0x63616c/smart-blinds/hw/routing/blind-main/README.md

# Historical 196-part main-controller routing

This directory is the **historical 196-part routing checkpoint**, not the current
54 × 80 mm controller. Its source, geometry, manifests and validation results
belong together at [commit ea7bab1566812b4611e3c1e800e67b5ede44651c](https://github.com/0x63616c/smart-blinds/tree/ea7bab1566812b4611e3c1e800e67b5ede44651c).
That commit contains the exact source capture SHA
`2ef8c8d6168420d0de25bb6a4c4b3d778d73c1fd55e97ca068adafe70fbeadd7`
recorded in `route-record.json`. Reproduce its checks from that revision through
the isolated Linux runner. Do not point those checks at the newer 206-part
capture or present the historical findings as current-board validation.

This was a partial four-layer routing study, not a manufacturing release.
The derivative retains the 54 × 68.5 mm outline with its USB tab, all 196
footprints, 609 physical pin identities, 139 net partitions, 17 mechanical/thermal
anchors and 13 RF, connector-foot and clamp reservations.

The checkpoint contains 1013 segments and 255 vias. It routes the local charger
switching/bypass network, motor-driver fly/pump/VM and output paths, regulator
bypass/output/sense paths, and a 3.3 V feed to the radio module. In1 remains a
continuous filled ground-return island; no signal traces use that layer. The
module power feed uses In2 beneath the permitted module body, with vias outside
its solder lands and unchanged antenna keepouts.

Actual KiCad 10 DRC reports **122 unconnected items**. No short, copper/edge/hole
clearance, track-width, courtyard-overlap, keepout, mask-bridge or dangling-route
failure is accepted. The report retains 258 silkscreen/text findings, four
library-footprint differences and five footprint-type findings. The latter
include mixed through-hole/thermal features and incorrectly classified library
attributes; they require footprint/assembly review, not a blanket waiver.
Three unrelated default-disabled DRC categories are listed in `checks.json`.

`checks.py` independently checks actual pad shapes, masks/paste settings, net
partitions, layer/rotation/placement, outline, keepouts, courtyard bounds and
encoder-wire height clearance. It also follows physical copper shapes through
70 required connection groups, including the ground fill. A matching net name
alone cannot pass. Twenty-six earlier injected faults are rejected: moved USB connector, changed motor pad,
weakened RF reservation, cut module supply, removed return plane, cut charger
bypass return, cut PD bypass, cut USB input, removed quiet return via, and an
extra connection from the quiet return to the input-capacitor return, plus open
PD enable, UV divider, raw discharge and address-ground branches. The new controls
also cut the charger input, PMID and SYS bulk branches and input-capacitor return,
and place a same-net solder land over an ordinary open via. All 38 new distribution
vias preserve at least 0.20 mm from their drill edges to top solder lands; native
same-net clearance alone does not check this assembly condition. Both REGN and VBUS bypass
returns have two nearby ground vias, as required by the charger layout guide.
The checks remove the plane from the local graph before counting those vias. The generator is deterministic across repeated local runs.

The USB addition connects both VBUS contacts to the eFuse and its output
reservoir, with local input capacitance and a shunt TVS. It also connects the PD
supply diode and three separate bypass branches, and both CC/protection/dead-battery paths. The two MCU data resistors
have short local stubs; the completed data paths are described below. The eFuse's
current-setting, slew and divider-endpoint components return through an isolated
same-face branch to one ground via. An independent plane-free copper check
requires exactly those five quiet-ground pads and that one via; it rejects the
input-capacitor return joining this branch even though the net names agree.

The PNP enable stage, both voltage dividers, raw/output discharge chains and
PD address/reset/bus resistor branches are now connected. Their explicit
coordinates are replayed from `usb-control-routes.json`; reproduction performs
no route search. Five separate local ground vias serve the address and factory
bus resistors without joining the eFuse quiet-ground branch.

Factory access pads remain open; the USB data pair now reaches the module.
The completed control connections do not establish negotiated startup or
detach/discharge timing; the PD configuration and electrical tests remain
required. The 0.3 mm central-pad escapes and 0.8 mm back-layer power trunks
need current/temperature review; the present geometry is not a current rating.
The input TVS's specified pulse clamp can exceed downstream DC limits; placement
does not resolve that separate transient qualification issue. The eFuse layout
uses a quiet return, but loop impedance and coupling still need review.

The eFuse output now reaches the charger VBUS pins and input capacitors. The four
PMID and five SYS bulk capacitors connect to their existing local fast-bypass
branches through explicit two-via fanouts and In2 distribution traces. Input and
bulk-capacitor grounds join the uninterrupted In1 return. The replay coordinates
in `charger-power-banks.json` and `distribution.py` require no routing search.
The previous 581 copper items are retained. Fifteen previously unwired parts move
to make room, including the encoder supply block; all mechanical anchors remain.
These distributed reservoirs still need ripple-current, return-loop and thermal
review. The 0.6–0.8 mm In2 traces use 15.2 µm copper, so geometric clearance is not
a demonstrated continuous-current rating. Pack feed and onward SYS distribution
remain open.

The next extension connects both VAC inputs, BATP feedback, TS and ILIM networks,
PROG and their local returns. Six previously unwired control parts move; no
mechanical anchor changes. Its explicit paths in `charger-control-routes.json`
are replayed by `charger_controls.py`. A bootstrap via moves 0.25 mm to provide
two adjacent sensing escapes; its two incident traces follow it. The other 696
previous copper items are retained exactly. Seventeen control-area vias
(sixteen added and that relocated via) pass the same 0.20 mm drill-to-solder-land
margin, including same-net lands. Five new deliberate opens and a same-net
control-via intrusion are rejected. These connections need switch-noise,
feedback accuracy, thermal and transient review; full charger control, bus and
charge-permission wiring remain unfinished.

A subsequent assembly-clearance pass moves twelve ordinary vias by at most
0.35 mm and adjusts their sixteen incident traces. Five short top-layer stubs
preserve connections that previously relied on via copper touching a solder
land. No component moves. That earlier stage checked 178 routed vias. The clamp, USB and local supervision stages extend this to all 255 via drills, which remain at least 0.20 mm
from every top solder land, including lands on the same net; the ordinary
KiCad same-net clearance check alone does not ensure this. A deliberate
same-net intrusion at the USB input capacitor is rejected. The explicit
`via-land-clearance.json` changes replay through `via_lands.py`; this is not a
filled/capped via-in-pad process. Thermal holes inside library footprints still
require their separate solder/paste and assembly-process review.

The regenerative clamp now connects its eight-resistor bank, two series power
MOSFETs, detector/divider/feedback, local supply and bypasses, thermostat and latch.
Its 19 local multi-pad nets and eight load-path groups are checked using physical
copper, including every duplicate pad. Three separate plane-free return checks
keep the load, quiet detector and LDO bypass returns distinct before their plane
entries. Eight additional injected faults reject opens and an incorrect shared
return. All 34 old/new fault controls pass. The external `thermal_ok` and `G`
connections to the main inhibit and fault indication remain open.

`regen.py` consumes the preceding pipeline stage and replays finite geometry from
`regen-routes.json`; it does not embed a completed baseline or run a route search.
It replaces twelve exact low-current segments and one redundant NTC via, retains
all other incoming copper, and adds 249 items. Twenty-five previously unwired
clamp components move relative to the preceding published checkpoint. The eight
resistor and all mechanical anchors stay fixed. A now-obsolete NTC via is
explicitly required absent; the other sixteen control-area vias remain checked.

The selected 38.199 mm × 1.2 mm back-layer feed replaces an evaluated
48.804 mm × 0.8 mm detour. Nominal 35 µm-copper estimates at 20 °C are 15.68 mΩ
versus 30.05 mΩ, excluding vias, temperature and process variation. The actual
filled In1 plane contains a complete 1.2 mm swept-width, 39.802 mm return witness;
this is checked by polygon subtraction. It is not an ampacity or current-distribution
result. In1 is only 15.2 µm thick, and the eight 2 W resistor labels do not establish
16 W continuous capability for this compact assembly.

The shorter power loop requires three reviewed signal changes: PROG grows from
17.771 to 28.509 mm on B.Cu; NTC grows from 5.768 to 12.980 mm on B/F; the SW1 bootstrap
return shrinks from 8.087 to 4.175 mm. `regen_analog.py` reports their actual copper
neighbors and proves an intervening filled In1 shield at the NTC's projected
crossings with the B.Cu feed. The closest NTC segment remains only 0.205 mm from
the motor bulk PACK solder land; PROG remains a long startup-sampled branch.
These are explicit noise/layout qualification limits. A bounded 0.2 mm-grid search
for a closer one-part PROG relocation found no accepted closer position while
other parts/copper were fixed; it does not rule out a wider repack.

Comparator overshoot, FET SOA, pulse repetition, thermostat-to-resistor coupling,
printed-case/battery temperature and real motor regeneration remain untested.
An opened thermal cutoff cannot absorb sustained manual back-drive.

The complete placement change list is in `checks.json`. Many support components
have moved from the first placement to make local electrical loops possible.
The critical-loop review remains incomplete: especially charger bootstrap
routing, current/return geometry, switch-node coupling and module supply
impedance. The external 100 nF and bulk radio capacitors are about 18 mm from
the module supply pin; the wide internal feed is a layout candidate, not
proof of adequate local decoupling. Geometric clearance does not establish
electrical performance.

The USB data extension connects both reversible contact pairs through the moved
TPD2E2U06 and the existing module-side 22 Ω resistors. The ESD package moves to
local (22.8, 1.7), 180°; only its three old ground branches/two vias and three CC1
segments are replaced. `usb_data.py` consumes the current clamp output and
replays `usb-data-routes.json`. The base placement remains in `placement.json`;
that data file contains the explicit final ESD override. All other incoming
copper and the circuit graph remain unchanged, including after filling/saving.

Both long front traces have continuous direct In1 reference. A local In2 ground
zone references the short back crossover. The saved fill is checked for overlap
with each signal via, and missing reference is accepted only within D-minus's
own necessary via openings, with the project's 5 µm polygon-arc tolerance plus
0.5 µm audit tolerance. A prior saved merge had stale filled polygons; the
maintained stage now rebuilds and persists them. The neighboring D-plus segment
no longer clips D-minus's antipad. One short ESD pin-4 return reaches one local
via; optional NC pins 1/2 are grounded as TI permits.

The actual track-centerline graph gives approximately 88.235 mm from each A-side
contact to its series resistor and 89.235 mm from each B-side contact. It also
checks that each shortest path passes through its protection pad, and removing
that pad node must disconnect every connector-to-resistor centerline path. D-minus uses
two active through-layer transitions; D-plus uses none. Planar length equality
is **not** electrical-delay equality or a 90 Ω impedance result. One localized
D-plus fold at v23–24.8 replaces the earlier two-fold study and adds about
6.264 mm; the longer perimeter is parallel. The fold temporarily widens the pair
spacing, and the connector-side protection lead remains a layout tradeoff.
These need stackup/return-field/ESD review and actual full-speed USB tests.

Six new fault controls cut a D-plus branch, one D-minus reversible contact,
the ESD return, the back reference, and restore stale ground within a signal
antipad, and add a longer parallel path that bypasses the ESD pad.
All 40 controls through the USB stage pass; the later supervision stage brings the total to 47. The physical USB data connections are
complete; USB performance and manufacturing acceptance remain unfinished.

## Rules and outstanding work

The study retains the preliminary 1.6 mm JLC3313 four-layer descriptor: 35 µm
outer and 15.2 µm inner copper. Comparative minima are 0.15 mm trace/clearance,
0.20 mm copper-to-edge and hole-to-copper, 0.25 mm hole-to-hole, 0.20 mm minimum
hole and 0.10 mm annular ring. Ordinary route vias are 0.6/0.3 mm; selected
fine-pitch escapes use 0.5/0.25 mm. Existing thermal holes require their own
mask/paste/assembly-process review. These rules are not a current rating,
impedance approval, assembly quote or final fabrication profile.

Still unfinished: USB factory access and impedance/ESD qualification, pack feed and onward SYS
current distribution, clamp external inhibit/fault connections and onward supervisor buses, complete signal
routing, thermal and transient review, sparse silkscreen, final ERC/DRC and a
manufacturing quote. No autorouter result substitutes for the local power-layout review.

The [local supervision stage](local-supervision.md) adds 59 checked branches and
seven injected faults to the protected USB checkpoint. All 47 fault controls pass.
It preserves the incoming copper and moves fourteen previously unwired small
parts. The local encoder returns meet at the regulator GND land, checked by
physically cutting that land from the graph. Longer bypass/pull-up paths and the
unfinished ADC connection remain explicit layout limitations.

The [monitored-PD revision](../../../docs/electrical/monitored-pd-revision.md)
removes the obsolete VSYS-ground branch and two factory bus pull-downs from the
maintained stages. It preserves all1268 surviving copper items and all194 common
footprint placements. The two new parts are staged but unrouted; shared SDA/SCL,
ALERT and the new VSYS bypass still need physical routing. All47 existing fault
controls pass against the revised graph. No new feeder SKU is introduced.

## Reproduce

Use KiCad 10 and its distribution Python bindings, from the repository root:

```sh
xvfb-run -a /usr/bin/python3 hw/routing/blind-main/route.py
xvfb-run -a /usr/bin/python3 hw/routing/blind-main/checks.py --negative-tests
```

On macOS use KiCad's bundled Python, without `xvfb-run`. Intermediate files stay
under `work/main-route-build/`. The checked-in project template is used; no
untracked local KiCad project or global rule override is required. Never pass
this routed derivative through the unrouted-only atopile normalizer.

Layout references: [BQ25798, §8.4](https://www.ti.com/lit/ds/symlink/bq25798.pdf),
[DRV8874, §10](https://www.ti.com/lit/ds/symlink/drv8874.pdf),
[TPS62902, §8.5](https://www.ti.com/lit/ds/symlink/tps62902.pdf),
[Espressif layout guidance](https://docs.espressif.com/projects/esp-hardware-design-guidelines/en/latest/esp32c6/pcb-layout-design.html),
[official DevKit layout](https://dl.espressif.com/dl/schematics/esp32-c6-devkitc-1-pcb-layout_v1.2.pdf),
[STUSB4500](https://www.st.com/resource/en/datasheet/stusb4500.pdf),
[TPS25947, §8.4](https://www.ti.com/lit/ds/symlink/tps25947.pdf),
[TLV6710, §11](https://www.ti.com/lit/ds/symlink/tlv6710.pdf),
[TPS709, §10.1](https://www.ti.com/lit/ds/symlink/tps709.pdf),
[TMP302](https://www.ti.com/lit/ds/symlink/tmp302.pdf),
[JLC capabilities](https://jlcpcb.com/capabilities/pcb-capabilities), and
[JLC stackups](https://cart.jlcpcb.com/client/template/placeOrder/impedance.html).
These guide the study; they do not validate the finished board.
