0x63616c/smart-blinds/hw/boards/blind-main/README.md

# Integrated controller study

The main circuit contains **196 footprints and 609 independently checked logical
pin identities**: 194 purchased parts and two bare motor-wire solder landings.
Repeated ground/thermal pads are checked for consistent net identity and counted
once per physical pad number. Eight separately reviewed circuit blocks are preserved.

The current **54 × 68.5 mm**, four-layer placement has an underside USB-C tab,
a keyed protected-pack header, retained motor solder tails, encoder connector,
optional dry-contact input and two side switches. Its black mask is a design
preference; the final assembly service, panel and price remain unquoted.

Independent boundary checks keep protected PACK separate from charger SYS,
raw USB separate from the eFuse output. Powered STUSB4500 now shares the
owned host/gauge/charger bus; its ALERT joins charger INT on GPIO17 with an
explicit 10 kΩ pull-up. Direct VSYS, bus levels, reverse leakage and factory
sequencing remain qualification gates (see the monitored-PD revision note). The reset-gated encoder rail feeds the encoder port.
Home pin 2 is isolated/reserved; only pins 1 (ground) and 3 (contact) are used.
BQ25798 pin 29 is an elongated perimeter PMID lead, not an exposed ground pad.

Normal and frozen circuit builds and twenty-three integration fault tests pass
locally. The previously reviewed footprint families and mechanical anchors remain
authoritative. This revision adds two new parts whose compiled positions are
not final; its physical migration is a separate work candidate. The maintained
partial routed derivative must be explicitly rebased onto this new graph before
its prior placement/routing results apply to the revised circuit.

Manufacturing rules, silkscreen cleanup, power/thermal layout, RF/EMI and prototype
qualification remain unfinished. Passing the circuit checks does not establish
physical function or fabrication readiness.

The [complete native KiCad hierarchy](../../schematics/blind-main/README.md) now
contains eleven sheets. Its independently exported netlist matches all 609 pin
identities and all 139 nets. Nine fault-injection tests pass; seven exact ERC
findings remain documented.

The thermal latch independently gates motor permission and pulls the shared driver
fault line low; firmware cannot distinguish those two faults on that pin alone.
The regenerative clamp remains a conditional pulse design, with sustained
backdrive and actual thermal performance unresolved.

```sh
ato build hw/boards/blind-main -b main-test --frozen -v
python3 hw/boards/blind-main/check_main.py
python3 -m unittest discover -s hw/boards/blind-main -p 'test_*.py' -v
```

[Placement evidence](../../../docs/electrical/main-placement.md) ·
[Motor and signal harness](../../../docs/electrical/motor-signal-harness.md) ·
[Protected-pack connection](../../../docs/electrical/battery-connector.md).
