0x63616c/smart-blinds/bom/mechanical.md

# Mechanical quantities and procurement status

Planning quantities for **eight complete units**, including one spare. Existing stock must be counted before buying. No price quote or purchase is authorized by this file.

| Item | Per unit | For 8 | Status |
|---|---:|---:|---|
| Recfountik JGB37-520 12 V 111 RPM encoder motor | 1 | 8 | Six were recorded as purchased in September; count current stock and confirm exact geometry |
| Samsung INR21700-50E cells | 6 | 48 | Owned model; quantity, matching and condition to verify |
| Protected PCB holder cassette, 3S2P | 1 | 8 | Single-sided carrier is provisional reference; holder current/retention qualification pending |
| MYOUNG BH-21700-A5BJ001 TH holder (candidate) | 6 | 48 | Actual drawing recovered; no motor-current rating established |
| Independent 6 mm output shaft | 1 | 8 | Length/material/retention to specify |
| 6 × 19 × 6 mm bearing envelope | 2 | 16 | 626-class dimensions only; exact bearing selection pending |
| 6-to-6 mm shaft coupler envelope | 1 | 8 | 25 mm long, 20 mm diameter allocation; exact part/torque rating pending |
| White printed backplate | 1 | 8 | Provisional CAD; wall mounting test required |
| White printed cover | 1 | 8 | Provisional CAD; fit/heat/creep test required |
| Printed pack cradle | 1 | 8 | Provisional CAD; retention and service path open |
| Printed motor saddles | 2 | 16 | Provisional; upper retention and torque reaction open |
| Printed chain wheel | 1 | 8 | Fit/wear and shaft retention open |
| Printed chain guard | 1 | 8 | Support, chain path and installation qualification open |
| Printed PCB carrier | 1 | 8 | Board holes and attachment open |
| Printed button plungers | 2 | 16 | Switch travel and retention open |
| Cover screw and captive nut, M3 candidate | 1 set | 8 sets | Screw length and nut tolerances to verify with print |
| Wall screws and anchors | 3 sets | 24 sets | Select for actual wall material and proof load |
| Pack retention straps / insulation / terminal rings | TBD | TBD | Specify with pack construction, not from the rendering |
| Internal fasteners and motor retention | TBD | TBD | Choose one common size where practical after fit study |
| Motor/encoder and pack harnesses, contacts and housings | 1 set each | 8 each | Electrical connector family/current rating and wire bends open |
| USB-C cable and compatible power source | As needed | User dependent | Electrical charging design determines required PD profile |

The current [holder and supported-drive study](../docs/mechanical/2026-10-19-holder-and-drive-trade-study.md) supersedes the original welded direct-drive assumption. The printed rows above identify necessary part families; their original compact fit meshes are not the new retained assembly. The single-sided holder reference uses a separate protection carrier and small controller. Twin carriers add another PCB, insulating barrier, fixed raw-rail interconnect and cassette fasteners. The belt option substitutes two pulleys and a belt/tensioner for the coupler. Do not combine optional transmission parts into one required bill.
