0x63616c/smart-blinds/docs/electrical/main-placement.md

# Main controller placement

Updated 2026-10-20. Preliminary source-generated placement; no routed copper or
manufacturing acceptance. The board is 54 × 68.5 mm, with a small USB-C extension.
The coordinated enclosure study remains 115 × 174 × 71 mm.

The explicit placement source is `hw/placement/blind-main/placement.json`.
Mechanical anchors and clamp lands are in `cad/parameters/retained-interfaces.json`.
Local u/v maps to KiCad x = 100 + u and y = 175 − v, in millimetres.
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
