0x63616c/smart-blinds/docs/reviews/2026-10-21-clean-layout/v5-bottom.png

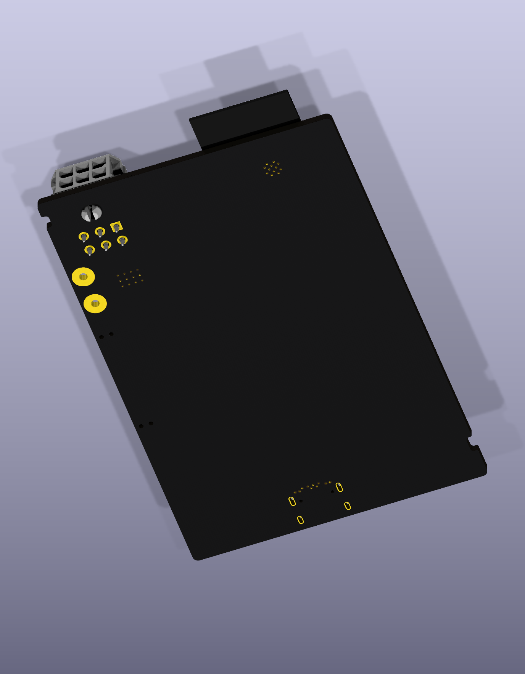
docs/reviews/2026-10-21-clean-layout/v5-bottom.png
