0x63616c/smart-blinds/docs/reviews/2026-10-21-clean-layout/v8-inner-data-detail.png

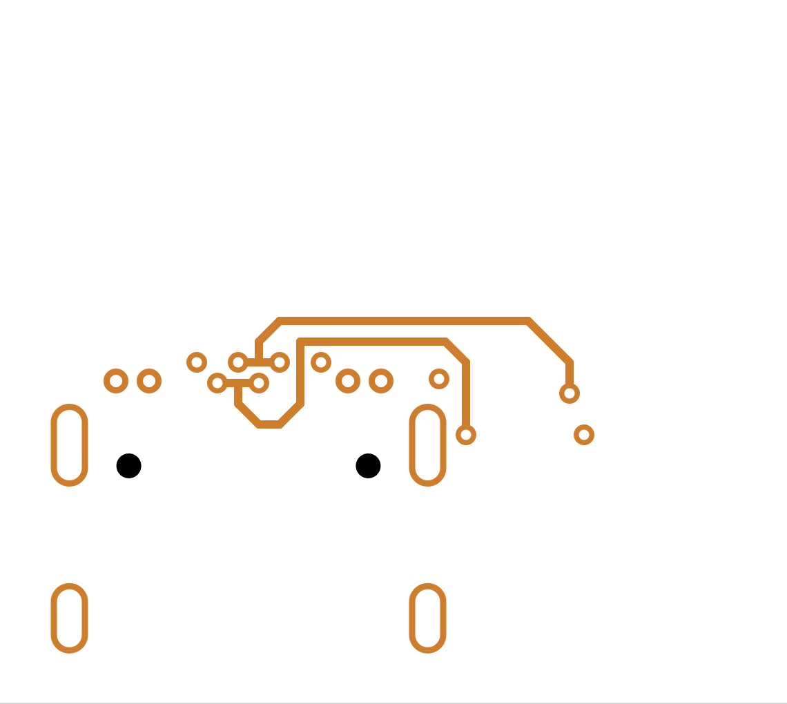
docs/reviews/2026-10-21-clean-layout/v8-inner-data-detail.png
