0x63616c/smart-blinds/docs/reviews/2026-10-21-clean-layout/v10-top-copper-detail.png

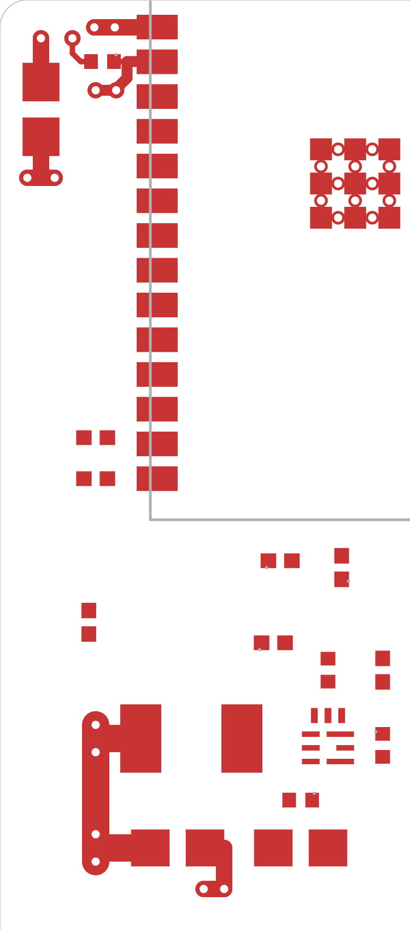
docs/reviews/2026-10-21-clean-layout/v10-top-copper-detail.png
