0x63616c/smart-blinds/docs/reviews/2026-10-21-clean-layout/v12-regulator-bottom.png

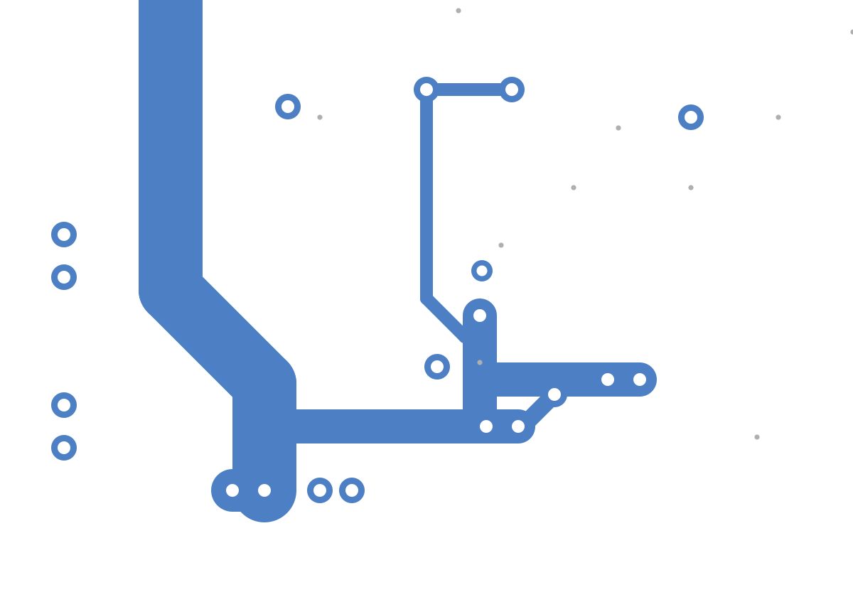
docs/reviews/2026-10-21-clean-layout/v12-regulator-bottom.png
