0x63616c/smart-blinds/docs/reviews/2026-10-21-clean-layout/v12-regulator-inner.png

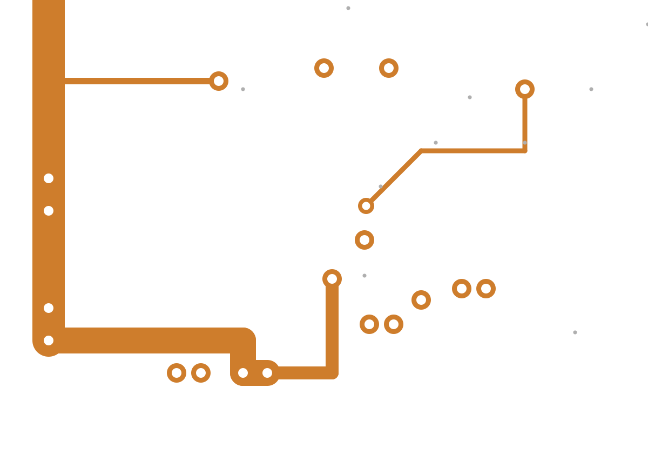
docs/reviews/2026-10-21-clean-layout/v12-regulator-inner.png
