0x63616c/smart-blinds/hw/sim/buck_pd12v6mini.png

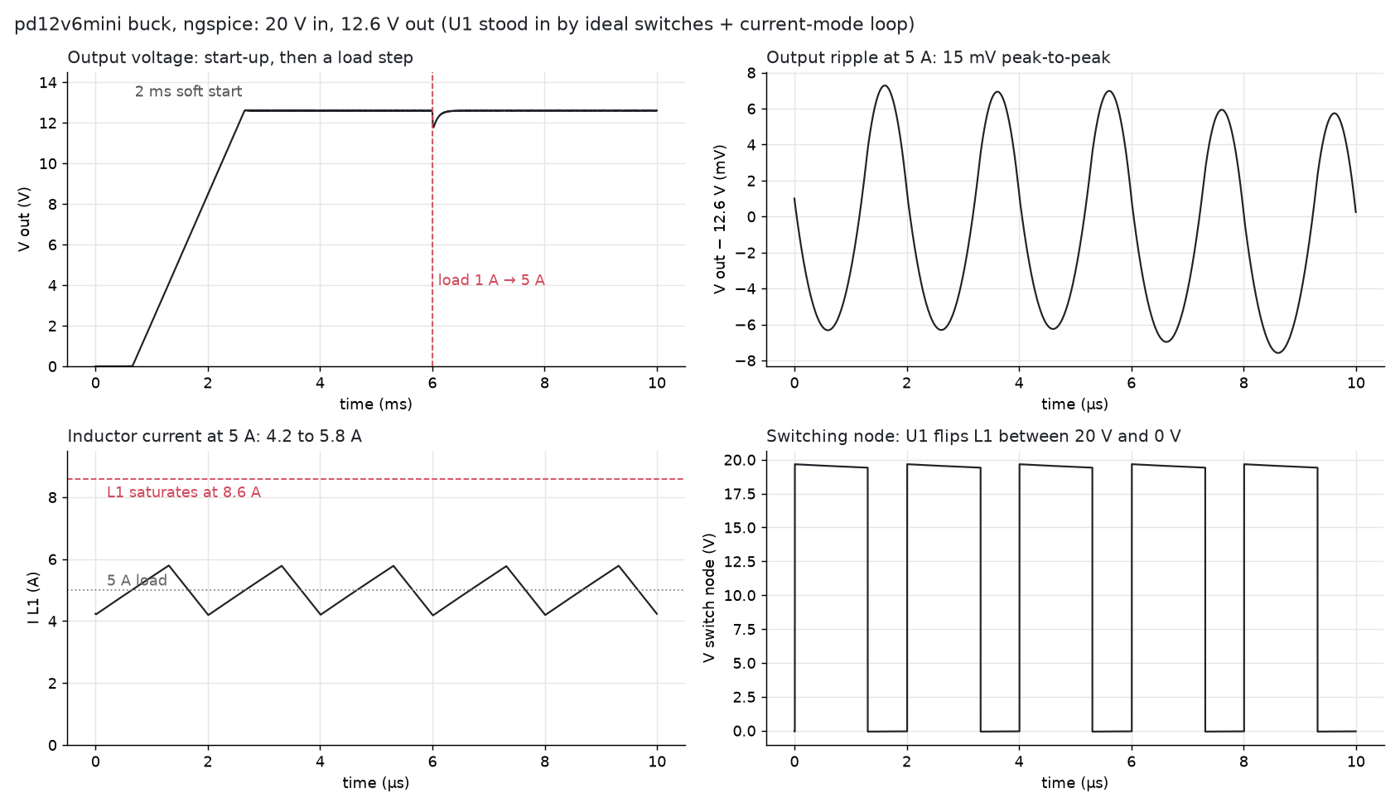
hw/sim/buck_pd12v6mini.png
