0x63616c/smart-blinds/docs/mechanical/material-and-retention.md

# Material, load paths and the next retained assembly

The initial print-material candidate is **white PETG with a manufacturer technical datasheet**, such as Prusament PETG Signal White. This is a prototype choice, not a claim that any white filament is suitable. The [Prusament PETG datasheet](https://prusament.com/wp-content/uploads/2022/10/PETG_Prusament_TDS_2021_10_EN.pdf) reports 68 °C heat deflection temperature under its stated ISO75 loads and notes that print orientation/settings change results. HDT is not a continuous-use temperature or a creep rating.

Use **45 °C maximum measured temperature at structural printed parts as an initial engineering acceptance target**, with a 50 °C stop/review threshold during prototype testing. These are deliberately conservative project targets below the reported HDT, not manufacturer operating ratings. Measure the window-facing case, battery supports, charger region and motor bracket during charging, repeated movement, stalled-current limiting and sun-heated installation conditions. The electrical charge-temperature limit can be stricter and controls the charger independently. Revise material or thermal design if the location cannot meet the target. White PLA is not the default for a sun-facing loaded bracket. PETG is not a certified fire enclosure.

The wall backplate carries the battery, drive and wall-fastener loads. The cosmetic front cover carries only its own weight and button actuation. Use mechanically retained nuts/bolts and washers for load-bearing parts; heat-set inserts may help assembly but need pull-out/creep qualification. Do not ask cosmetic snap clips or solder pads to retain cell mass or motor torque.

The next detailed CAD pass must implement the following interfaces:

| Interface | Required construction | Verification |
|---|---|---|
| Wall | Three separated screw positions in reinforced backplate; anchor type follows actual wall construction | Pull/shear test with installed anchor and load, not a guessed universal screw |
| Battery carrier | Screws/standoffs at board edges plus an insulating backing plate; holder screws where supported by drawing; smooth insulating retention bars/straps | No PCB bending during cell insertion; wraps cannot rub screw ends; removal cannot short contacts |
| Twin carrier | Rigid screwed cassette; two boards never rely on raw-rail solder joints as spacers | Untrimmed 4.5 mm maximum tails need a 12 mm gap; controlled 1.5 mm protrusion permits a 5 mm gap. Both include a 1 mm barrier; inspect all raw rails before closing |
| Motor | Replaceable split clamps/shims with captive nuts, adjustable slots and explicit torque-reaction path | Clock eccentric output into depth direction; preserve rear cable bend; proof-load against slip |
| Output shaft | Independent shaft with two bearing blocks, or compact motor shaft with one outboard bearing; both attach to the load-bearing backplate | The compact variant still loads the gearbox. Qualify actual radial load, alignment, axial retention, fit, jam and wear; do not assume the extra bearing unloads the motor completely |
| Chain | Removable screwed guard and controlled entry/exit clearance; avoid trapping a coupler | Actual chain wrap and separation, slip/jam and enclosure-access tests |
| Controller | Screwed carrier or mounting holes and connectors accessible without pulling cell wires | Connector insertion/removal, USB plug body clearance, antenna separation |
| Controls | Vertically arranged up/down plungers with captive flanges and guides | No preloading switches; tolerance/temperature and repeated actuation tests |
| Cover | Screwed lower retention with captured upper locating features | Cover cannot become the primary motor/battery support |

For first coupons, use a calibrated 0.4 mm nozzle and 0.2 mm layer height as a starting assumption. Load-bearing brackets should use at least five walls with local solid material around fasteners; final slicer settings must follow actual geometry and printer. No strength rating is inferred from wall count. Retention parts should be oriented so critical loads are mostly within layers, then tested at the temperature target. The drive wheel should be a separate replaceable wear item, not printed into the case.

A low-power sensor can be mounted beside a straight chain strand, but an added magnet/collar may not pass the bead pockets. A wheel or chain-loop index repeats and cannot by itself establish absolute fabric height. Keep a sensor/header provision and supervised position recovery until a real reference strategy is selected with firmware.

The v2 comparison models remain occupied-volume studies. The later [independent drive cartridge](retained-drive-prototype.md) and [compact shared-shaft candidate](2026-10-19-compact-drive-and-holder-study.md) add replaceable clamps, bearing retainers and screwed chain guards. The compact [front-button interface](front-button-interface.md) adds guides, captive plungers and a removable rear guide bar. The cassette, controller mounting, wall/cover retention and final wiring still need full retained design work. Passing named intersection or mesh checks does not turn these fit prototypes into production parts.

The subsequent [retained enclosure candidate](retained-compact-enclosure.md) adds actual
wall/cover fasteners, an independently screwed cassette with a separate insulating
sheet, and a removable controller edge frame. This implements the previously missing
retention geometry for the trimmed-pin case; actual routed-board placement, final
connectors/strain relief, material qualification and physical assembly tests remain
open. The earlier allocation studies are preserved as comparisons.

The later [paired-loading candidate](paired-loading.md) uses integrated backing
at the previously reserved inward PCB lands and a separate tray-bearing workshop
fixture. Its temporary spacer catches only assist controlled assembly; they are
not the installed cell restraint or an electrical-safety closure. The one-piece
spacer needs support/slicer review, and its 1 mm temporary arms and 1.2 mm local
shell walls require actual fit, repeated-release and creep testing. The workshop
clamps use captive broad pressure pads; neither their screw stop nor their
geometric capture establishes a permissible tightening force. Protected-pigtail
handling restraint and the practical catch-release method remain design work.
