0x63616c/smart-blinds/docs/research/purchased-motor.md

# Purchased motor evidence

Owner confirmed [Amazon ASIN B0H4Y1BQ8Y](https://www.amazon.com/dp/B0H4Y1BQ8Y)
on 2026-10-19. The selected listing is Recfountik JGB37-520, 12 V, 111 RPM, with
an encoder. This resolves the product identity; it does not establish the delivered unit's tolerances.

The [seller's dimension image](https://m.media-amazon.com/images/I/51YhbGO+v1L._AC_SL1001_.jpg)
shows a 33 mm motor can diameter, 22 mm can-body length, 6 mm axial front boss,
15.5 mm exposed shaft length, and a 6 mm shaft with a 5.4 mm D-flat dimension.
The gearbox length is labelled only **L**. The image omits a dimensioned mounting pattern,
gearbox diameter, shaft offset, full encoder/connector envelope and manufacturing tolerances.
These are seller drawing values, not owner measurements. The product text gives a 162 g
weight and a generic size description; neither supplies the missing fit dimensions.

Other inspected listing photographs show an offset output shaft, front mounting holes,
rear encoder board and six-wire cable. They do not define encoder supply voltage, logic
levels, wire functions, resolution, motor stall current or allowable output-bearing loads.
Do not infer a pinout from wire colours or scale mounting dimensions from photographs.

The owner cannot measure the motors for several weeks. Continue with documented family
envelopes and stated allowances. Use replaceable motor brackets and shaft adapters, and
reserve connector/cable access so a fit correction does not require redesigning the controller.
Purchased-part fit and electrical characterization remain prototype gates.
