0x63616c/smart-blinds/bom/captured-components.csv

LCSC | MPN | Main qty | Primary pack qty | Companion pack qty | 2 units qty | 2 units USD | 8 units qty | 8 units USD | Catalog URL
C11702 | 0402WGF1001TCE | 6 | 2 | 0 | 16 | 0.0208 | 64 | 0.0832 | https://jlcpcb.com/partdetail/0402WGF1001TCE/C11702
C127367 | 430450600 | 1 | 0 | 0 | 2 | 1.1112 | 8 | 4.4448 | https://jlcpcb.com/partdetail/430450600/C127367
C12881 | CL31A475KBHNNNE | 3 | 0 | 0 | 6 | 0.6072 | 24 | 2.4288 | https://jlcpcb.com/partdetail/CL31A475KBHNNNE/C12881
C13585 | CL31A106KBHNNNE | 15 | 0 | 0 | 30 | 7.6680 | 120 | 24.3360 | https://jlcpcb.com/partdetail/CL31A106KBHNNNE/C13585
C13967 | CL21B474KBFNNNE | 0 | 3 | 0 | 6 | 0.1218 | 24 | 0.4872 | https://jlcpcb.com/partdetail/CL21B474KBFNNNE/C13967
C13982 | 0451003.MRL | 0 | 3 | 3 | 12 | 3.0792 | 48 | 12.3168 | https://jlcpcb.com/partdetail/0451003.MRL/C13982
C145179 | RB521S30T1G | 1 | 0 | 0 | 2 | 0.1278 | 8 | 0.5112 | https://jlcpcb.com/partdetail/RB521S30T1G/C145179
C1523 | 0402B102K500NT | 2 | 0 | 0 | 4 | 0.0152 | 16 | 0.0608 | https://jlcpcb.com/partdetail/0402B102K500NT/C1523
C1532 | 0402B223K500NT | 1 | 0 | 0 | 2 | 0.0098 | 8 | 0.0392 | https://jlcpcb.com/partdetail/0402B223K500NT/C1532
C15849 | CL10A105KB8NNNC | 5 | 0 | 0 | 10 | 0.1530 | 40 | 0.6120 | https://jlcpcb.com/partdetail/CL10A105KB8NNNC/C15849
C165948 | TYPE-C-31-M-12 | 1 | 0 | 0 | 2 | 0.3734 | 8 | 1.4936 | https://jlcpcb.com/partdetail/TYPE-C-31-M-12/C165948
C1779 | CL21A475KAQNNNE | 2 | 0 | 0 | 4 | 0.1536 | 16 | 0.6144 | https://jlcpcb.com/partdetail/CL21A475KAQNNNE/C1779
C17901 | 1206W4F1000T5E | 0 | 3 | 0 | 6 | 0.0354 | 24 | 0.1416 | https://jlcpcb.com/partdetail/1206W4F1000T5E/C17901
C1855818 | DRV8874PWPR | 1 | 0 | 0 | 2 | 2.0248 | 8 | 8.0992 | https://jlcpcb.com/partdetail/DRV8874PWPR/C1855818
C1972959 | TPD2E2U06DRLR | 3 | 0 | 0 | 6 | 1.9428 | 24 | 7.7712 | https://jlcpcb.com/partdetail/TPD2E2U06DRLR/C1972959
C1974707 | ESDA25P35-1U1M | 1 | 0 | 0 | 2 | 0.3832 | 8 | 1.5328 | https://jlcpcb.com/partdetail/ESDA25P35-1U1M/C1974707
C20606809 | BH-21700-A5BJ001 | 0 | 3 | 3 | 12 | 16.4784 | 48 | 58.7808 | https://jlcpcb.com/partdetail/BH-21700-A5BJ001/C20606809
C20917 | AO3400A | 4 | 0 | 0 | 8 | 0.7776 | 32 | 3.1104 | https://jlcpcb.com/partdetail/AO3400A/C20917
C2116 | BZT52C4V7 | 0 | 3 | 0 | 6 | 0.12 | 24 | 0.48 | https://jlcpcb.com/partdetail/BZT52C4V7/C2116
C21190 | 0603WAF1001T5E | 6 | 0 | 0 | 12 | 0.036 | 48 | 0.144 | https://jlcpcb.com/partdetail/0603WAF1001T5E/C21190
C25076 | 0402WGF1000TCE | 1 | 2 | 0 | 6 | 0.0072 | 24 | 0.0288 | https://jlcpcb.com/partdetail/0402WGF1000TCE/C25076
C25077 | 0402WGF100JTCE | 0 | 1 | 0 | 2 | 0.0026 | 8 | 0.0104 | https://jlcpcb.com/partdetail/0402WGF100JTCE/C25077
C25082 | 0402WGF1500TCE | 0 | 3 | 0 | 6 | 0.0102 | 24 | 0.0408 | https://jlcpcb.com/partdetail/0402WGF1500TCE/C25082
C25092 | 0402WGF220JTCE | 2 | 0 | 0 | 4 | 0.0056 | 16 | 0.0224 | https://jlcpcb.com/partdetail/0402WGF220JTCE/C25092
C25741 | 0402WGF1003TCE | 17 | 0 | 0 | 34 | 0.0510 | 136 | 0.2040 | https://jlcpcb.com/partdetail/0402WGF1003TCE/C25741
C25744 | 0402WGF1002TCE | 36 | 1 | 0 | 74 | 0.1110 | 296 | 0.4440 | https://jlcpcb.com/partdetail/0402WGF1002TCE/C25744
C25778 | 0402WGF3303TCE | 1 | 0 | 0 | 2 | 0.0058 | 8 | 0.0232 | https://jlcpcb.com/partdetail/0402WGF3303TCE/C25778
C25779 | 0402WGF3302TCE | 1 | 0 | 0 | 2 | 0.0116 | 8 | 0.0464 | https://jlcpcb.com/partdetail/0402WGF3302TCE/C25779
C25782 | 0402WGF3903TCE | 3 | 0 | 0 | 6 | 0.0066 | 24 | 0.0264 | https://jlcpcb.com/partdetail/0402WGF3903TCE/C25782
C25785 | 0402WGF4023TCE | 1 | 0 | 0 | 2 | 0.0048 | 8 | 0.0192 | https://jlcpcb.com/partdetail/0402WGF4023TCE/C25785
C25862 | 0402WGF1201TCE | 2 | 0 | 0 | 4 | 0.0048 | 16 | 0.0192 | https://jlcpcb.com/partdetail/0402WGF1201TCE/C25862
C25869 | 0402WGF1651TCE | 1 | 0 | 0 | 2 | 0.0024 | 8 | 0.0096 | https://jlcpcb.com/partdetail/0402WGF1651TCE/C25869
C25875 | 0402WGF2612TCE | 2 | 0 | 0 | 4 | 0.008 | 16 | 0.032 | https://jlcpcb.com/partdetail/0402WGF2612TCE/C25875
C25900 | 0402WGF4701TCE | 3 | 0 | 0 | 6 | 0.0126 | 24 | 0.0504 | https://jlcpcb.com/partdetail/0402WGF4701TCE/C25900
C25907 | 0402WGF5231TCE | 1 | 0 | 0 | 2 | 0.0070 | 8 | 0.0280 | https://jlcpcb.com/partdetail/0402WGF5231TCE/C25907
C2649846 | TVS1800DRVR | 1 | 0 | 0 | 2 | 0.804 | 8 | 3.216 | https://jlcpcb.com/partdetail/TVS1800DRVR/C2649846
C2678061 | STUSB4500QTR | 1 | 0 | 0 | 2 | 5.6408 | 8 | 22.5632 | https://jlcpcb.com/partdetail/STUSB4500QTR/C2678061
C2682139 | SN74AUP1G97DCKR | 3 | 0 | 0 | 6 | 1.3230 | 24 | 5.2920 | https://jlcpcb.com/partdetail/SN74AUP1G97DCKR/C2682139
C274888 | RC0402FR-0713K7L | 1 | 0 | 0 | 2 | 0.0028 | 8 | 0.0112 | https://jlcpcb.com/partdetail/RC0402FR-0713K7L/C274888
C2863066 | TLV6710DDCR | 1 | 0 | 0 | 2 | 4.7192 | 8 | 18.8768 | https://jlcpcb.com/partdetail/TLV6710DDCR/C2863066
C2870154 | TPS62902RPJR | 1 | 0 | 0 | 2 | 2.4558 | 8 | 9.8232 | https://jlcpcb.com/partdetail/TPS62902RPJR/C2870154
C2870545 | TPS3430WDRCR | 1 | 0 | 0 | 2 | 3.1864 | 8 | 12.7456 | https://jlcpcb.com/partdetail/TPS3430WDRCR/C2870545
C2876593 | BQ25798RQMR | 1 | 0 | 0 | 2 | 5.6756 | 8 | 22.7024 | https://jlcpcb.com/partdetail/BQ25798RQMR/C2876593
C2877557 | TMP302ADRLR | 1 | 0 | 0 | 2 | 0.3796 | 8 | 1.5184 | https://jlcpcb.com/partdetail/TMP302ADRLR/C2877557
C2914309 | MAX17320G22+ | 0 | 1 | 0 | 2 | 11.6808 | 8 | 46.7232 | https://jlcpcb.com/partdetail/MAX17320G22+/C2914309
C2935152 | ESDA25W | 1 | 0 | 0 | 2 | 0.2896 | 8 | 1.1584 | https://jlcpcb.com/partdetail/ESDA25W/C2935152
C293630 | 532610371 | 1 | 0 | 0 | 2 | 0.2952 | 8 | 1.1808 | https://jlcpcb.com/partdetail/532610371/C293630
C29402 | 0402WGF3012TCE | 2 | 0 | 0 | 4 | 0.0060 | 16 | 0.0240 | https://jlcpcb.com/partdetail/0402WGF3012TCE/C29402
C307331 | CL05B104KB54PNC | 25 | 5 | 0 | 60 | 0.5700 | 240 | 2.2800 | https://jlcpcb.com/partdetail/CL05B104KB54PNC/C307331
C307442 | CL05C121JB5NNNC | 1 | 0 | 0 | 2 | 0.0282 | 8 | 0.1128 | https://jlcpcb.com/partdetail/CL05C121JB5NNNC/C307442
C340768 | UCM1E221MCL1GS | 1 | 0 | 0 | 2 | 0.510 | 8 | 2.040 | https://jlcpcb.com/partdetail/UCM1E221MCL1GS/C340768
C3662793 | TPS259470LRPWR | 1 | 0 | 0 | 2 | 2.8236 | 8 | 11.2944 | https://jlcpcb.com/partdetail/TPS259470LRPWR/C3662793
C408332 | MWSA0402S-1R0MT | 1 | 0 | 0 | 2 | 0.3070 | 8 | 1.2280 | https://jlcpcb.com/partdetail/MWSA0402S-1R0MT/C408332
C4142 | 0402WGF8202TCE | 1 | 0 | 0 | 2 | 0.0034 | 8 | 0.0136 | https://jlcpcb.com/partdetail/0402WGF8202TCE/C4142
C43698 | TPS3808G33DBVR | 1 | 0 | 0 | 2 | 0.7936 | 8 | 3.1744 | https://jlcpcb.com/partdetail/TPS3808G33DBVR/C43698
C50714 | SN74LVC2G17DCKR | 2 | 0 | 0 | 4 | 0.7312 | 16 | 2.9248 | https://jlcpcb.com/partdetail/SN74LVC2G17DCKR/C50714
C5189746 | CYA0630-2.2UH | 1 | 0 | 0 | 2 | 0.3430 | 8 | 1.3720 | https://jlcpcb.com/partdetail/CYA0630-2.2UH/C5189746
C53444 | MMBT3906LT1G | 4 | 0 | 0 | 8 | 0.152 | 32 | 0.608 | https://jlcpcb.com/partdetail/MMBT3906LT1G/C53444
C544399 | TPS26600PWPR | 1 | 0 | 0 | 2 | 3.0884 | 8 | 12.3536 | https://jlcpcb.com/partdetail/TPS26600PWPR/C544399
C602037 | CL21A226MAYNNNE | 3 | 0 | 0 | 6 | 0.9396 | 24 | 3.7584 | https://jlcpcb.com/partdetail/CL21A226MAYNNNE/C602037
C6034714 | ESP32-C6-WROOM-1-N4 | 1 | 0 | 0 | 2 | 7.870 | 8 | 31.480 | https://jlcpcb.com/partdetail/ESP32-C6-WROOM-1-N4/C6034714
C696092 | 532610471 | 1 | 0 | 0 | 2 | 0.2994 | 8 | 1.1976 | https://jlcpcb.com/partdetail/532610471/C696092
C720493 | TS-1081S-AC01326 | 2 | 0 | 0 | 4 | 0.6596 | 16 | 2.6384 | https://jlcpcb.com/partdetail/TS-1081S-AC01326/C720493
C7250 | 0603WAF1005T5E | 2 | 0 | 0 | 4 | 0.0128 | 16 | 0.0512 | https://jlcpcb.com/partdetail/0603WAF1005T5E/C7250
C82219 | 0402B473K500NT | 5 | 0 | 0 | 10 | 0.0590 | 40 | 0.2360 | https://jlcpcb.com/partdetail/0402B473K500NT/C82219
C840605 | CRM2512-FX-10R0ELF | 8 | 0 | 0 | 16 | 4.0928 | 64 | 12.6912 | https://jlcpcb.com/partdetail/CRM2512-FX-10R0ELF/C840605
C844901 | WSL2512R0100FEA | 0 | 1 | 0 | 2 | 0.7242 | 8 | 2.8968 | https://jlcpcb.com/partdetail/WSL2512R0100FEA/C844901
C852714 | RT0402BRD0730K1L | 1 | 0 | 0 | 2 | 0.0662 | 8 | 0.2648 | https://jlcpcb.com/partdetail/RT0402BRD0730K1L/C852714
C85734 | AON7400A | 2 | 2 | 0 | 8 | 1.4296 | 32 | 5.7184 | https://jlcpcb.com/partdetail/AON7400A/C85734
C89347 | TPS70933DBVR | 1 | 0 | 0 | 2 | 0.6762 | 8 | 2.7048 | https://jlcpcb.com/partdetail/TPS70933DBVR/C89347
C96028 | TPS70950DBVR | 1 | 0 | 0 | 2 | 1.144 | 8 | 4.576 | https://jlcpcb.com/partdetail/TPS70950DBVR/C96028
