0x63616c/smart-blinds/bom/mechanical-print-volume.csv

family | part | per_unit | for_eight | single_model_cm3 | unit_model_cm3 | unit_solid_petg_g | stl_sha256
compact-direct | rear_lower | 1 | 8 | 3.755 | 3.755 | 4.77 | 536ddd01d08afe544b1f5527f2b8436404acbf3e1426d8ecc1652c8c047f7f62
compact-direct | rear_upper | 1 | 8 | 2.724 | 2.724 | 3.46 | 0fd88f320cc43d79364062366bcc20b01329e43b0dfcd73f13b717e24ca56dbc
compact-direct | front_lower | 1 | 8 | 3.493 | 3.493 | 4.44 | b9c2fed01bbeda74581efe1ad2d8f4fa1268c4eb57868397077ccb485b827e31
compact-direct | front_upper | 1 | 8 | 2.972 | 2.972 | 3.77 | 42b22c2f2efb6bd1602d411cc135d10b00a305ad573c78e4c0faf4b1bb156222
compact-direct | bearing_block | 1 | 8 | 4.869 | 4.869 | 6.18 | 81702139ac5bd64744c107affb3812e743967697fd8d831294ef8129ee54cb25
compact-direct | retainer | 1 | 8 | 0.731 | 0.731 | 0.93 | 4fe4ff85d781473fea0c416190b46b3bafd81a3c0d25c8e1ebcda593068e8700
compact-direct | wheel | 1 | 8 | 3.534 | 3.534 | 4.49 | 973cd23eb02e46131fa965800fa5ce0612673298f2d98cc915a25e71db4caca6
compact-direct | guard | 1 | 8 | 1.35 | 1.35 | 1.71 | cdf76b25aa7b626ec38a2a7ec5b7322010d8ce898bf165d12a5667f97d7801cc
retained-compact | backplate | 1 | 8 | 86.003 | 86.003 | 109.22 | b5e76ead9967fa66fe09d49d098445639354b385bceb764b122d4dd07e3917b2
retained-compact | cover | 1 | 8 | 132.735 | 132.735 | 168.57 | 4430b5741bc8ff28c30c10374492e4378f78a88197b6701a0179372983178c31
retained-compact | cassette_rear | 1 | 8 | 32.319 | 32.319 | 41.05 | 022f01bd977058b9b7cffb78e02a491de2d5640b8801e46ebece924e14fb68b5
retained-compact | cassette_front | 1 | 8 | 37.223 | 37.223 | 47.27 | 0813797e415b709c2e5e29b1172e67b2d27a3426b77a0a0fccabfa9a1e2c3e02
retained-compact | cassette_spacer | 1 | 8 | 11.571 | 11.571 | 14.7 | 0582c0686157c787d1a7f813bef57146d2252e4a7947c8c4d51b74187ec482dc
retained-compact | controller_frame | 1 | 8 | 1.745 | 1.745 | 2.22 | d6cac248fc8b46663e2b4609f30d0be122fa6898494d0bd93d6bffd62b601045
retained-compact | controller_clip | 2 | 16 | 0.108 | 0.216 | 0.27 | 476e552fb889017e94062b8f458c649265a16480122e95fc67722beb8985accb
retained-compact | button_plunger | 2 | 16 | 0.132 | 0.264 | 0.34 | 41b0a26b1ebf779eba48e2a8ccf0f26fdfb90fdf32d2a59c0625aaa948589984
retained-compact | button_face | 2 | 16 | 0.087 | 0.174 | 0.22 | 45d15184c7ab35816785f20561a6abc32e0d22efafb033bcae5c25dde7cdb7ec
retained-compact | button_guide | 1 | 8 | 0.757 | 0.757 | 0.96 | 85e2e6add012cc106972e79486e630226dddf6b7cf77e68ab1f25dc416f620ab
