0x63616c/smart-blinds/bom/mechanical-workshop-volume.csv

part | per_fixture | for_eight_unit_build | model_volume_cm3 | solid_petg_g | stl_sha256
base | 1 | 1 | 96.569 | 122.64 | 8018199a140ed3a15f601f6b93dfd1d812a6f53d9a605d09fc0f90fd8f5136d0
lower_comb | 1 | 1 | 3.043 | 3.86 | 75d1c5b373682e7c9290610c691bb87cea5ffc4f8a746883cf9c18d5aa2416a2
upper_comb | 1 | 1 | 3.345 | 4.25 | d99c33d4f61b210ff6228cb54990caef00aa5581cc7b051afd0bafc4080f3129
lower_clamp | 1 | 1 | 2.228 | 2.83 | 158e83f4fb3226ed474c2b6076f00715e34eb4a6f5d05ec5ca4233935b9fdb21
upper_clamp | 1 | 1 | 3.398 | 4.32 | 20ee71ce5080bd0641ef01f6c0fb925f2d2392b5ba9955c5cba35bb198688a86
cradle | 1 | 1 | 69.725 | 88.55 | ad3ab8fe43f71ec1b0e02c39aa54a288dfb95c7ffd56d3510538f04ae040a0b6
lower_pad | 1 | 1 | 0.399 | 0.51 | a25ee00bd9165f394cbba7817531bca1e95bb883d035daf2de72408ced1a30c8
upper_pad | 1 | 1 | 0.399 | 0.51 | 18fd18acb0a74573b72cb53adb249364c841bad63ca8a36fd58d7e8ce72566ae
