0x63616c/smart-blinds/hw/parts/HCTL_PZ254_1_03_Z_8_5/HDR-TH_03P-P2.54-V-M.step

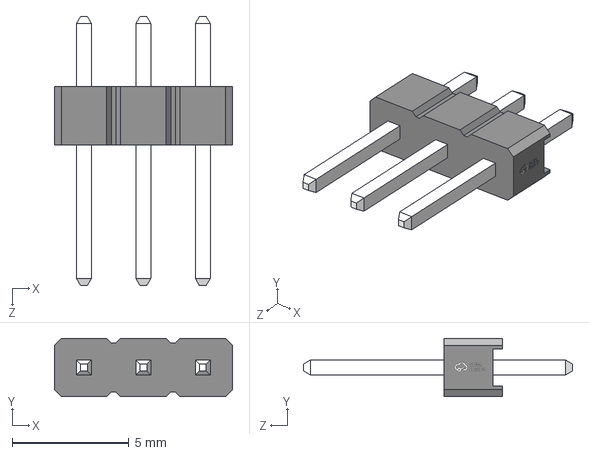
[picture p44: CAD file, 2026-10-09]
hw/parts/HCTL_PZ254_1_03_Z_8_5/HDR-TH_03P-P2.54-V-M.step
7.63 x 2.50 x 11.5 mm
