0x63616c/smart-blinds/hw/parts/UNKNOWN_NCD0603G1/LED0603-RD_1.STEP

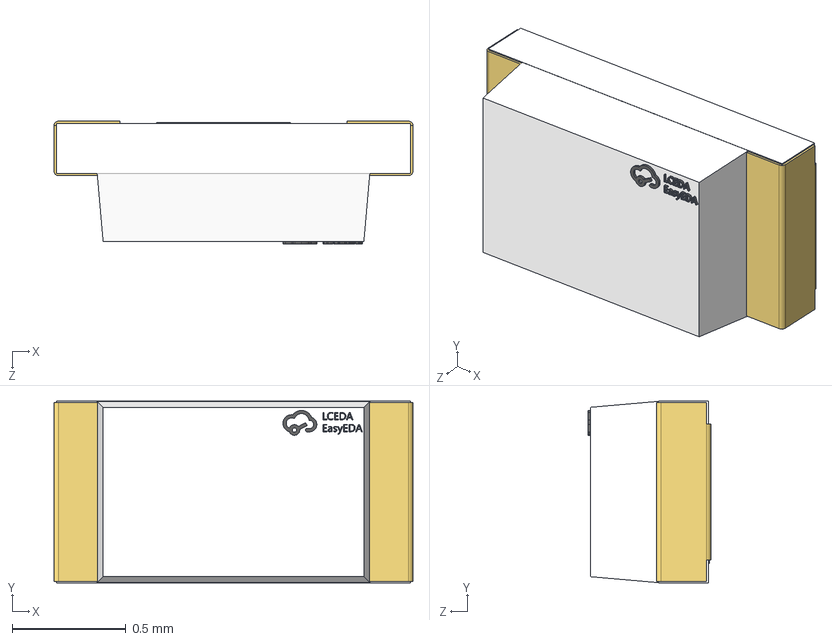
[picture p45: CAD file, 2026-10-09]
hw/parts/UNKNOWN_NCD0603G1/LED0603-RD_1.STEP
1.58 x 0.8 x 0.54 mm
