0x63616c/smart-blinds/hw/parts/MOLEX_0430450400/430450400.STEP

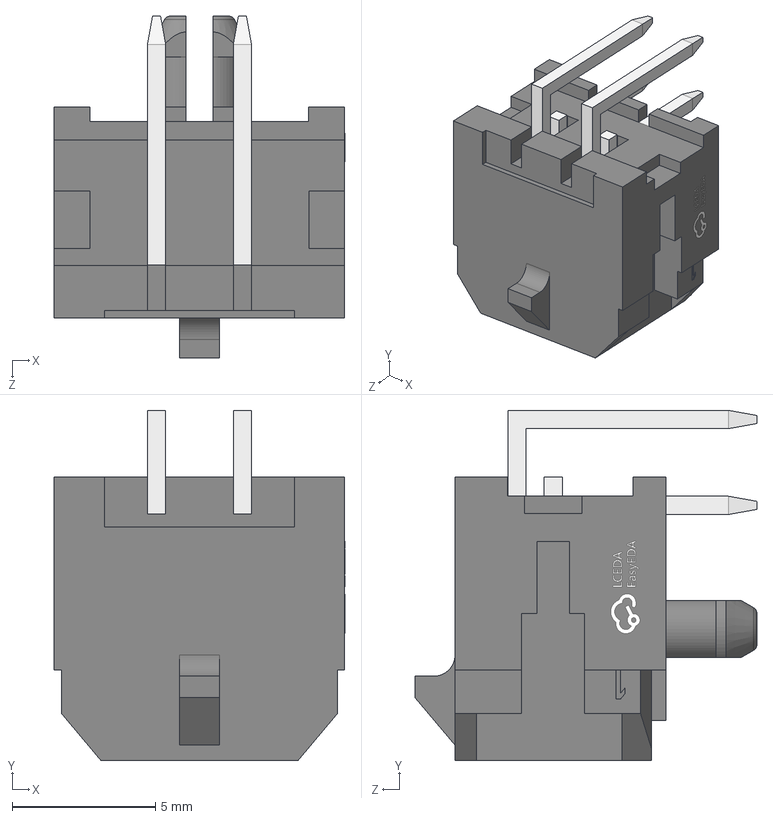
[picture p46: CAD file, 2026-10-09]
hw/parts/MOLEX_0430450400/430450400.STEP
10.2 x 12.2 x 11.9 mm
