0x63616c/smart-blinds/cad/source/packaging_v2_parameters.scad

// GENERATED by cad/build_v2.py; edit packaging-v2.json.
ids=["sidecar", "supported", "holders_broad", "holders_stack", "holders_smt", "holders_belt"];
sizes=[[118, 142, 60], [150, 156, 64], [170, 158, 64], [150, 158, 74], [150, 168, 64], [128, 194, 74]];
batteries=["welded", "welded", "broad", "stack", "smt", "stack"];
drives=["direct", "inline", "inline", "inline", "inline", "belt"];
pcbs=[[79, 3, 46, 35, 75], [108, 3, 50, 35, 75], [126, 3, 50, 35, 75], [108, 3, 50, 35, 75], [108, 3, 50, 35, 75], [89, 3, 50, 35, 75]];
motors=[[12, 112, 30], [12, 123, 30], [12, 126, 30], [12, 126, 30], [12, 136, 30], [12, 126, 30]];
carriers=[[0, 0, 0, 0, 0], [0, 0, 0, 0, 0], [6, 8, 8, 158, 100], [6, 8, 30, 82, 100], [6, 8, 30, 82, 112], [6, 8, 30, 82, 100]];
radios=[[99, 3, 47.6, 15, 18, 8], [128, 3, 51.6, 15, 18, 8], [146, 3, 51.6, 15, 18, 8], [128, 3, 51.6, 15, 18, 8], [128, 3, 51.6, 15, 18, 8], [109, 3, 51.6, 15, 18, 8]];
