0x63616c/smart-blinds/cad/source/parameters.scad

// GENERATED by cad/build.py from cad/parameters/packaging.json. Do not edit.
cell_d = 21.25;
cell_l = 70.8;
pack_d = 23;
pack_l = 76;
cell_pitch = 23.5;
motor_d = 39;
motor_l = 64;
shaft_d = 6;
shaft_l = 18;
shaft_flat = 5.4;
chain_pitch = 6;
chain_bead = 4.5;
chain_link = 1;
chain_pockets = 12;
chain_clearance = 0.5;
wheel_width = 10;
pcb_width = 75;
pcb_height = 35;
pcb_thickness = 1.6;
pcb_component_h = 8;
antenna_w = 15;
shell_wall = 2.4;
shell_base = 3;
shell_radius = 9;
option_sizes = [[150, 140, 58], [114, 140, 68], [86, 212, 68], [114, 220, 54]];
pack_origins = [[15, 10, 17], [18, 10, 17], [4, 44.5, 17], [18, 10, 17]];
motor_origins = [[12, 111, 28], [12, 111, 28], [26, 111, 26], [12, 191, 28]];
pcb_origins = [[65, 3, 44], [32, 3, 55], [4, 3, 55], [32, 3, 35]];
cell_cols = [6, 3, 1, 3];
cell_depth = [1, 2, 2, 1];
cell_rows = [1, 1, 3, 2];
