0x63616c/smart-blinds/docs/generated/holder-service-fixture/assembly.png

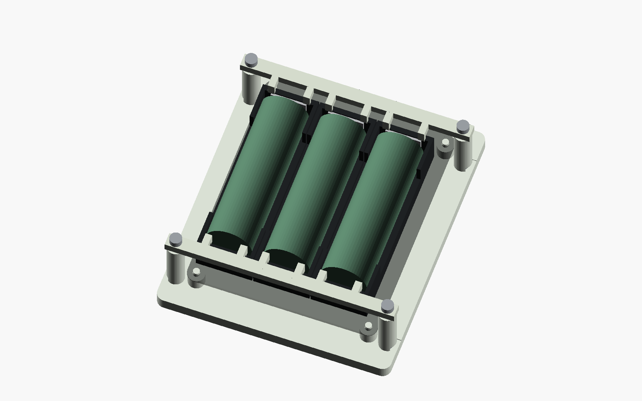
docs/generated/holder-service-fixture/assembly.png
