0x63616c/smart-blinds/hw/sim/blind-control/results/no_clamp.csv

time_s | bus_v | capacitor_v | dump_current_a | dump_power_w
1.00000000e-07 | 1.25999994e+01 | 1.26000000e+01 | 0.00000000e+00 | 0.00000000e+00
2.00000000e-07 | 1.25999994e+01 | 1.26000000e+01 | 0.00000000e+00 | 0.00000000e+00
4.00000000e-07 | 1.25999993e+01 | 1.26000000e+01 | 0.00000000e+00 | 0.00000000e+00
8.00000000e-07 | 1.25999993e+01 | 1.26000000e+01 | 0.00000000e+00 | 0.00000000e+00
1.60000000e-06 | 1.25999993e+01 | 1.25999999e+01 | 0.00000000e+00 | 0.00000000e+00
3.20000000e-06 | 1.25999992e+01 | 1.25999998e+01 | 0.00000000e+00 | 0.00000000e+00
6.40000000e-06 | 1.25999990e+01 | 1.25999996e+01 | 0.00000000e+00 | 0.00000000e+00
1.00000000e-05 | 1.25999988e+01 | 1.25999994e+01 | 0.00000000e+00 | 0.00000000e+00
1.06400000e-05 | 1.25999988e+01 | 1.25999994e+01 | 0.00000000e+00 | 0.00000000e+00
1.19200000e-05 | 1.25999987e+01 | 1.25999993e+01 | 0.00000000e+00 | 0.00000000e+00
1.44800000e-05 | 1.25999985e+01 | 1.25999992e+01 | 0.00000000e+00 | 0.00000000e+00
1.96000000e-05 | 1.25999982e+01 | 1.25999989e+01 | 0.00000000e+00 | 0.00000000e+00
2.96000000e-05 | 1.25999977e+01 | 1.25999983e+01 | 0.00000000e+00 | 0.00000000e+00
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
