0x63616c/smart-blinds/docs/generated/main-controller-schematic/schematic.pdf

1 | 2 | 3 | 4 | 5 | 6
1 | 2 | 3 | 4 | 5 | 6

AB

C

D

AB

C

### D Date:

Size: A4 | Rev: STUDY
KiCad E.D.A. 10.0.7 | Id: 1/11

## Title: Smart Blinds / integrated controller

### File: smart-blinds-main.kicad_sch

### Sheet: /

### Unrouted circuit; not for fabrication

Regenerative clamp

File: 06-regen.kicad_sch Encoder input File: 08-encoder-input.kicad_sch | Buttons and home input File: 09-local-input.kicad_sch
USB-C input File: 01-usb.kicad_sch | Motor supervision

File: 05-supervision.kicad_sch 3S charger File: 02-charger.kicad_sch Power and motor permission

File: 10-interfaces.kicad_sch

Logic supply

File: 03-logic.kicad_sch Motor bridge

File: 04-motor.kicad_sch Radio and USB data

File: 07-radio.kicad_sch 42 parts / 151 pin identities | 11 parts / 30 pin identities Captured circuit and native netlist are checked pin for pin. No routed or powered hardware acceptance. 13 parts / 40 pin identities 16 parts / 70 pin identities 14 parts / 43 pin identities Sheet labels share only the explicitly named global nets. Open a sheet to inspect every part. 206 circuit features. USB-C charging, protected pack input, radio, motor and local controls. SMART BLINDS / INTEGRATED CONTROLLER
10 parts / 29 pin identities 14 parts / 49 pin identities 36 parts / 101 pin identities | 38 parts / 105 pin identities 12 parts / 31 pin identities

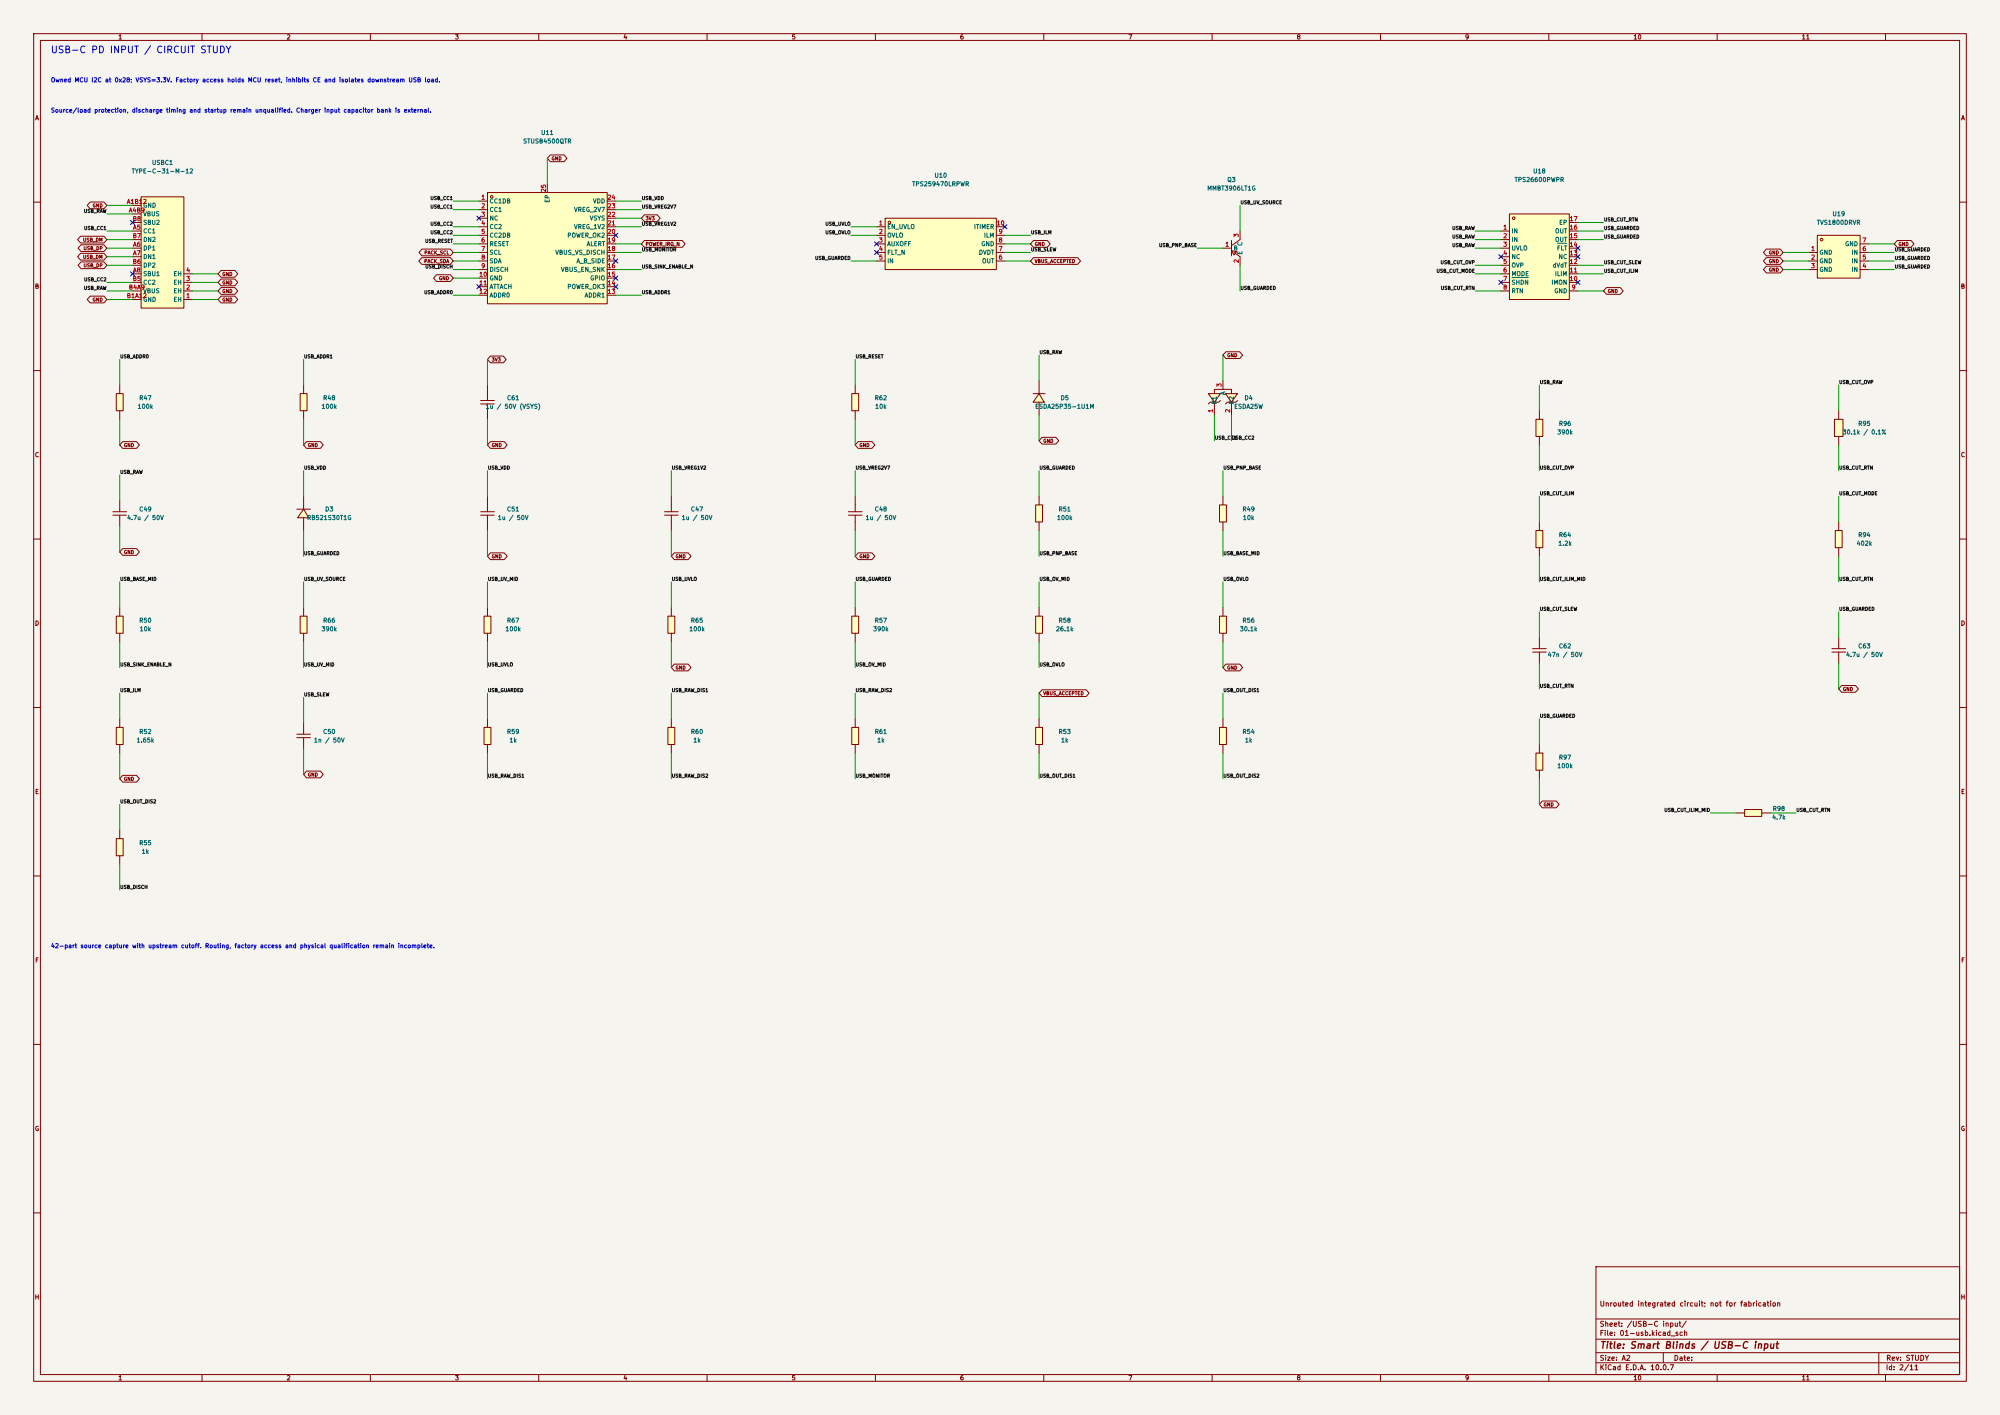
[picture p48: page 2]

USB-C PD INPUT / CIRCUIT STUDY

Owned MCU I2C at 0x28; VSYS=3.3V. Factory access holds MCU reset, inhibits CE and isolates downstream USB load. Source/load protection, discharge timing and startup remain unqualified. Charger input capacitor bank is external.

42-part source capture with upstream cutoff. Routing, factory access and physical qualification remain incomplete.

Unrouted integrated circuit; not for fabrication

Sheet: /USB-C input/
File: 01-usb.kicad_sch
Title: Smart Blinds / USB-C input

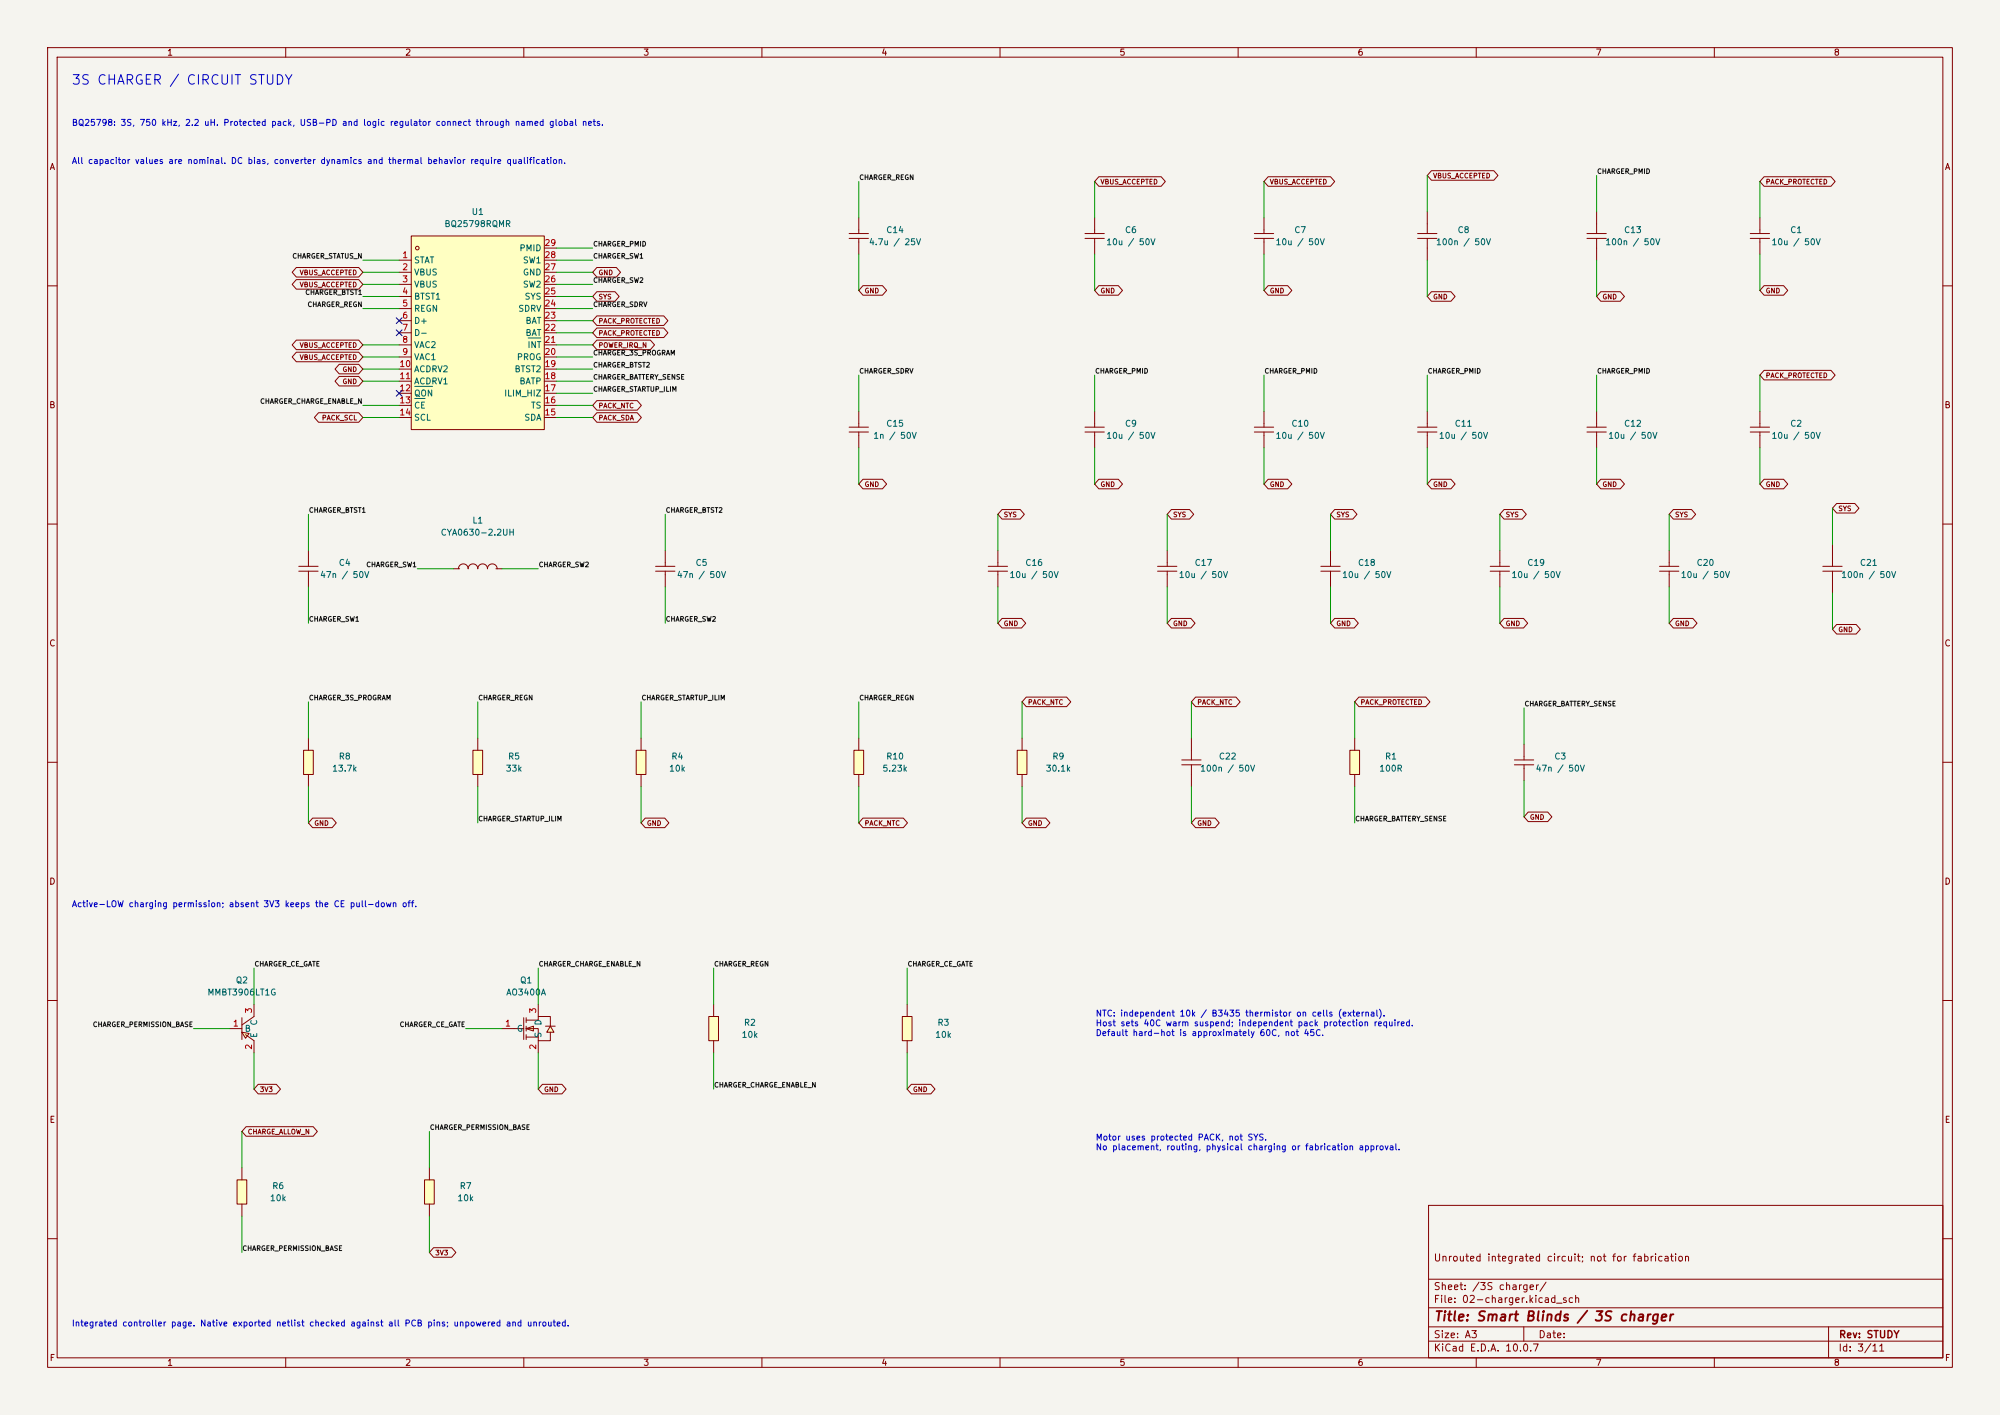
[picture p49: page 3]

BQ25798: 3S, 750 kHz, 2.2 uH. Protected pack, USB-PD and logic regulator connect through named global nets. All capacitor values are nominal. DC bias, converter dynamics and thermal behavior require qualification.

Motor uses protected PACK, not SYS. No placement, routing, physical charging or fabrication approval. NTC: independent 10k / B3435 thermistor on cells (external). Host sets 40C warm suspend; independent pack protection required. Default hard-hot is approximately 60C, not 45C. Active-LOW charging permission; absent 3V3 keeps the CE pull-down off.

Unrouted integrated circuit; not for fabrication

Sheet: /3S charger/
File: 02-charger.kicad_sch
Title: Smart Blinds / 3S charger

Integrated controller page. Native exported netlist checked against all PCB pins; unpowered and unrouted.

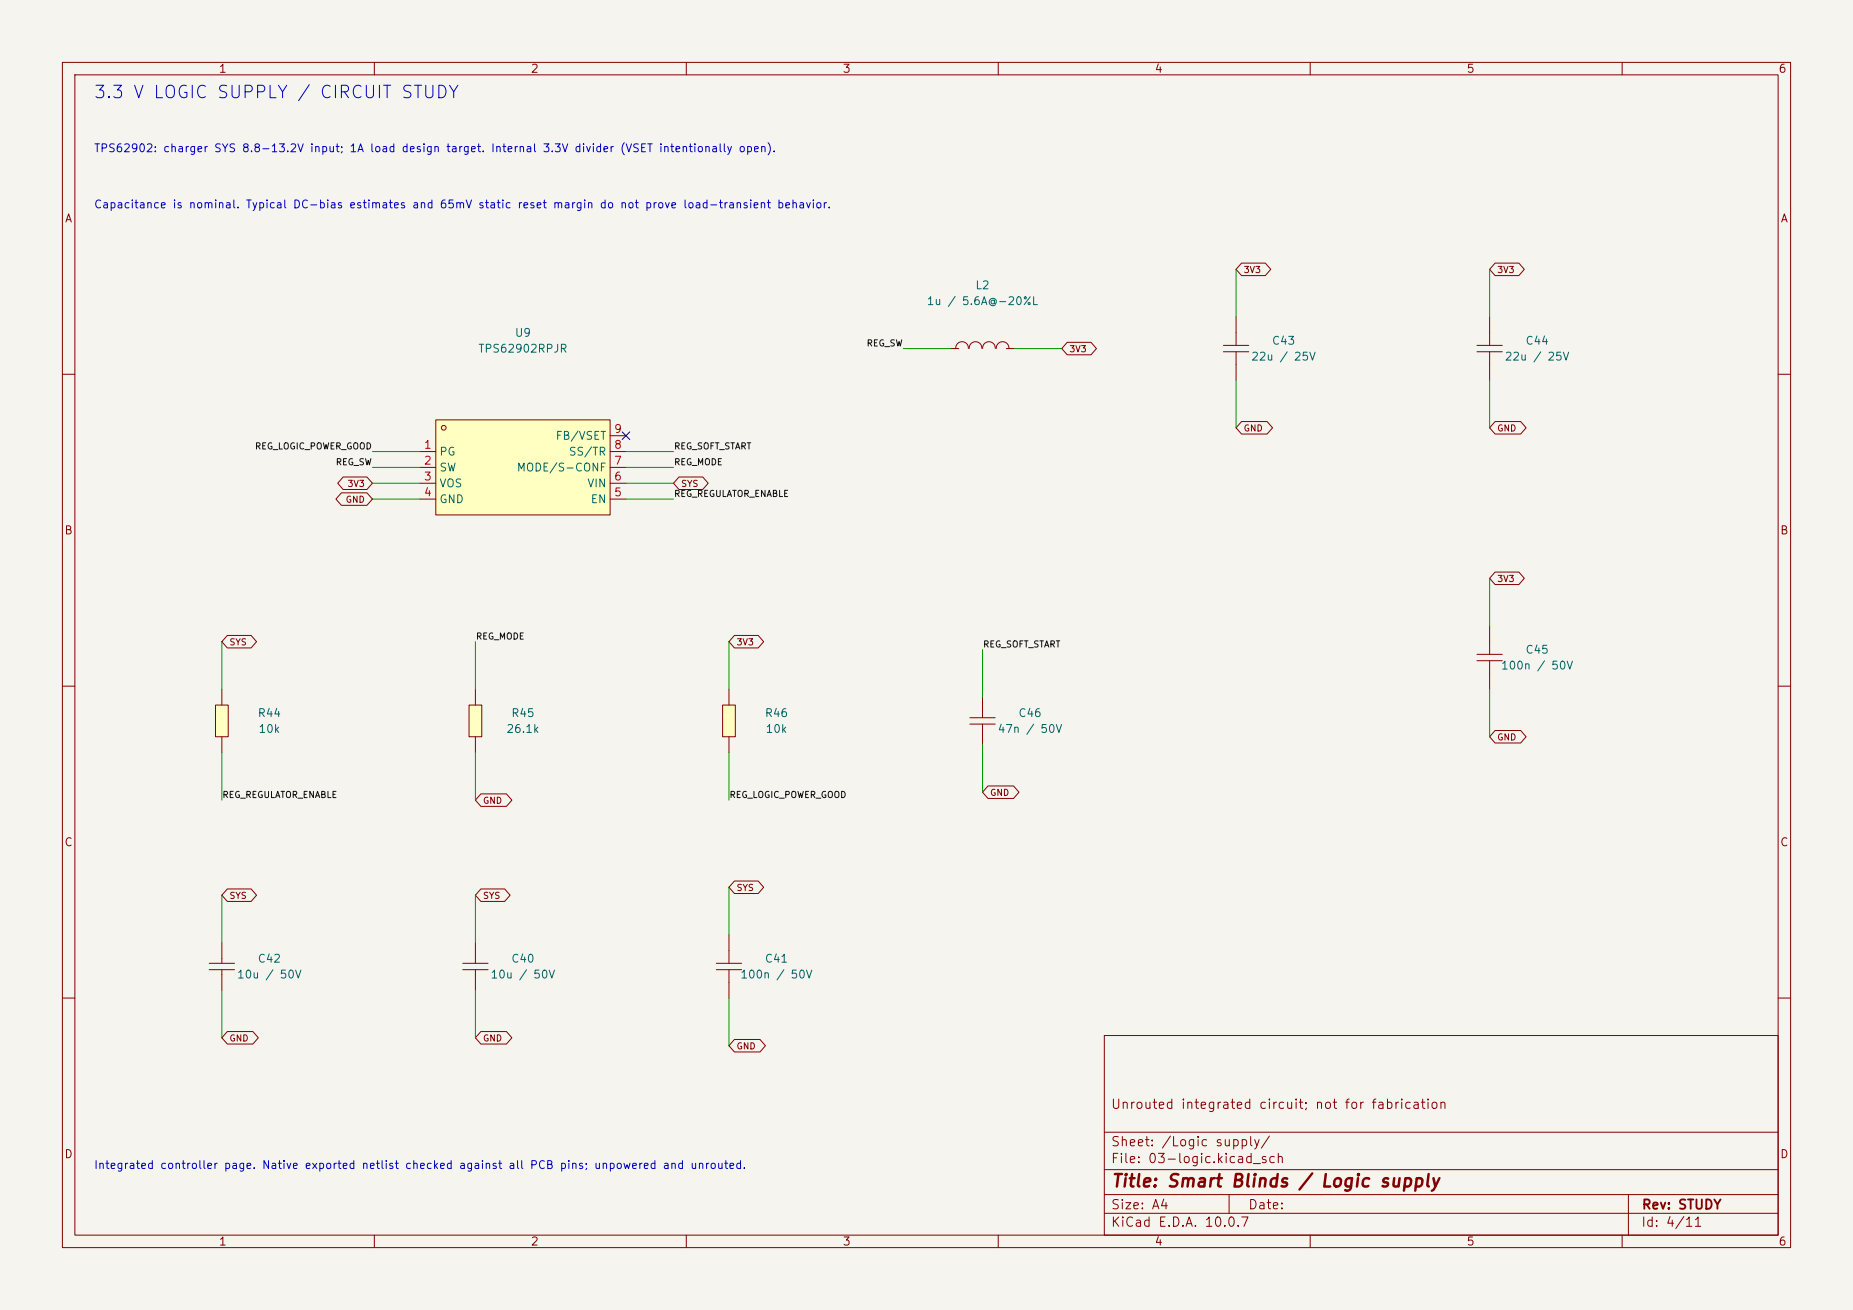
[picture p50: page 4]

3.3 V LOGIC SUPPLY / CIRCUIT STUDY

TPS62902: charger SYS 8.8-13.2V input; 1A load design target. Internal 3.3V divider (VSET intentionally open).

Capacitance is nominal. Typical DC-bias estimates and 65mV static reset margin do not prove load-transient behavior.

Unrouted integrated circuit; not for fabrication

Integrated controller page. Native exported netlist checked against all PCB pins; unpowered and unrouted.

Sheet: /Logic supply/
File: 03-logic.kicad_sch
Title: Smart Blinds / Logic supply

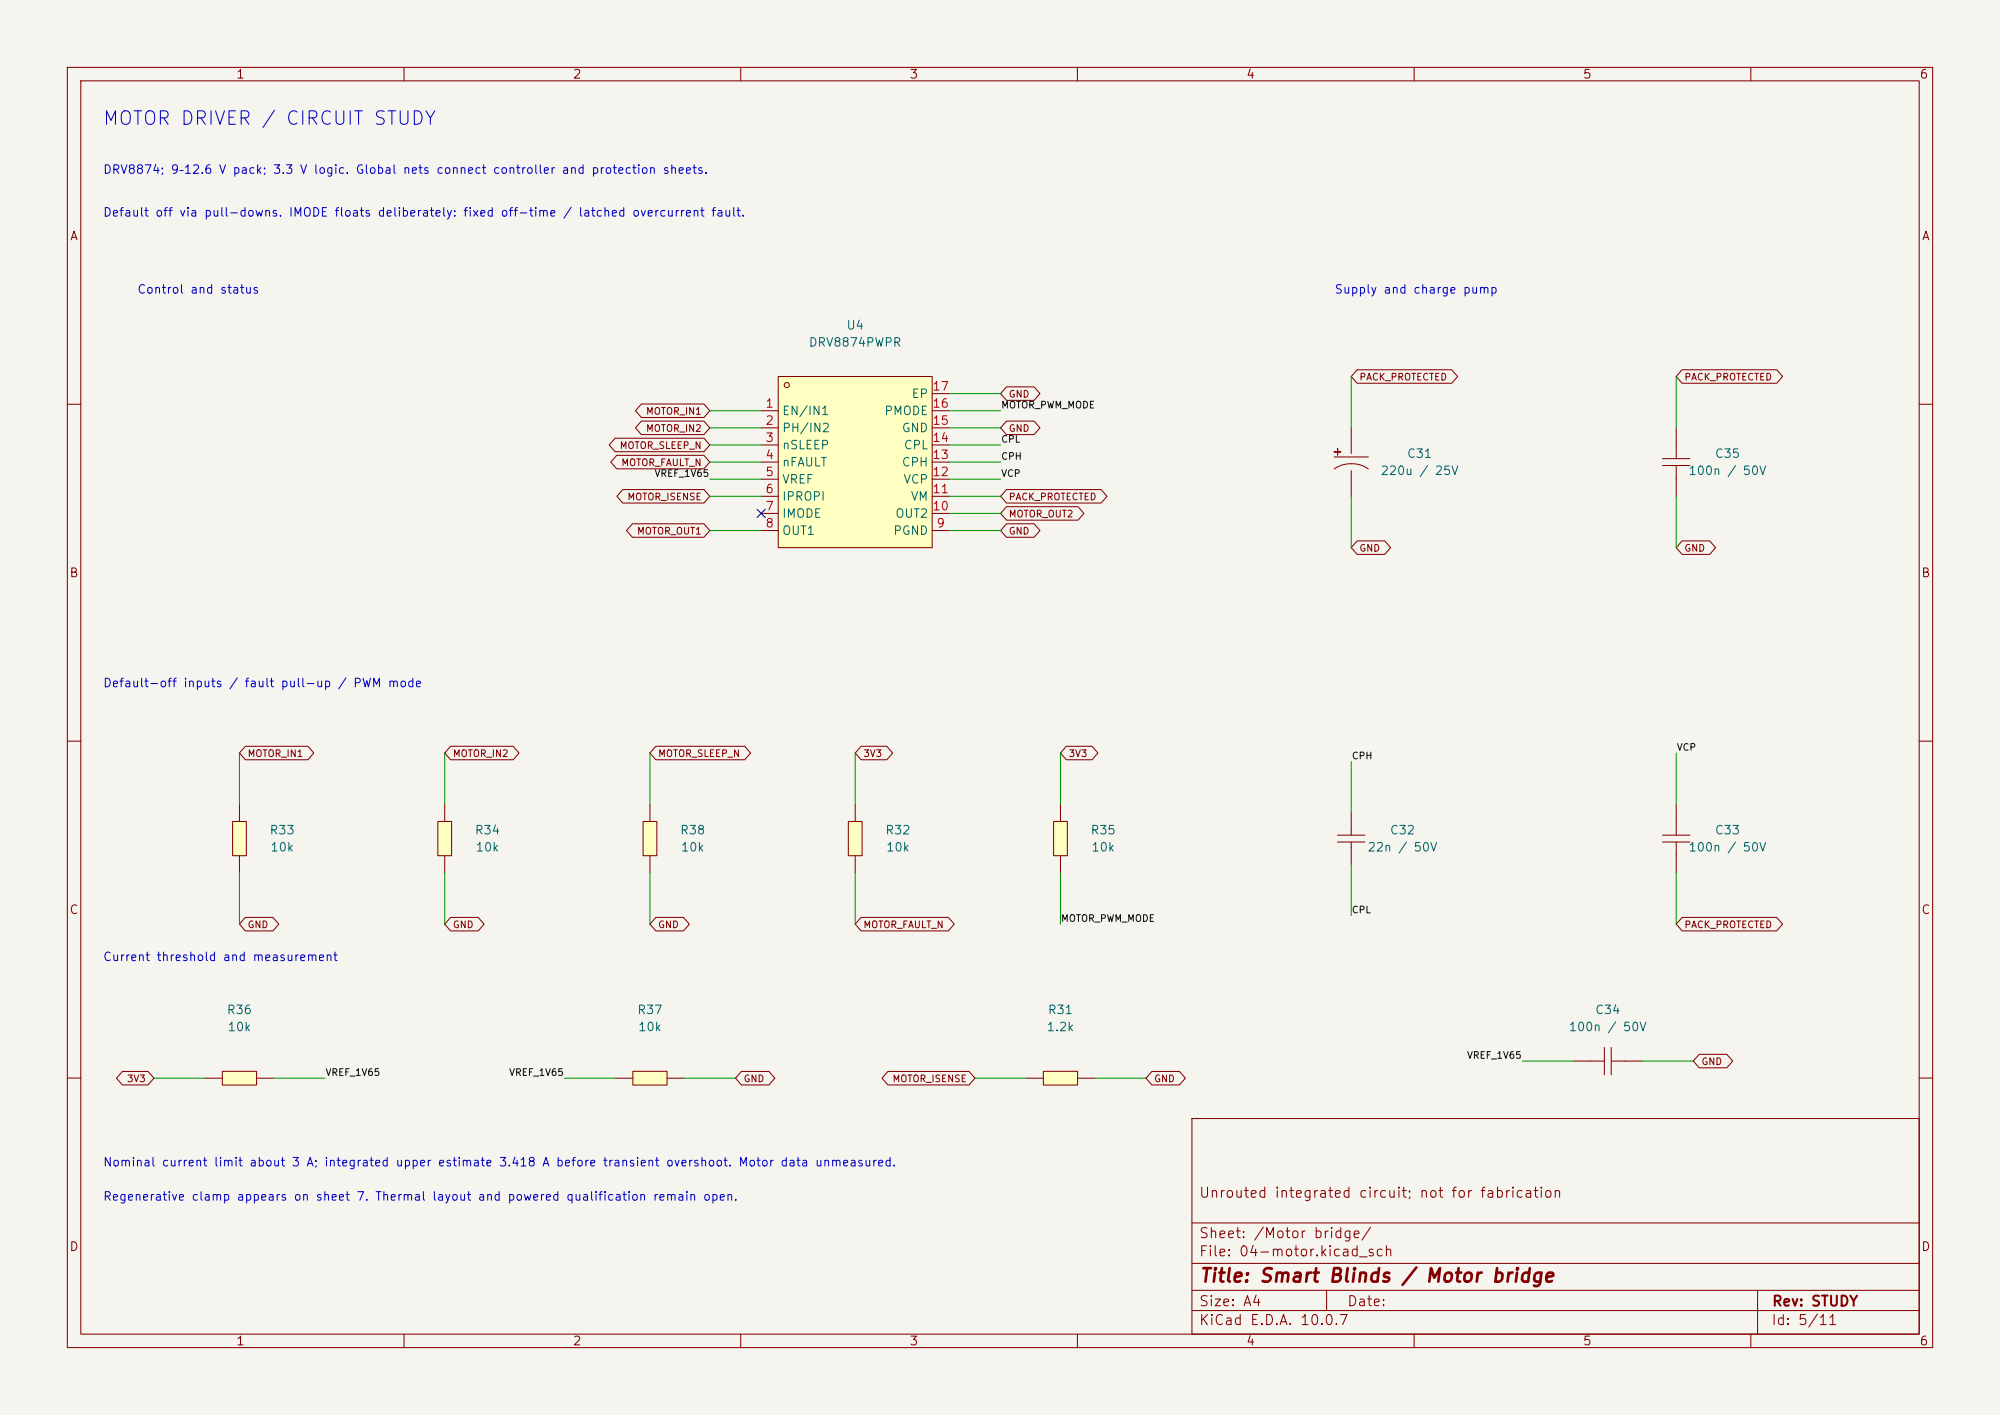
[picture p51: page 5]

MOTOR DRIVER / CIRCUIT STUDY

DRV8874; 9–12.6 V pack; 3.3 V logic. Global nets connect controller and protection sheets. Current threshold and measurement

VREF_1V65 Regenerative clamp appears on sheet 7. Thermal layout and powered qualification remain open.

Unrouted integrated circuit; not for fabrication

Sheet: /Motor bridge/
File: 04-motor.kicad_sch
Title: Smart Blinds / Motor bridge

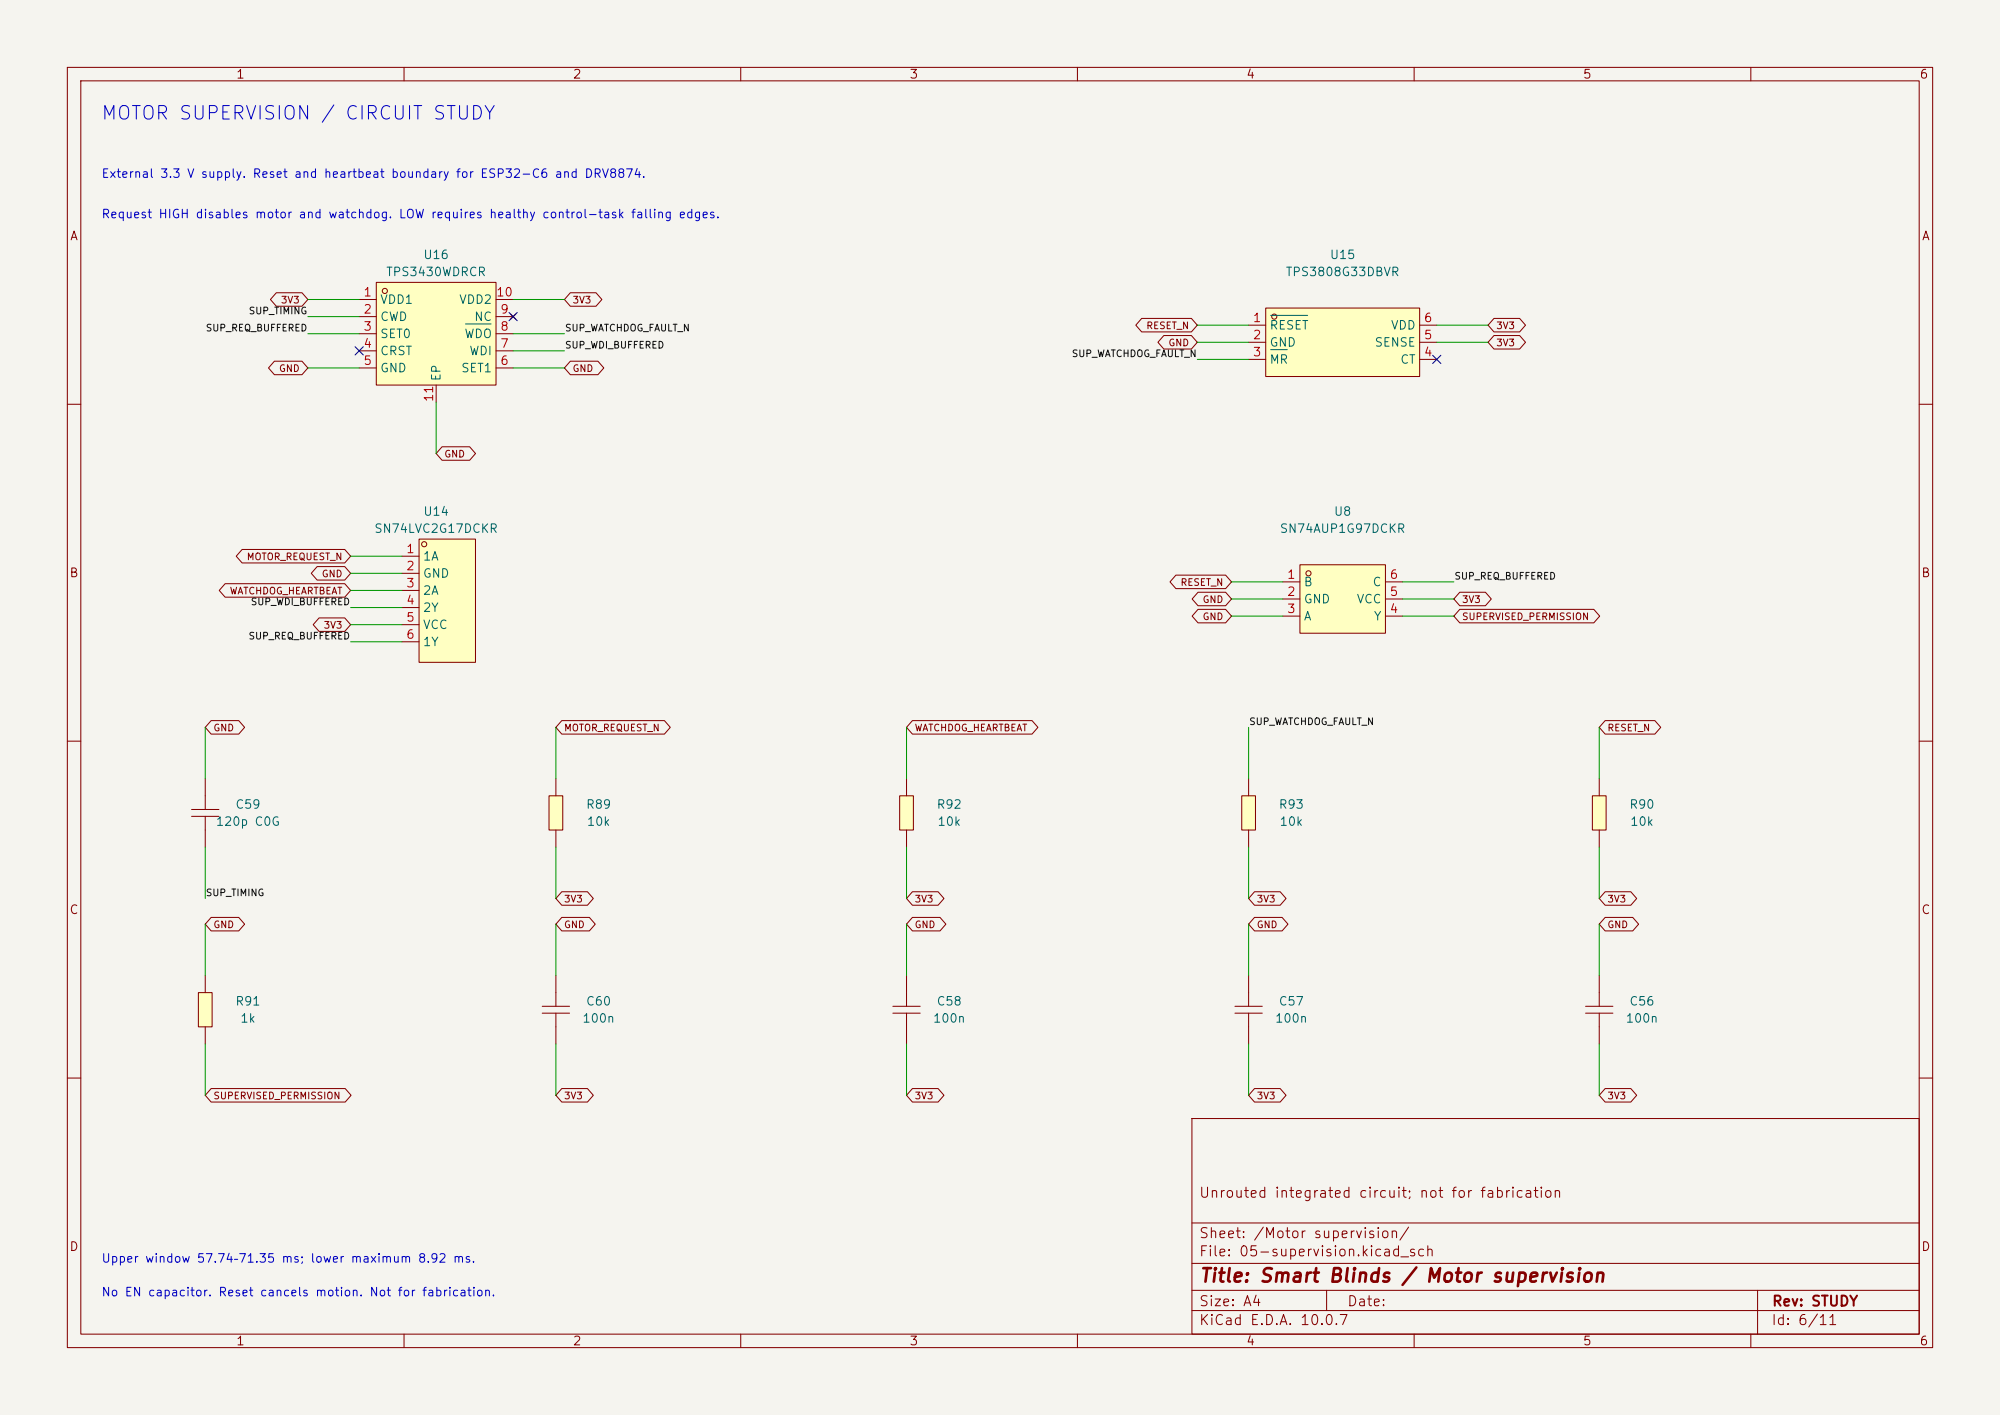
[picture p52: page 6]

SUP_REQ_BUFFERED External 3.3 V supply. Reset and heartbeat boundary for ESP32-C6 and DRV8874. MOTOR SUPERVISION / CIRCUIT STUDY

Request HIGH disables motor and watchdog. LOW requires healthy control-task falling edges.

Unrouted integrated circuit; not for fabrication

Upper window 57.74–71.35 ms; lower maximum 8.92 ms. No EN capacitor. Reset cancels motion. Not for fabrication.

Sheet: /Motor supervision/
File: 05-supervision.kicad_sch
Title: Smart Blinds / Motor supervision

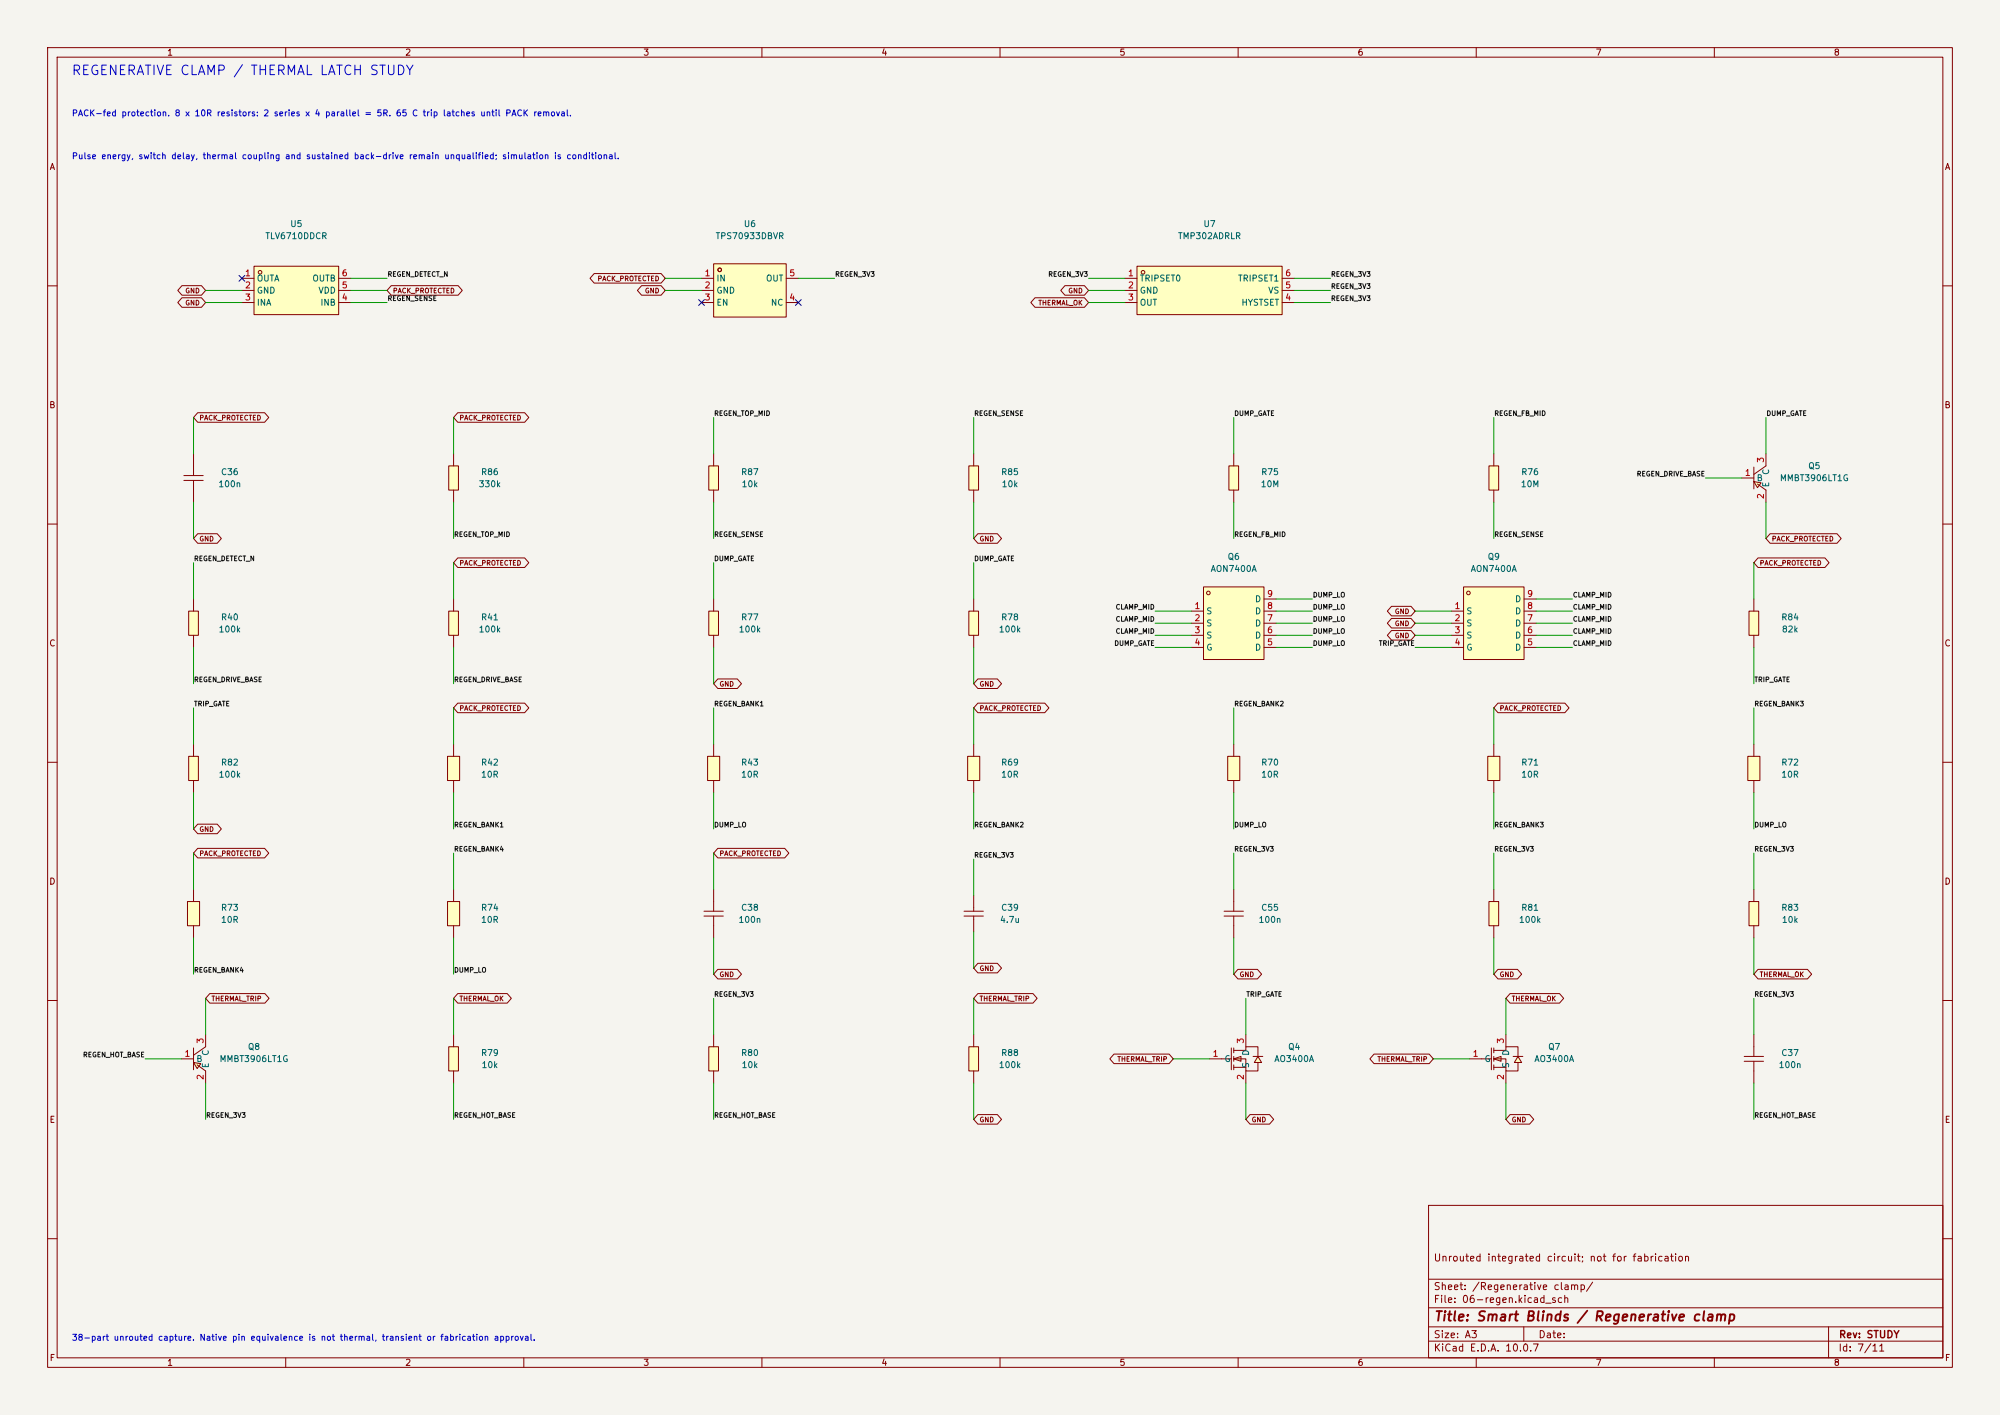
[picture p53: page 7]

Pulse energy, switch delay, thermal coupling and sustained back-drive remain unqualified; simulation is conditional. PACK-fed protection. 8 x 10R resistors: 2 series x 4 parallel = 5R. 65 C trip latches until PACK removal. REGENERATIVE CLAMP / THERMAL LATCH STUDY

Unrouted integrated circuit; not for fabrication

Sheet: /Regenerative clamp/
File: 06-regen.kicad_sch
Title: Smart Blinds / Regenerative clamp

38-part unrouted capture. Native pin equivalence is not thermal, transient or fabrication approval.

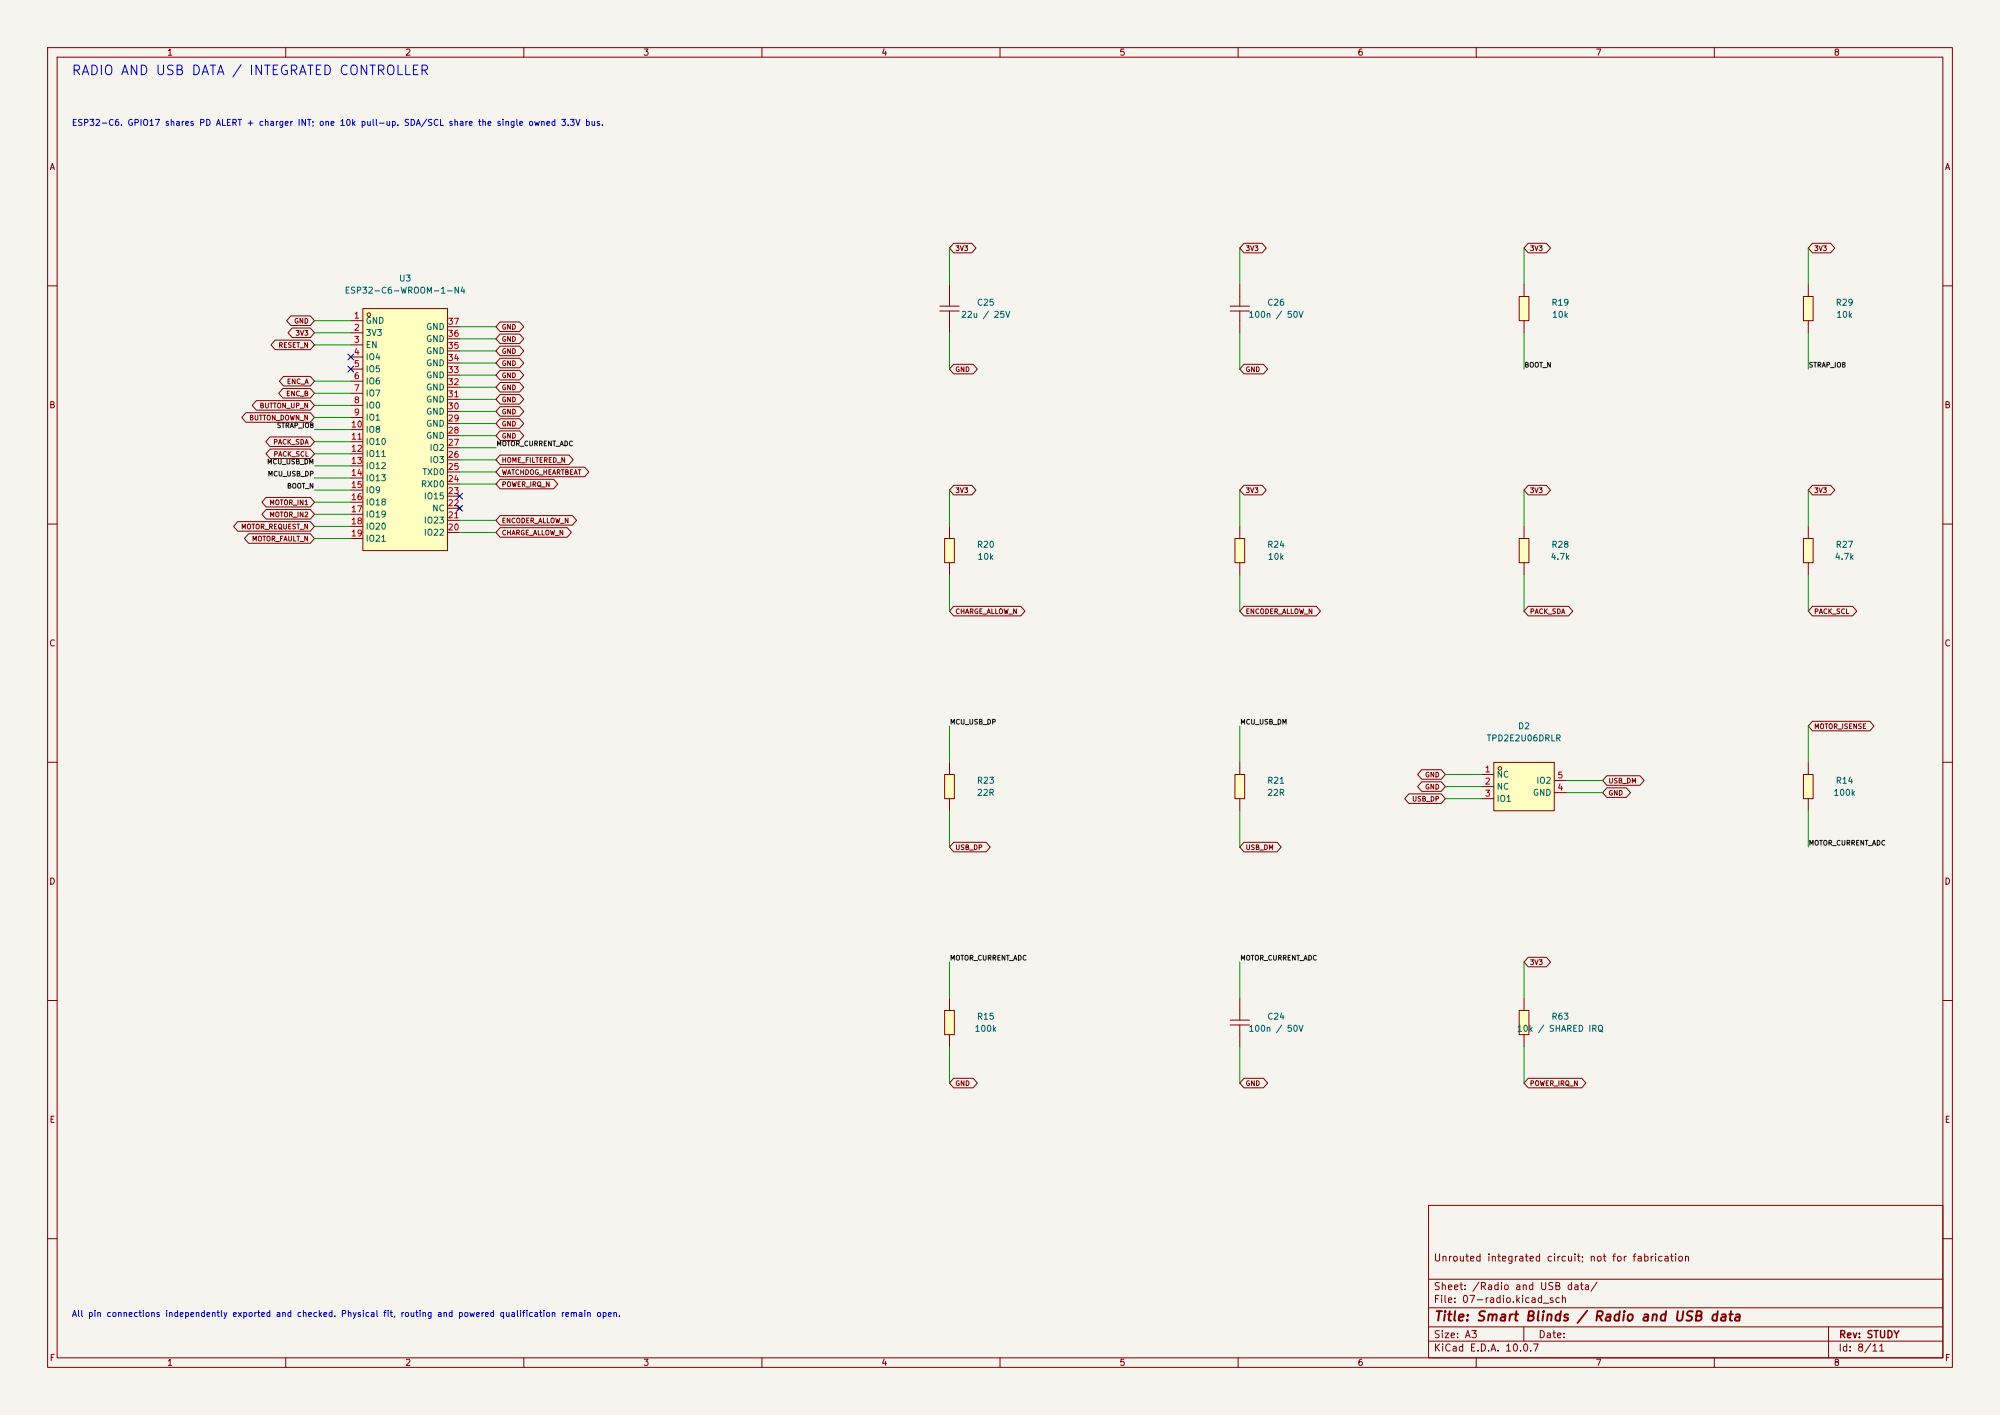
[picture p54: page 8]

BOOT_N RADIO AND USB DATA / INTEGRATED CONTROLLER

ESP32-C6. GPIO17 shares PD ALERT + charger INT; one 10k pull-up. SDA/SCL share the single owned 3.3V bus.
ESP32-C6-WROOM-1-N4

Unrouted integrated circuit; not for fabrication

Sheet: /Radio and USB data/
File: 07-radio.kicad_sch
Title: Smart Blinds / Radio and USB data

All pin connections independently exported and checked. Physical fit, routing and powered qualification remain open.

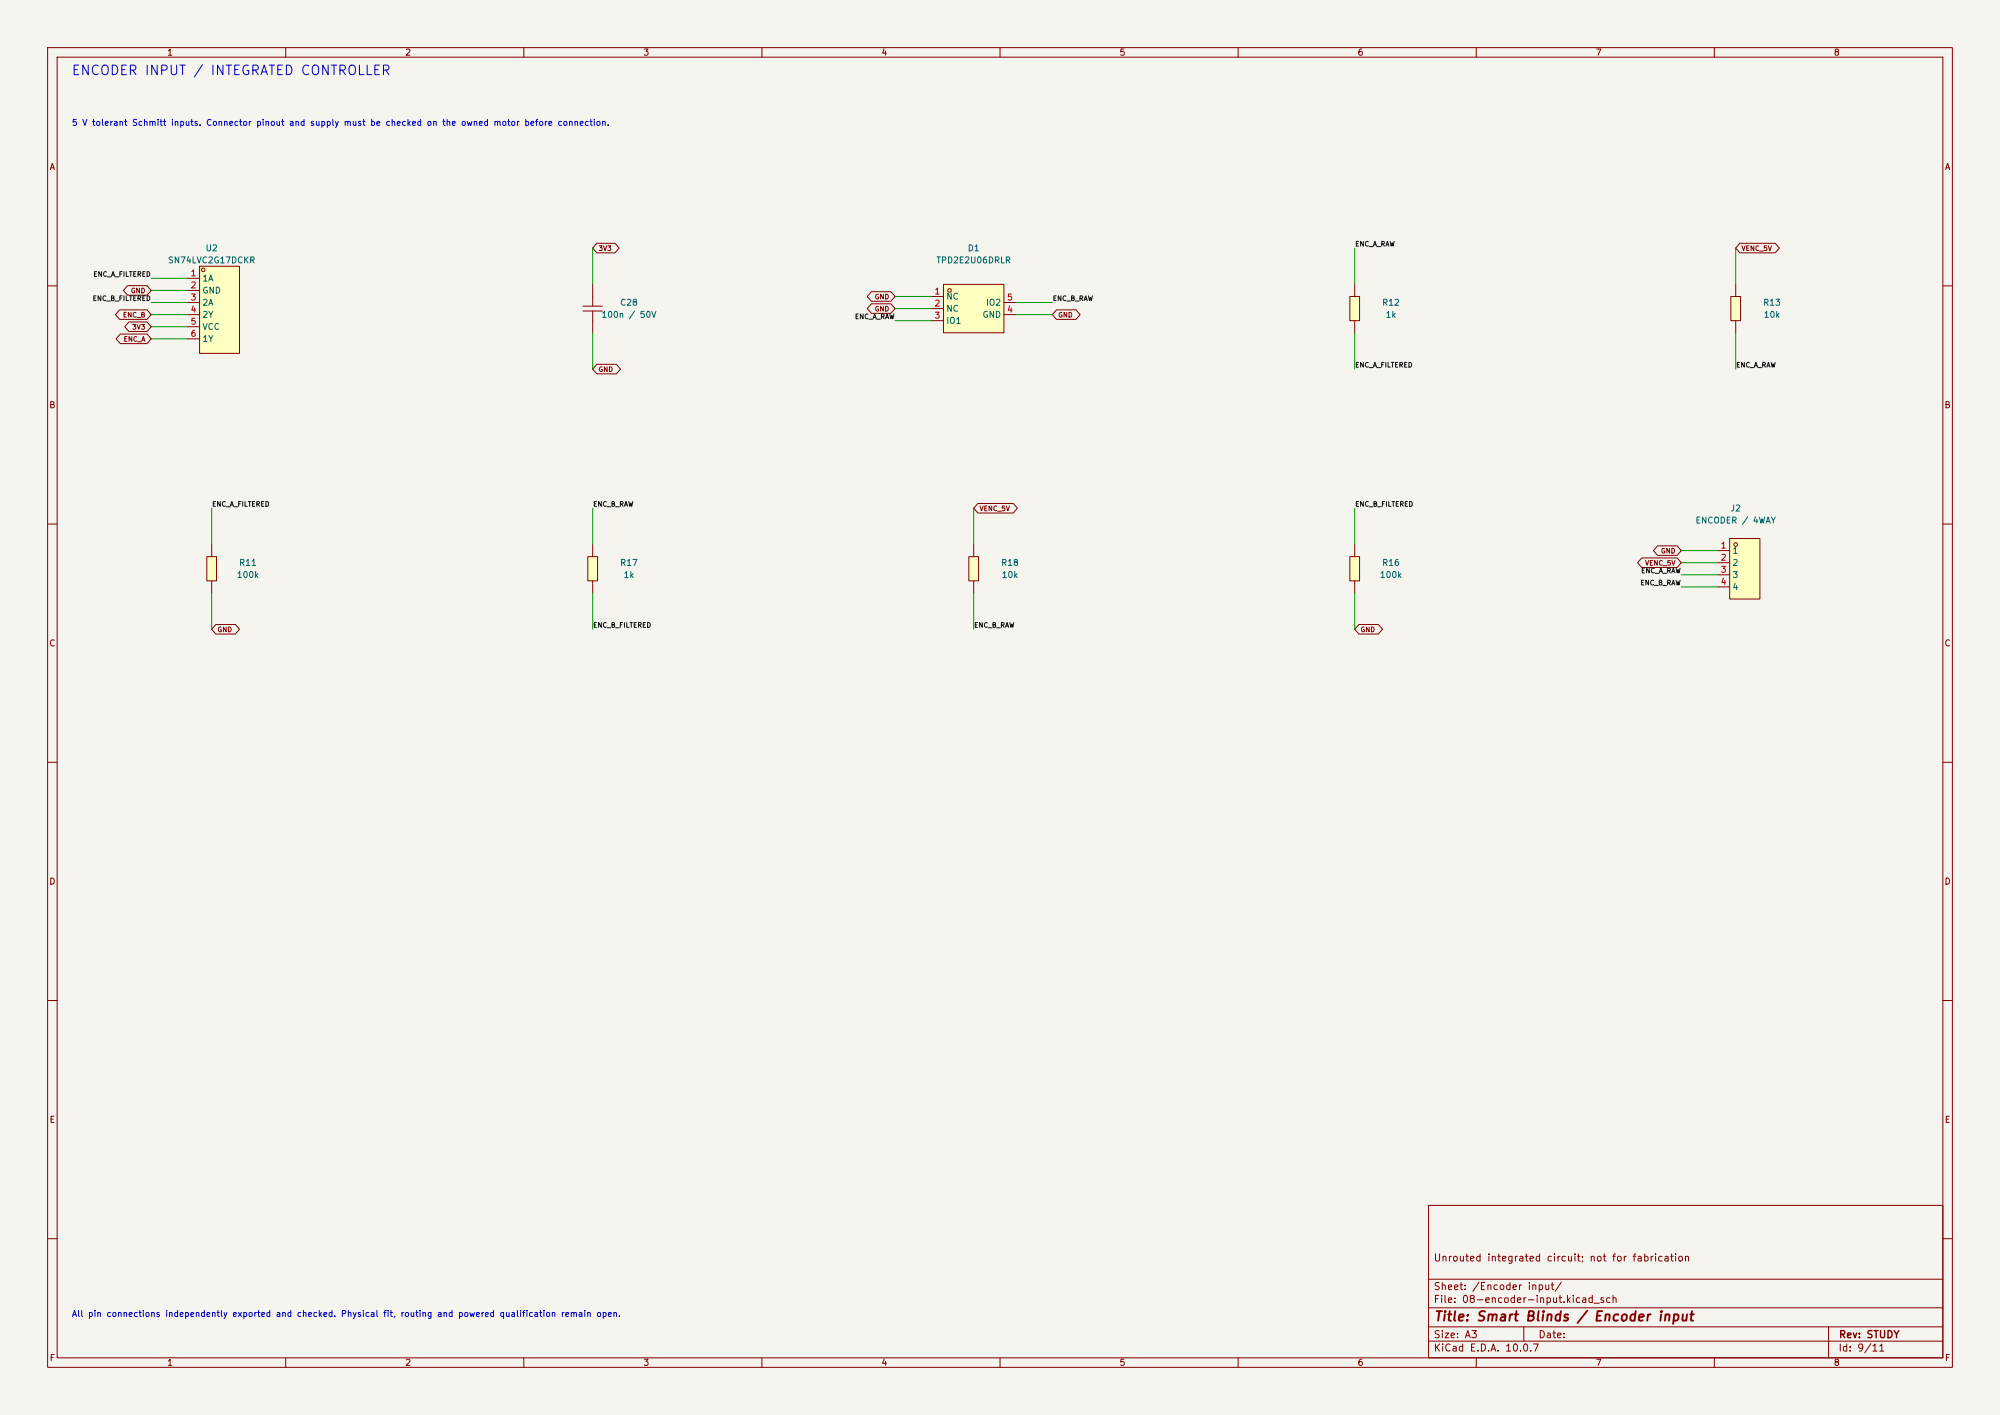
[picture p55: page 9]

ENCODER INPUT / INTEGRATED CONTROLLER

5 V tolerant Schmitt inputs. Connector pinout and supply must be checked on the owned motor before connection.

Unrouted integrated circuit; not for fabrication

Sheet: /Encoder input/
File: 08-encoder-input.kicad_sch
Title: Smart Blinds / Encoder input

All pin connections independently exported and checked. Physical fit, routing and powered qualification remain open.

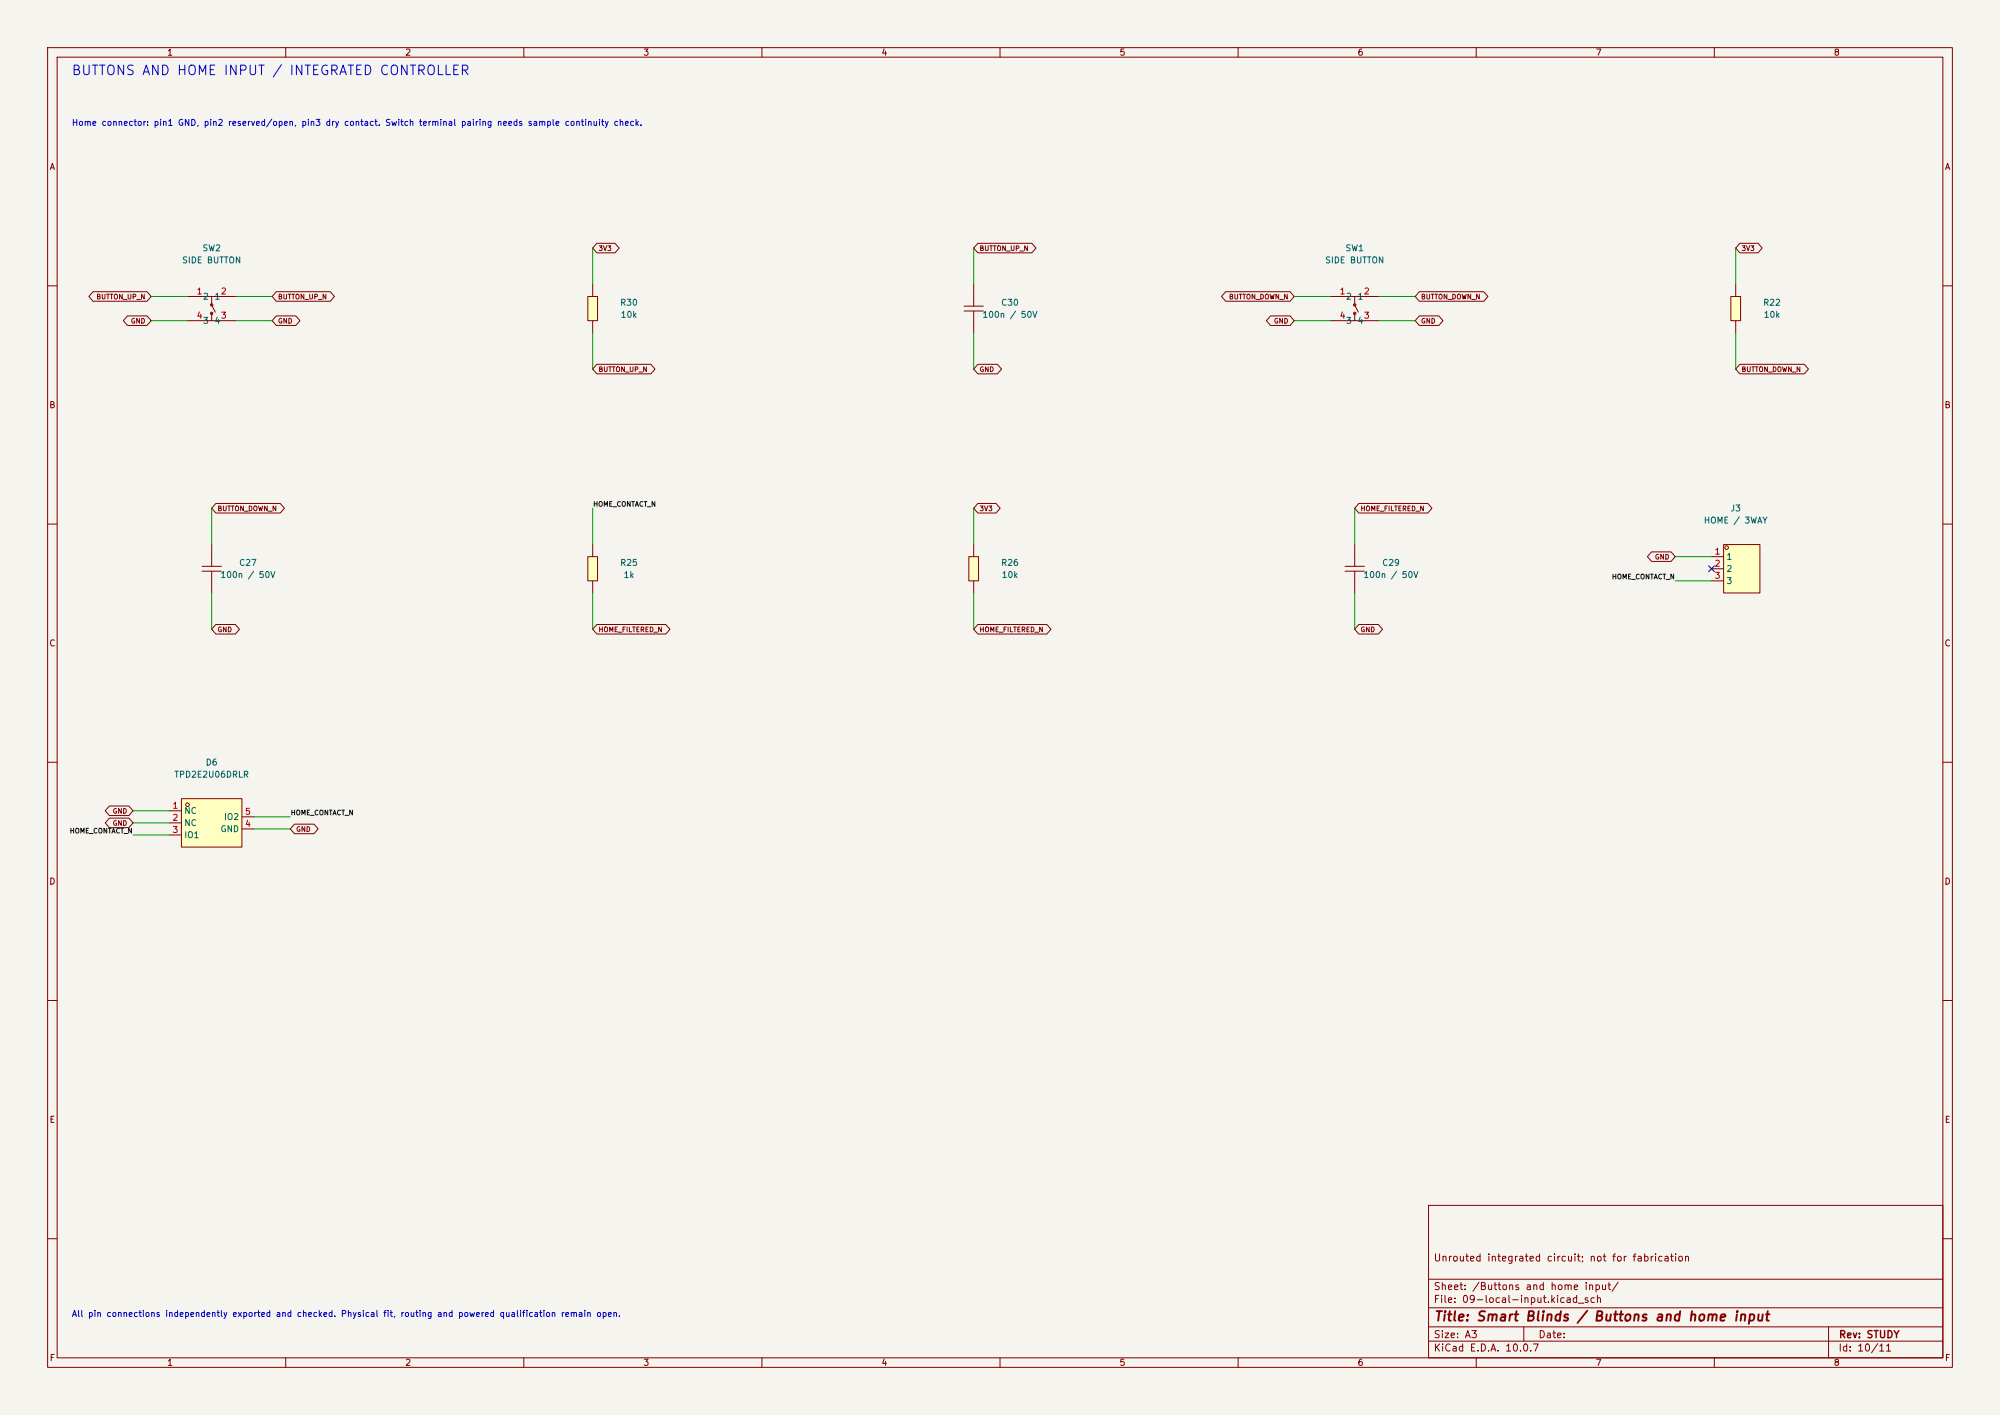
[picture p56: page 10]

HOME_CONTACT_N BUTTONS AND HOME INPUT / INTEGRATED CONTROLLER

Home connector: pin1 GND, pin2 reserved/open, pin3 dry contact. Switch terminal pairing needs sample continuity check.

Unrouted integrated circuit; not for fabrication

Sheet: /Buttons and home input/
File: 09-local-input.kicad_sch
Title: Smart Blinds / Buttons and home input

All pin connections independently exported and checked. Physical fit, routing and powered qualification remain open.

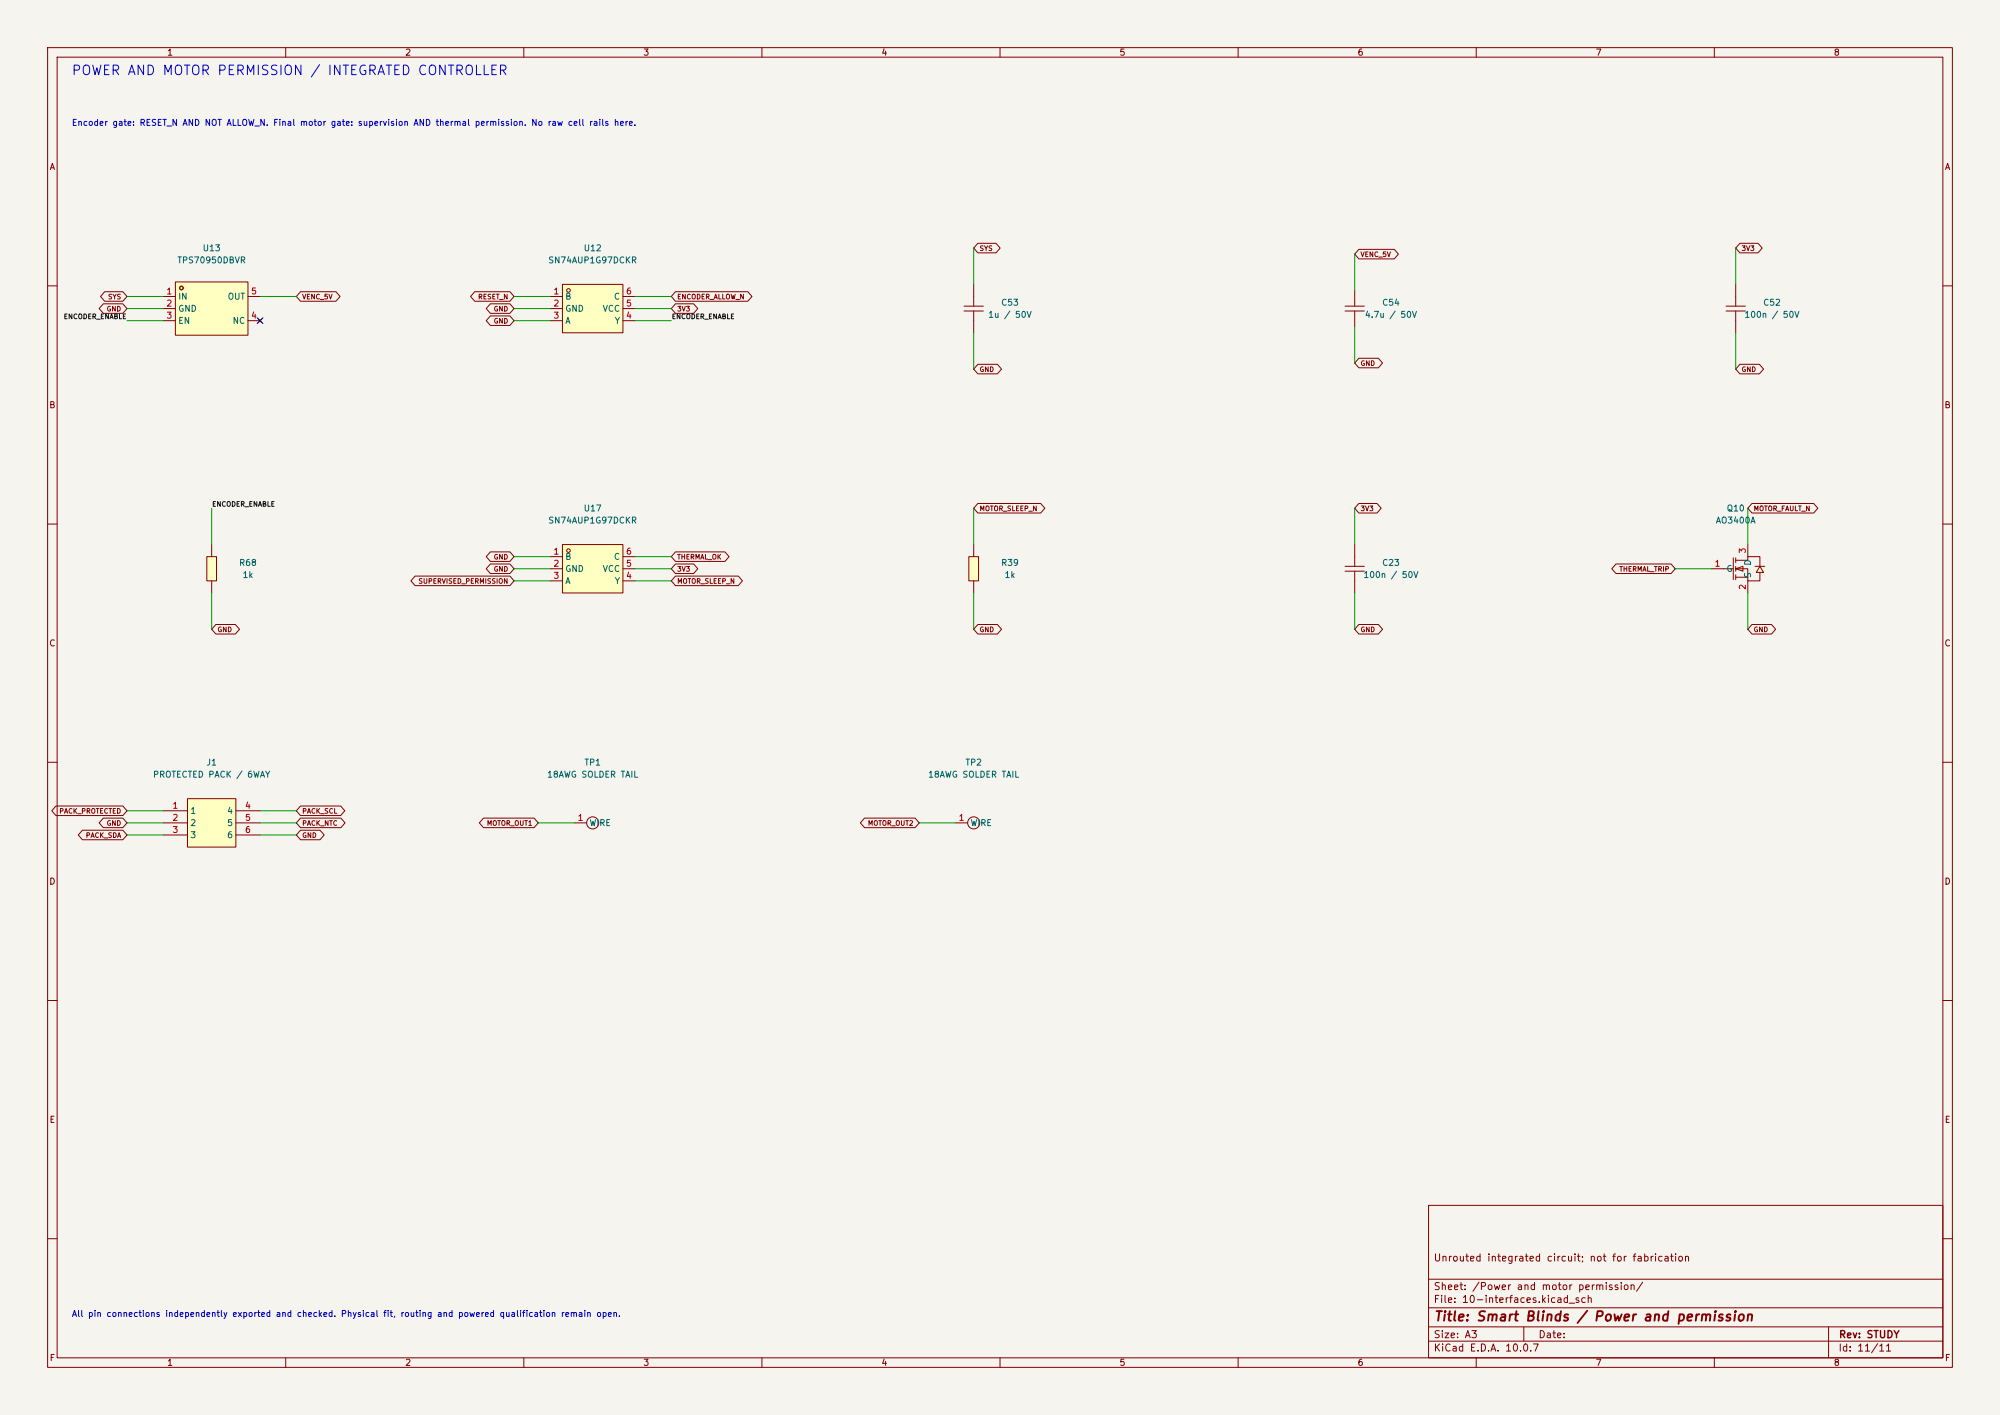
[picture p57: page 11]

POWER AND MOTOR PERMISSION / INTEGRATED CONTROLLER

Encoder gate: RESET_N AND NOT ALLOW_N. Final motor gate: supervision AND thermal permission. No raw cell rails here.

Unrouted integrated circuit; not for fabrication

Sheet: /Power and motor permission/
File: 10-interfaces.kicad_sch
Title: Smart Blinds / Power and permission

All pin connections independently exported and checked. Physical fit, routing and powered qualification remain open.
