0x63616c/smart-blinds/hw/layouts/blind-usb/usb-test/usb-test.kicad_pcb

## KiCad design hw/layouts/blind-usb/usb-test/usb-test.kicad_pcb (2026-10-21)

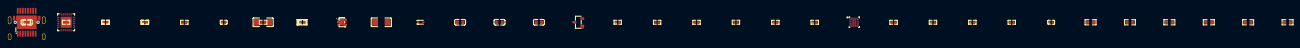
[picture p58: board usb-test.kicad_pcb from above]

Board: 2 copper layers, 42 parts (0 on the bottom side), 37 nets, no tracks yet.

Parts:
C1, C2, C5, C6: C0603
C3, C8: C1206
C4, C7: C0402
D1: SOD-523_L1.2-W0.8-LS1.6-RD
D2: SOT-323-3_L2.1-W1.3-P1.32-LS2.1-BR
D3: DFN1610-2_L1.6-W1.0-P1.05-RD
Q1: SOT-23-3_L2.9-W1.3-P1.90-LS2.4-BR
R1, R2, R3, R4, R5, R6, R10, R11, R12, R16, R17, R18, R19, R20, R21, R22, R23, R24, R25: R0402
R7, R8, R9, R13, R14, R15: R0603
U1: VQFN-10_L2.0-W2.0-P0.45-TL
U2: QFN-24_L4.0-W4.0-P0.50-BL-EP2.8
U3: TPS26600_PWP16
U4: TVS1800_DRV6
USBC1: HRO_TYPE_C_31_M_12

Connections:
1: C1.1, U2.21
2: C7.2, R18.2, R22.2, R25.2, U3.8, U3.17
C: Q1.3, R20.1
CC2: D2.2, U2.4, U2.5, USBC1.B5
DISCH: R9.2, U2.9
DVDT: C7.1, U3.12
ILIM: R17.1, U3.11
ILM: R6.1, U1.9
MODE: R18.1, U3.6
OVP: R22.1, R23.2, U3.5
RESET: R16.1, U2.6
VBUS_EN_SNK: R4.2, U2.16
VBUS_VS_DISCH: R15.2, U2.18
guarded-hv: C8.1, D1.2, Q1.2, R5.1, R11.1, R13.1, R24.1, U1.5, U3.15, U3.16, U4.4, U4.5, U4.6
hv: C6.1, U2.22
lv: C1.2, C2.2, C3.2, C4.2, C5.2, C6.2, C8.2, D2.3, D3.2, R1.2, R2.2, R6.2, R10.2, R16.2, R19.2, R24.2, U1.8, U2.10, U2.25, U3.9, U4.1, U4.2, U4.3, U4.7, USBC1.1, USBC1.2, USBC1.3, USBC1.4, USBC1.A1B12, USBC1.B1A12
output-hv: R7.1, U1.6
raw-hv: C3.1, D3.1, R23.1, U3.1, U3.2, U3.3, USBC1.A4B9, USBC1.B4A9
usb-1: C2.1, U2.23
usb-1-1: C5.1, D1.1, U2.24
usb-1-2: D2.1, U2.1, U2.2, USBC1.A5
usb-1-3: R19.1, R21.2, U1.1
usb-1-4: R1.1, U2.12
usb-1-5: R2.1, U2.13
usb-1-6: Q1.1, R3.1, R5.2
usb-1-7: R3.2, R4.1
usb-1-8: R17.2, R25.1
usb-1-9: R7.2, R8.1
usb-1-10: R8.2, R9.1
usb-1-11: R11.2, R12.1
usb-1-12: R13.2, R14.1
usb-1-13: R14.2, R15.1
usb-1-14: R20.2, R21.1
usb-2: R10.1, R12.2, U1.2
usb-DVDT: C4.1, U1.7
usb_dn: USBC1.A7, USBC1.B7
usb_dp: USBC1.A6, USBC1.B6
