0x63616c/smart-blinds/hw/layouts/blind-encoder/encoder-test/encoder-test.kicad_pcb

## KiCad design hw/layouts/blind-encoder/encoder-test/encoder-test.kicad_pcb (2026-10-21)

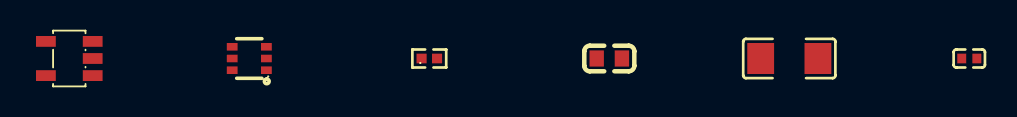
[picture p59: board encoder-test.kicad_pcb from above]

Board: 2 copper layers, 6 parts (0 on the bottom side), 5 nets, no tracks yet.

Parts:
C1: C0402
C2: C0603
C3: C1206
R1: R0402
U1: SC-70-6_L2.0-W1.3-P0.65-LS2.1-BR
U2: SOT-23-5_L3.0-W1.7-P0.95-LS2.8-BR

Connections:
EN: R1.1, U1.4, U2.3
hv: C1.1, U1.5
lv: C1.2, C2.2, C3.2, R1.2, U1.2, U1.3, U2.2
output-hv: C3.1, U2.5
source-hv: C2.1, U2.1
