0x63616c/smart-blinds/hw/layouts/blind-pack-primary/primary-test/primary-test.kicad_pcb

## KiCad design hw/layouts/blind-pack-primary/primary-test/primary-test.kicad_pcb (2026-10-21)

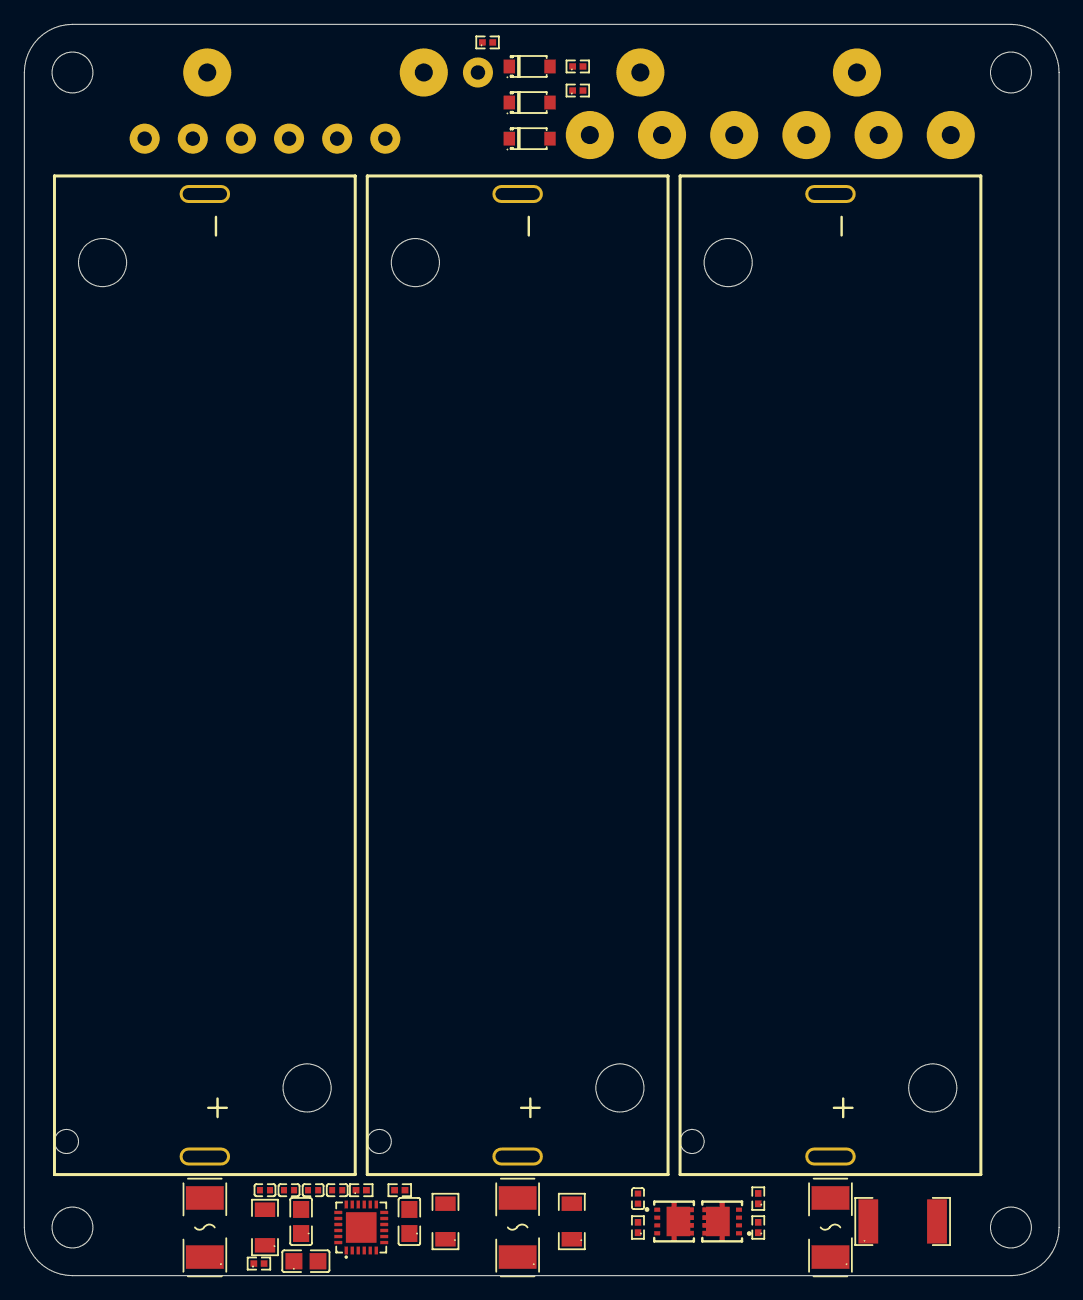
[picture p60: board primary-test.kicad_pcb from above]

Board: 2 copper layers, 86.0 x 104.0 mm, 54 parts (0 on the bottom side), 34 nets, no tracks yet.

Parts:
BT1, BT2, BT3: BAT-TH_BH-21700-A5BJ001
C1, C2, C3, C4, C8: C0402
C5, C6, C7: C0805
D1, D2, D3: SOD-123_L2.8-W1.8-LS3.7-RD
F1, F2, F3: FUSE-SMD_L6.1-W2.7
H1, H2, H3, H4: M3 clearance 3.4 mm; MountingHole_M3_3.4mm
Q1, Q2: PDFN-8_L3.3-W3.3-P0.65-BL
R1, R2, R6, R7, R8, R9, R10, R11, R12: R0402
R3, R4, R5: R1206
R13: R2512
TP1, TP2, TP3, TP14, TP15, TP16, TP17: WirePadSignal
TP4, TP5, TP6, TP7, TP8, TP9, TP10, TP11, TP12, TP13: WirePad18
U1: QFN-24_L4.0-W4.0-P0.50-BL-EP2.6

Connections:
1: BT1.1, F1.1
2: C1.1, C2.2, R3.2, U1.21, U1.22
ALRT: R1.2, U1.7
AOLDO: R2.1, U1.12
BATTS: C3.1, R5.2, U1.24
CHG: R6.1, U1.3
CP: C5.1, U1.2
D: Q1.5, Q1.6, Q1.7, Q1.8, Q1.9, Q2.5, Q2.6, Q2.7, Q2.8, Q2.9
DIS: R7.1, U1.4
G: C4.1, Q1.4, R6.2
PCKP: R8.2, U1.6
PFAIL: R9.1, U1.11
SCL_DOD: R10.2, U1.8
SDA_DQ: R11.2, U1.9
carrier-1: BT2.1, F2.1
carrier-1-1: BT3.1, F3.1
carrier-1-2: D1.1, R1.1, TP3.1
carrier-1-3: D2.1, R10.1, TP6.1
carrier-1-4: D3.1, R11.1, TP7.1
carrier-contact: TP2.1, TP5.1
carrier-contact-1: BT1.2, C1.2, C6.2, C7.2, C8.2, R2.2, R9.2, R13.1, TP12.1, TP14.1, TP16.1, U1.15, U1.18, U1.19, U1.20, U1.25
carrier-contact-2: TP15.1, U1.10
carrier-contact-3: TP17.1, U1.16
carrier.protection-1: C5.2, C8.1, R12.2, U1.1
carrier.protection-1-1: C6.1, U1.17
carrier.protection-1-2: C7.1, U1.13
carrier.protection-2: C2.1, C3.2, R4.2, U1.23
carrier.protection-G: Q2.4, R7.2
contact: TP1.1, TP4.1
hv: Q2.1, Q2.2, Q2.3, R8.1, TP9.1
junction1: BT2.2, F1.2, R3.1, TP10.1
junction2: BT3.2, F2.2, R4.1, TP11.1
lv: D1.2, D2.2, D3.2, R13.2, TP8.1, U1.14
raw_top: C4.2, F3.2, Q1.1, Q1.2, Q1.3, R5.1, R12.1, TP13.1
