0x63616c/smart-blinds/hw/routing/blind-main/main-routed.kicad_pcb

## KiCad design hw/routing/blind-main/main-routed.kicad_pcb (2026-10-20)

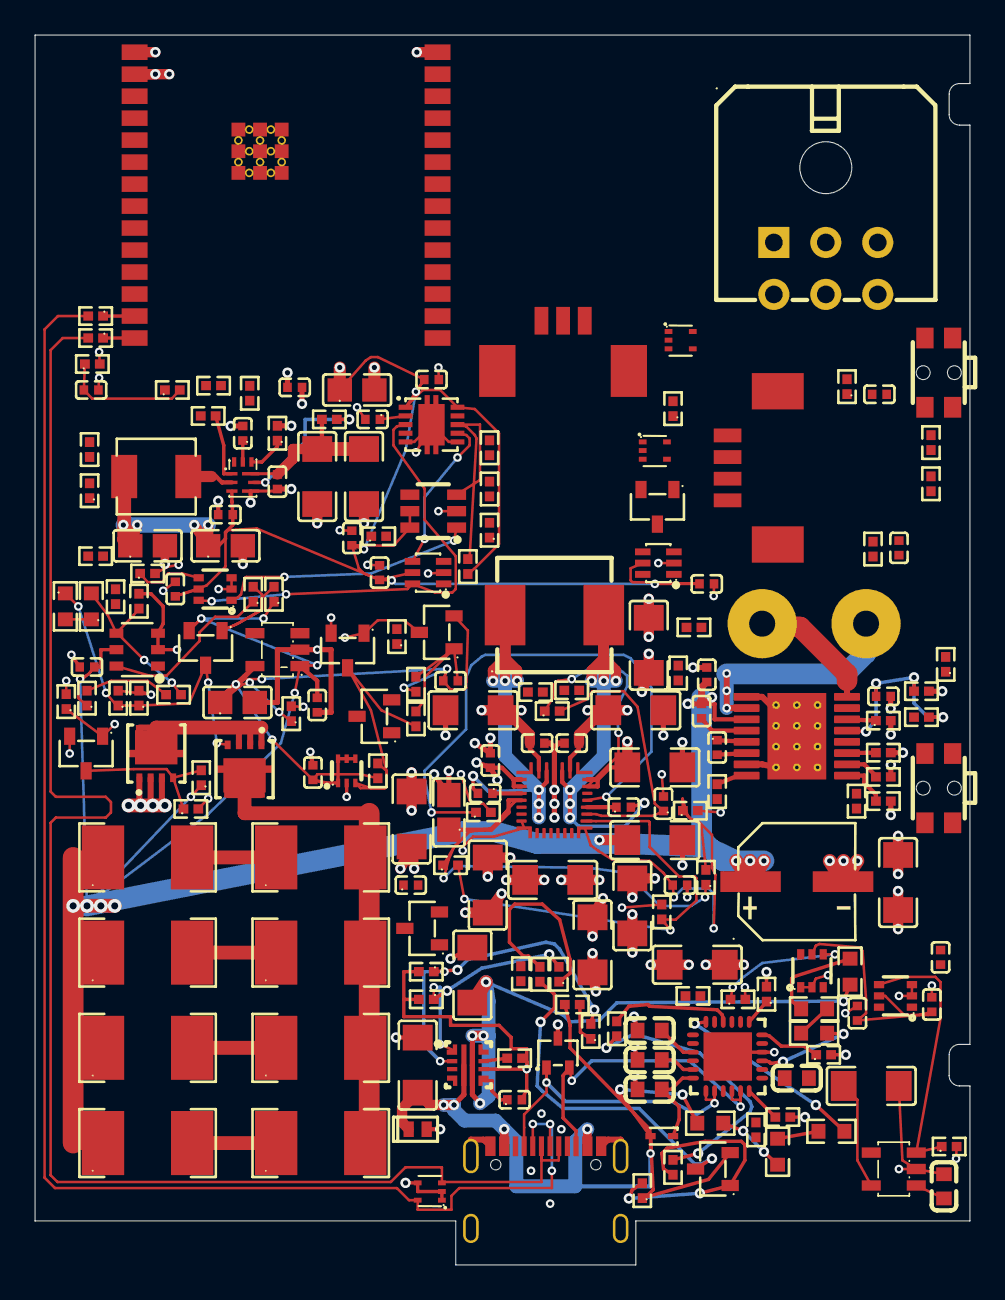
[picture p61: board main-routed.kicad_pcb from above]

Board: 4 copper layers, 54.0 x 71.0 mm, 196 parts (0 on the bottom side), 110 nets.

Parts:
C1, C2, C6, C7, C9, C10, C11, C12, C16, C17, C18, C19, C20, C40, C42, C49, C54: C1206
C3, C4, C5, C8, C13, C15, C21, C22, C23, C24, C26, C27, C28, C29, C30, C32, C33, C34, C35, C36, C37, C38, C41, C45, C46, C50, C52, C55, C56, C57, C58, C59, C60: C0402
C14, C25, C39, C43, C44: C0805
C31: CAP-SMD_BD6.3-L6.6-W6.6-LS7.3-FD
C47, C48, C51, C53, C61: C0603
D1, D2, D6: SOT-553-5_L1.6-W1.2-P0.50-LS1.6-TL-1
D3: SOD-523_L1.2-W0.8-LS1.6-RD
D4: SOT-323-3_L2.1-W1.3-P1.32-LS2.1-BR
D5: DFN1610-2_L1.6-W1.0-P1.05-RD
J1: CONN-TH_43045-0600
J2: CONN-SMD_4P-P1.25_53261-0471
J3: CONN-TH_532610371
L1: IND-SMD_L7.2-W6.6_GPSR07X0
L2: IND-SMD_L4.4-W4.2
Q1, Q2, Q3, Q4, Q5, Q7, Q8, Q10: SOT-23-3_L2.9-W1.3-P1.90-LS2.4-BR
Q6, Q9: PDFN-8_L3.3-W3.3-P0.65-BL
R1, R2, R3, R4, R5, R6, R7, R8, R9, R10, R11, R12, R13, R14, R15, R16, R17, R18, R19, R20, R21, R22, R23, R24, R25, R26, R27, R28, R29, R30, R31, R32, R33, R34, R35, R36, R37, R38, R39, R40, R41, R44, R45, R46, R47, R48, R49, R50, R51, R52, R56, R57, R58, R62, R63, R65, R66, R67, R68, R77, R78, R79, R80, R81, R82, R83, R84, R85, R86, R87, R88, R89, R90, R91, R92, R93: R0402
R42, R43, R69, R70, R71, R72, R73, R74: R2512
R53, R54, R55, R59, R60, R61, R75, R76: R0603
SW1, SW2: SW-SMD_4P-L3.5-W3.0-P1.6-LS4.6
TP1, TP2: WirePad18
U1: QFN-29_L4.0-W4.0-P0.40-TL-BQ25792RQMR
U2, U14: SOT-363_L2.0-W1.3-P0.65-LS2.1-BR
U3: WIRELM-SMD_ESP32-C6-WROOM-1
U4: HTSSOP-16_L5.0-W4.4-P0.65-LS6.4-BL-EP
U5: TSOT-23-6_L2.9-W1.6-P0.95-LS2.8-BR
U6, U13: SOT-23-5_L3.0-W1.7-P0.95-LS2.8-BR
U7: SOT-5X3-6_W1.6-L1.2-P0.50-LS1.6-BL
U8, U12, U17: SC-70-6_L2.0-W1.3-P0.65-LS2.1-BR
U9: VQFN-HR-9_L2.0-W1.5-P0.50-TL
U10: VQFN-10_L2.0-W2.0-P0.45-TL
U11: QFN-24_L4.0-W4.0-P0.50-BL-EP2.8
U15: SOT-23-6_L2.9-W1.6-P0.95-LS2.8-BR
U16: VSON-10_L3.0-W3.0-P0.50-TL-EP
USBC1: HRO_TYPE_C_31_M_12

Connections:
1: C4.1, U1.4
2: C5.2, L1.2, U1.26
4: U2.4, U3.7
6: U2.6, U3.6
10: R29.2, U3.10
ALERT: R63.2, U1.21, U3.24, U11.19
BATP: C3.1, R1.2, U1.18
C: Q3.3, R66.1
CC2: D4.2, U11.4, U11.5, USBC1.B5
CE_n: Q1.3, R2.2, U1.13
CPH: C32.1, U4.13
CPL: C32.2, U4.14
CWD: C59.1, U16.2
D: Q10.3, R32.2, U3.19, U4.4
DISCH: R55.2, U11.9
DVDT: C50.1, U10.7
EN: R68.1, U12.4, U13.3
G: Q4.1, Q7.1, Q8.3, Q10.1, R88.1
ILIM_HIZ: R4.1, R5.2, U1.17
ILM: R52.1, U10.9
MODE_S_CONF: R45.1, U9.7
MR: R93.2, U15.3, U16.8
OUTB: R40.1, U5.6
PG: R46.2, U9.1
PMODE: R35.2, U4.16
PROG: R8.1, U1.20
RESET: R62.1, U11.6
SCL: J1.4, R27.2, U1.14, U3.12, U11.7
SDA: J1.3, R28.2, U1.15, U3.11, U11.8
SDRV: C15.1, U1.24
SS_TR: C46.1, U9.8
SW: L2.1, U9.2
VBUS_EN_SNK: R50.2, U11.16
VBUS_VS_DISCH: R61.2, U11.18
VCP: C33.1, U4.12
WDI: U14.4, U16.7
Y: R38.1, R39.1, U4.3, U17.4
allow_n-line: R24.2, U3.21, U12.6
boot_n: R19.2, U3.15
c_1v2-1: C47.1, U11.21
c_2v7-1: C48.1, U11.23
c_adc-1: C24.1, R14.2, R15.1, U3.27
c_boot1-1: C4.2, L1.1, U1.28
c_boot2-1: C5.1, U1.19
c_down-1: C27.1, R22.2, SW1.1, SW1.2, U3.9
c_hot_filter-1: C37.1, C39.1, C55.1, Q8.2, R80.1, R81.1, R83.1, U6.5, U7.1, U7.4, U7.5, U7.6
c_pmid1-1: C9.1, C10.1, C11.1, C12.1, C13.1, U1.29
c_ref-1: C34.1, R36.2, R37.1, U4.5
c_regn-1: C14.1, R2.1, R5.1, R10.1, U1.5
c_up-1: C30.1, R30.2, SW2.1, SW2.2, U3.8
c_vdd-1: C51.1, D3.1, U11.24
channel_a: D1.3, J2.3, R12.1, R13.2
channel_b: D1.5, J2.4, R17.1, R18.2
charger-1: Q1.1, Q2.3, R3.1
charger-1-1: Q2.1, R6.2, R7.1
connector-1: D4.1, U11.1, U11.2, USBC1.A5
controller-1: R11.1, R12.2, U2.1
controller-1-1: R16.1, R17.2, U2.3
controller-1-2: R21.1, U3.13
controller-1-3: R23.1, U3.14
controller-2: C29.1, R25.2, R26.2, U3.26
current_raw: R14.1, R31.1, U4.6
efuse-1: R65.1, R67.2, U10.1
encoder-output-hv: C54.1, J2.2, R13.1, R18.1, U13.5
heartbeat-line: R92.2, U3.25, U14.3
home_contact_n: D6.3, D6.5, J3.3, R25.1
host_logic-hv: C23.1, C25.1, C26.1, C28.1, C43.1, C44.1, C45.1, C52.1, C56.1, C57.1, C58.1, C60.1, C61.1, L2.2, Q2.2, R7.2, R19.1, R20.1, R22.1, R24.1, R26.1, R27.1, R28.1, R29.1, R30.1, R32.1, R35.1, R36.1, R46.1, R63.1, R89.1, R90.1, R92.1, R93.1, U2.5, U3.2, U8.5, U9.3, U11.22, U12.5, U14.5, U15.5, U15.6, U16.1, U16.10, U17.5
hv: C1.1, C2.1, C31.1, C33.2, C35.1, C36.1, C38.1, J1.1, Q5.2, R1.1, R41.1, R42.1, R69.1, R71.1, R73.1, R84.1, R86.1, U1.22, U1.23, U4.11, U5.5, U6.1
in1-1: R33.1, U3.16, U4.1
in2-line: R34.1, U3.17, U4.2
line: R6.1, R20.2, U3.20
logic_supply-EN: R44.2, U9.5
lv: C1.2, C2.2, C3.2, C6.2, C7.2, C8.2, C9.2, C10.2, C11.2, C12.2, C13.2, C14.2, C15.2, C16.2, C17.2, C18.2, C19.2, C20.2, C21.2, C22.2, C23.2, C24.2, C25.2, C26.2, C27.2, C28.2, C29.2, C30.2, C31.2, C34.2, C35.2, C36.2, C38.2, C39.2, C40.2, C41.2, C42.2, C43.2, C44.2, C45.2, C46.2, C47.2, C48.2, C49.2, C50.2, C51.2, C52.2, C53.2, C54.2, C55.2, C56.2, C57.2, C58.2, C59.2, C60.2, C61.2, D1.1, D1.2, D1.4, D2.1, D2.2, D2.4, D4.3, D5.2, D6.1, D6.2, D6.4, J1.2, J1.6, J2.1, J3.1, Q1.2, Q4.2, Q7.2, Q9.1, Q9.2, Q9.3, Q10.2, R3.2, R4.2, R8.2, R9.2, R11.2, R15.2, R16.2, R31.2, R33.2, R34.2, R37.2, R38.2, R39.2, R45.2, R47.2, R48.2, R52.2, R56.2, R62.2, R65.2, R68.2, R77.2, R78.2, R81.2, R82.2, R85.2, R88.2, R91.2, SW1.3, SW1.4, SW2.3, SW2.4, U1.10, U1.11, U1.27, U2.2, U3.1, U3.28, U3.29, U3.30, U3.31, U3.32, U3.33, U3.34, U3.35, U3.36, U3.37, U4.9, U4.15, U4.17, U5.2, U5.3, U6.2, U7.2, U8.2, U8.3, U9.4, U10.8, U11.10, U11.25, U12.2, U12.3, U13.2, U14.2, U15.2, U16.5, U16.6, U16.11, U17.1, U17.2, USBC1.1, USBC1.2, USBC1.3, USBC1.4, USBC1.A1B12, USBC1.B1A12
motor_a: TP1.1, U4.8
motor_b: TP2.1, U4.10
motor_request_n-line: R89.2, U3.18, U14.1
motor_sleep_n-Y: R91.1, U8.4, U17.3
pack_ntc: C22.1, J1.5, R9.1, R10.2, U1.16
pd-1: R47.1, U11.12
pd-1-1: R48.1, U11.13
q_drive-1: Q5.3, Q6.4, R75.1, R77.1, R78.1
q_enable-1: Q3.1, R49.1, R51.2
r_base1-1: R49.2, R50.1
r_dump1a-1: R42.2, R43.1
r_dump2a-1: R69.2, R70.1
r_dump3a-1: R71.2, R72.1
r_dump4a-1: R73.2, R74.1
r_feedback1-1: R75.2, R76.1
r_out_dis1-1: R53.2, R54.1
r_out_dis2-1: R54.2, R55.1
r_ov_top1-1: R57.2, R58.1
r_raw_dis1-1: R59.2, R60.1
r_raw_dis2-1: R60.2, R61.1
r_threshold_top1-1: R86.2, R87.1
r_uv_top1-1: R66.2, R67.1
raw-hv: C49.1, D3.2, D5.1, Q3.2, R51.1, R57.1, R59.1, U10.5, USBC1.A4B9, USBC1.B4A9
regen-2: C37.2, Q8.1, R79.2, R80.2
regen-2-1: Q6.5, Q6.6, Q6.7, Q6.8, Q6.9, R43.2, R70.2, R72.2, R74.2
regen-2-2: Q5.1, R40.2, R41.2
reset_n: R90.2, U3.3, U8.1, U12.1, U15.1
series_mid: Q6.1, Q6.2, Q6.3, Q9.5, Q9.6, Q9.7, Q9.8, Q9.9
source-hv: C16.1, C17.1, C18.1, C19.1, C20.1, C21.1, C40.1, C41.1, C42.1, C53.1, R44.1, U1.25, U9.6, U13.1
supervision-6: U8.6, U14.6, U16.3
thermal_gate: Q4.3, Q9.4, R82.1, R84.2
thermal_ok: Q7.3, R79.1, R83.2, U7.3, U17.6
threshold: R76.2, R85.1, R87.2, U5.4
usb-2: R56.1, R58.2, U10.2
usb-output-hv: C6.1, C7.1, C8.1, R53.1, U1.2, U1.3, U1.8, U1.9, U10.6
usb_dm: D2.5, R21.2, USBC1.A7, USBC1.B7
usb_dp: D2.3, R23.2, USBC1.A6, USBC1.B6
