0x63616c/smart-blinds/hw/layouts/blind-controller/motor-test/motor-test.kicad_pcb

## KiCad design hw/layouts/blind-controller/motor-test/motor-test.kicad_pcb (2026-10-20)

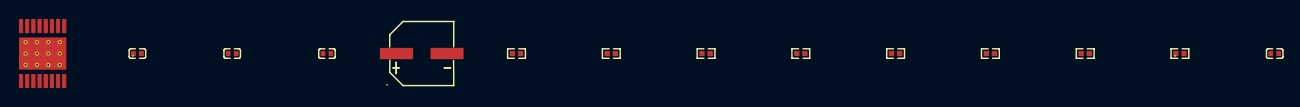
[picture p62: board motor-test.kicad_pcb from above]

Board: 2 copper layers, 14 parts (0 on the bottom side), 13 nets, no tracks yet.

Parts:
C1: CAP-SMD_BD6.3-L6.6-W6.6-LS7.3-FD
C2, C3, C4, C5: C0402
R1, R2, R3, R4, R5, R6, R7, R8: R0402
U1: HTSSOP-16_L5.0-W4.4-P0.65-LS6.4-BL-EP

Connections:
1: C4.1, R6.2, R7.1, U1.5
CPH: C2.1, U1.13
CPL: C2.2, U1.14
IPROPI: R1.1, U1.6
PMODE: R5.2, U1.16
VCP: C3.1, U1.12
hv: R2.1, R5.1, R6.1
in1-1: R3.1, U1.1
in2-1: R4.1, U1.2
lv: C1.2, C4.2, C5.2, R1.2, R3.2, R4.2, R7.2, R8.2, U1.9, U1.15, U1.17
nFAULT: R2.2, U1.4
nSLEEP: R8.1, U1.3
pack-hv: C1.1, C3.2, C5.1, U1.11
