0x63616c/smart-blinds/hw/layouts/blind-regulator/regulator-test/regulator-test.kicad_pcb

## KiCad design hw/layouts/blind-regulator/regulator-test/regulator-test.kicad_pcb (2026-10-20)

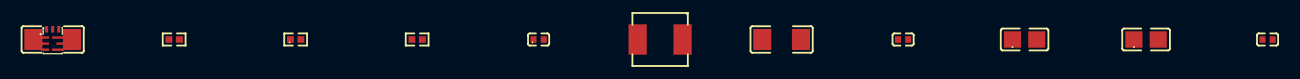
[picture p63: board regulator-test.kicad_pcb from above]

Board: 2 copper layers, 12 parts (0 on the bottom side), 8 nets, no tracks yet.

Parts:
C1, C5, C6: C0402
C2, C7: C1206
C3, C4: C0805
L1: IND-SMD_L4.4-W4.2
R1, R2, R3: R0402
U1: VQFN-HR-9_L2.0-W1.5-P0.50-TL

Connections:
EN: R1.2, U1.5
MODE_S_CONF: R2.1, U1.7
PG: R3.2, U1.1
SS_TR: C6.1, U1.8
SW: L1.1, U1.2
hv: C1.1, C2.1, C7.1, R1.1, U1.6
logic-hv: C3.1, C4.1, C5.1, L1.2, R3.1, U1.3
lv: C1.2, C2.2, C3.2, C4.2, C5.2, C6.2, C7.2, R2.2, U1.4
