0x63616c/smart-blinds/hw/layouts/blind-assembly/controller-test/controller-test.kicad_pcb

## KiCad design hw/layouts/blind-assembly/controller-test/controller-test.kicad_pcb (2026-10-20)

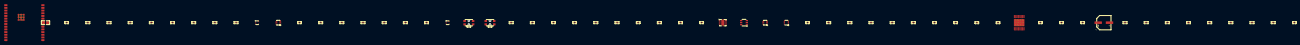
[picture p64: board controller-test.kicad_pcb from above]

Board: 2 copper layers, 61 parts (0 on the bottom side), 41 nets, no tracks yet.

Parts:
C1, C3, C4, C5, C6, C7, C9, C10, C11, C12, C13, C14, C15, C16, C17: C0402
C2: C0805
C8: CAP-SMD_BD6.3-L6.6-W6.6-LS7.3-FD
D1, D2: SOT-553-5_L1.6-W1.2-P0.50-LS1.6-TL-1
R1, R2, R3, R4, R5, R6, R7, R8, R9, R10, R11, R12, R13, R14, R15, R16, R17, R18, R19, R20, R21, R22, R23, R24, R25, R26, R27, R28, R29, R30, R31, R32, R33: R0402
SW1, SW2: SW-SMD_4P-L3.5-W3.0-P1.6-LS4.6
U1, U5: SOT-363_L2.0-W1.3-P0.65-LS2.1-BR
U2: WIRELM-SMD_ESP32-C6-WROOM-1
U3: HTSSOP-16_L5.0-W4.4-P0.65-LS6.4-BL-EP
U4: SC-70-6_L2.0-W1.3-P0.65-LS2.1-BR
U6: SOT-23-6_L2.9-W1.6-P0.95-LS2.8-BR
U7: VSON-10_L3.0-W3.0-P0.50-TL-EP

Connections:
1: C1.1, R4.2, R5.1, U2.27
2: C6.1, R15.2, R16.2, U2.26
4: U1.4, U2.7
6: U1.6, U2.6
10: R19.2, U2.10
11: R18.2, U2.11
12: R17.2, U2.12
CPH: C9.1, U3.13
CPL: C9.2, U3.14
CWD: C16.1, U7.2
MR: R33.2, U6.3, U7.8
PMODE: R25.2, U3.16
VCP: C10.1, U3.12
WDI: U5.4, U7.7
boot_n: R9.2, U2.15
c_down-1: C4.1, R12.2, SW1.1, SW1.2, U2.9
c_ref-1: C11.1, R26.2, R27.1, U3.5
c_up-1: C7.1, R20.2, SW2.1, SW2.2, U2.8
charge_allow_n-2: R10.2, U2.20
controller-1: R1.1, R2.2, U1.1
controller-1-1: R6.1, R7.2, U1.3
controller-1-2: R11.1, U2.13
controller-1-3: R13.1, U2.14
current_raw: R4.1, R21.1, U3.6
encoder_a_raw: D1.3, R2.1, R3.2
encoder_allow_n-2: R14.2, U2.21
encoder_b_raw: D1.5, R7.1, R8.2
encoder_rail-hv: R3.1, R8.1
heartbeat-line: R32.2, U2.25, U5.3
hv: C2.1, C3.1, C5.1, C13.1, C14.1, C15.1, C17.1, R9.1, R10.1, R12.1, R14.1, R16.1, R17.1, R18.1, R19.1, R20.1, R22.1, R25.1, R26.1, R29.1, R30.1, R32.1, R33.1, U1.5, U2.2, U4.5, U5.5, U6.5, U6.6, U7.1, U7.10
in1-1: R23.1, U2.16, U3.1
line: R24.1, U2.17, U3.2
lv: C1.2, C2.2, C3.2, C4.2, C5.2, C6.2, C7.2, C8.2, C11.2, C12.2, C13.2, C14.2, C15.2, C16.2, C17.2, D1.1, D1.2, D1.4, D2.1, D2.2, D2.4, R1.2, R5.2, R6.2, R21.2, R23.2, R24.2, R27.2, R28.2, R31.2, SW1.3, SW1.4, SW2.3, SW2.4, U1.2, U2.1, U2.28, U2.29, U2.30, U2.31, U2.32, U2.33, U2.34, U2.35, U2.36, U2.37, U3.9, U3.15, U3.17, U4.2, U4.3, U5.2, U6.2, U7.5, U7.6, U7.11
motor_request_n-line: R29.2, U2.18, U5.1
motor_sleep_n-1: R28.1, R31.1, U3.3, U4.4
nFAULT: R22.2, U2.19, U3.4
pack-hv: C8.1, C10.2, C12.1, U3.11
reset_n: R30.2, U2.3, U4.1, U6.1
supervision-6: U4.6, U5.6, U7.3
usb_dm: D2.5, R11.2
usb_dp: D2.3, R13.2
