0x63616c/smart-blinds/hw/layouts/blind-regen/regen-test/regen-test.kicad_pcb

## KiCad design hw/layouts/blind-regen/regen-test/regen-test.kicad_pcb (2026-10-20)


Board: 2 copper layers, 38 parts (0 on the bottom side), 19 nets, no tracks yet.

Parts:
C1, C2, C4, C5: C0402
C3: C0805
Q1, Q2, Q4, Q5: SOT-23-3_L2.9-W1.3-P1.90-LS2.4-BR
Q3, Q6: PDFN-8_L3.3-W3.3-P0.65-BL
R1, R2, R13, R14, R15, R16, R17, R18, R19, R20, R21, R22, R23, R24: R0402
R3, R4, R5, R6, R7, R8, R9, R10: R2512
R11, R12: R0603
U1: TSOT-23-6_L2.9-W1.6-P0.95-LS2.8-BR
U2: SOT-23-5_L3.0-W1.7-P0.95-LS2.8-BR
U3: SOT-5X3-6_W1.6-L1.2-P0.50-LS1.6-BL

Connections:
1: C3.1, C4.1, C5.1, Q5.2, R16.1, R17.1, R19.1, U2.5, U3.1, U3.4, U3.5, U3.6
2: C5.2, Q5.1, R15.2, R16.2
G: Q1.1, Q4.1, Q5.3, R24.1
OUTB: R1.1, U1.6
hv: C1.1, C2.1, Q2.2, R2.1, R3.1, R5.1, R7.1, R9.1, R20.1, R22.1, U1.5, U2.1
lv: C1.2, C2.2, C3.2, C4.2, Q1.2, Q4.2, Q6.1, Q6.2, Q6.3, R13.2, R14.2, R17.2, R18.2, R21.2, R24.2, U1.2, U1.3, U2.2, U3.2
regen-1: Q2.3, Q3.4, R11.1, R13.1, R14.1
regen-1-1: R3.2, R4.1
regen-1-2: R5.2, R6.1
regen-1-3: R7.2, R8.1
regen-1-4: R9.2, R10.1
regen-1-5: R11.2, R12.1
regen-1-6: R22.2, R23.1
regen-2: Q3.5, Q3.6, Q3.7, Q3.8, Q3.9, R4.2, R6.2, R8.2, R10.2
regen-2-1: Q2.1, R1.2, R2.2
series_mid: Q3.1, Q3.2, Q3.3, Q6.5, Q6.6, Q6.7, Q6.8, Q6.9
thermal_gate: Q1.3, Q6.4, R18.1, R20.2
thermal_ok: Q4.3, R15.1, R19.2, U3.3
threshold: R12.2, R21.1, R23.2, U1.4
