0x63616c/smart-blinds/hw/layouts/blind-supervisor/supervisor-test/supervisor-test.kicad_pcb

## KiCad design hw/layouts/blind-supervisor/supervisor-test/supervisor-test.kicad_pcb (2026-10-20)

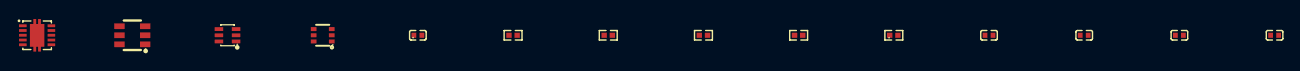
[picture p66: board supervisor-test.kicad_pcb from above]

Board: 2 copper layers, 14 parts (0 on the bottom side), 10 nets, no tracks yet.

Parts:
C1, C2, C3, C4, C5: C0402
R1, R2, R3, R4, R5: R0402
U1: SC-70-6_L2.0-W1.3-P0.65-LS2.1-BR
U2: SOT-363_L2.0-W1.3-P0.65-LS2.1-BR
U3: SOT-23-6_L2.9-W1.6-P0.95-LS2.8-BR
U4: VSON-10_L3.0-W3.0-P0.50-TL-EP

Connections:
1: R1.2, U2.1
2: R4.2, U2.3
6: U1.6, U2.6, U4.3
CWD: C4.1, U4.2
MR: R5.2, U3.3, U4.8
WDI: U2.4, U4.7
Y: R3.1, U1.4
hv: C1.1, C2.1, C3.1, C5.1, R1.1, R2.1, R4.1, R5.1, U1.5, U2.5, U3.5, U3.6, U4.1, U4.10
lv: C1.2, C2.2, C3.2, C4.2, C5.2, R3.2, U1.2, U1.3, U2.2, U3.2, U4.5, U4.6, U4.11
reset_n: R2.2, U1.1, U3.1
