0x63616c/smart-blinds/hw/layouts/pd12v6mini_manual/pd12v6mini_manual.kicad_pcb

## KiCad design hw/layouts/pd12v6mini_manual/pd12v6mini_manual.kicad_pcb (2026-10-14)

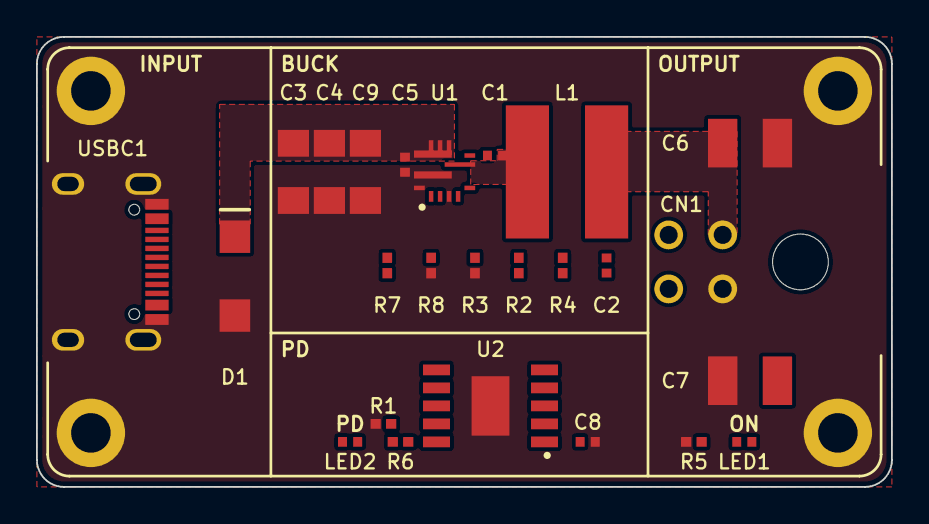
[picture p67: board pd12v6mini_manual.kicad_pcb from above]

Board: 4 copper layers, 47.5 x 25.0 mm, 29 parts (0 on the bottom side), 16 nets, no tracks yet.

Parts:
C1, C2, C5, C8: C0402
C3, C4, C9: C1206
C6, C7: C1210
CN1: CONN-TH_0430450400
D1: SMA_L4.4-W2.6-LS5.0-RD
H1, H2, H3, H4: M2_HOLE
L1: IND-SMD_PSTMAA666460-6R8MB
LED1: LED0402-RD_GREEN
LED2: LED0402-RD
R1, R2, R3, R4, R5, R6, R7, R8: R0402
U1: VQFN-HR-10_L3.0-W3.0_RPA
U2: ESSOP-10_L4.9-W3.9-P1.0-LS6.0-TL-EP
USBC1: USB-C_SMD-TYPE-C-31-M-12_1

Connections:
BOOT: C1.1, U1.7
CC1: U2.7, USBC1.A5
CC2: U2.6, USBC1.B5
CFG1: R1.1, U2.9
EN: R7.2, R8.1, U1.1
FB: R2.2, R3.1, R4.2, U1.2
FF: C2.2, R4.1
GND: C3.2, C4.2, C5.2, C6.2, C7.2, C8.2, C9.2, CN1.2, D1.2, H1.1, H2.1, H3.1, H4.1, R1.2, R3.2, R5.2, R8.2, U1.3, U1.9, U1.10, U2.11, USBC1.1, USBC1.2, USBC1.3, USBC1.4, USBC1.A1B12, USBC1.B1A12
LED_OUT_K: LED1.1, R5.1
LED_PD_K: LED2.1, R6.1
PG_n: R6.2, U2.10
SW: C1.2, L1.1, U1.6
USB_DN: CN1.4, USBC1.A7, USBC1.B7
USB_DP: CN1.3, USBC1.A6, USBC1.B6
VBUS: C3.1, C4.1, C5.1, C8.1, C9.1, D1.1, LED2.2, R7.1, U1.8, U2.1, U2.8, USBC1.A4B9, USBC1.B4A9
VOUT: C2.1, C6.1, C7.1, CN1.1, L1.2, LED1.2, R2.1
