0x63616c/smart-blinds/hw/schematics/blind-carrier/carrier-test.kicad_sch

## KiCad design hw/schematics/blind-carrier/carrier-test.kicad_sch (2026-10-20)

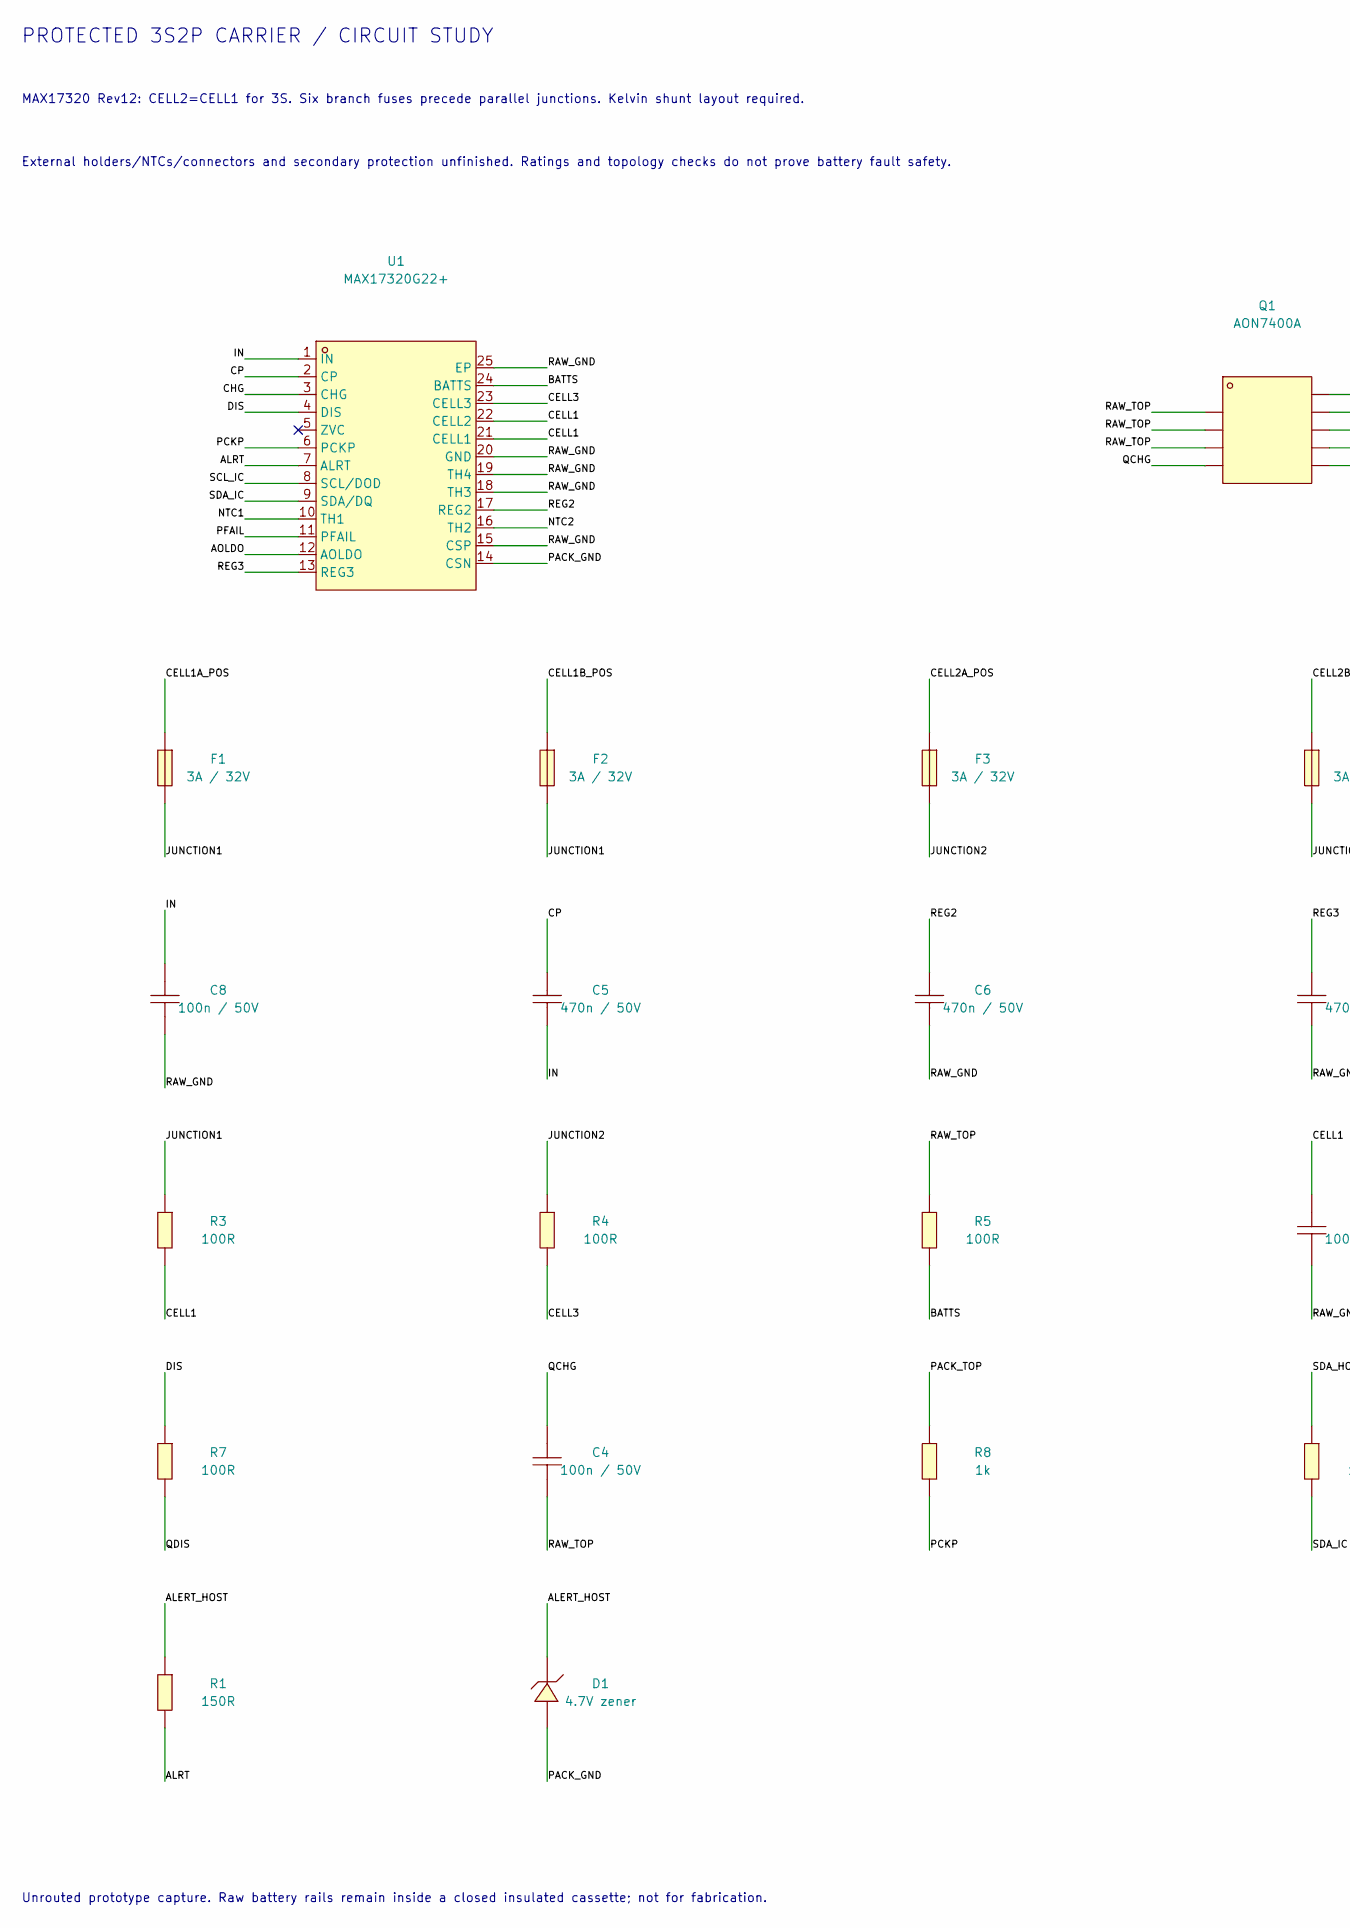
[picture p68: schematic carrier-test.kicad_sch, part in row 1, column 1]

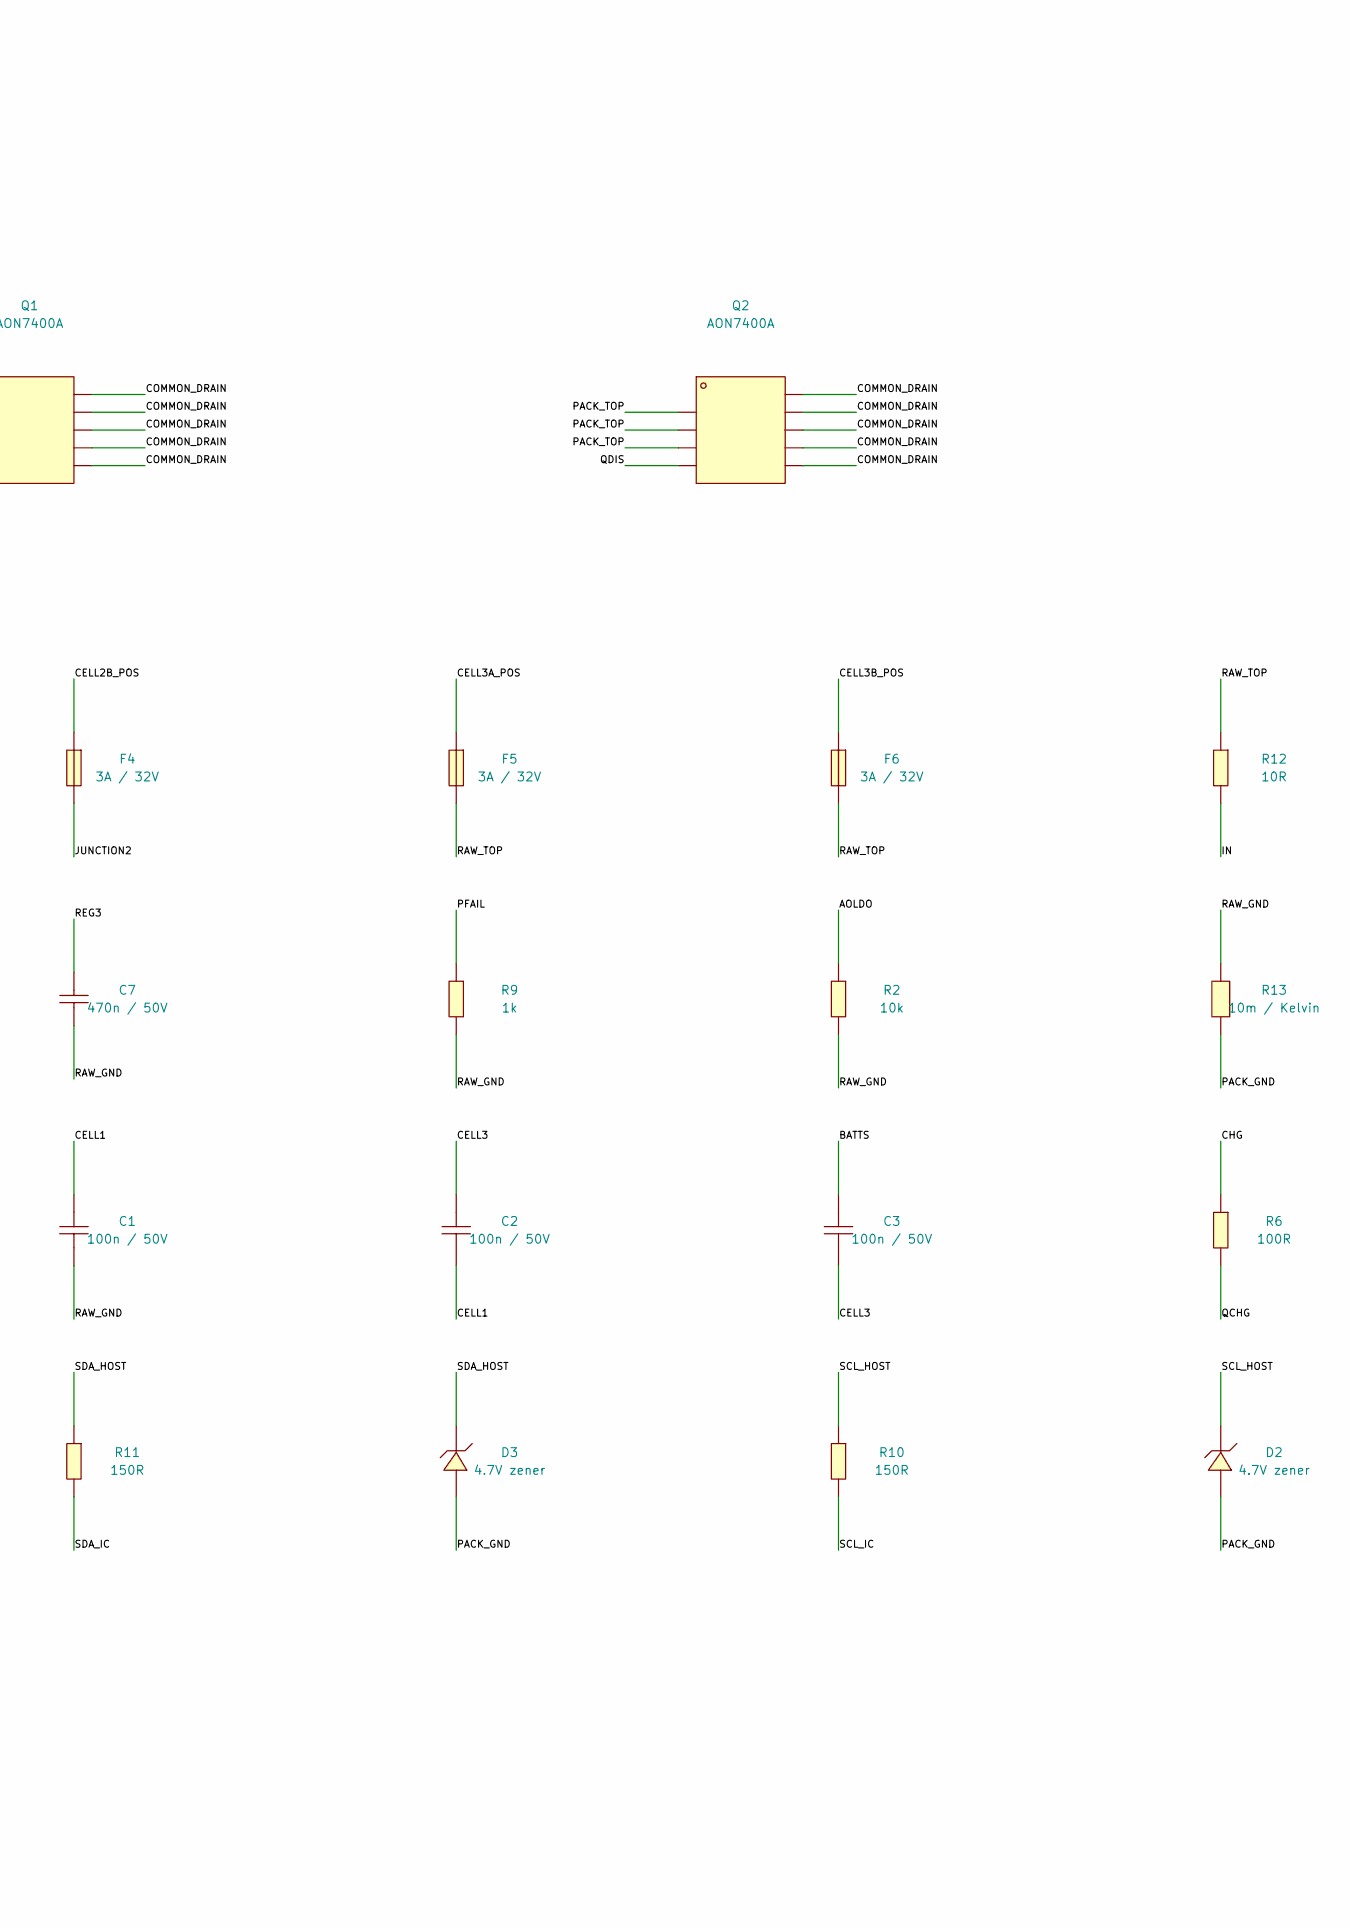
[picture p69: schematic carrier-test.kicad_sch, part in row 1, column 2]

Parts:
C1, C2, C3, C4, C8: 100n / 50V; C0402; MPN CL05B104KB54PNC; LCSC C307331
C5, C6, C7: 470n / 50V; C0805; MPN CL21B474KBFNNNE; LCSC C13967
D1, D2, D3: 4.7V zener; SOD-123_L2.8-W1.8-LS3.7-RD; MPN BZT52C4V7; LCSC C2116
F1, F2, F3, F4, F5, F6: 3A / 32V; FUSE-SMD_L6.1-W2.7; MPN 0451003.MRL; LCSC C13982
Q1, Q2: AON7400A; PDFN-8_L3.3-W3.3-P0.65-BL; MPN AON7400A; LCSC C85734
R1, R10, R11: 150R; R0402; MPN 0402WGF1500TCE; LCSC C25082
R2: 10k; R0402; MPN 0402WGF1002TCE; LCSC C25744
R3, R4, R5: 100R; R1206; MPN 1206W4F1000T5E; LCSC C17901
R6, R7: 100R; R0402; MPN 0402WGF1000TCE; LCSC C25076
R8, R9: 1k; R0402; MPN 0402WGF1001TCE; LCSC C11702
R12: 10R; R0402; MPN 0402WGF100JTCE; LCSC C25077
R13: 10m / Kelvin; R2512; MPN WSL2512R0100FEA; LCSC C844901
U1: MAX17320G22+; QFN-24_L4.0-W4.0-P0.50-BL-EP2.6; MPN MAX17320G22+; LCSC C2914309

Connections:
ALERT_HOST: D1.1 (K), R1.1
ALRT: R1.2, U1.7 (ALRT)
AOLDO: R2.1, U1.12 (AOLDO)
BATTS: C3.1, R5.2, U1.24 (BATTS)
CELL1: C1.1, C2.2, R3.2, U1.21 (CELL1), U1.22 (CELL2)
CELL1A_POS: F1.1
CELL1B_POS: F2.1
CELL2A_POS: F3.1
CELL2B_POS: F4.1
CELL3: C2.1, C3.2, R4.2, U1.23 (CELL3)
CELL3A_POS: F5.1
CELL3B_POS: F6.1
CHG: R6.1, U1.3 (CHG)
COMMON_DRAIN: Q1.5 (D), Q1.6 (D), Q1.7 (D), Q1.8 (D), Q1.9 (D), Q2.5 (D), Q2.6 (D), Q2.7 (D), Q2.8 (D), Q2.9 (D)
CP: C5.1, U1.2 (CP)
DIS: R7.1, U1.4 (DIS)
IN: C5.2, C8.1, R12.2, U1.1 (IN)
JUNCTION1: F1.2, F2.2, R3.1
JUNCTION2: F3.2, F4.2, R4.1
NTC1: U1.10 (TH1)
NTC2: U1.16 (TH2)
PACK_GND: D1.2 (A), D2.2 (A), D3.2 (A), R13.2, U1.14 (CSN)
PACK_TOP: Q2.1 (S), Q2.2 (S), Q2.3 (S), R8.1
PCKP: R8.2, U1.6 (PCKP)
PFAIL: R9.1, U1.11 (PFAIL)
QCHG: C4.1, Q1.4 (G), R6.2
QDIS: Q2.4 (G), R7.2
RAW_GND: C1.2, C6.2, C7.2, C8.2, R2.2, R9.2, R13.1, U1.15 (CSP), U1.18 (TH3), U1.19 (TH4), U1.20 (GND), U1.25 (EP)
RAW_TOP: C4.2, F5.2, F6.2, Q1.1 (S), Q1.2 (S), Q1.3 (S), R5.1, R12.1
REG2: C6.1, U1.17 (REG2)
REG3: C7.1, U1.13 (REG3)
SCL_HOST: D2.1 (K), R10.1
SCL_IC: R10.2, U1.8 (SCL/DOD)
SDA_HOST: D3.1 (K), R11.1
SDA_IC: R11.2, U1.9 (SDA/DQ)

Notes on the sheet:
PROTECTED 3S2P CARRIER / CIRCUIT STUDY
MAX17320 Rev12: CELL2=CELL1 for 3S. Six branch fuses precede parallel junctions. Kelvin shunt layout required.
External holders/NTCs/connectors and secondary protection unfinished. Ratings and topology checks do not prove battery fault safety.
Unrouted prototype capture. Raw battery rails remain inside a closed insulated cassette; not for fabrication.
