0x63616c/smart-blinds/hw/schematics/blind-charger/charger-test.kicad_sch

## KiCad design hw/schematics/blind-charger/charger-test.kicad_sch (2026-10-20)

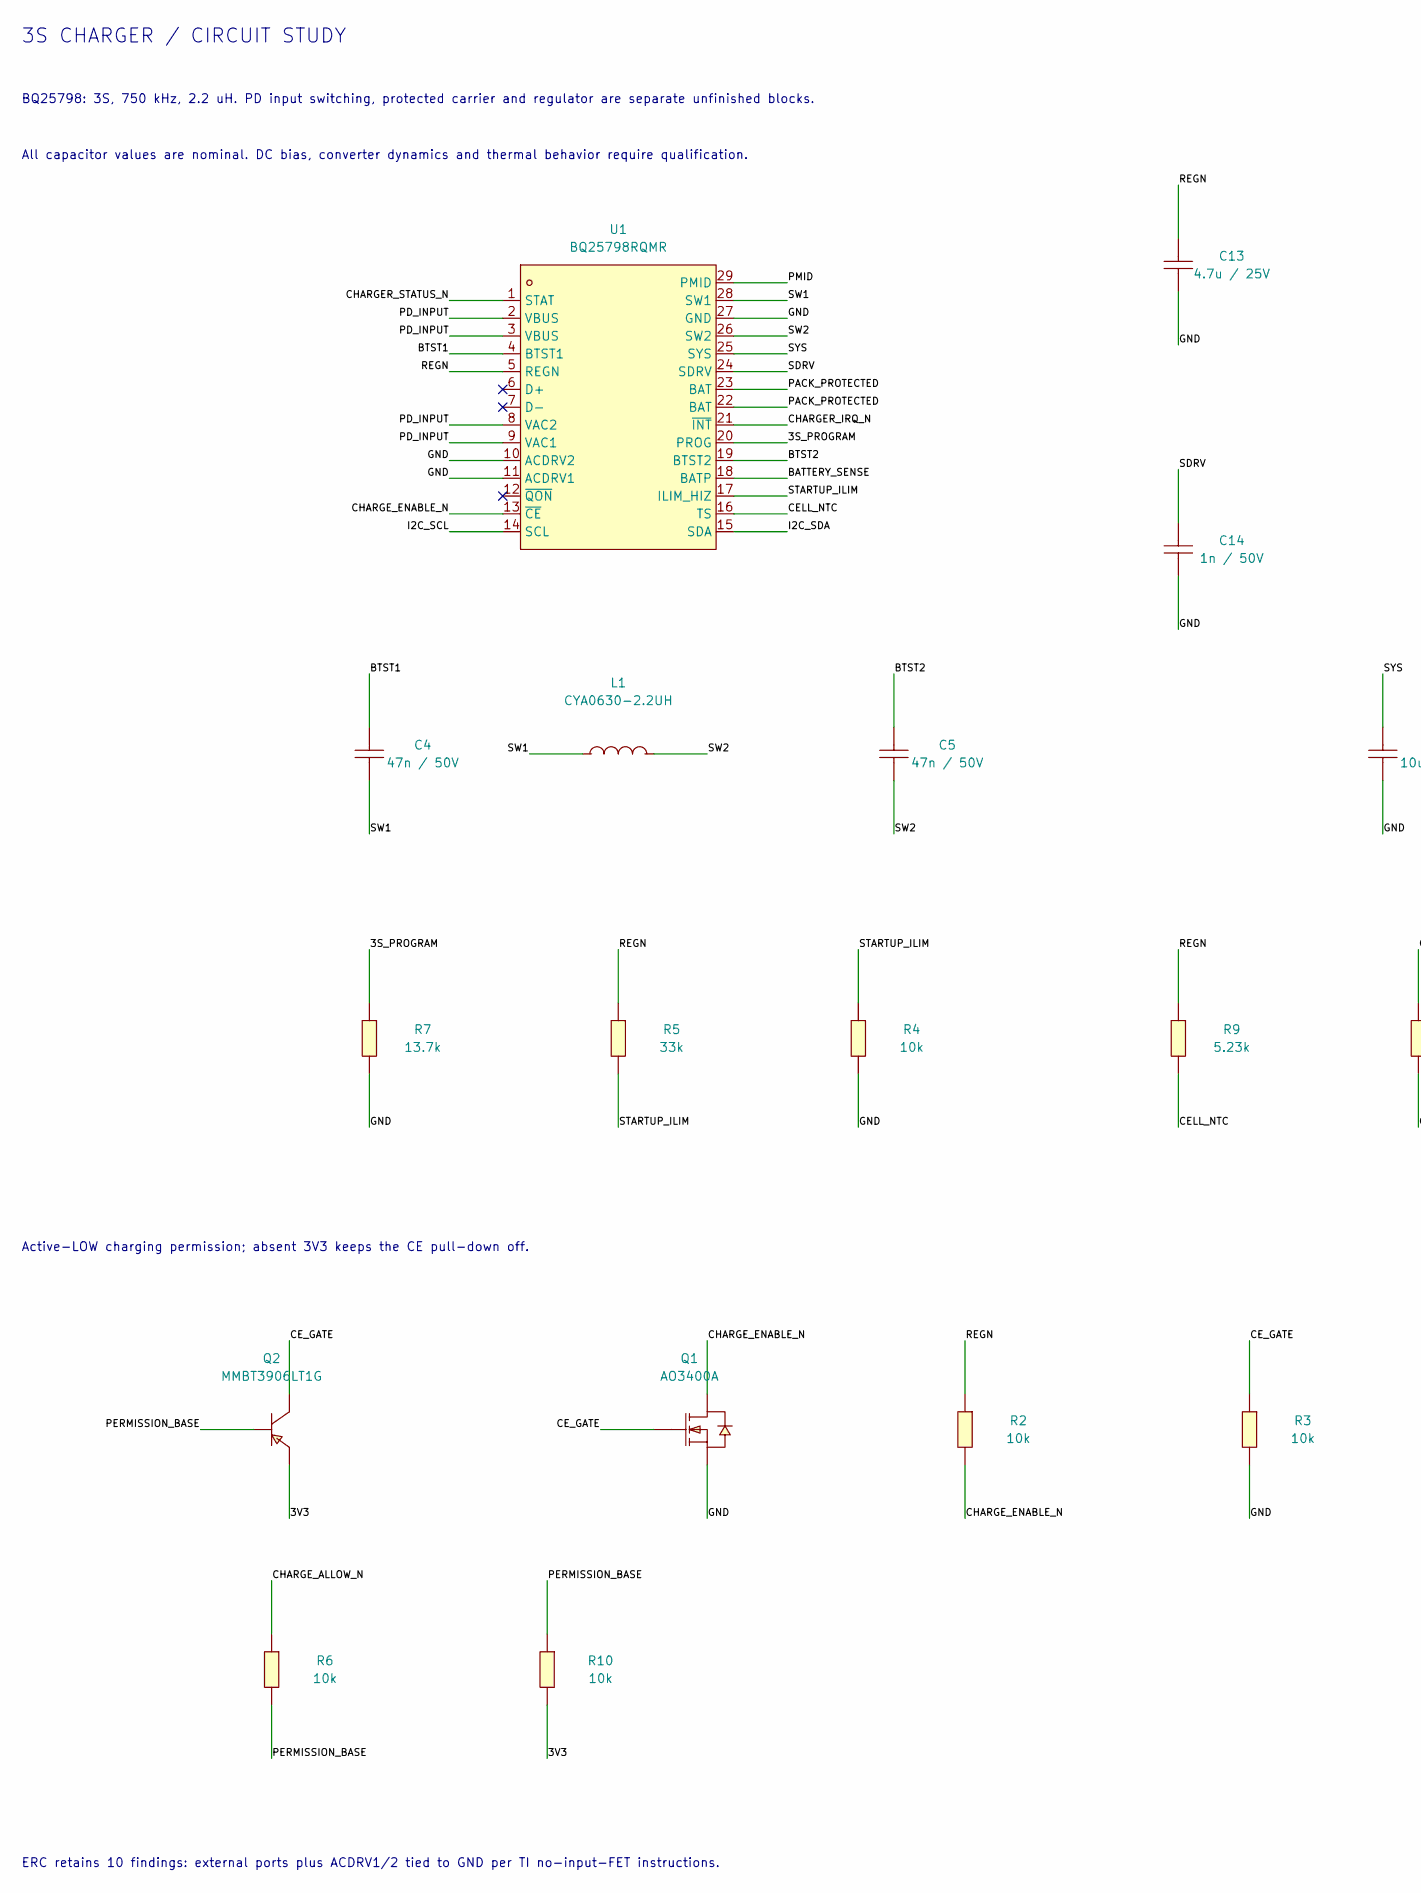
[picture p70: schematic charger-test.kicad_sch, part in row 1, column 1]

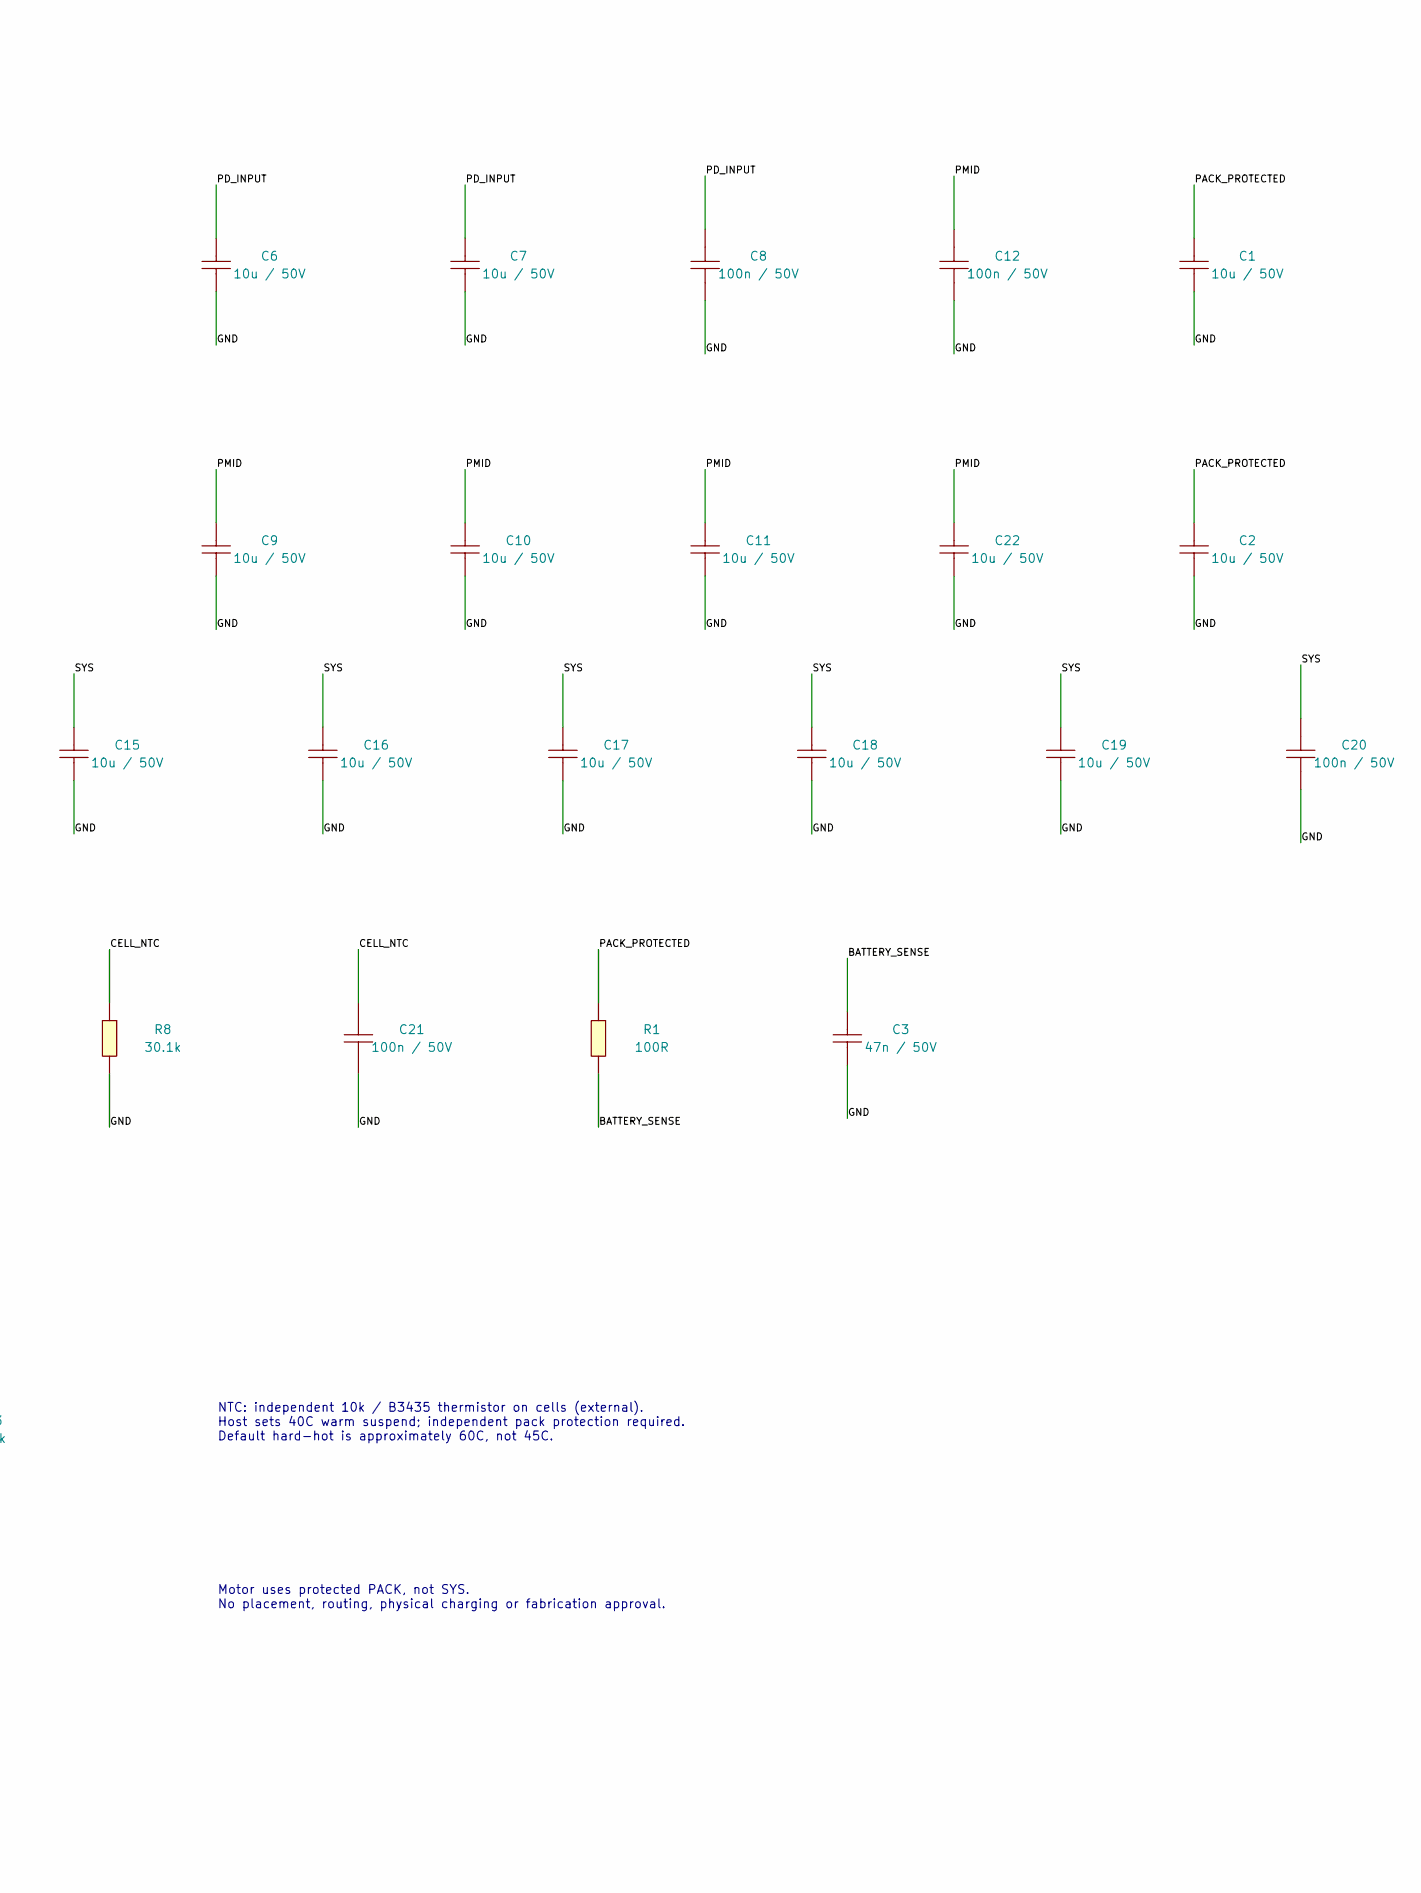
[picture p71: schematic charger-test.kicad_sch, part in row 1, column 2]

Parts:
C1, C2, C6, C7, C9, C10, C11, C15, C16, C17, C18, C19, C22: 10u / 50V; C1206; MPN CL31A106KBHNNNE; LCSC C13585
C3, C4, C5: 47n / 50V; C0402; MPN 0402B473K500NT; LCSC C82219
C8, C12, C20, C21: 100n / 50V; C0402; MPN CL05B104KB54PNC; LCSC C307331
C13: 4.7u / 25V; C0805; MPN CL21A475KAQNNNE; LCSC C1779
C14: 1n / 50V; C0402; MPN 0402B102K500NT; LCSC C1523
L1: CYA0630-2.2UH; IND-SMD_L7.2-W6.6_GPSR07X0; MPN CYA0630-2.2UH; LCSC C5189746
Q1: AO3400A; SOT-23-3_L2.9-W1.3-P1.90-LS2.4-BR; MPN AO3400A; LCSC C20917
Q2: MMBT3906LT1G; SOT-23-3_L2.9-W1.3-P1.90-LS2.4-BR; MPN MMBT3906LT1G; LCSC C53444
R1: 100R; R0402; MPN 0402WGF1000TCE; LCSC C25076
R2, R3, R4, R6, R10: 10k; R0402; MPN 0402WGF1002TCE; LCSC C25744
R5: 33k; R0402; MPN 0402WGF3302TCE; LCSC C25779
R7: 13.7k; R0402; MPN RC0402FR-0713K7L; LCSC C274888
R8: 30.1k; R0402; MPN 0402WGF3012TCE; LCSC C29402
R9: 5.23k; R0402; MPN 0402WGF5231TCE; LCSC C25907
U1: BQ25798RQMR; QFN-29_L4.0-W4.0-P0.40-TL-BQ25792RQMR; MPN BQ25798RQMR; LCSC C2876593

Connections:
3S_PROGRAM: R7.1, U1.20 (PROG)
3V3: Q2.2 (E), R10.2
BATTERY_SENSE: C3.1, R1.2, U1.18 (BATP)
BTST1: C4.1, U1.4 (BTST1)
BTST2: C5.1, U1.19 (BTST2)
CELL_NTC: C21.1, R8.1, R9.2, U1.16 (TS)
CE_GATE: Q1.1 (G), Q2.3 (C), R3.1
CHARGER_IRQ_N: U1.21 (~INT)
CHARGER_STATUS_N: U1.1 (STAT)
CHARGE_ALLOW_N: R6.1
CHARGE_ENABLE_N: Q1.3 (D), R2.2, U1.13 (~CE)
GND: C1.2, C2.2, C3.2, C6.2, C7.2, C8.2, C9.2, C10.2, C11.2, C12.2, C13.2, C14.2, C15.2, C16.2, C17.2, C18.2, C19.2, C20.2, C21.2, C22.2, Q1.2 (S), R3.2, R4.2, R7.2, R8.2, U1.10 (ACDRV2), U1.11 (ACDRV1), U1.27 (GND)
I2C_SCL: U1.14 (SCL)
I2C_SDA: U1.15 (SDA)
PACK_PROTECTED: C1.1, C2.1, R1.1, U1.22 (BAT), U1.23 (BAT)
PD_INPUT: C6.1, C7.1, C8.1, U1.2 (VBUS), U1.3 (VBUS), U1.8 (VAC2), U1.9 (VAC1)
PERMISSION_BASE: Q2.1 (B), R6.2, R10.1
PMID: C9.1, C10.1, C11.1, C12.1, C22.1, U1.29 (PMID)
REGN: C13.1, R2.1, R5.1, R9.1, U1.5 (REGN)
SDRV: C14.1, U1.24 (SDRV)
STARTUP_ILIM: R4.1, R5.2, U1.17 (ILIM_HIZ)
SW1: C4.2, L1.1, U1.28 (SW1)
SW2: C5.2, L1.2, U1.26 (SW2)
SYS: C15.1, C16.1, C17.1, C18.1, C19.1, C20.1, U1.25 (SYS)

Notes on the sheet:
3S CHARGER / CIRCUIT STUDY
BQ25798: 3S, 750 kHz, 2.2 uH. PD input switching, protected carrier and regulator are separate unfinished blocks.
All capacitor values are nominal. DC bias, converter dynamics and thermal behavior require qualification.
Active-LOW charging permission; absent 3V3 keeps the CE pull-down off.
NTC: independent 10k / B3435 thermistor on cells (external). Host sets 40C warm suspend; independent pack protection required. Default hard-hot is approximately 60C, not 45C.
Motor uses protected PACK, not SYS. No placement, routing, physical charging or fabrication approval.
ERC retains 10 findings: external ports plus ACDRV1/2 tied to GND per TI no-input-FET instructions.
