0x63616c/smart-blinds/hw/schematics/blind-controller/motor-test.kicad_sch

## KiCad design hw/schematics/blind-controller/motor-test.kicad_sch (2026-10-20)

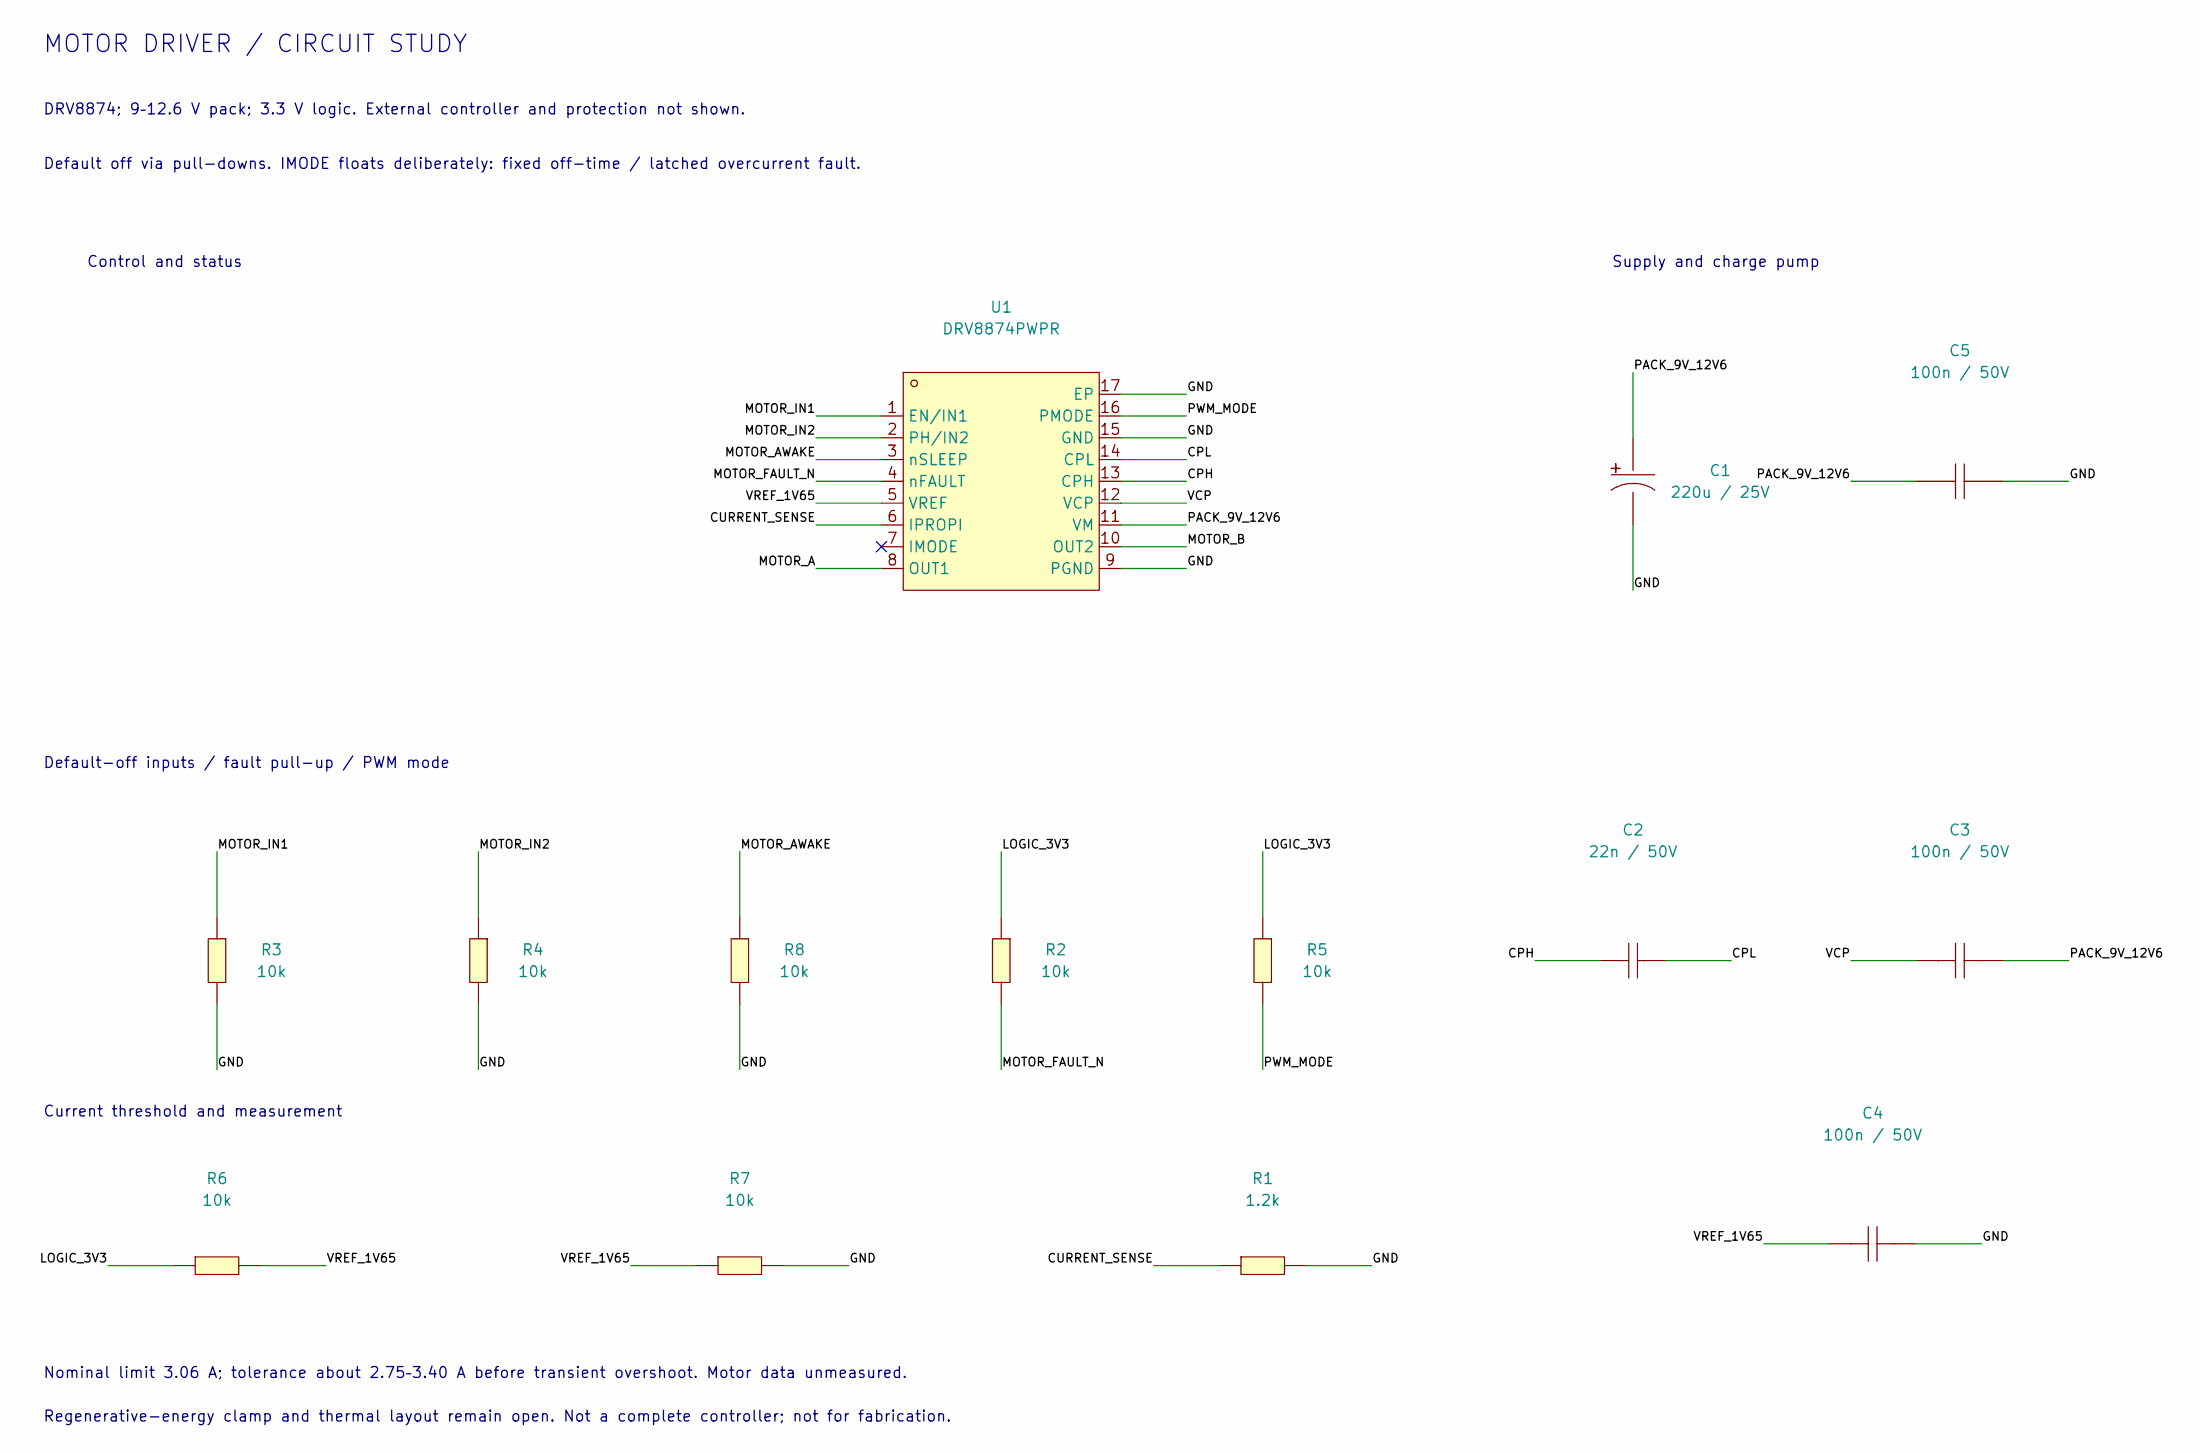
[picture p72: schematic motor-test.kicad_sch]

Parts:
C1: 220u / 25V; CAP-SMD_BD6.3-L6.6-W6.6-LS7.3-FD; MPN UCM1E221MCL1GS; LCSC C340768
C2: 22n / 50V; C0402; MPN 0402B223K500NT; LCSC C1532
C3, C4, C5: 100n / 50V; C0402; MPN CL05B104KB54PNC; LCSC C307331
R1: 1.2k; R0402; MPN 0402WGF1201TCE; LCSC C25862
R2, R3, R4, R5, R6, R7, R8: 10k; R0402; MPN 0402WGF1002TCE; LCSC C25744
U1: DRV8874PWPR; HTSSOP-16_L5.0-W4.4-P0.65-LS6.4-BL-EP; MPN DRV8874PWPR; LCSC C1855818

Connections:
CPH: C2.1, U1.13 (CPH)
CPL: C2.2, U1.14 (CPL)
CURRENT_SENSE: R1.1, U1.6 (IPROPI)
GND: C1.2, C4.2, C5.2, R1.2, R3.2, R4.2, R7.2, R8.2, U1.9 (PGND), U1.15 (GND), U1.17 (EP)
LOGIC_3V3: R2.1, R5.1, R6.1
MOTOR_A: U1.8 (OUT1)
MOTOR_AWAKE: R8.1, U1.3 (nSLEEP)
MOTOR_B: U1.10 (OUT2)
MOTOR_FAULT_N: R2.2, U1.4 (nFAULT)
MOTOR_IN1: R3.1, U1.1 (EN/IN1)
MOTOR_IN2: R4.1, U1.2 (PH/IN2)
PACK_9V_12V6: C1.1, C3.2, C5.1, U1.11 (VM)
PWM_MODE: R5.2, U1.16 (PMODE)
VCP: C3.1, U1.12 (VCP)
VREF_1V65: C4.1, R6.2, R7.1, U1.5 (VREF)

Notes on the sheet:
MOTOR DRIVER / CIRCUIT STUDY
DRV8874; 9–12.6 V pack; 3.3 V logic. External controller and protection not shown.
Default off via pull-downs. IMODE floats deliberately: fixed off-time / latched overcurrent fault.
Control and status
Supply and charge pump
Default-off inputs / fault pull-up / PWM mode
Current threshold and measurement
Nominal limit 3.06 A; tolerance about 2.75–3.40 A before transient overshoot. Motor data unmeasured.
Regenerative-energy clamp and thermal layout remain open. Not a complete controller; not for fabrication.
