0x63616c/smart-blinds/hw/schematics/blind-main/01-usb.kicad_sch

## KiCad design hw/schematics/blind-main/01-usb.kicad_sch (2026-10-21)

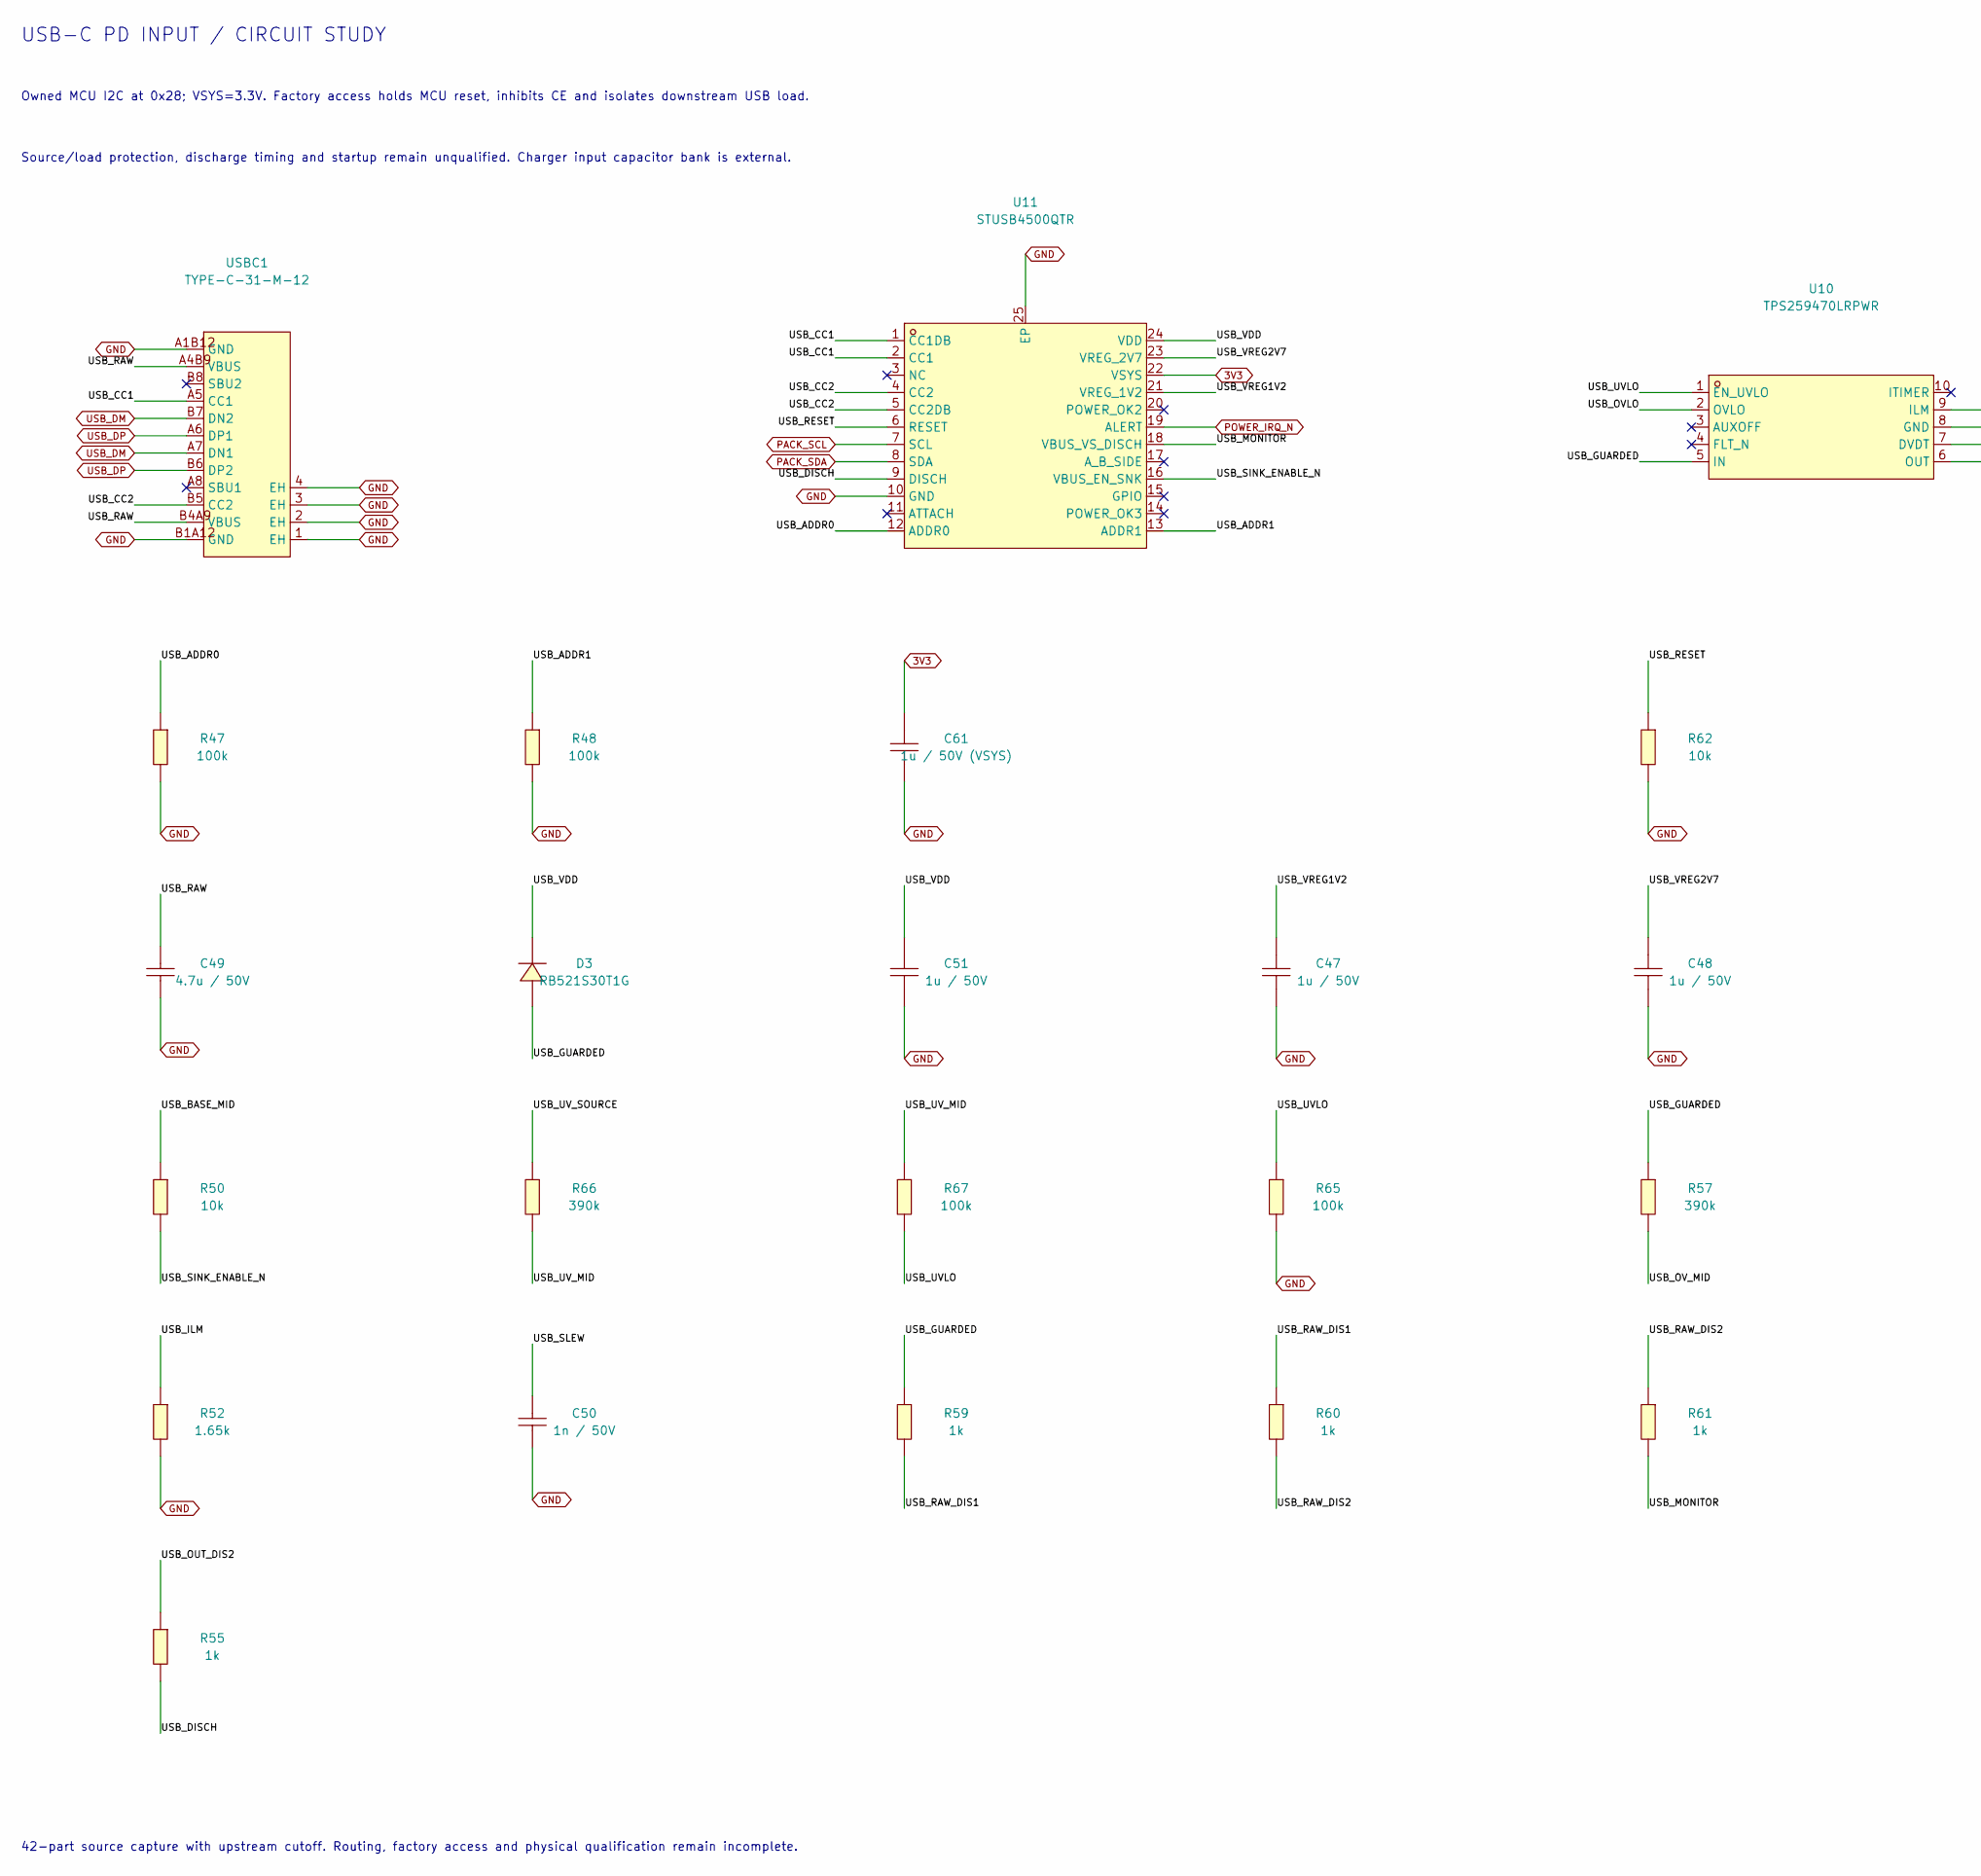
[picture p73: schematic 01-usb.kicad_sch, part in row 1, column 1]

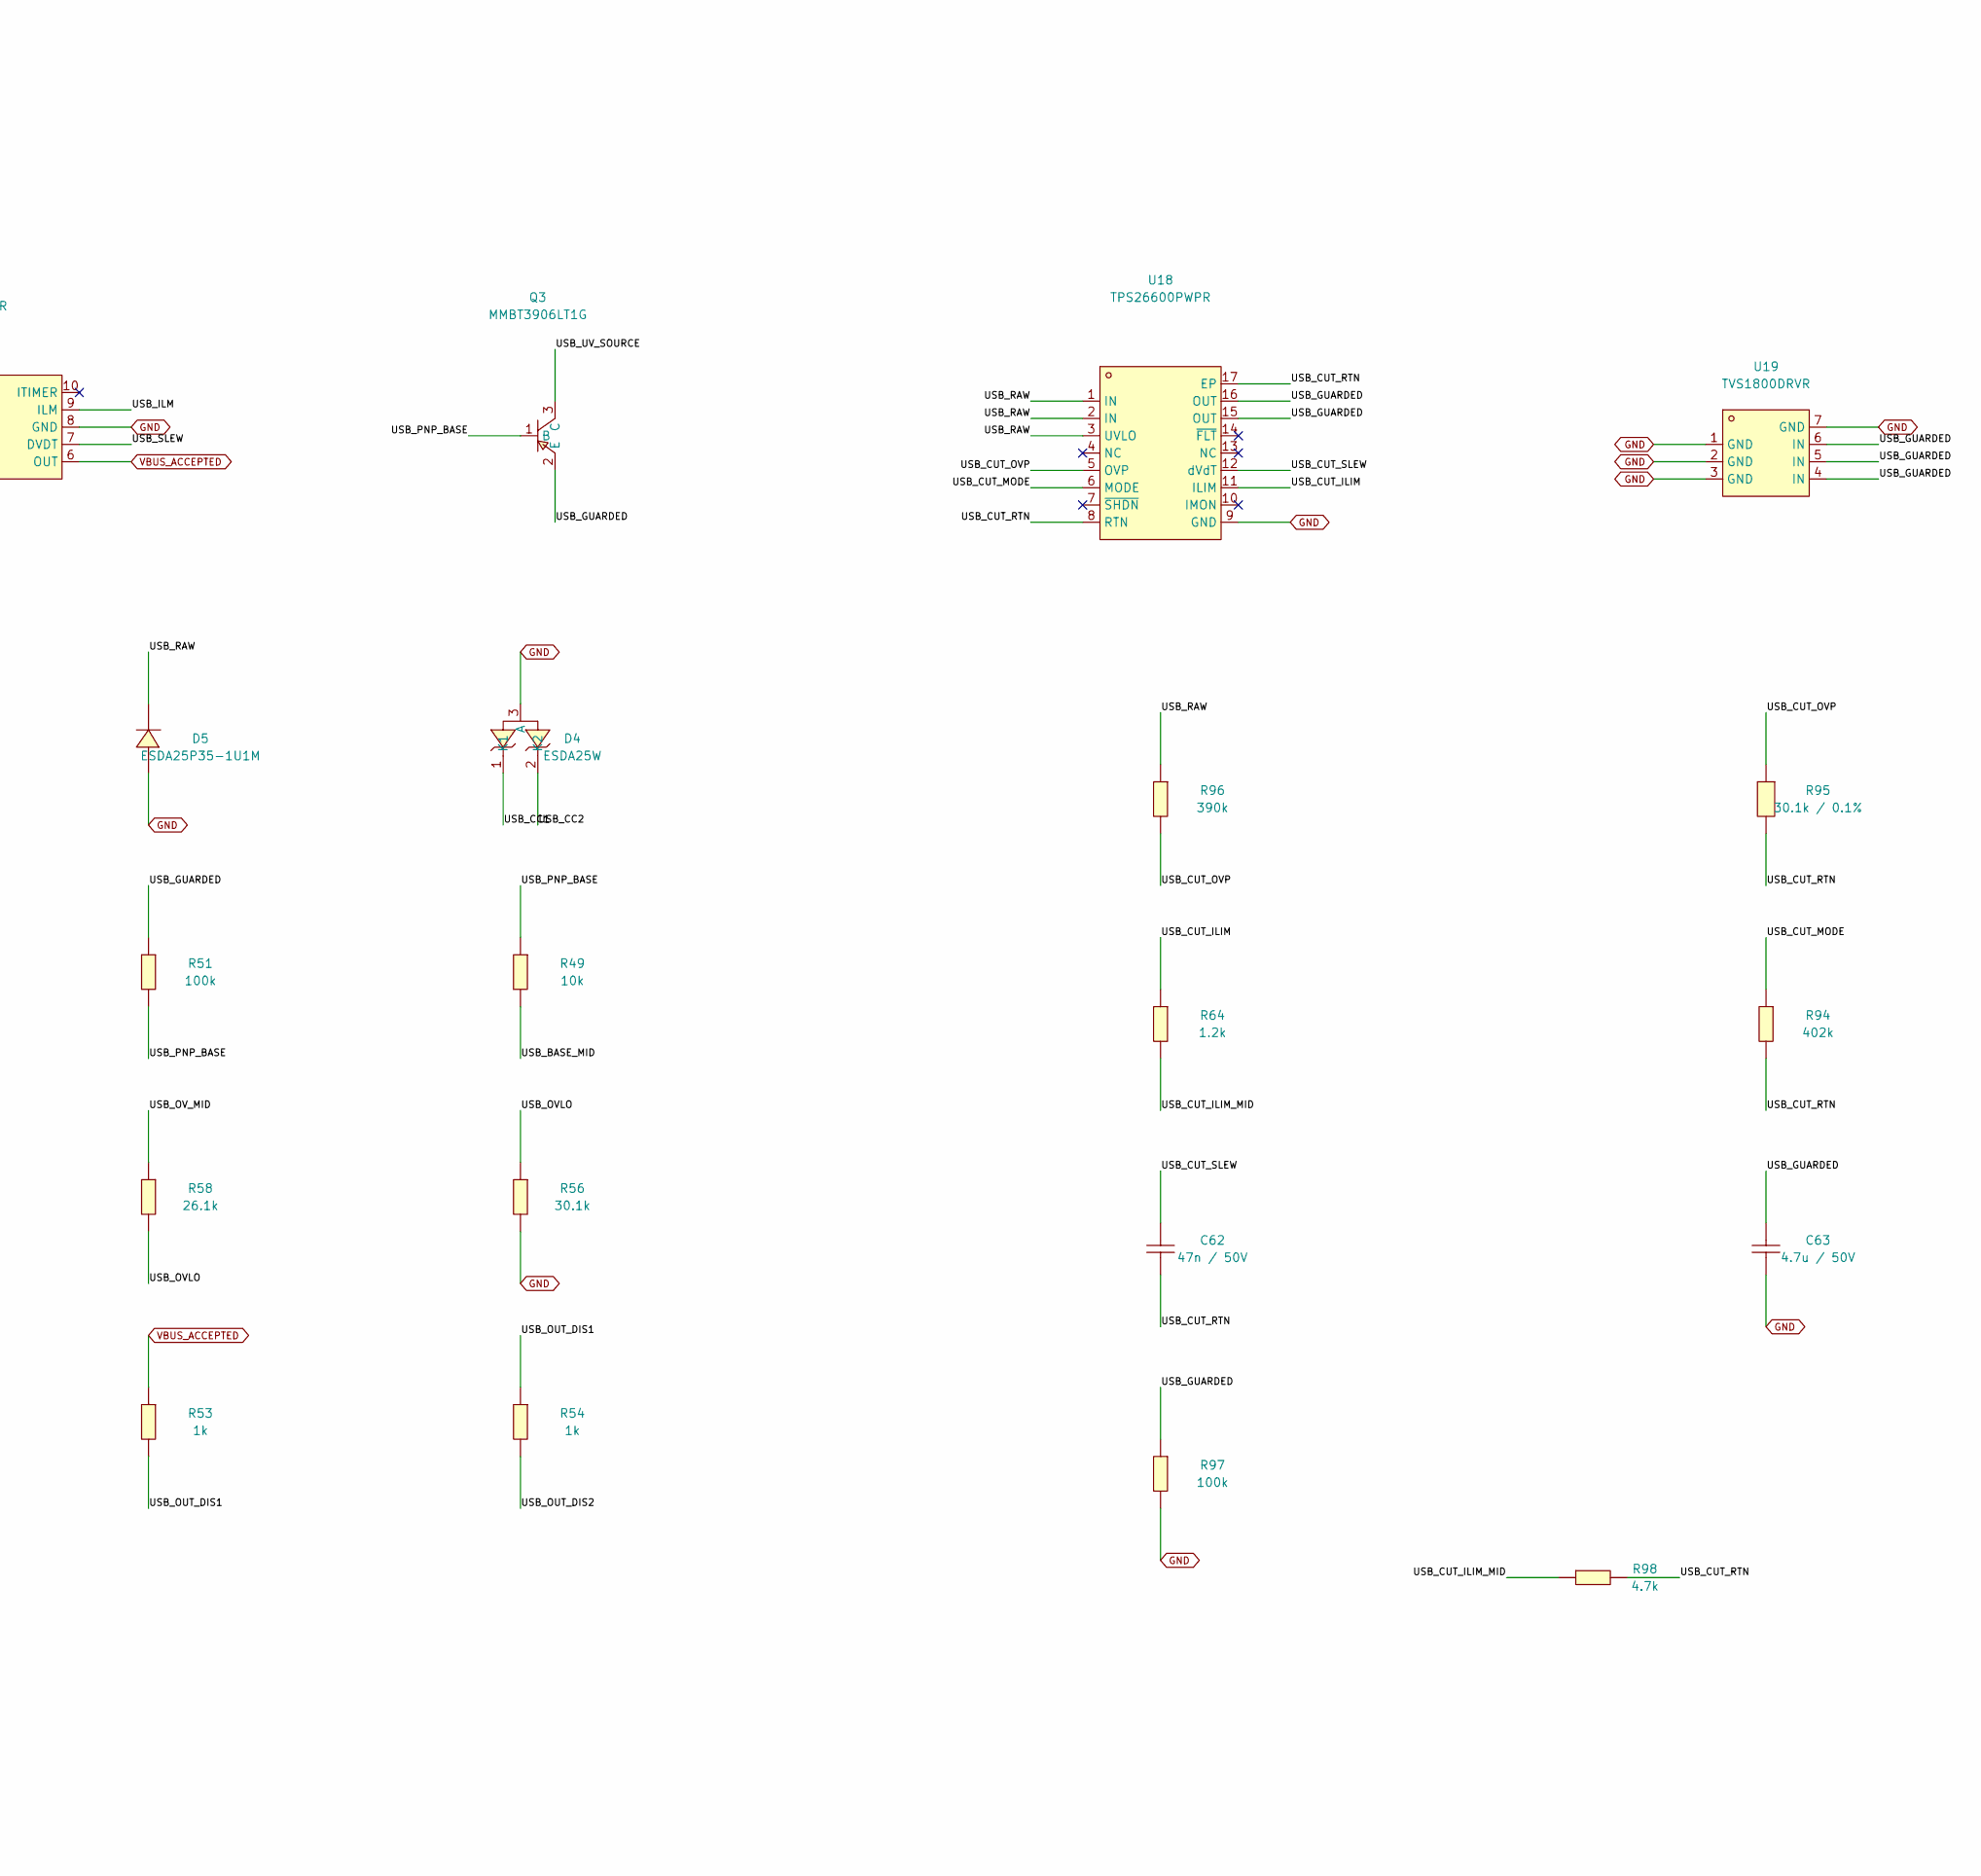
[picture p74: schematic 01-usb.kicad_sch, part in row 1, column 2]

Parts:
C47, C48, C51: 1u / 50V; C0603; MPN CL10A105KB8NNNC; LCSC C15849
C49, C63: 4.7u / 50V; C1206; MPN CL31A475KBHNNNE; LCSC C12881
C50: 1n / 50V; C0402; MPN 0402B102K500NT; LCSC C1523
C61: 1u / 50V (VSYS); C0603; MPN CL10A105KB8NNNC; LCSC C15849
C62: 47n / 50V; C0402; MPN 0402B473K500NT; LCSC C82219
D3: RB521S30T1G; SOD-523_L1.2-W0.8-LS1.6-RD; MPN RB521S30T1G; LCSC C145179
D4: ESDA25W; SOT-323-3_L2.1-W1.3-P1.32-LS2.1-BR; MPN ESDA25W; LCSC C2935152
D5: ESDA25P35-1U1M; DFN1610-2_L1.6-W1.0-P1.05-RD; MPN ESDA25P35-1U1M; LCSC C1974707
Q3: MMBT3906LT1G; SOT-23-3_L2.9-W1.3-P1.90-LS2.4-BR; MPN MMBT3906LT1G; LCSC C53444
R47, R48, R51, R65, R67, R97: 100k; R0402; MPN 0402WGF1003TCE; LCSC C25741
R49, R50, R62: 10k; R0402; MPN 0402WGF1002TCE; LCSC C25744
R52: 1.65k; R0402; MPN 0402WGF1651TCE; LCSC C25869
R53, R54, R55, R59, R60, R61: 1k; R0603; MPN 0603WAF1001T5E; LCSC C21190
R56: 30.1k; R0402; MPN 0402WGF3012TCE; LCSC C29402
R57, R66, R96: 390k; R0402; MPN 0402WGF3903TCE; LCSC C25782
R58: 26.1k; R0402; MPN 0402WGF2612TCE; LCSC C25875
R64: 1.2k; R0402; MPN 0402WGF1201TCE; LCSC C25862
R94: 402k; R0402; MPN 0402WGF4023TCE; LCSC C25785
R95: 30.1k / 0.1%; R0402; MPN RT0402BRD0730K1L; LCSC C852714
R98: 4.7k; R0402; MPN 0402WGF4701TCE; LCSC C25900
U10: TPS259470LRPWR; VQFN-10_L2.0-W2.0-P0.45-TL; MPN TPS259470LRPWR; LCSC C3662793
U11: STUSB4500QTR; QFN-24_L4.0-W4.0-P0.50-BL-EP2.8; MPN STUSB4500QTR; LCSC C2678061
U18: TPS26600PWPR; TPS26600_PWP16; MPN TPS26600PWPR; LCSC C544399
U19: TVS1800DRVR; TVS1800_DRV6; MPN TVS1800DRVR; LCSC C2649846
USBC1: TYPE-C-31-M-12; HRO_TYPE_C_31_M_12; MPN TYPE-C-31-M-12; LCSC C165948

Connections:
3V3: C61.1, U11.22 (VSYS)
GND: C47.2, C48.2, C49.2, C50.2, C51.2, C61.2, C63.2, D4.3 (A), D5.2 (A), R47.2, R48.2, R52.2, R56.2, R62.2, R65.2, R97.2, U10.8 (GND), U11.10 (GND), U11.25 (EP), U18.9 (GND), U19.1 (GND), U19.2 (GND), U19.3 (GND), U19.7 (GND), USBC1.1 (EH), USBC1.2 (EH), USBC1.3 (EH), USBC1.4 (EH), USBC1.A1B12 (GND), USBC1.B1A12 (GND)
PACK_SCL: U11.7 (SCL)
PACK_SDA: U11.8 (SDA)
POWER_IRQ_N: U11.19 (ALERT)
USB_ADDR0: R47.1, U11.12 (ADDR0)
USB_ADDR1: R48.1, U11.13 (ADDR1)
USB_BASE_MID: R49.2, R50.1
USB_CC1: D4.1 (K1), U11.1 (CC1DB), U11.2 (CC1), USBC1.A5 (CC1)
USB_CC2: D4.2 (K2), U11.4 (CC2), U11.5 (CC2DB), USBC1.B5 (CC2)
USB_CUT_ILIM: R64.1, U18.11 (ILIM)
USB_CUT_ILIM_MID: R64.2, R98.1
USB_CUT_MODE: R94.1, U18.6 (MODE)
USB_CUT_OVP: R95.1, R96.2, U18.5 (OVP)
USB_CUT_RTN: C62.2, R94.2, R95.2, R98.2, U18.8 (RTN), U18.17 (EP)
USB_CUT_SLEW: C62.1, U18.12 (dVdT)
USB_DISCH: R55.2, U11.9 (DISCH)
USB_DM: USBC1.A7 (DN1), USBC1.B7 (DN2)
USB_DP: USBC1.A6 (DP1), USBC1.B6 (DP2)
USB_GUARDED: C63.1, D3.2 (A), Q3.2 (E), R51.1, R57.1, R59.1, R97.1, U10.5 (IN), U18.15 (OUT), U18.16 (OUT), U19.4 (IN), U19.5 (IN), U19.6 (IN)
USB_ILM: R52.1, U10.9 (ILM)
USB_MONITOR: R61.2, U11.18 (VBUS_VS_DISCH)
USB_OUT_DIS1: R53.2, R54.1
USB_OUT_DIS2: R54.2, R55.1
USB_OVLO: R56.1, R58.2, U10.2 (OVLO)
USB_OV_MID: R57.2, R58.1
USB_PNP_BASE: Q3.1 (B), R49.1, R51.2
USB_RAW: C49.1, D5.1 (K), R96.1, U18.1 (IN), U18.2 (IN), U18.3 (UVLO), USBC1.A4B9 (VBUS), USBC1.B4A9 (VBUS)
USB_RAW_DIS1: R59.2, R60.1
USB_RAW_DIS2: R60.2, R61.1
USB_RESET: R62.1, U11.6 (RESET)
USB_SINK_ENABLE_N: R50.2, U11.16 (VBUS_EN_SNK)
USB_SLEW: C50.1, U10.7 (DVDT)
USB_UVLO: R65.1, R67.2, U10.1 (EN_UVLO)
USB_UV_MID: R66.2, R67.1
USB_UV_SOURCE: Q3.3 (C), R66.1
USB_VDD: C51.1, D3.1 (C), U11.24 (VDD)
USB_VREG1V2: C47.1, U11.21 (VREG_1V2)
USB_VREG2V7: C48.1, U11.23 (VREG_2V7)
VBUS_ACCEPTED: R53.1, U10.6 (OUT)

Notes on the sheet:
USB-C PD INPUT / CIRCUIT STUDY
Owned MCU I2C at 0x28; VSYS=3.3V. Factory access holds MCU reset, inhibits CE and isolates downstream USB load.
Source/load protection, discharge timing and startup remain unqualified. Charger input capacitor bank is external.
42-part source capture with upstream cutoff. Routing, factory access and physical qualification remain incomplete.
