0x63616c/smart-blinds/hw/schematics/blind-main/02-charger.kicad_sch

## KiCad design hw/schematics/blind-main/02-charger.kicad_sch (2026-10-20)

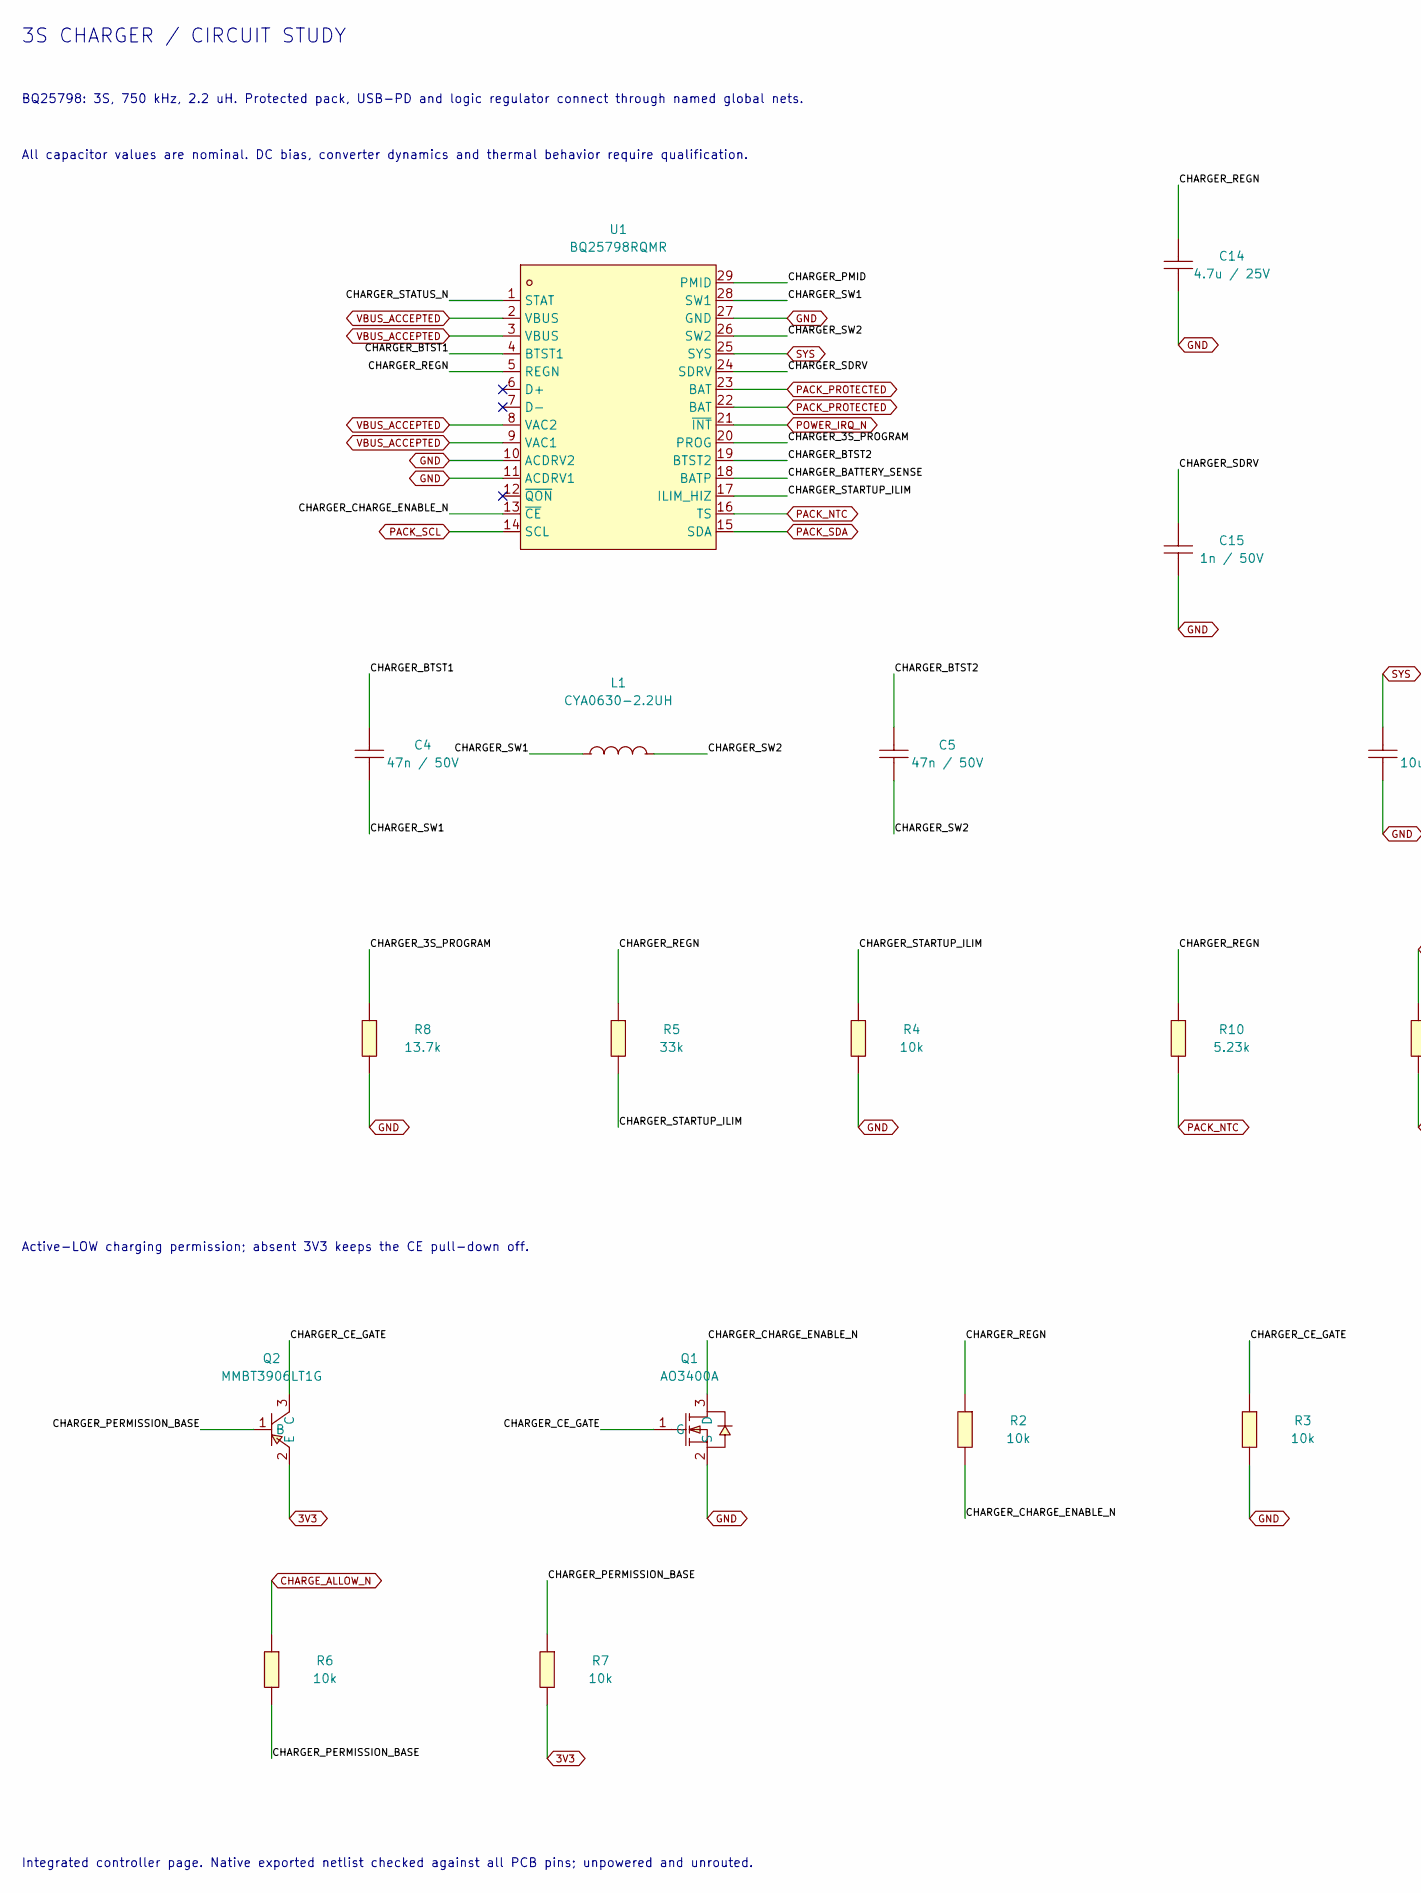
[picture p75: schematic 02-charger.kicad_sch, part in row 1, column 1]

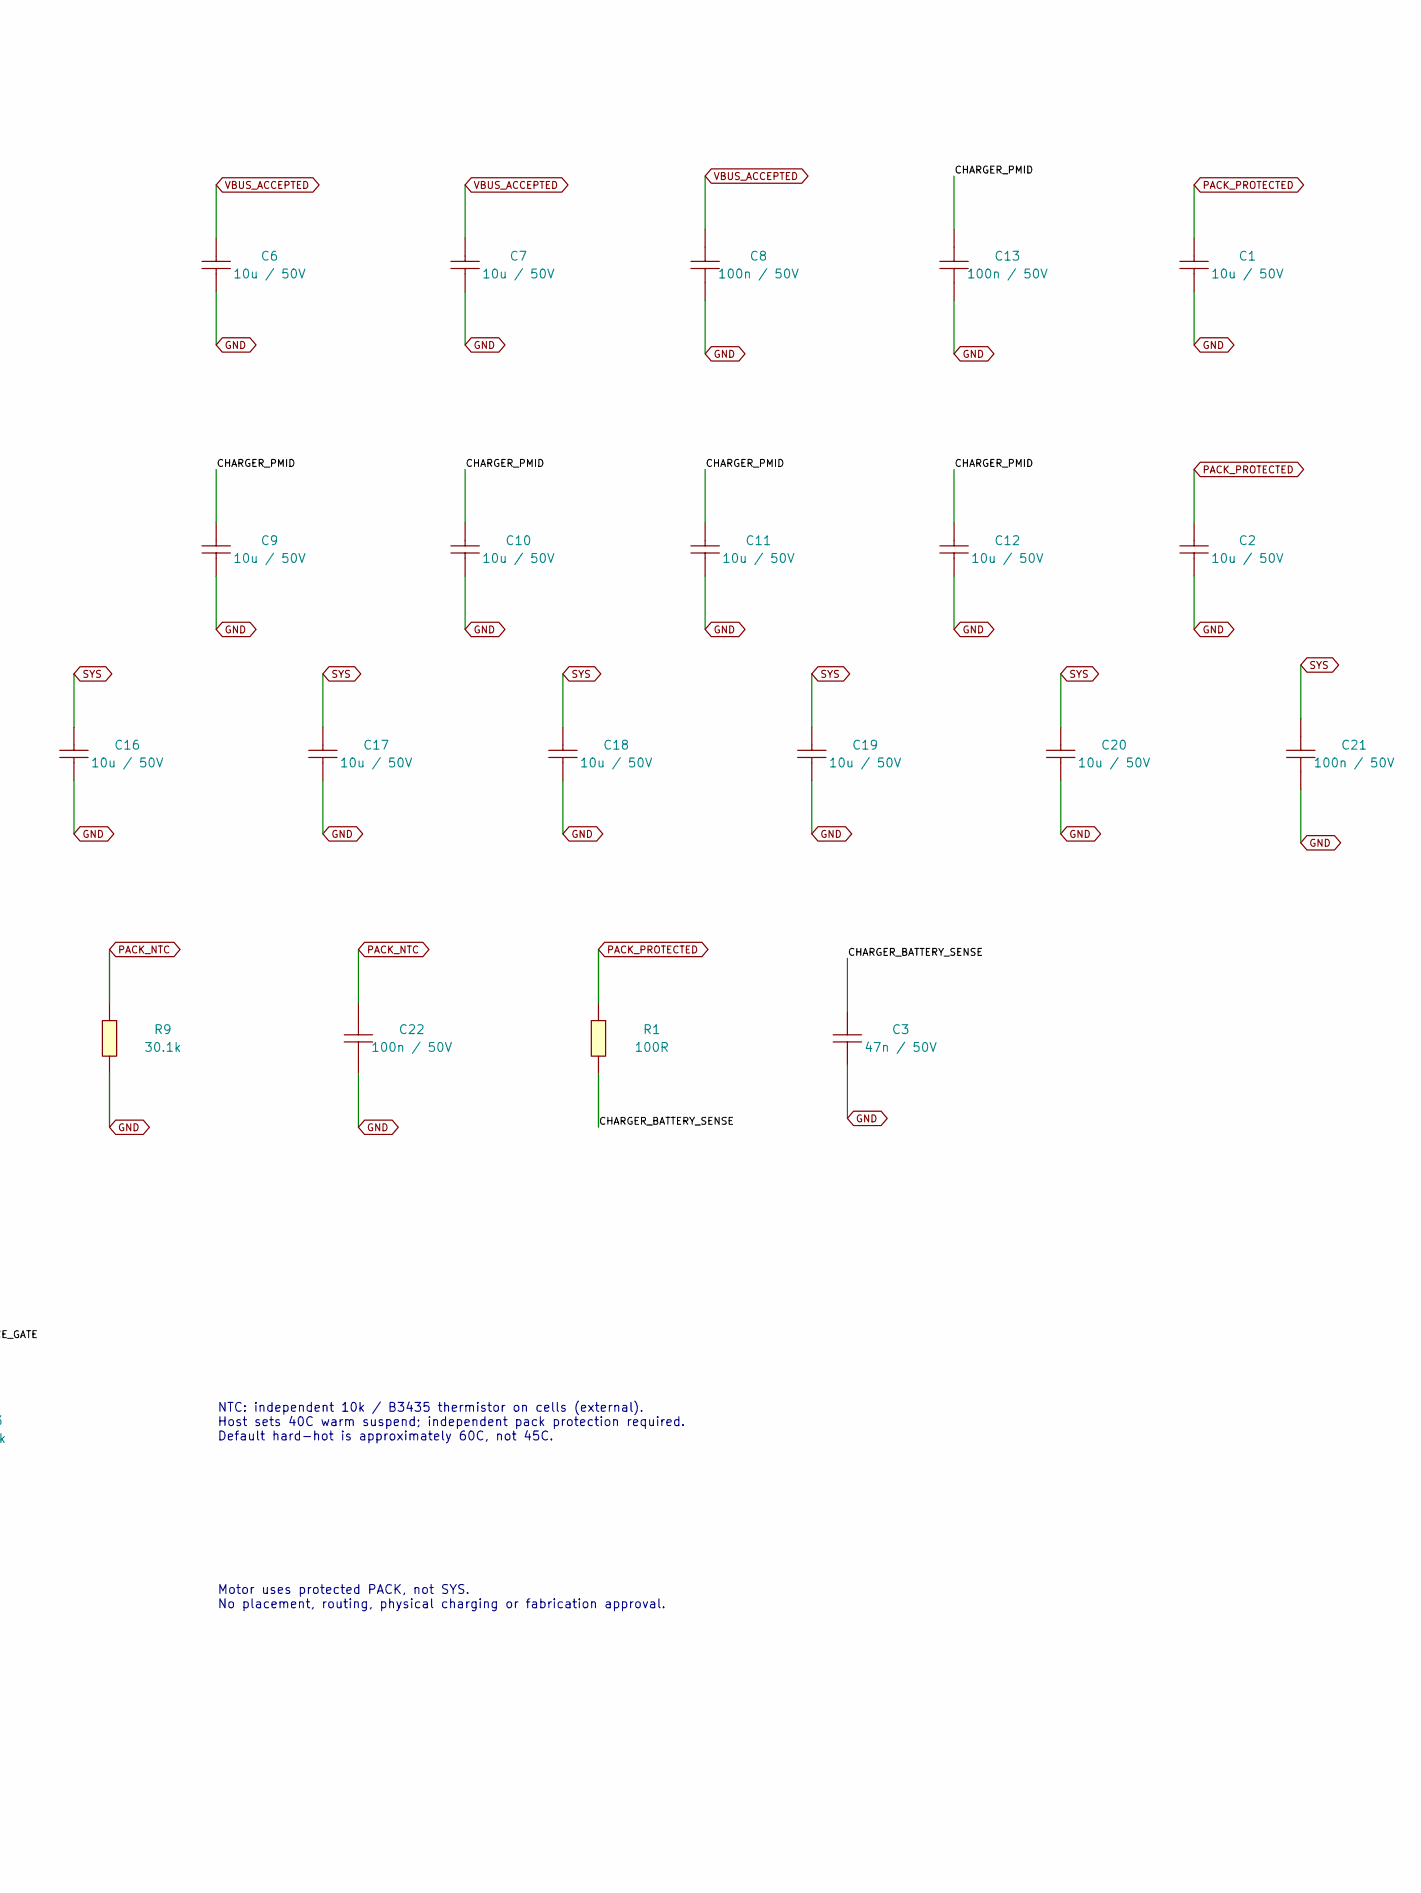
[picture p76: schematic 02-charger.kicad_sch, part in row 1, column 2]

Parts:
C1, C2, C6, C7, C9, C10, C11, C12, C16, C17, C18, C19, C20: 10u / 50V; C1206; MPN CL31A106KBHNNNE; LCSC C13585
C3, C4, C5: 47n / 50V; C0402; MPN 0402B473K500NT; LCSC C82219
C8, C13, C21, C22: 100n / 50V; C0402; MPN CL05B104KB54PNC; LCSC C307331
C14: 4.7u / 25V; C0805; MPN CL21A475KAQNNNE; LCSC C1779
C15: 1n / 50V; C0402; MPN 0402B102K500NT; LCSC C1523
L1: CYA0630-2.2UH; IND-SMD_L7.2-W6.6_GPSR07X0; MPN CYA0630-2.2UH; LCSC C5189746
Q1: AO3400A; SOT-23-3_L2.9-W1.3-P1.90-LS2.4-BR; MPN AO3400A; LCSC C20917
Q2: MMBT3906LT1G; SOT-23-3_L2.9-W1.3-P1.90-LS2.4-BR; MPN MMBT3906LT1G; LCSC C53444
R1: 100R; R0402; MPN 0402WGF1000TCE; LCSC C25076
R2, R3, R4, R6, R7: 10k; R0402; MPN 0402WGF1002TCE; LCSC C25744
R5: 33k; R0402; MPN 0402WGF3302TCE; LCSC C25779
R8: 13.7k; R0402; MPN RC0402FR-0713K7L; LCSC C274888
R9: 30.1k; R0402; MPN 0402WGF3012TCE; LCSC C29402
R10: 5.23k; R0402; MPN 0402WGF5231TCE; LCSC C25907
U1: BQ25798RQMR; QFN-29_L4.0-W4.0-P0.40-TL-BQ25792RQMR; MPN BQ25798RQMR; LCSC C2876593

Connections:
3V3: Q2.2 (E), R7.2
CHARGER_3S_PROGRAM: R8.1, U1.20 (PROG)
CHARGER_BATTERY_SENSE: C3.1, R1.2, U1.18 (BATP)
CHARGER_BTST1: C4.1, U1.4 (BTST1)
CHARGER_BTST2: C5.1, U1.19 (BTST2)
CHARGER_CE_GATE: Q1.1 (G), Q2.3 (C), R3.1
CHARGER_CHARGE_ENABLE_N: Q1.3 (D), R2.2, U1.13 (~CE)
CHARGER_PERMISSION_BASE: Q2.1 (B), R6.2, R7.1
CHARGER_PMID: C9.1, C10.1, C11.1, C12.1, C13.1, U1.29 (PMID)
CHARGER_REGN: C14.1, R2.1, R5.1, R10.1, U1.5 (REGN)
CHARGER_SDRV: C15.1, U1.24 (SDRV)
CHARGER_STARTUP_ILIM: R4.1, R5.2, U1.17 (ILIM_HIZ)
CHARGER_STATUS_N: U1.1 (STAT)
CHARGER_SW1: C4.2, L1.1, U1.28 (SW1)
CHARGER_SW2: C5.2, L1.2, U1.26 (SW2)
CHARGE_ALLOW_N: R6.1
GND: C1.2, C2.2, C3.2, C6.2, C7.2, C8.2, C9.2, C10.2, C11.2, C12.2, C13.2, C14.2, C15.2, C16.2, C17.2, C18.2, C19.2, C20.2, C21.2, C22.2, Q1.2 (S), R3.2, R4.2, R8.2, R9.2, U1.10 (ACDRV2), U1.11 (ACDRV1), U1.27 (GND)
PACK_NTC: C22.1, R9.1, R10.2, U1.16 (TS)
PACK_PROTECTED: C1.1, C2.1, R1.1, U1.22 (BAT), U1.23 (BAT)
PACK_SCL: U1.14 (SCL)
PACK_SDA: U1.15 (SDA)
POWER_IRQ_N: U1.21 (~INT)
SYS: C16.1, C17.1, C18.1, C19.1, C20.1, C21.1, U1.25 (SYS)
VBUS_ACCEPTED: C6.1, C7.1, C8.1, U1.2 (VBUS), U1.3 (VBUS), U1.8 (VAC2), U1.9 (VAC1)

Notes on the sheet:
3S CHARGER / CIRCUIT STUDY
BQ25798: 3S, 750 kHz, 2.2 uH. Protected pack, USB-PD and logic regulator connect through named global nets.
All capacitor values are nominal. DC bias, converter dynamics and thermal behavior require qualification.
Active-LOW charging permission; absent 3V3 keeps the CE pull-down off.
NTC: independent 10k / B3435 thermistor on cells (external). Host sets 40C warm suspend; independent pack protection required. Default hard-hot is approximately 60C, not 45C.
Motor uses protected PACK, not SYS. No placement, routing, physical charging or fabrication approval.
Integrated controller page. Native exported netlist checked against all PCB pins; unpowered and unrouted.
