0x63616c/smart-blinds/hw/schematics/blind-main/03-logic.kicad_sch

## KiCad design hw/schematics/blind-main/03-logic.kicad_sch (2026-10-20)

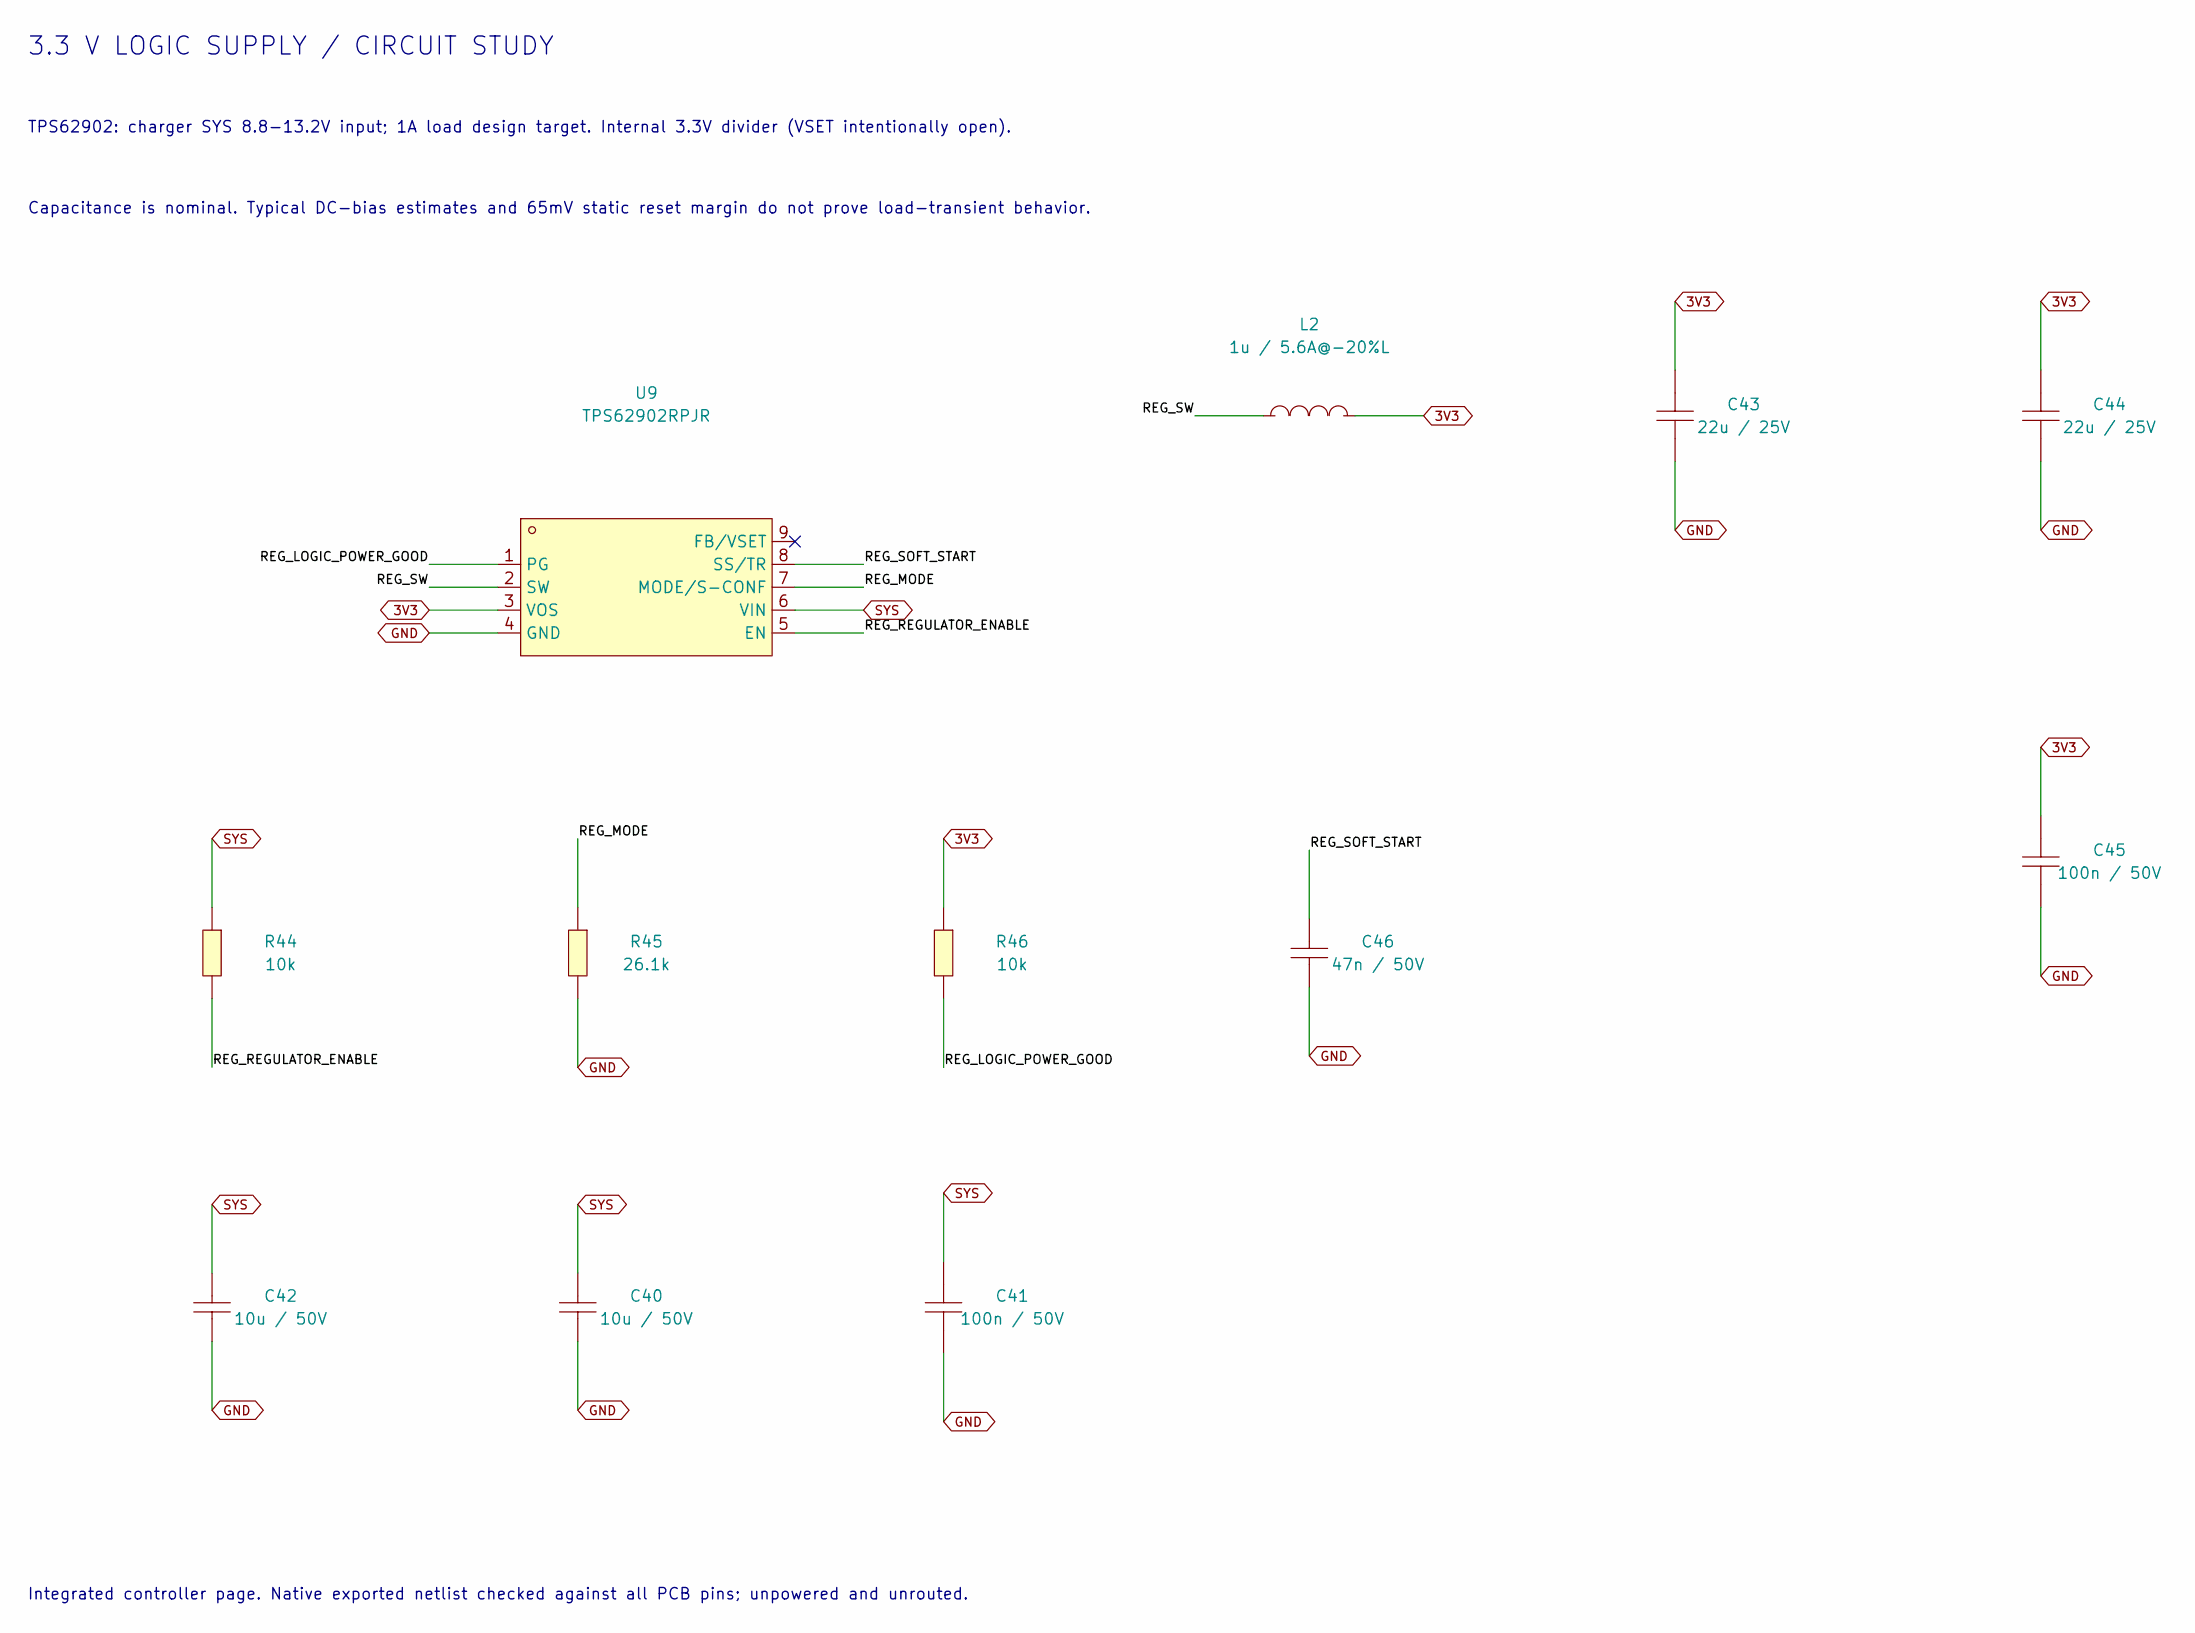
[picture p77: schematic 03-logic.kicad_sch]

Parts:
C40, C42: 10u / 50V; C1206; MPN CL31A106KBHNNNE; LCSC C13585
C41, C45: 100n / 50V; C0402; MPN CL05B104KB54PNC; LCSC C307331
C43, C44: 22u / 25V; C0805; MPN CL21A226MAYNNNE; LCSC C602037
C46: 47n / 50V; C0402; MPN 0402B473K500NT; LCSC C82219
L2: 1u / 5.6A@-20%L; IND-SMD_L4.4-W4.2; MPN MWSA0402S-1R0MT; LCSC C408332
R44, R46: 10k; R0402; MPN 0402WGF1002TCE; LCSC C25744
R45: 26.1k; R0402; MPN 0402WGF2612TCE; LCSC C25875
U9: TPS62902RPJR; VQFN-HR-9_L2.0-W1.5-P0.50-TL; MPN TPS62902RPJR; LCSC C2870154

Connections:
3V3: C43.1, C44.1, C45.1, L2.2, R46.1, U9.3 (VOS)
GND: C40.2, C41.2, C42.2, C43.2, C44.2, C45.2, C46.2, R45.2, U9.4 (GND)
REG_LOGIC_POWER_GOOD: R46.2, U9.1 (PG)
REG_MODE: R45.1, U9.7 (MODE/S-CONF)
REG_REGULATOR_ENABLE: R44.2, U9.5 (EN)
REG_SOFT_START: C46.1, U9.8 (SS/TR)
REG_SW: L2.1, U9.2 (SW)
SYS: C40.1, C41.1, C42.1, R44.1, U9.6 (VIN)

Notes on the sheet:
3.3 V LOGIC SUPPLY / CIRCUIT STUDY
TPS62902: charger SYS 8.8-13.2V input; 1A load design target. Internal 3.3V divider (VSET intentionally open).
Capacitance is nominal. Typical DC-bias estimates and 65mV static reset margin do not prove load-transient behavior.
Integrated controller page. Native exported netlist checked against all PCB pins; unpowered and unrouted.
