0x63616c/smart-blinds/hw/schematics/blind-main/04-motor.kicad_sch

## KiCad design hw/schematics/blind-main/04-motor.kicad_sch (2026-10-20)

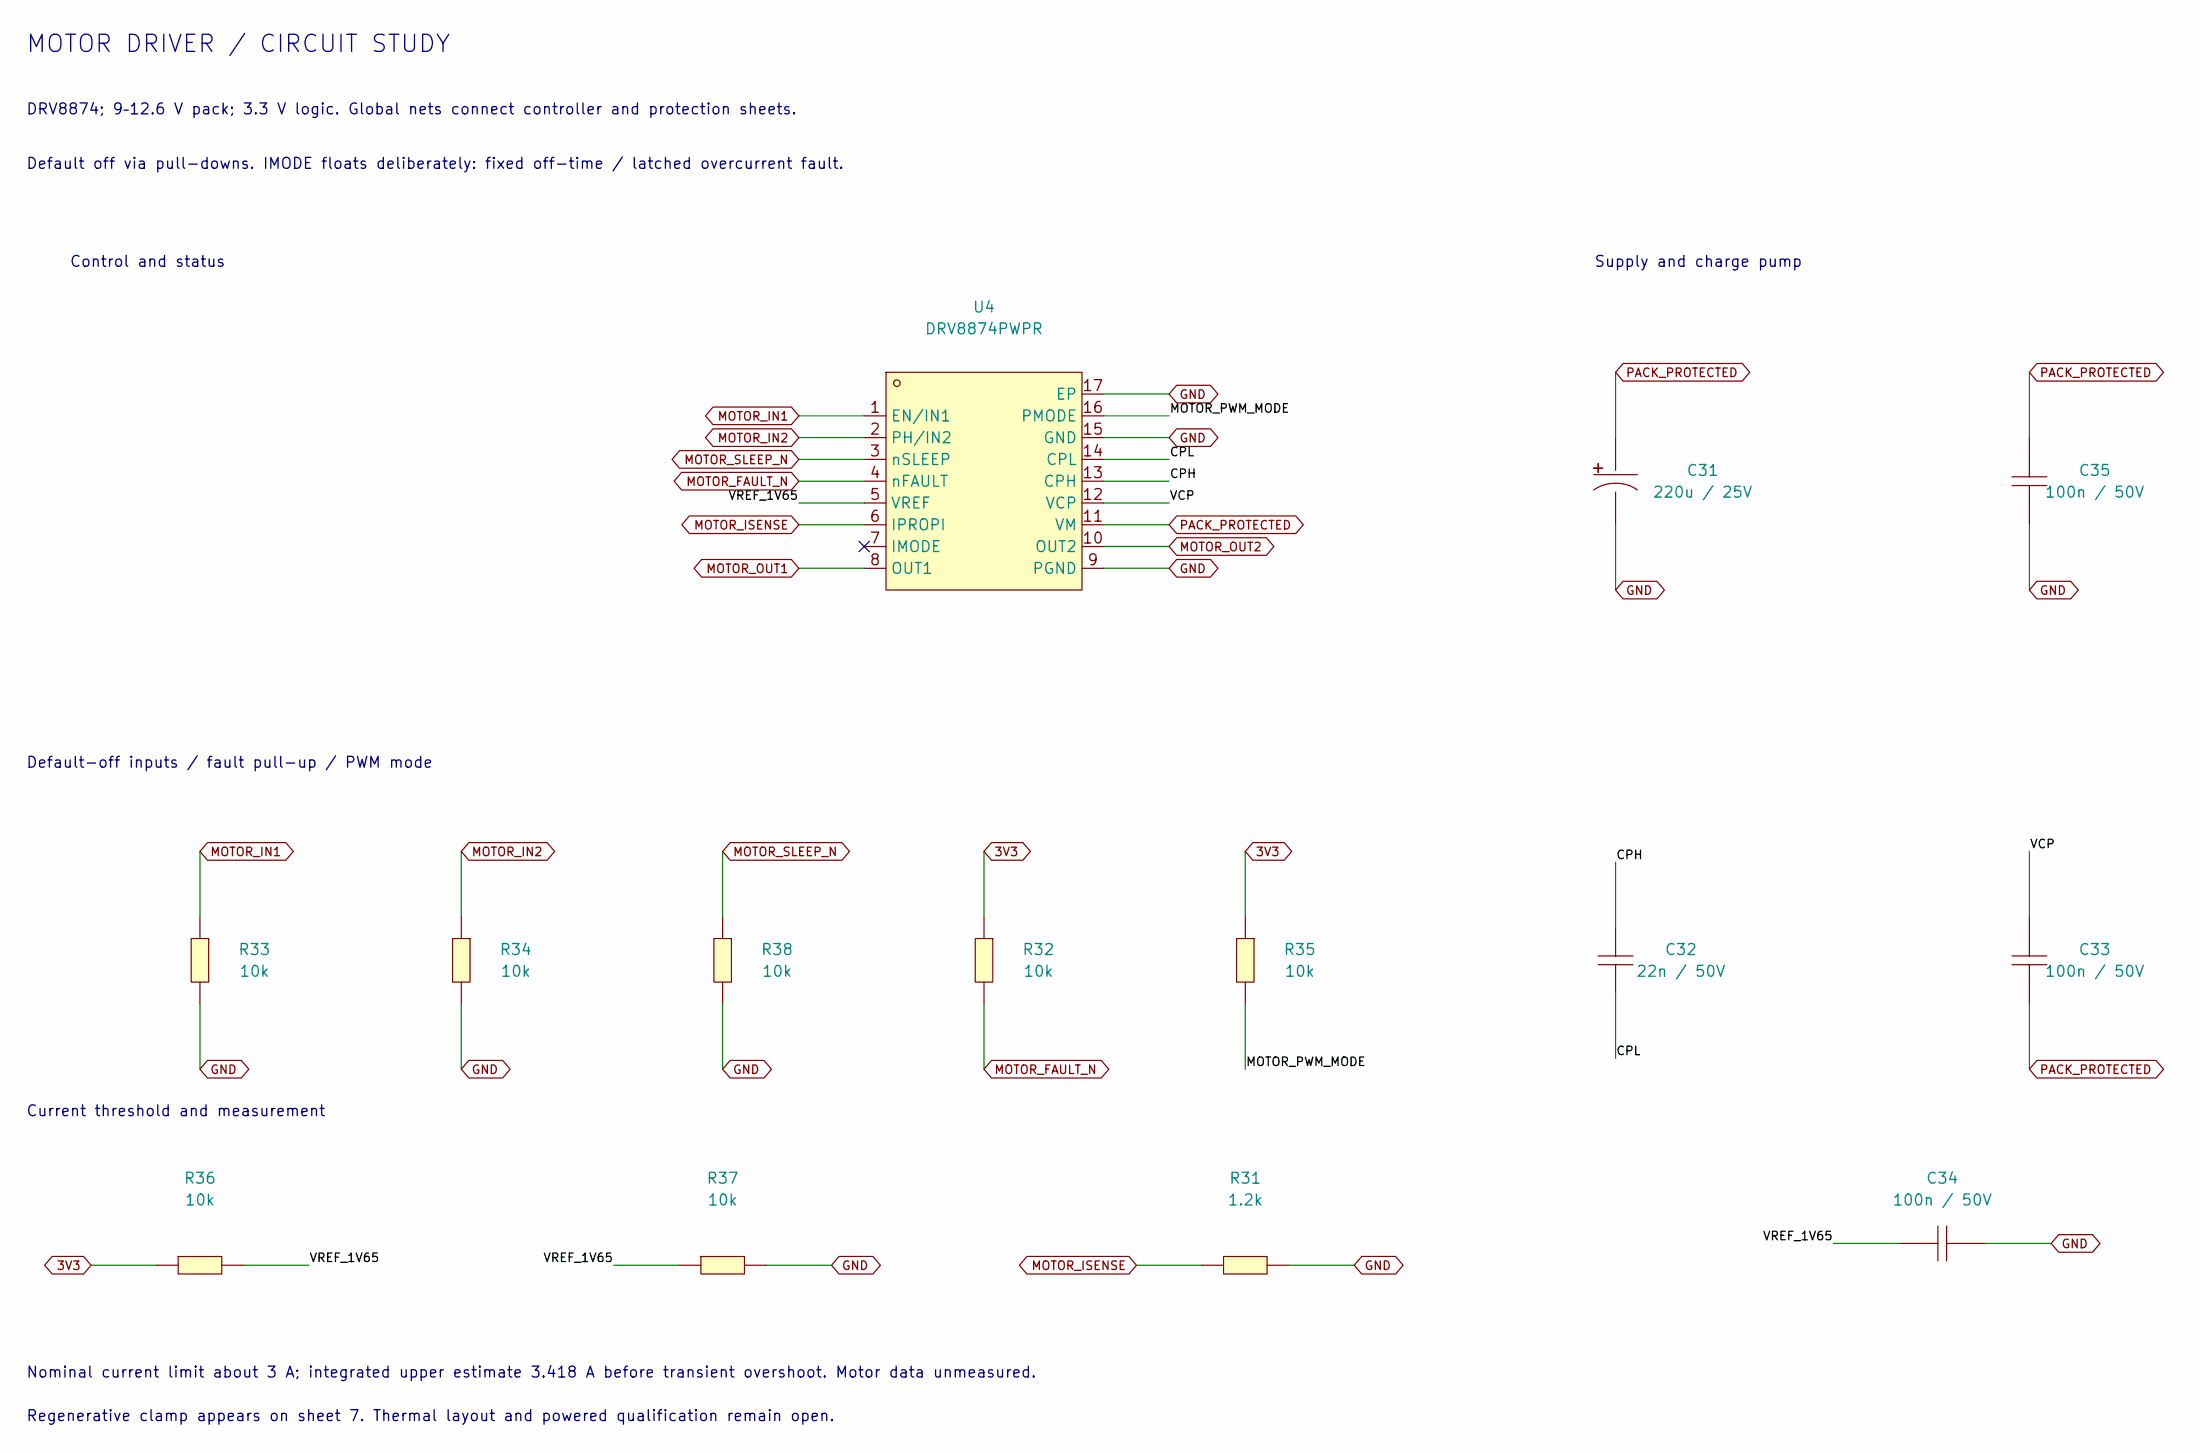
[picture p78: schematic 04-motor.kicad_sch]

Parts:
C31: 220u / 25V; CAP-SMD_BD6.3-L6.6-W6.6-LS7.3-FD; MPN UCM1E221MCL1GS; LCSC C340768
C32: 22n / 50V; C0402; MPN 0402B223K500NT; LCSC C1532
C33, C34, C35: 100n / 50V; C0402; MPN CL05B104KB54PNC; LCSC C307331
R31: 1.2k; R0402; MPN 0402WGF1201TCE; LCSC C25862
R32, R33, R34, R35, R36, R37, R38: 10k; R0402; MPN 0402WGF1002TCE; LCSC C25744
U4: DRV8874PWPR; HTSSOP-16_L5.0-W4.4-P0.65-LS6.4-BL-EP; MPN DRV8874PWPR; LCSC C1855818

Connections:
3V3: R32.1, R35.1, R36.1
CPH: C32.1, U4.13 (CPH)
CPL: C32.2, U4.14 (CPL)
GND: C31.2, C34.2, C35.2, R31.2, R33.2, R34.2, R37.2, R38.2, U4.9 (PGND), U4.15 (GND), U4.17 (EP)
MOTOR_FAULT_N: R32.2, U4.4 (nFAULT)
MOTOR_IN1: R33.1, U4.1 (EN/IN1)
MOTOR_IN2: R34.1, U4.2 (PH/IN2)
MOTOR_ISENSE: R31.1, U4.6 (IPROPI)
MOTOR_OUT1: U4.8 (OUT1)
MOTOR_OUT2: U4.10 (OUT2)
MOTOR_PWM_MODE: R35.2, U4.16 (PMODE)
MOTOR_SLEEP_N: R38.1, U4.3 (nSLEEP)
PACK_PROTECTED: C31.1, C33.2, C35.1, U4.11 (VM)
VCP: C33.1, U4.12 (VCP)
VREF_1V65: C34.1, R36.2, R37.1, U4.5 (VREF)

Notes on the sheet:
MOTOR DRIVER / CIRCUIT STUDY
DRV8874; 9–12.6 V pack; 3.3 V logic. Global nets connect controller and protection sheets.
Default off via pull-downs. IMODE floats deliberately: fixed off-time / latched overcurrent fault.
Control and status
Supply and charge pump
Default-off inputs / fault pull-up / PWM mode
Current threshold and measurement
Nominal current limit about 3 A; integrated upper estimate 3.418 A before transient overshoot. Motor data unmeasured.
Regenerative clamp appears on sheet 7. Thermal layout and powered qualification remain open.
