0x63616c/smart-blinds/hw/schematics/blind-main/05-supervision.kicad_sch

## KiCad design hw/schematics/blind-main/05-supervision.kicad_sch (2026-10-20)

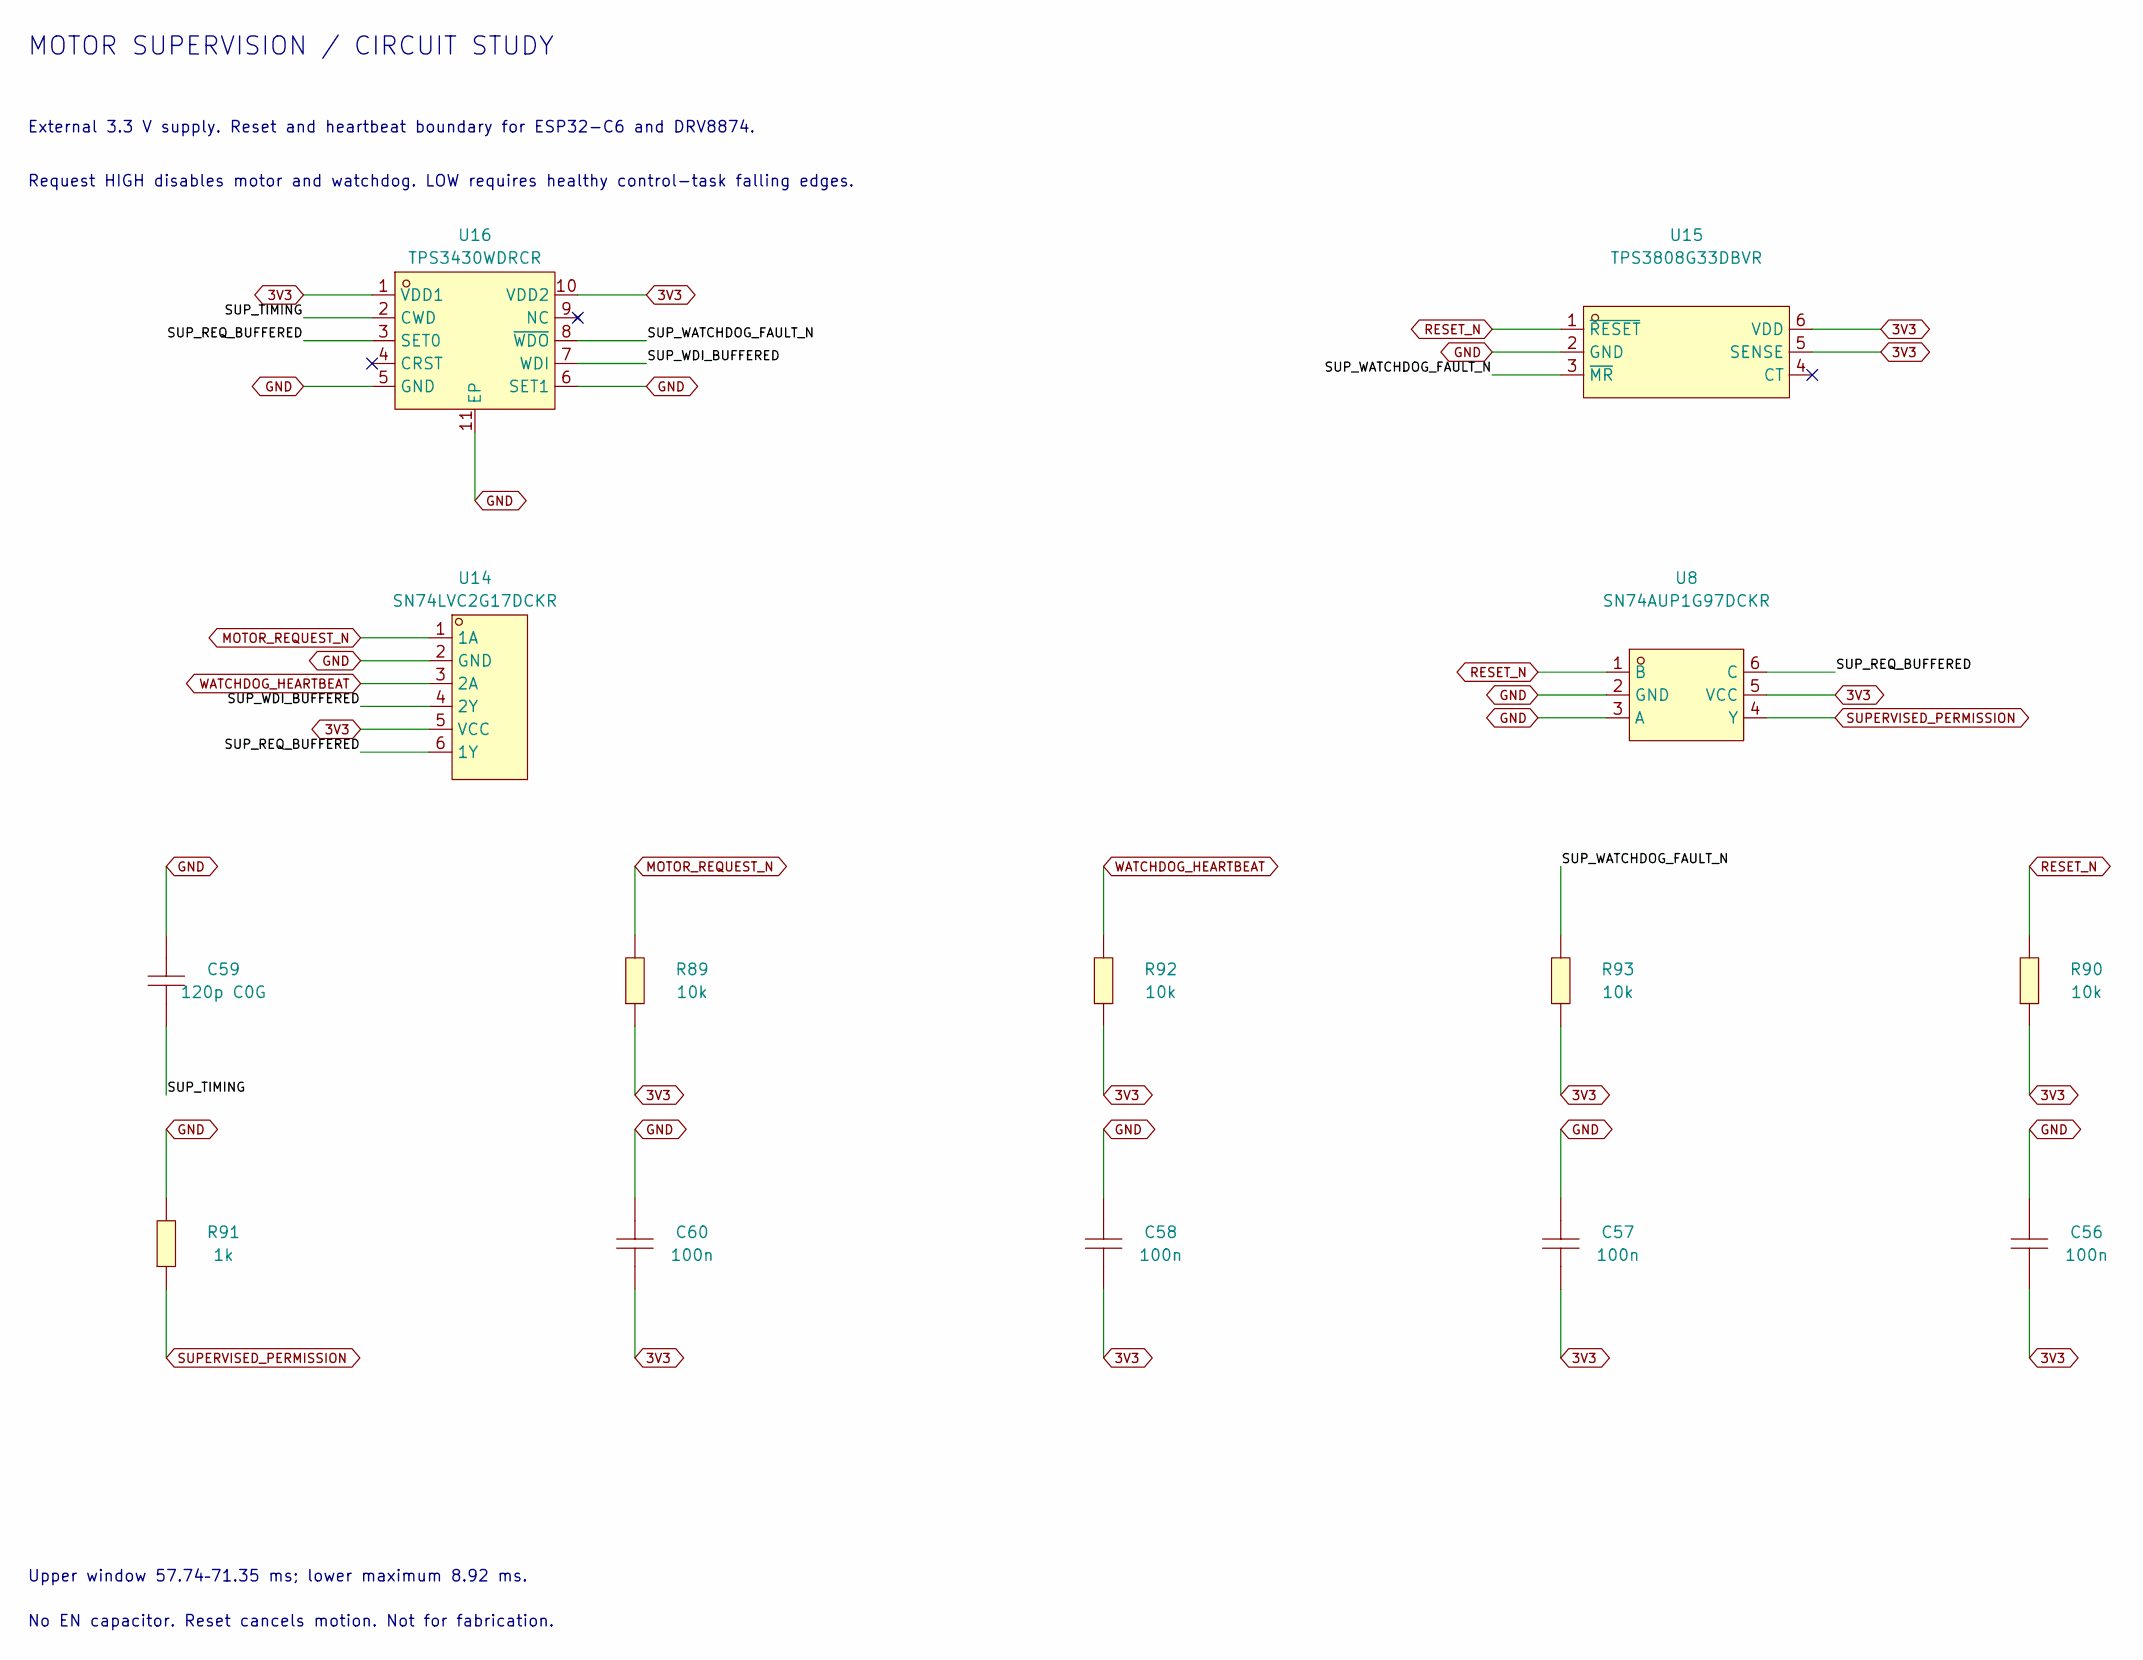
[picture p79: schematic 05-supervision.kicad_sch]

Parts:
C56, C57, C58, C60: 100n; C0402; MPN CL05B104KB54PNC; LCSC C307331
C59: 120p C0G; C0402; MPN CL05C121JB5NNNC; LCSC C307442
R89, R90, R92, R93: 10k; R0402; MPN 0402WGF1002TCE; LCSC C25744
R91: 1k; R0402; MPN 0402WGF1001TCE; LCSC C11702
U8: SN74AUP1G97DCKR; SC-70-6_L2.0-W1.3-P0.65-LS2.1-BR; MPN SN74AUP1G97DCKR; LCSC C2682139
U14: SN74LVC2G17DCKR; SOT-363_L2.0-W1.3-P0.65-LS2.1-BR; MPN SN74LVC2G17DCKR; LCSC C50714
U15: TPS3808G33DBVR; SOT-23-6_L2.9-W1.6-P0.95-LS2.8-BR; MPN TPS3808G33DBVR; LCSC C43698
U16: TPS3430WDRCR; VSON-10_L3.0-W3.0-P0.50-TL-EP; MPN TPS3430WDRCR; LCSC C2870545

Connections:
3V3: C56.1, C57.1, C58.1, C60.1, R89.1, R90.1, R92.1, R93.1, U8.5 (VCC), U14.5 (VCC), U15.5 (SENSE), U15.6 (VDD), U16.1 (VDD1), U16.10 (VDD2)
GND: C56.2, C57.2, C58.2, C59.2, C60.2, R91.2, U8.2 (GND), U8.3 (A), U14.2 (GND), U15.2 (GND), U16.5 (GND), U16.6 (SET1), U16.11 (EP)
MOTOR_REQUEST_N: R89.2, U14.1 (1A)
RESET_N: R90.2, U8.1 (B), U15.1 (~RESET)
SUPERVISED_PERMISSION: R91.1, U8.4 (Y)
SUP_REQ_BUFFERED: U8.6 (C), U14.6 (1Y), U16.3 (SET0)
SUP_TIMING: C59.1, U16.2 (CWD)
SUP_WATCHDOG_FAULT_N: R93.2, U15.3 (~MR), U16.8 (~WDO)
SUP_WDI_BUFFERED: U14.4 (2Y), U16.7 (WDI)
WATCHDOG_HEARTBEAT: R92.2, U14.3 (2A)

Notes on the sheet:
MOTOR SUPERVISION / CIRCUIT STUDY
External 3.3 V supply. Reset and heartbeat boundary for ESP32-C6 and DRV8874.
Request HIGH disables motor and watchdog. LOW requires healthy control-task falling edges.
Upper window 57.74–71.35 ms; lower maximum 8.92 ms.
No EN capacitor. Reset cancels motion. Not for fabrication.
