0x63616c/smart-blinds/hw/schematics/blind-main/06-regen.kicad_sch

## KiCad design hw/schematics/blind-main/06-regen.kicad_sch (2026-10-20)

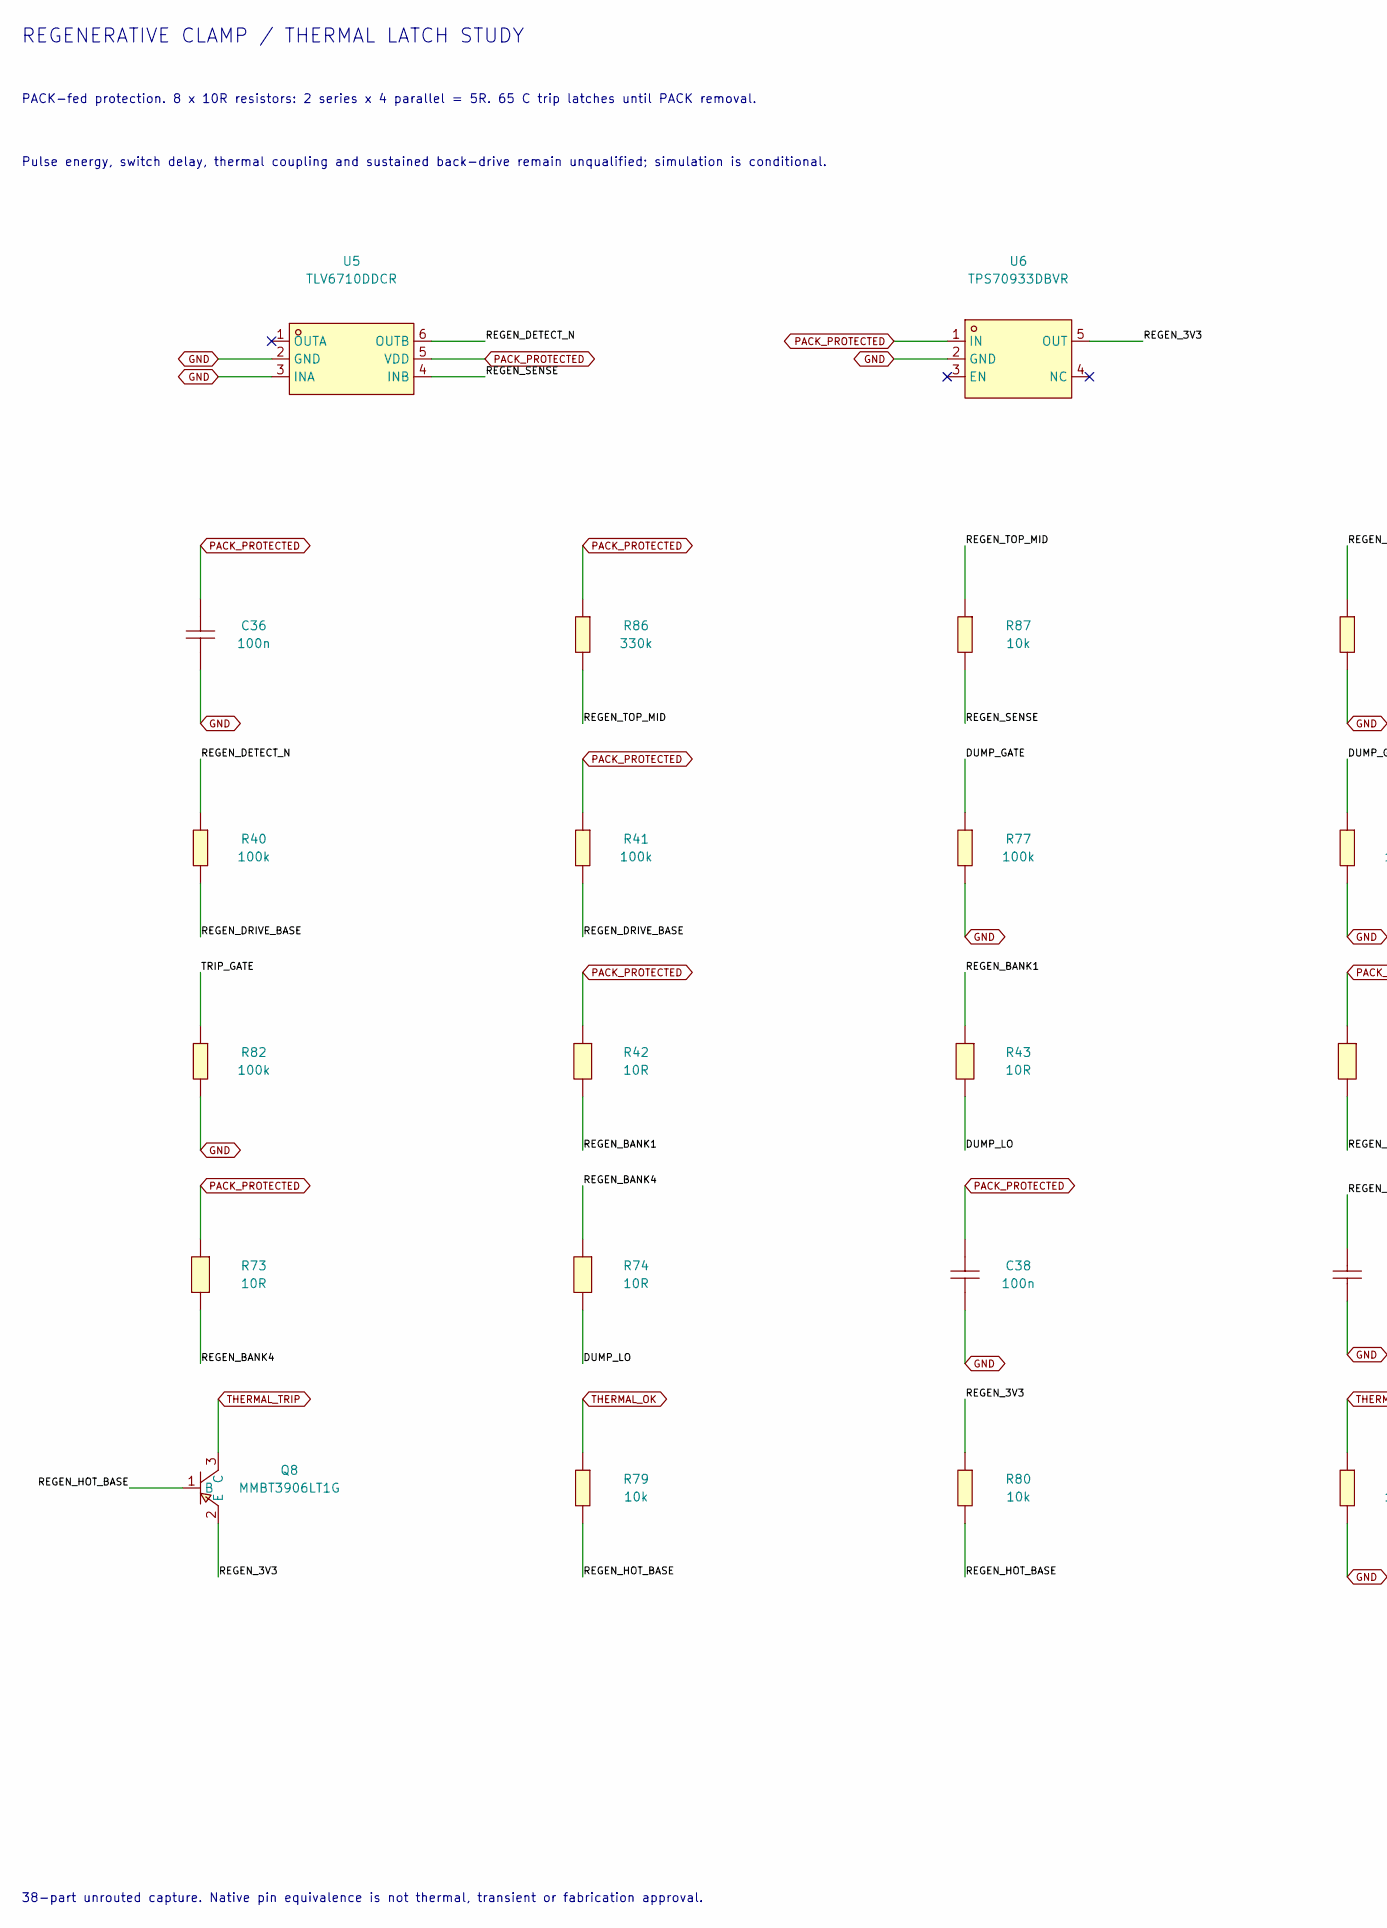
[picture p80: schematic 06-regen.kicad_sch, part in row 1, column 1]

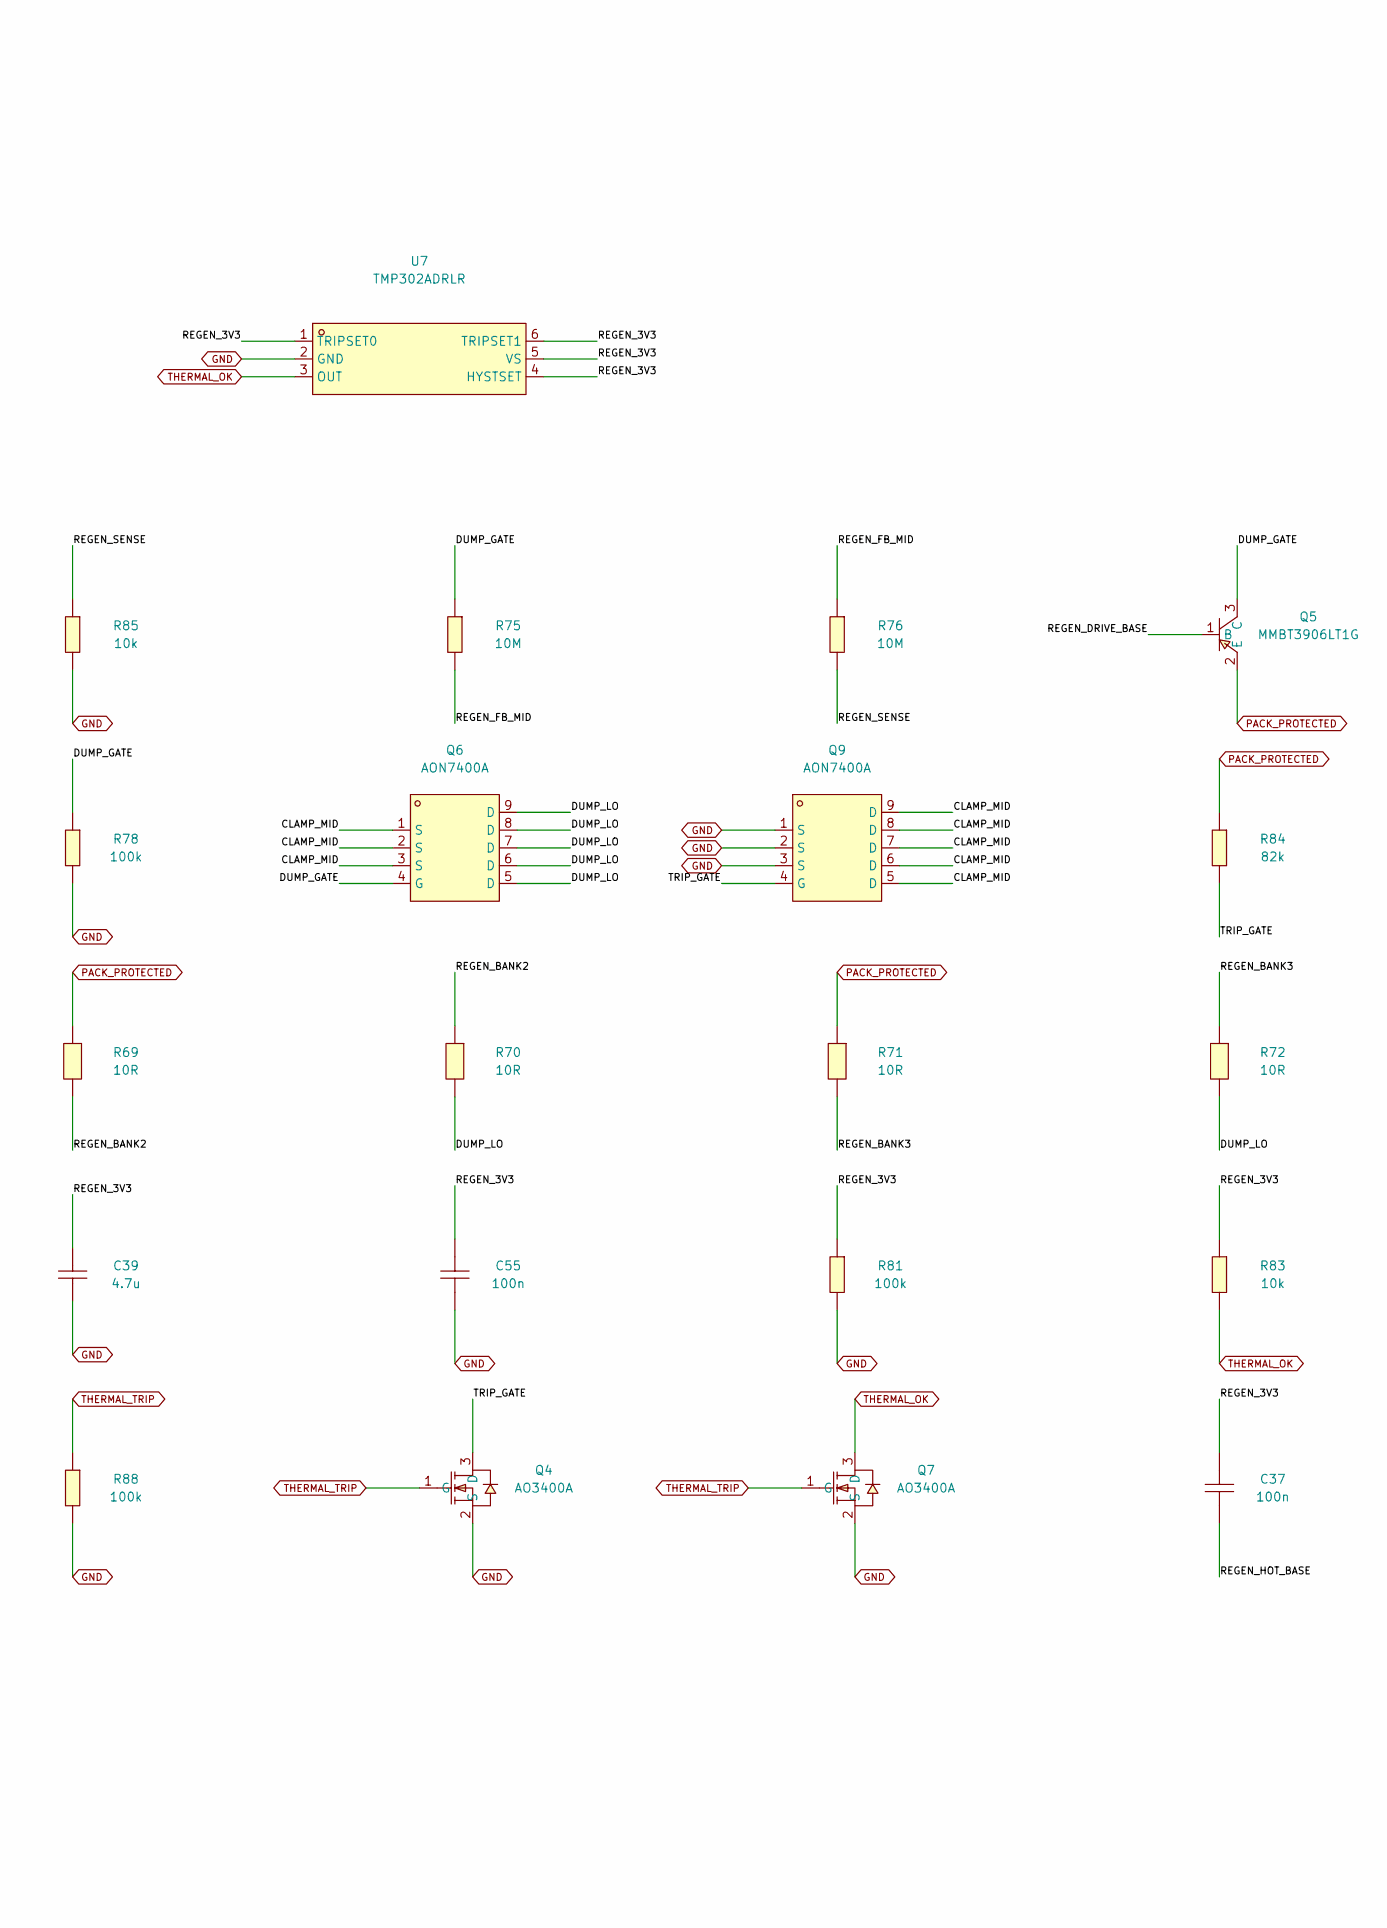
[picture p81: schematic 06-regen.kicad_sch, part in row 1, column 2]

Parts:
C36, C37, C38, C55: 100n; C0402; MPN CL05B104KB54PNC; LCSC C307331
C39: 4.7u; C0805; MPN CL21A475KAQNNNE; LCSC C1779
Q4, Q7: AO3400A; SOT-23-3_L2.9-W1.3-P1.90-LS2.4-BR; MPN AO3400A; LCSC C20917
Q5, Q8: MMBT3906LT1G; SOT-23-3_L2.9-W1.3-P1.90-LS2.4-BR; MPN MMBT3906LT1G; LCSC C53444
Q6, Q9: AON7400A; PDFN-8_L3.3-W3.3-P0.65-BL; MPN AON7400A; LCSC C85734
R40, R41, R77, R78, R81, R82, R88: 100k; R0402; MPN 0402WGF1003TCE; LCSC C25741
R42, R43, R69, R70, R71, R72, R73, R74: 10R; R2512; MPN CRM2512-FX-10R0ELF; LCSC C840605
R75, R76: 10M; R0603; MPN 0603WAF1005T5E; LCSC C7250
R79, R80, R83, R85, R87: 10k; R0402; MPN 0402WGF1002TCE; LCSC C25744
R84: 82k; R0402; MPN 0402WGF8202TCE; LCSC C4142
R86: 330k; R0402; MPN 0402WGF3303TCE; LCSC C25778
U5: TLV6710DDCR; TSOT-23-6_L2.9-W1.6-P0.95-LS2.8-BR; MPN TLV6710DDCR; LCSC C2863066
U6: TPS70933DBVR; SOT-23-5_L3.0-W1.7-P0.95-LS2.8-BR; MPN TPS70933DBVR; LCSC C89347
U7: TMP302ADRLR; SOT-5X3-6_W1.6-L1.2-P0.50-LS1.6-BL; MPN TMP302ADRLR; LCSC C2877557

Connections:
CLAMP_MID: Q6.1 (S), Q6.2 (S), Q6.3 (S), Q9.5 (D), Q9.6 (D), Q9.7 (D), Q9.8 (D), Q9.9 (D)
DUMP_GATE: Q5.3 (C), Q6.4 (G), R75.1, R77.1, R78.1
DUMP_LO: Q6.5 (D), Q6.6 (D), Q6.7 (D), Q6.8 (D), Q6.9 (D), R43.2, R70.2, R72.2, R74.2
GND: C36.2, C38.2, C39.2, C55.2, Q4.2 (S), Q7.2 (S), Q9.1 (S), Q9.2 (S), Q9.3 (S), R77.2, R78.2, R81.2, R82.2, R85.2, R88.2, U5.2 (GND), U5.3 (INA), U6.2 (GND), U7.2 (GND)
PACK_PROTECTED: C36.1, C38.1, Q5.2 (E), R41.1, R42.1, R69.1, R71.1, R73.1, R84.1, R86.1, U5.5 (VDD), U6.1 (IN)
REGEN_3V3: C37.1, C39.1, C55.1, Q8.2 (E), R80.1, R81.1, R83.1, U6.5 (OUT), U7.1 (TRIPSET0), U7.4 (HYSTSET), U7.5 (VS), U7.6 (TRIPSET1)
REGEN_BANK1: R42.2, R43.1
REGEN_BANK2: R69.2, R70.1
REGEN_BANK3: R71.2, R72.1
REGEN_BANK4: R73.2, R74.1
REGEN_DETECT_N: R40.1, U5.6 (OUTB)
REGEN_DRIVE_BASE: Q5.1 (B), R40.2, R41.2
REGEN_FB_MID: R75.2, R76.1
REGEN_HOT_BASE: C37.2, Q8.1 (B), R79.2, R80.2
REGEN_SENSE: R76.2, R85.1, R87.2, U5.4 (INB)
REGEN_TOP_MID: R86.2, R87.1
THERMAL_OK: Q7.3 (D), R79.1, R83.2, U7.3 (OUT)
THERMAL_TRIP: Q4.1 (G), Q7.1 (G), Q8.3 (C), R88.1
TRIP_GATE: Q4.3 (D), Q9.4 (G), R82.1, R84.2

Notes on the sheet:
REGENERATIVE CLAMP / THERMAL LATCH STUDY
PACK-fed protection. 8 x 10R resistors: 2 series x 4 parallel = 5R. 65 C trip latches until PACK removal.
Pulse energy, switch delay, thermal coupling and sustained back-drive remain unqualified; simulation is conditional.
38-part unrouted capture. Native pin equivalence is not thermal, transient or fabrication approval.
