0x63616c/smart-blinds/hw/schematics/blind-main/07-radio.kicad_sch

## KiCad design hw/schematics/blind-main/07-radio.kicad_sch (2026-10-20)

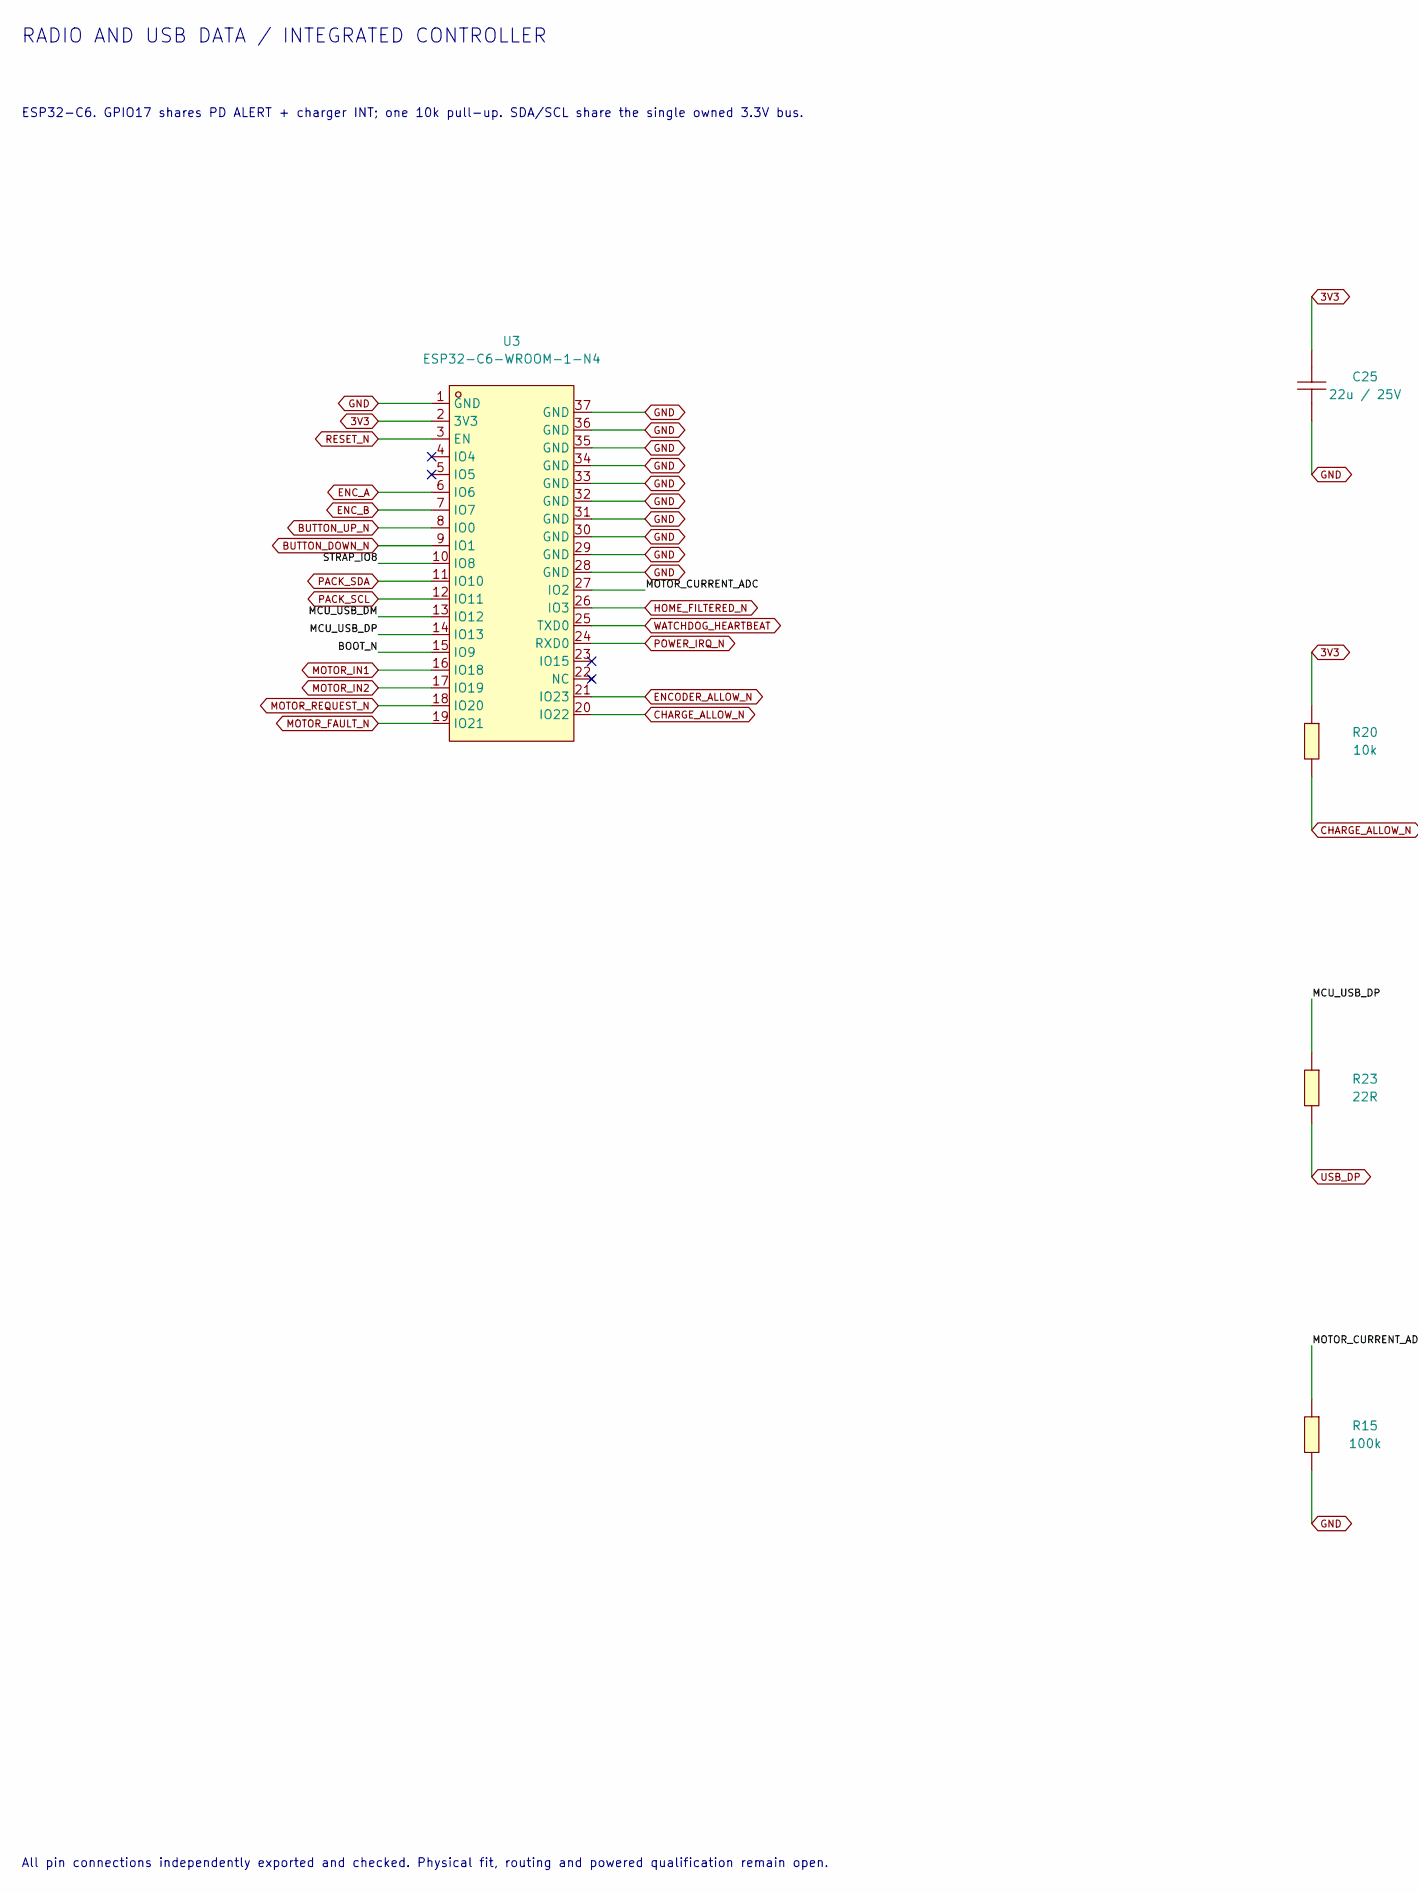
[picture p82: schematic 07-radio.kicad_sch, part in row 1, column 1]

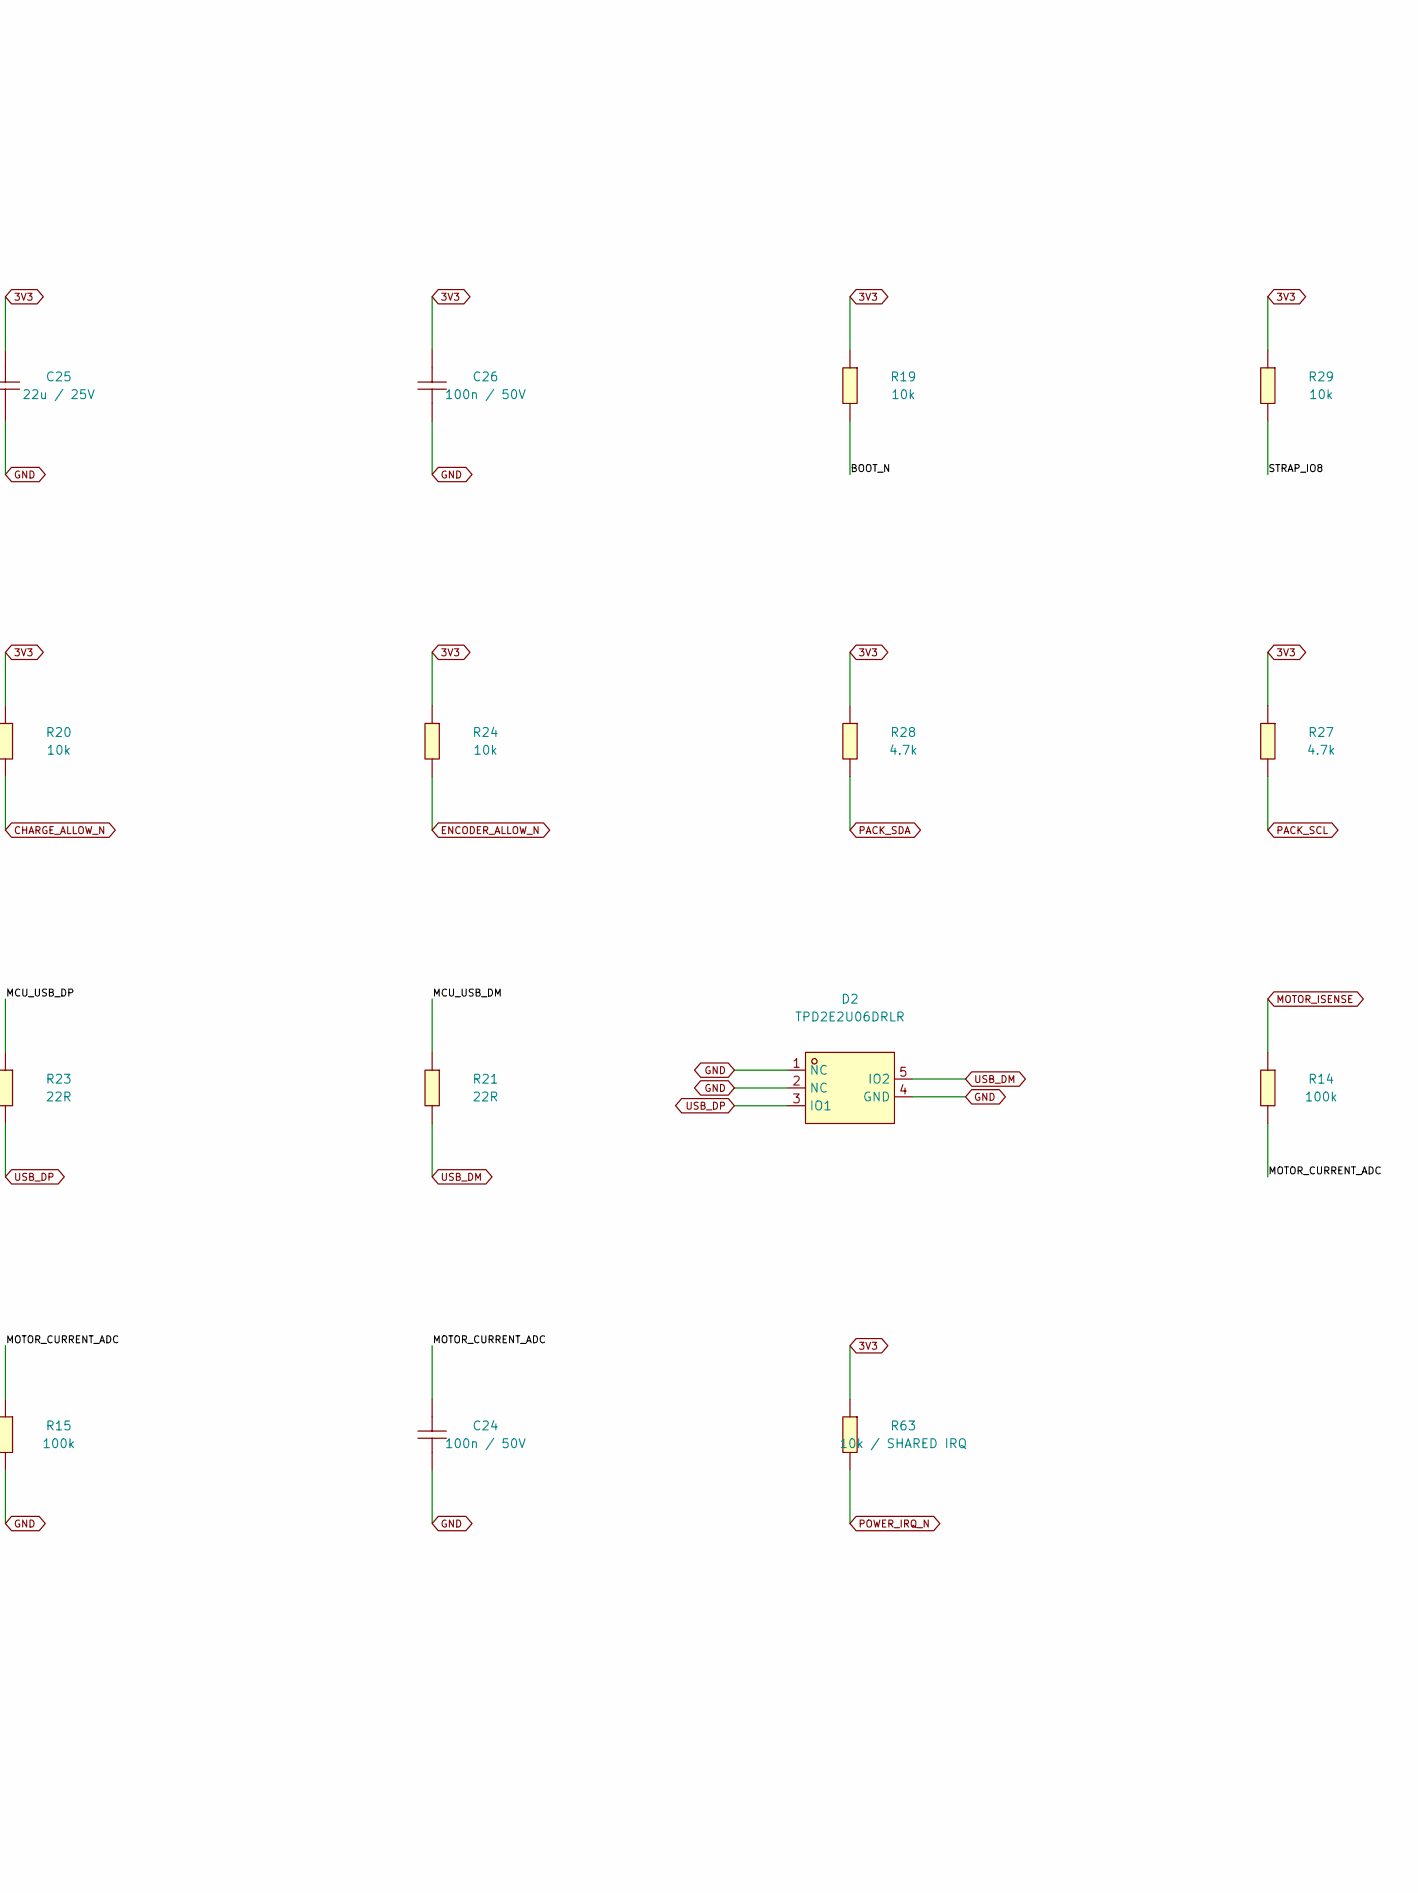
[picture p83: schematic 07-radio.kicad_sch, part in row 1, column 2]

Parts:
C24, C26: 100n / 50V; C0402; MPN CL05B104KB54PNC; LCSC C307331
C25: 22u / 25V; C0805; MPN CL21A226MAYNNNE; LCSC C602037
D2: TPD2E2U06DRLR; SOT-553-5_L1.6-W1.2-P0.50-LS1.6-TL-1; MPN TPD2E2U06DRLR; LCSC C1972959
R14, R15: 100k; R0402; MPN 0402WGF1003TCE; LCSC C25741
R19, R20, R24, R29: 10k; R0402; MPN 0402WGF1002TCE; LCSC C25744
R21, R23: 22R; R0402; MPN 0402WGF220JTCE; LCSC C25092
R27, R28: 4.7k; R0402; MPN 0402WGF4701TCE; LCSC C25900
R63: 10k / SHARED IRQ; R0402; MPN 0402WGF1002TCE; LCSC C25744
U3: ESP32-C6-WROOM-1-N4; WIRELM-SMD_ESP32-C6-WROOM-1; MPN ESP32-C6-WROOM-1-N4; LCSC C6034714

Connections:
3V3: C25.1, C26.1, R19.1, R20.1, R24.1, R27.1, R28.1, R29.1, R63.1, U3.2 (3V3)
BOOT_N: R19.2, U3.15 (IO9)
BUTTON_DOWN_N: U3.9 (IO1)
BUTTON_UP_N: U3.8 (IO0)
CHARGE_ALLOW_N: R20.2, U3.20 (IO22)
ENCODER_ALLOW_N: R24.2, U3.21 (IO23)
ENC_A: U3.6 (IO6)
ENC_B: U3.7 (IO7)
GND: C24.2, C25.2, C26.2, D2.1 (NC), D2.2 (NC), D2.4 (GND), R15.2, U3.1 (GND), U3.28 (GND), U3.29 (GND), U3.30 (GND), U3.31 (GND), U3.32 (GND), U3.33 (GND), U3.34 (GND), U3.35 (GND), U3.36 (GND), U3.37 (GND)
HOME_FILTERED_N: U3.26 (IO3)
MCU_USB_DM: R21.1, U3.13 (IO12)
MCU_USB_DP: R23.1, U3.14 (IO13)
MOTOR_CURRENT_ADC: C24.1, R14.2, R15.1, U3.27 (IO2)
MOTOR_FAULT_N: U3.19 (IO21)
MOTOR_IN1: U3.16 (IO18)
MOTOR_IN2: U3.17 (IO19)
MOTOR_ISENSE: R14.1
MOTOR_REQUEST_N: U3.18 (IO20)
PACK_SCL: R27.2, U3.12 (IO11)
PACK_SDA: R28.2, U3.11 (IO10)
POWER_IRQ_N: R63.2, U3.24 (RXD0)
RESET_N: U3.3 (EN)
STRAP_IO8: R29.2, U3.10 (IO8)
USB_DM: D2.5 (IO2), R21.2
USB_DP: D2.3 (IO1), R23.2
WATCHDOG_HEARTBEAT: U3.25 (TXD0)

Notes on the sheet:
RADIO AND USB DATA / INTEGRATED CONTROLLER
ESP32-C6. GPIO17 shares PD ALERT + charger INT; one 10k pull-up. SDA/SCL share the single owned 3.3V bus.
All pin connections independently exported and checked. Physical fit, routing and powered qualification remain open.
