0x63616c/smart-blinds/hw/schematics/blind-main/08-encoder-input.kicad_sch

## KiCad design hw/schematics/blind-main/08-encoder-input.kicad_sch (2026-10-20)

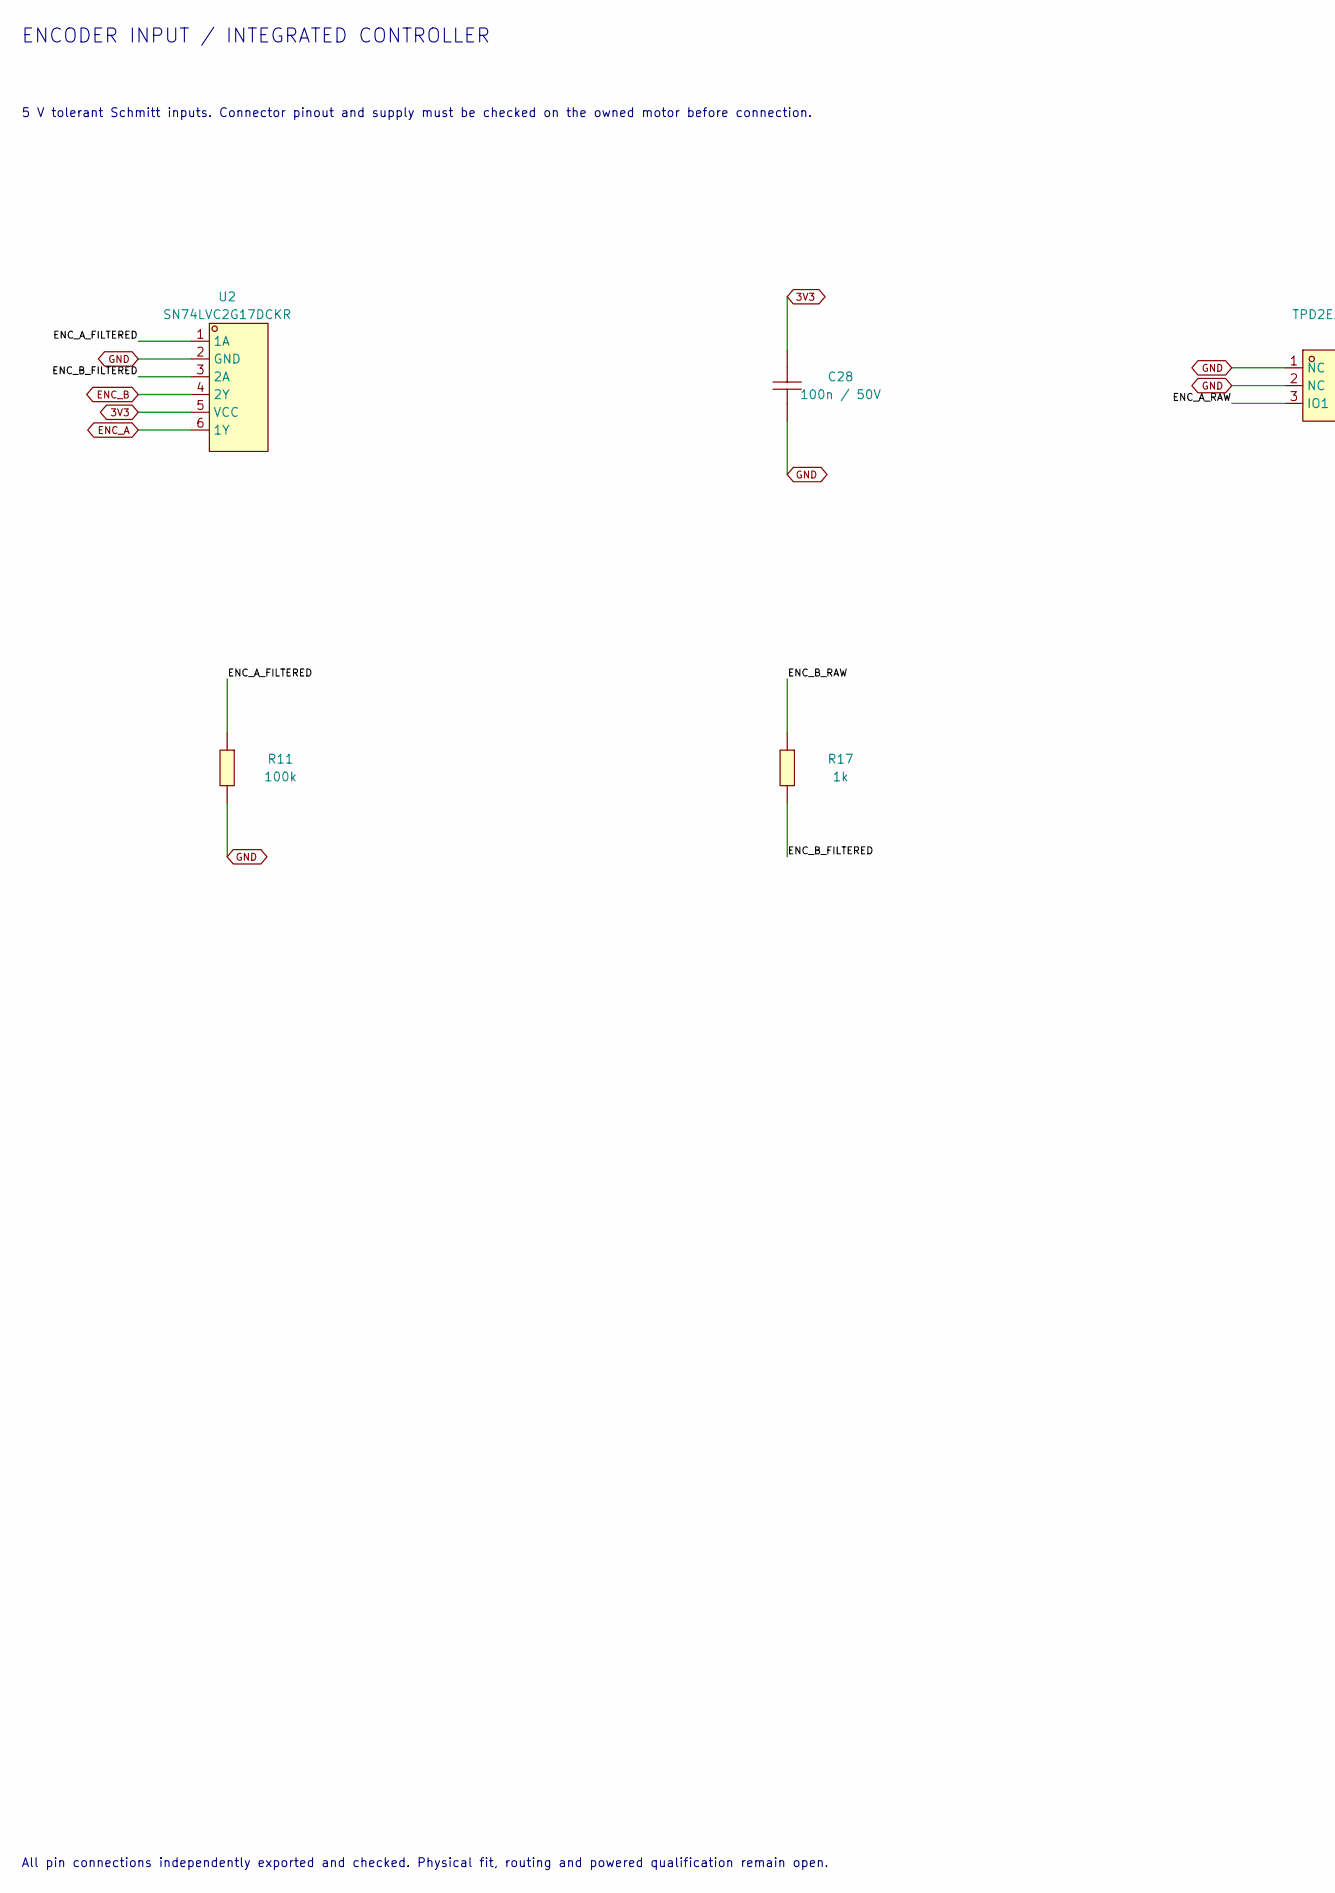
[picture p84: schematic 08-encoder-input.kicad_sch, part in row 1, column 1]

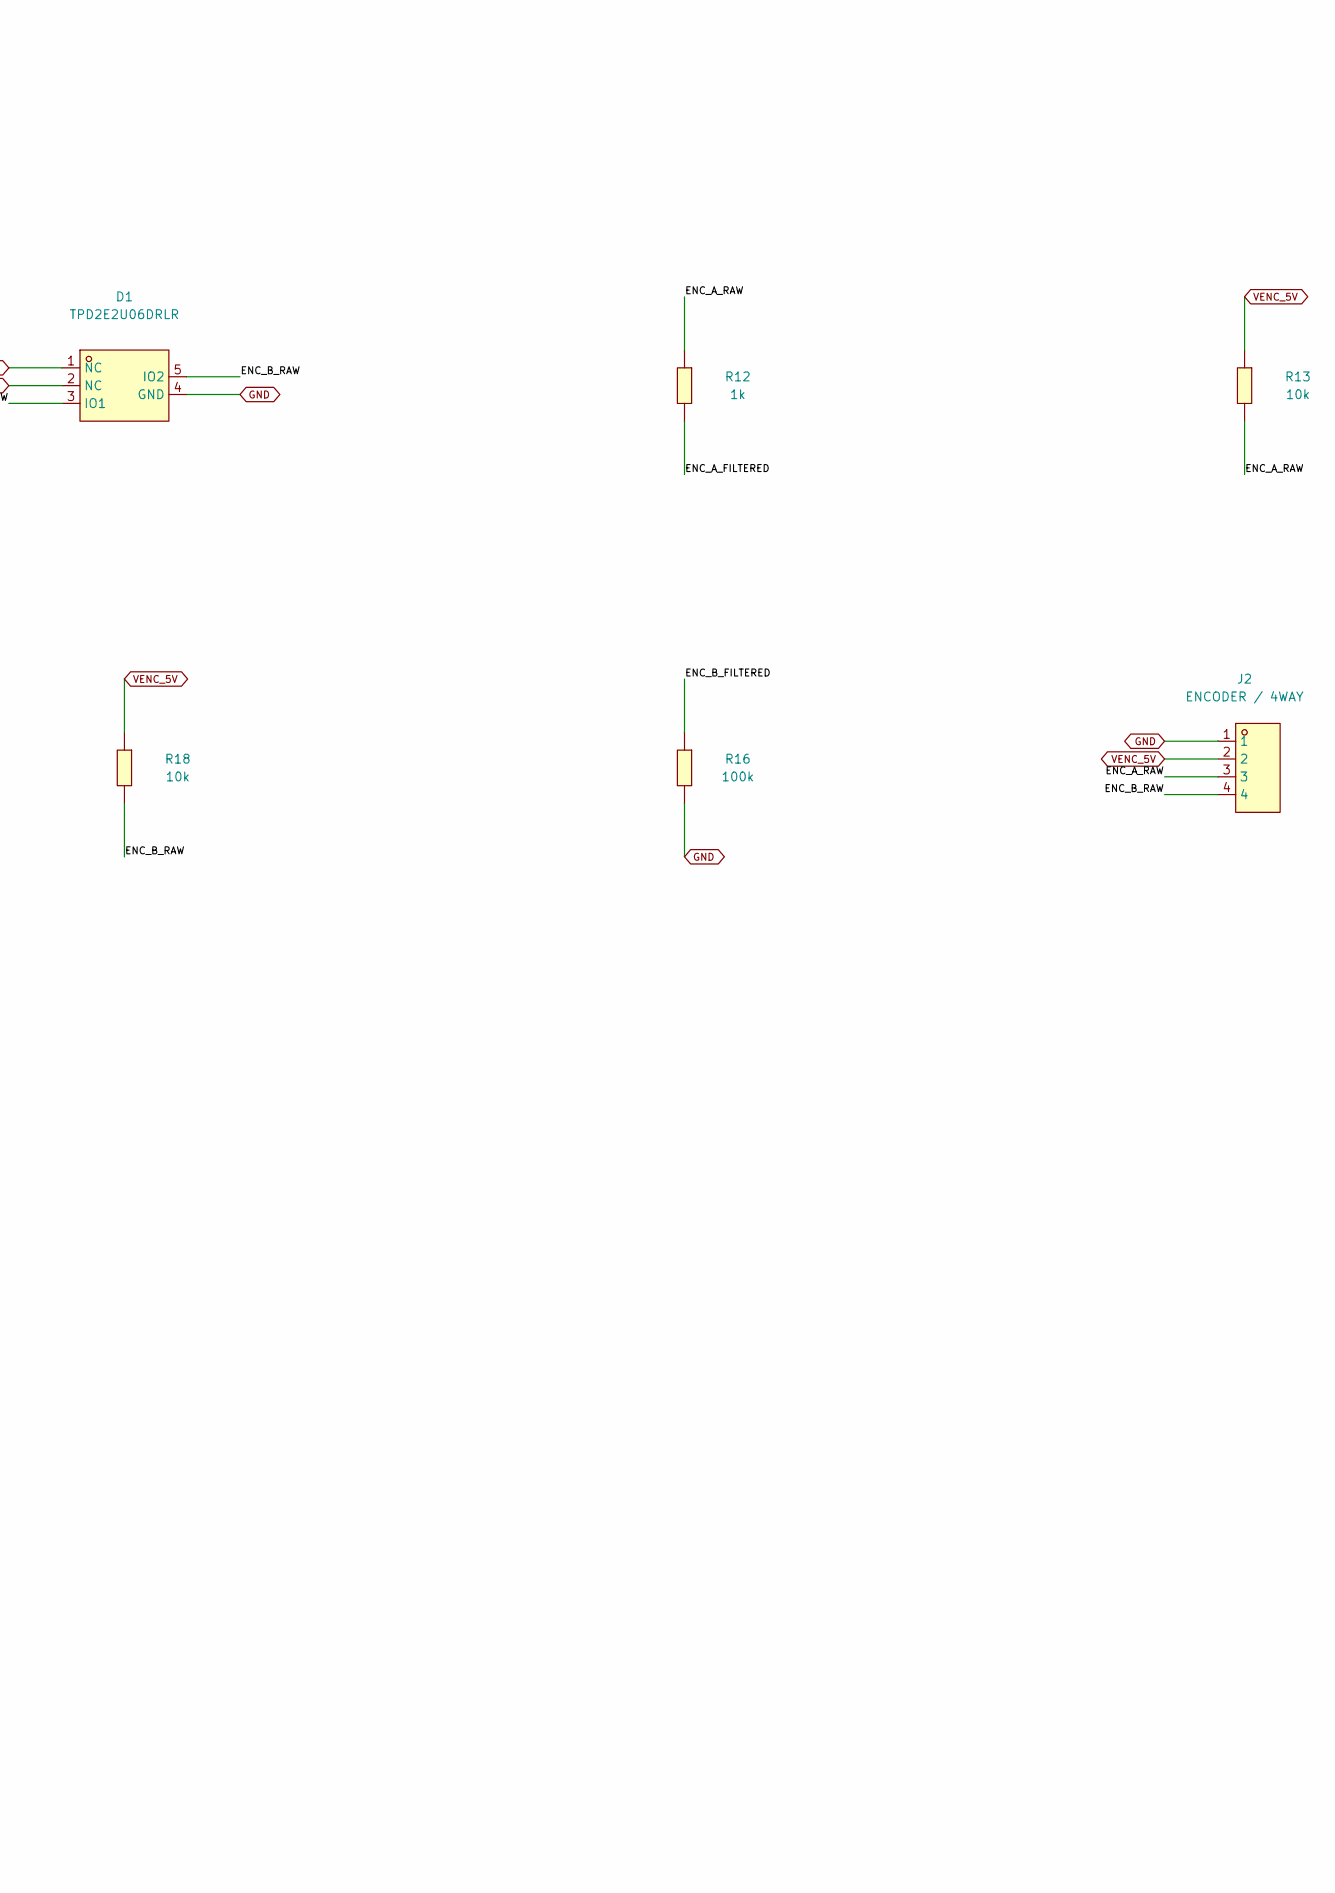
[picture p85: schematic 08-encoder-input.kicad_sch, part in row 1, column 2]

Parts:
C28: 100n / 50V; C0402; MPN CL05B104KB54PNC; LCSC C307331
D1: TPD2E2U06DRLR; SOT-553-5_L1.6-W1.2-P0.50-LS1.6-TL-1; MPN TPD2E2U06DRLR; LCSC C1972959
J2: ENCODER / 4WAY; CONN-SMD_4P-P1.25_53261-0471; MPN 532610471; LCSC C696092
R11, R16: 100k; R0402; MPN 0402WGF1003TCE; LCSC C25741
R12, R17: 1k; R0402; MPN 0402WGF1001TCE; LCSC C11702
R13, R18: 10k; R0402; MPN 0402WGF1002TCE; LCSC C25744
U2: SN74LVC2G17DCKR; SOT-363_L2.0-W1.3-P0.65-LS2.1-BR; MPN SN74LVC2G17DCKR; LCSC C50714

Connections:
3V3: C28.1, U2.5 (VCC)
ENC_A: U2.6 (1Y)
ENC_A_FILTERED: R11.1, R12.2, U2.1 (1A)
ENC_A_RAW: D1.3 (IO1), J2.3, R12.1, R13.2
ENC_B: U2.4 (2Y)
ENC_B_FILTERED: R16.1, R17.2, U2.3 (2A)
ENC_B_RAW: D1.5 (IO2), J2.4, R17.1, R18.2
GND: C28.2, D1.1 (NC), D1.2 (NC), D1.4 (GND), J2.1, R11.2, R16.2, U2.2 (GND)
VENC_5V: J2.2, R13.1, R18.1

Notes on the sheet:
ENCODER INPUT / INTEGRATED CONTROLLER
5 V tolerant Schmitt inputs. Connector pinout and supply must be checked on the owned motor before connection.
All pin connections independently exported and checked. Physical fit, routing and powered qualification remain open.
