0x63616c/smart-blinds/hw/schematics/blind-main/09-local-input.kicad_sch

## KiCad design hw/schematics/blind-main/09-local-input.kicad_sch (2026-10-20)

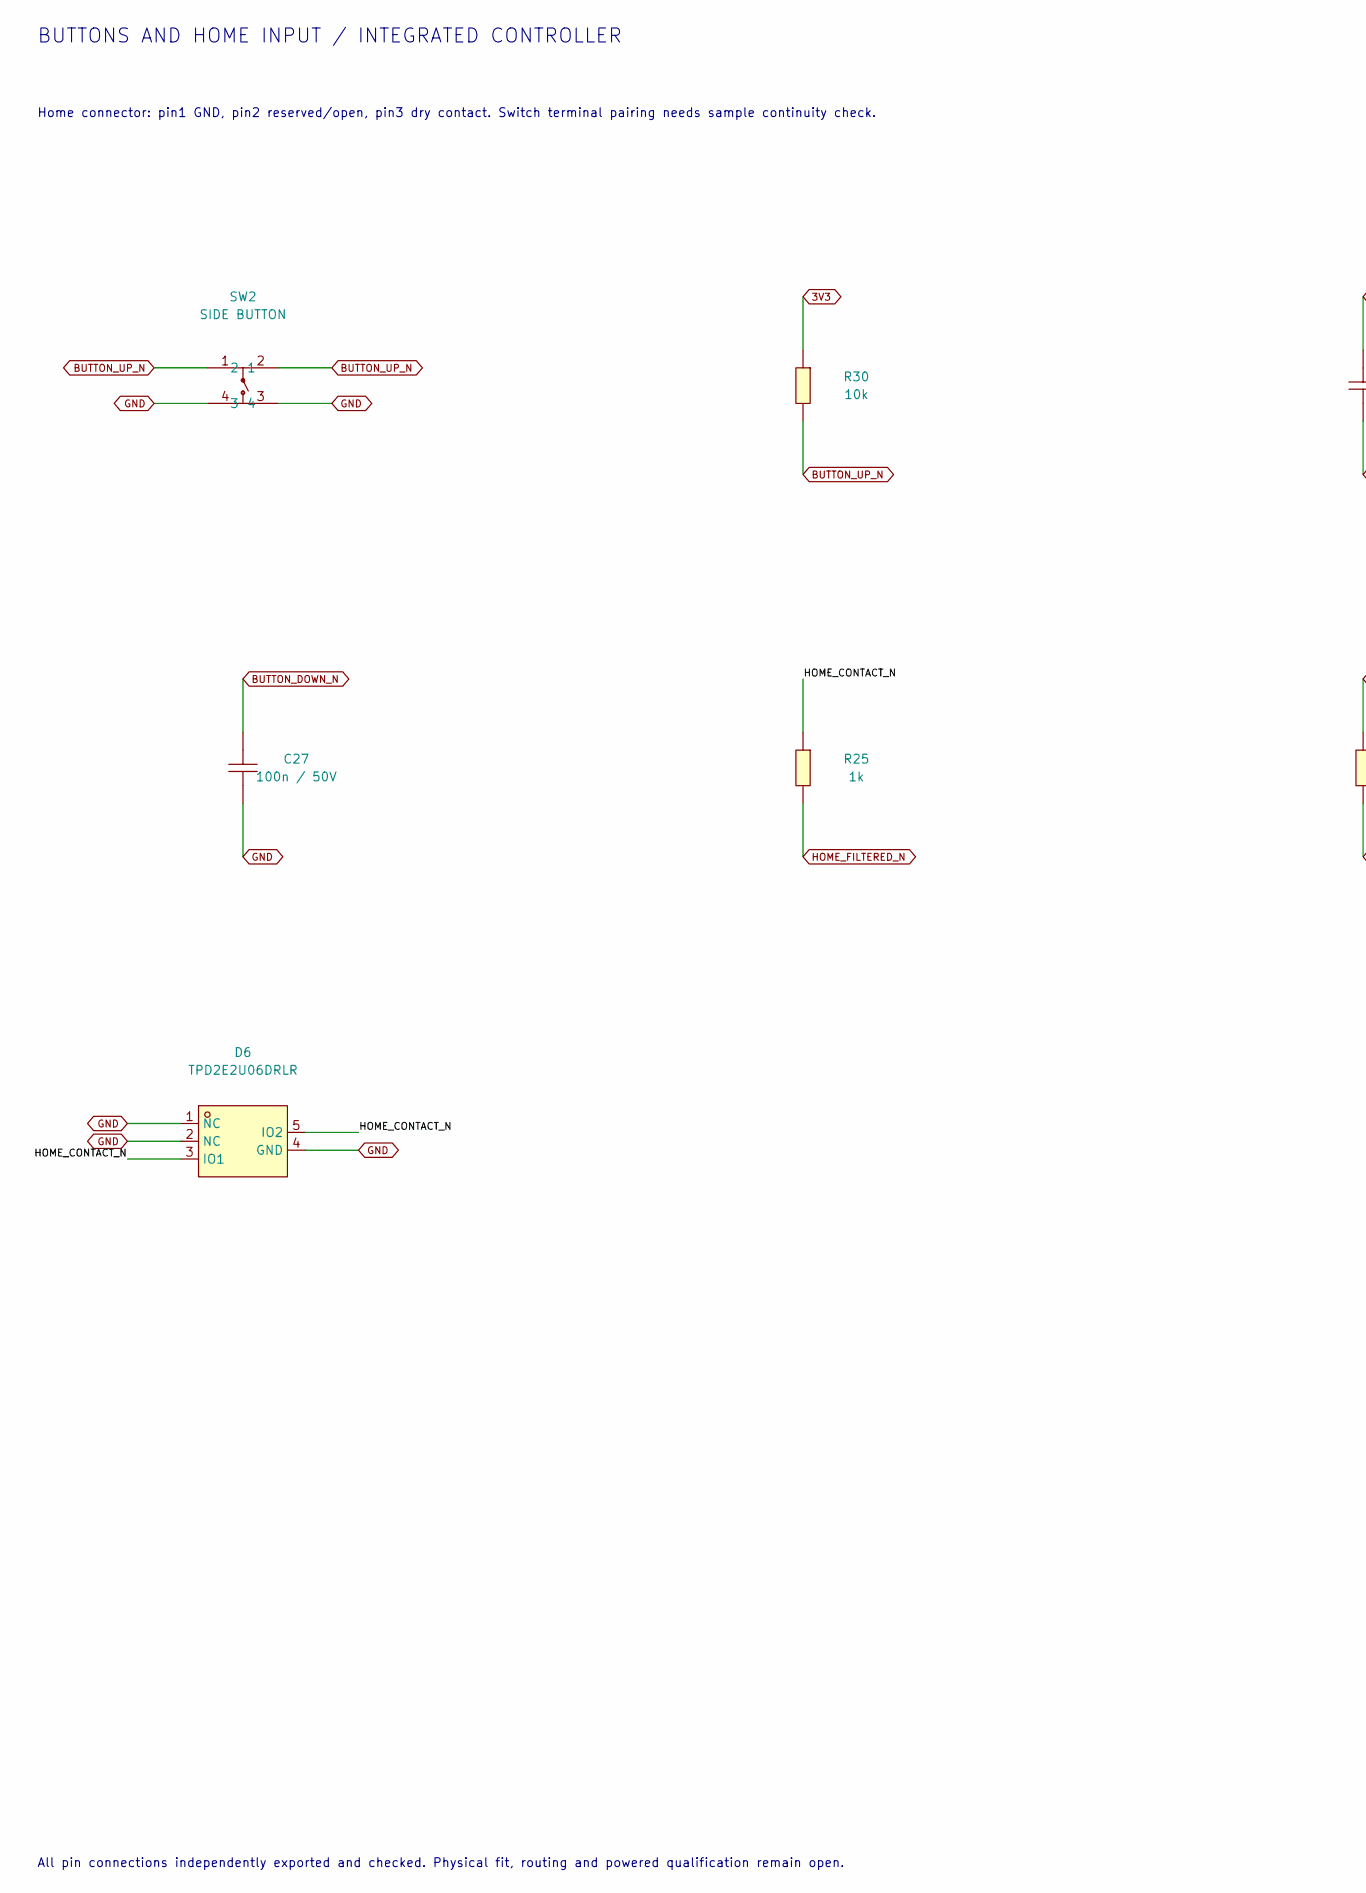
[picture p86: schematic 09-local-input.kicad_sch, part in row 1, column 1]

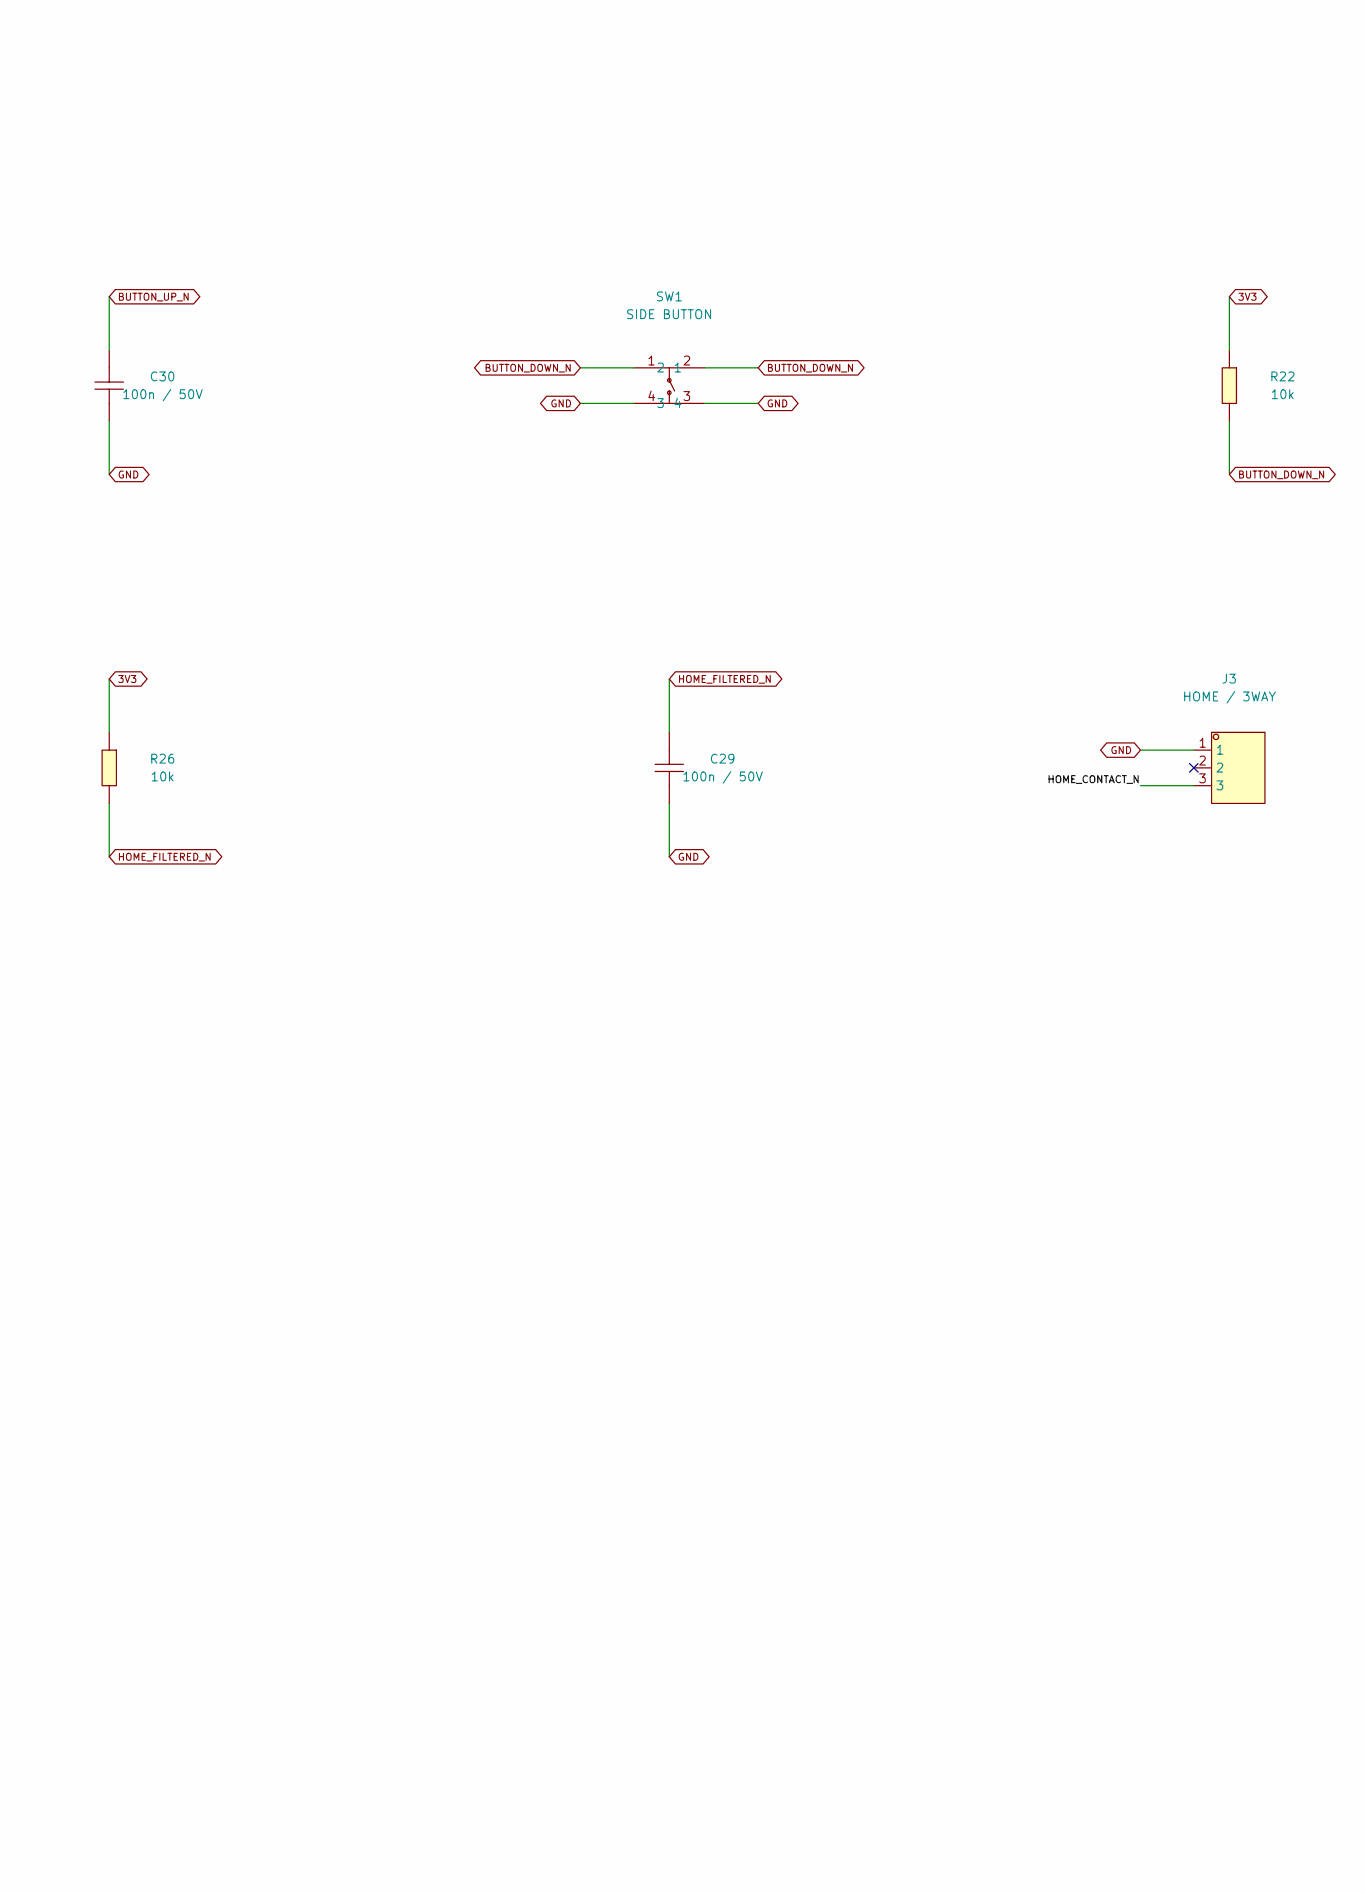
[picture p87: schematic 09-local-input.kicad_sch, part in row 1, column 2]

Parts:
C27, C29, C30: 100n / 50V; C0402; MPN CL05B104KB54PNC; LCSC C307331
D6: TPD2E2U06DRLR; SOT-553-5_L1.6-W1.2-P0.50-LS1.6-TL-1; MPN TPD2E2U06DRLR; LCSC C1972959
J3: HOME / 3WAY; CONN-TH_532610371; MPN 532610371; LCSC C293630
R22, R26, R30: 10k; R0402; MPN 0402WGF1002TCE; LCSC C25744
R25: 1k; R0402; MPN 0402WGF1001TCE; LCSC C11702
SW1, SW2: SIDE BUTTON; SW-SMD_4P-L3.5-W3.0-P1.6-LS4.6; MPN TS-1081S-AC01326; LCSC C720493

Connections:
3V3: R22.1, R26.1, R30.1
BUTTON_DOWN_N: C27.1, R22.2, SW1.1, SW1.2
BUTTON_UP_N: C30.1, R30.2, SW2.1, SW2.2
GND: C27.2, C29.2, C30.2, D6.1 (NC), D6.2 (NC), D6.4 (GND), J3.1, SW1.3, SW1.4, SW2.3, SW2.4
HOME_CONTACT_N: D6.3 (IO1), D6.5 (IO2), J3.3, R25.1
HOME_FILTERED_N: C29.1, R25.2, R26.2

Notes on the sheet:
BUTTONS AND HOME INPUT / INTEGRATED CONTROLLER
Home connector: pin1 GND, pin2 reserved/open, pin3 dry contact. Switch terminal pairing needs sample continuity check.
All pin connections independently exported and checked. Physical fit, routing and powered qualification remain open.
