0x63616c/smart-blinds/hw/schematics/blind-main/10-interfaces.kicad_sch

## KiCad design hw/schematics/blind-main/10-interfaces.kicad_sch (2026-10-20)

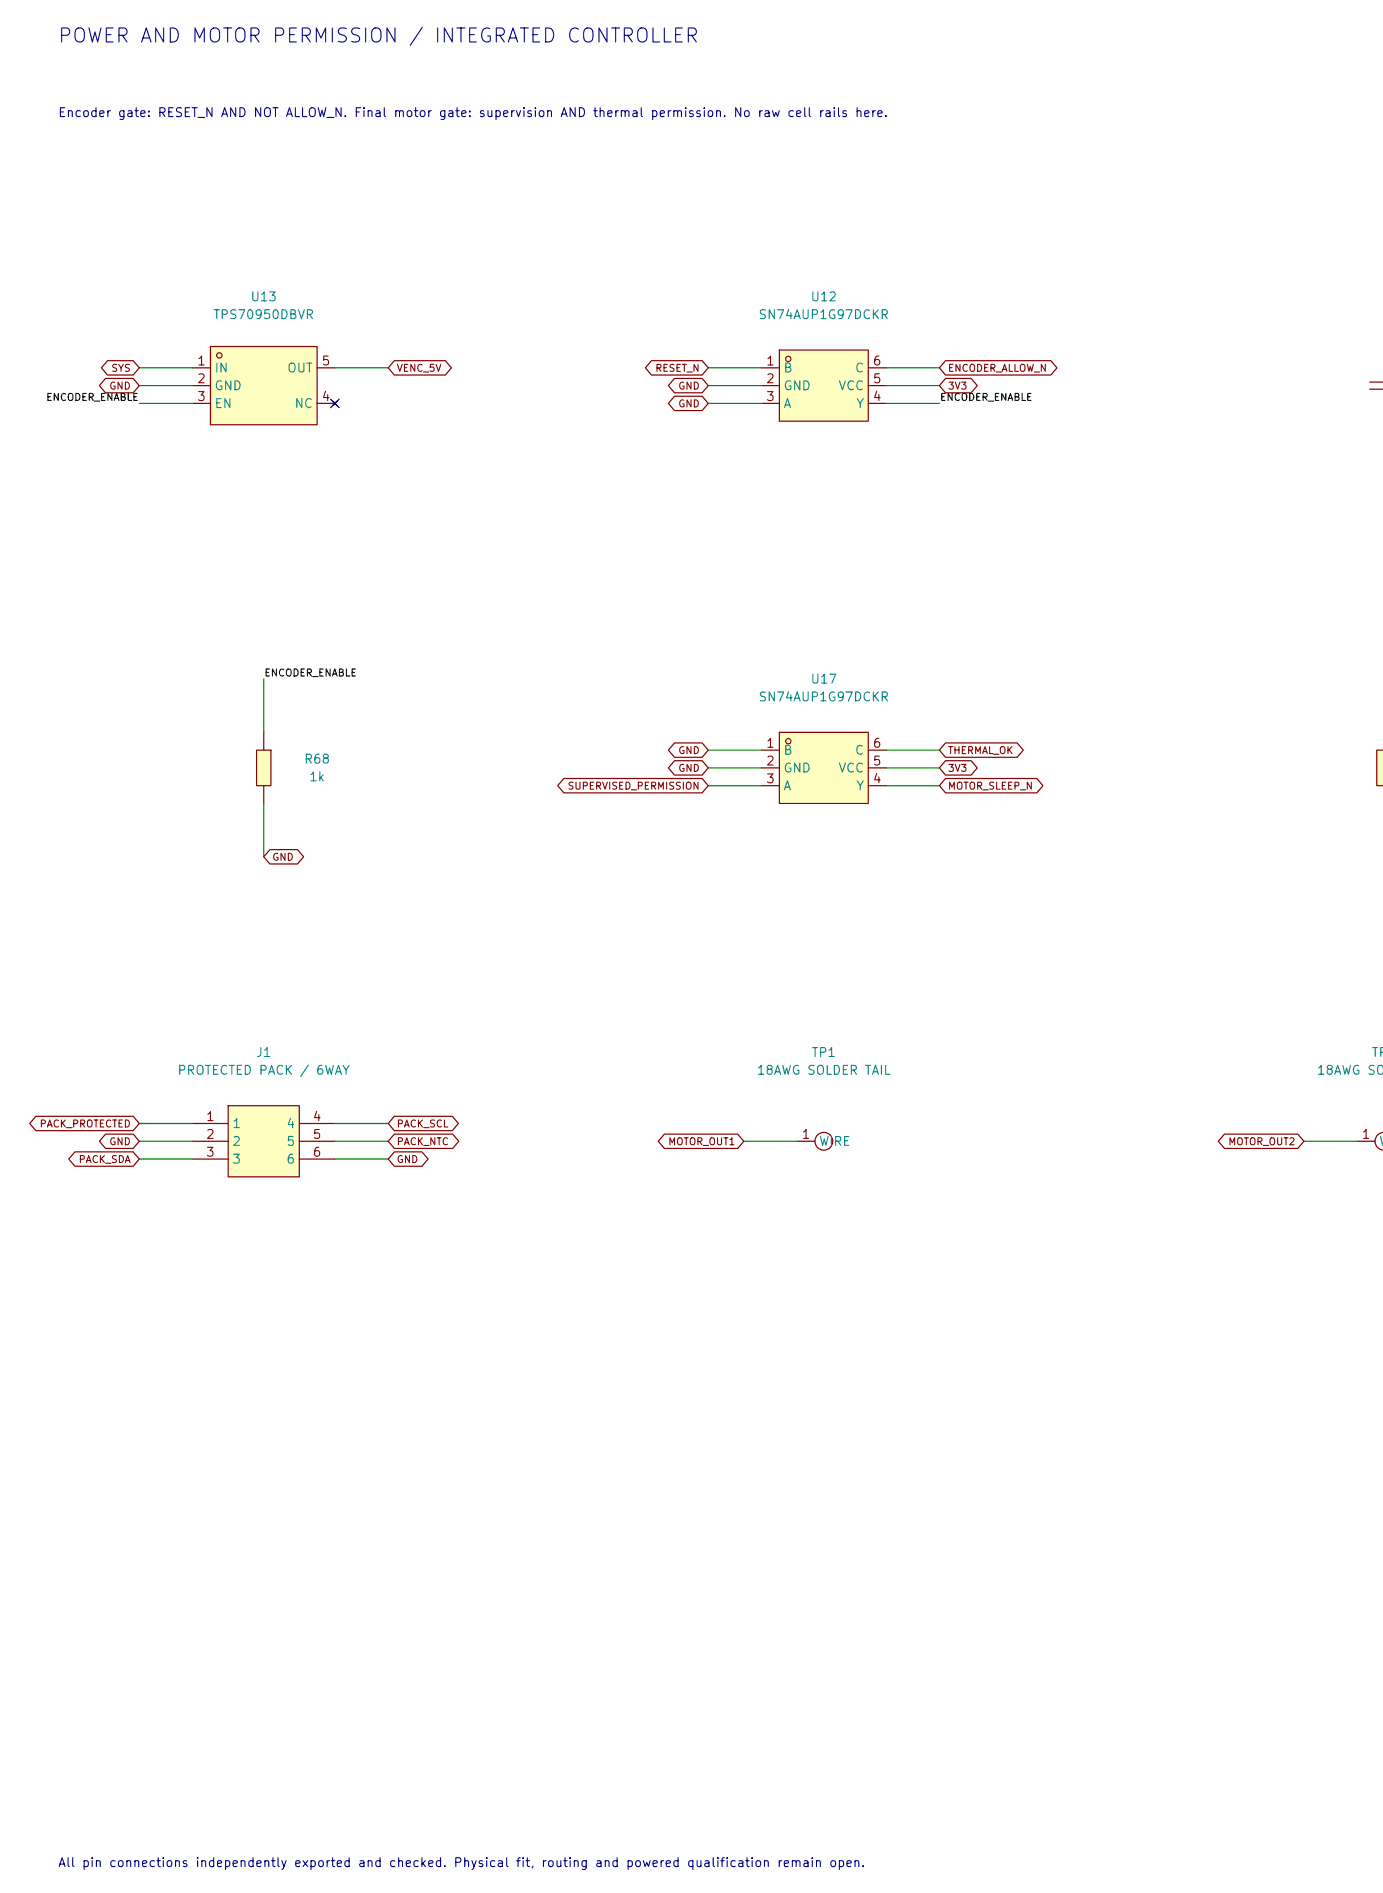
[picture p88: schematic 10-interfaces.kicad_sch, part in row 1, column 1]

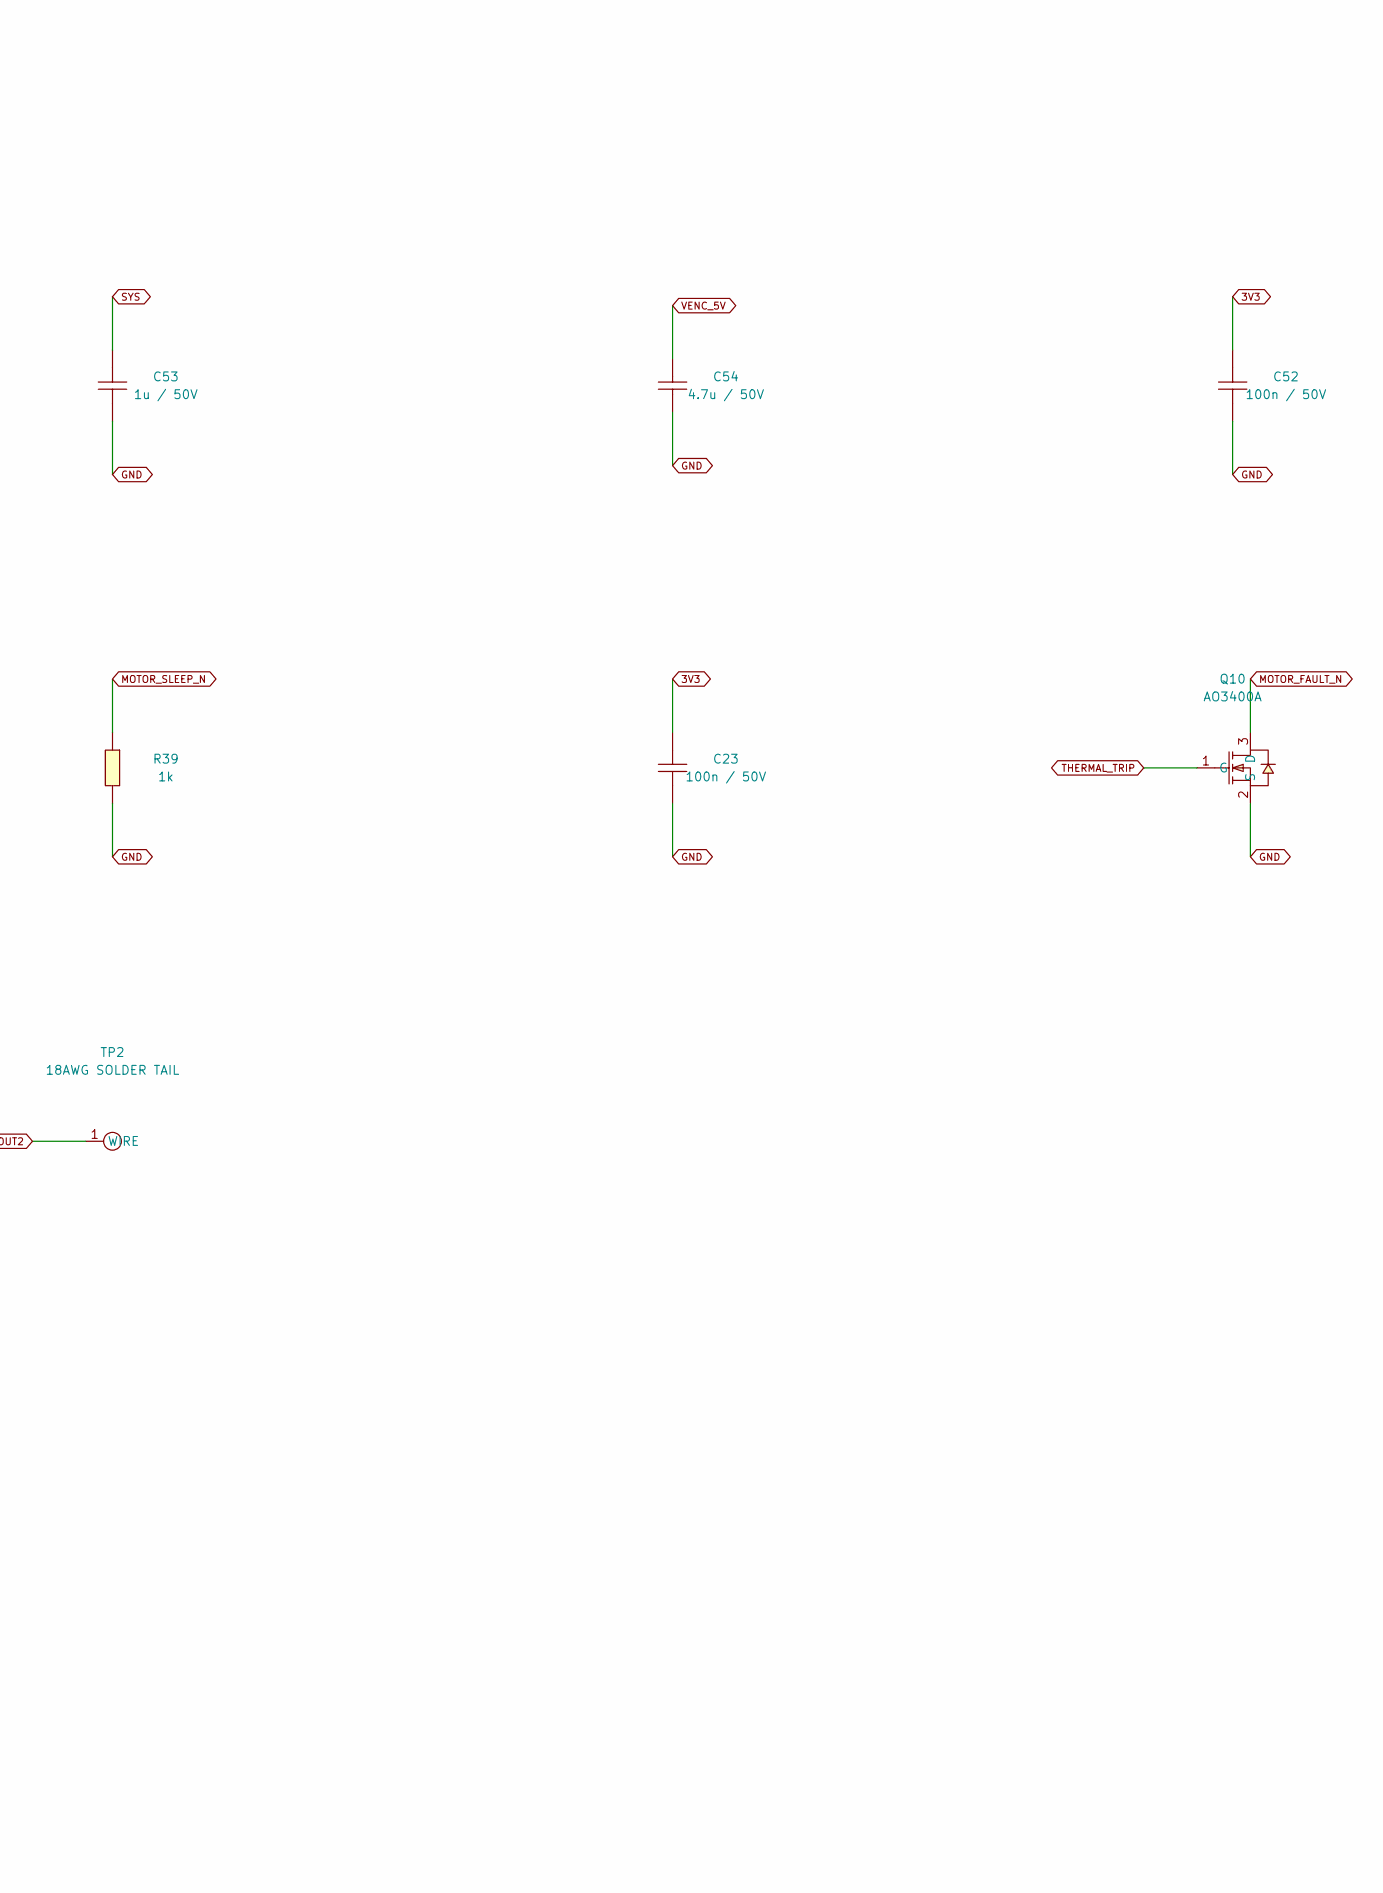
[picture p89: schematic 10-interfaces.kicad_sch, part in row 1, column 2]

Parts:
C23, C52: 100n / 50V; C0402; MPN CL05B104KB54PNC; LCSC C307331
C53: 1u / 50V; C0603; MPN CL10A105KB8NNNC; LCSC C15849
C54: 4.7u / 50V; C1206; MPN CL31A475KBHNNNE; LCSC C12881
J1: PROTECTED PACK / 6WAY; CONN-TH_43045-0600; MPN 430450600; LCSC C127367
Q10: AO3400A; SOT-23-3_L2.9-W1.3-P1.90-LS2.4-BR; MPN AO3400A; LCSC C20917
R39, R68: 1k; R0402; MPN 0402WGF1001TCE; LCSC C11702
TP1, TP2: 18AWG SOLDER TAIL; WirePad18
U12, U17: SN74AUP1G97DCKR; SC-70-6_L2.0-W1.3-P0.65-LS2.1-BR; MPN SN74AUP1G97DCKR; LCSC C2682139
U13: TPS70950DBVR; SOT-23-5_L3.0-W1.7-P0.95-LS2.8-BR; MPN TPS70950DBVR; LCSC C96028

Connections:
3V3: C23.1, C52.1, U12.5 (VCC), U17.5 (VCC)
ENCODER_ALLOW_N: U12.6 (C)
ENCODER_ENABLE: R68.1, U12.4 (Y), U13.3 (EN)
GND: C23.2, C52.2, C53.2, C54.2, J1.2, J1.6, Q10.2 (S), R39.2, R68.2, U12.2 (GND), U12.3 (A), U13.2 (GND), U17.1 (B), U17.2 (GND)
MOTOR_FAULT_N: Q10.3 (D)
MOTOR_OUT1: TP1.1
MOTOR_OUT2: TP2.1
MOTOR_SLEEP_N: R39.1, U17.4 (Y)
PACK_NTC: J1.5
PACK_PROTECTED: J1.1
PACK_SCL: J1.4
PACK_SDA: J1.3
RESET_N: U12.1 (B)
SUPERVISED_PERMISSION: U17.3 (A)
SYS: C53.1, U13.1 (IN)
THERMAL_OK: U17.6 (C)
THERMAL_TRIP: Q10.1 (G)
VENC_5V: C54.1, U13.5 (OUT)

Notes on the sheet:
POWER AND MOTOR PERMISSION / INTEGRATED CONTROLLER
Encoder gate: RESET_N AND NOT ALLOW_N. Final motor gate: supervision AND thermal permission. No raw cell rails here.
All pin connections independently exported and checked. Physical fit, routing and powered qualification remain open.
