0x63616c/smart-blinds/hw/schematics/blind-regen/regen-test.kicad_sch

## KiCad design hw/schematics/blind-regen/regen-test.kicad_sch (2026-10-20)

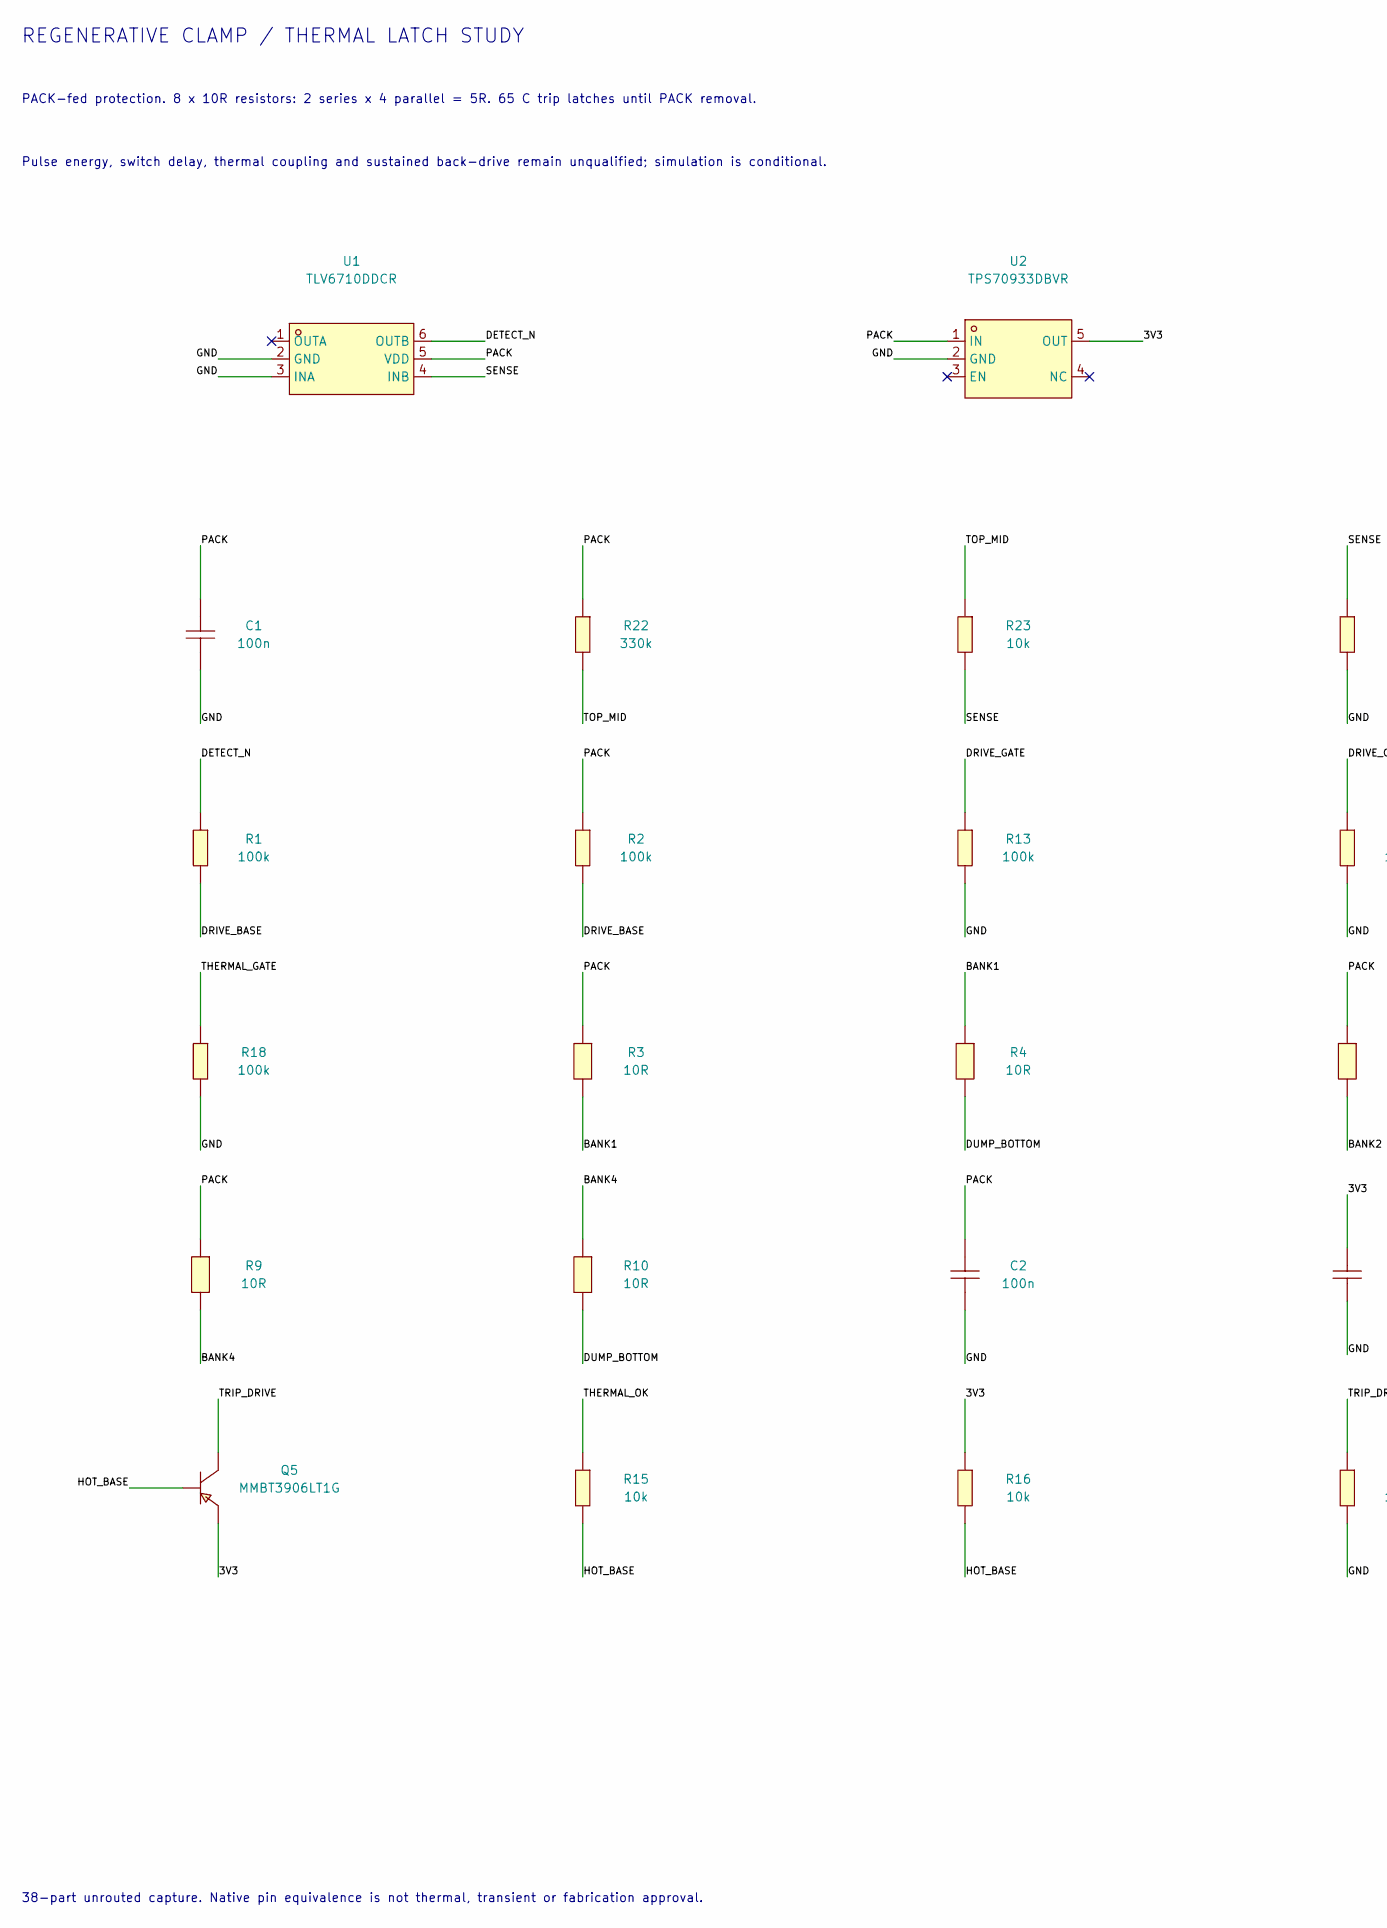
[picture p90: schematic regen-test.kicad_sch, part in row 1, column 1]

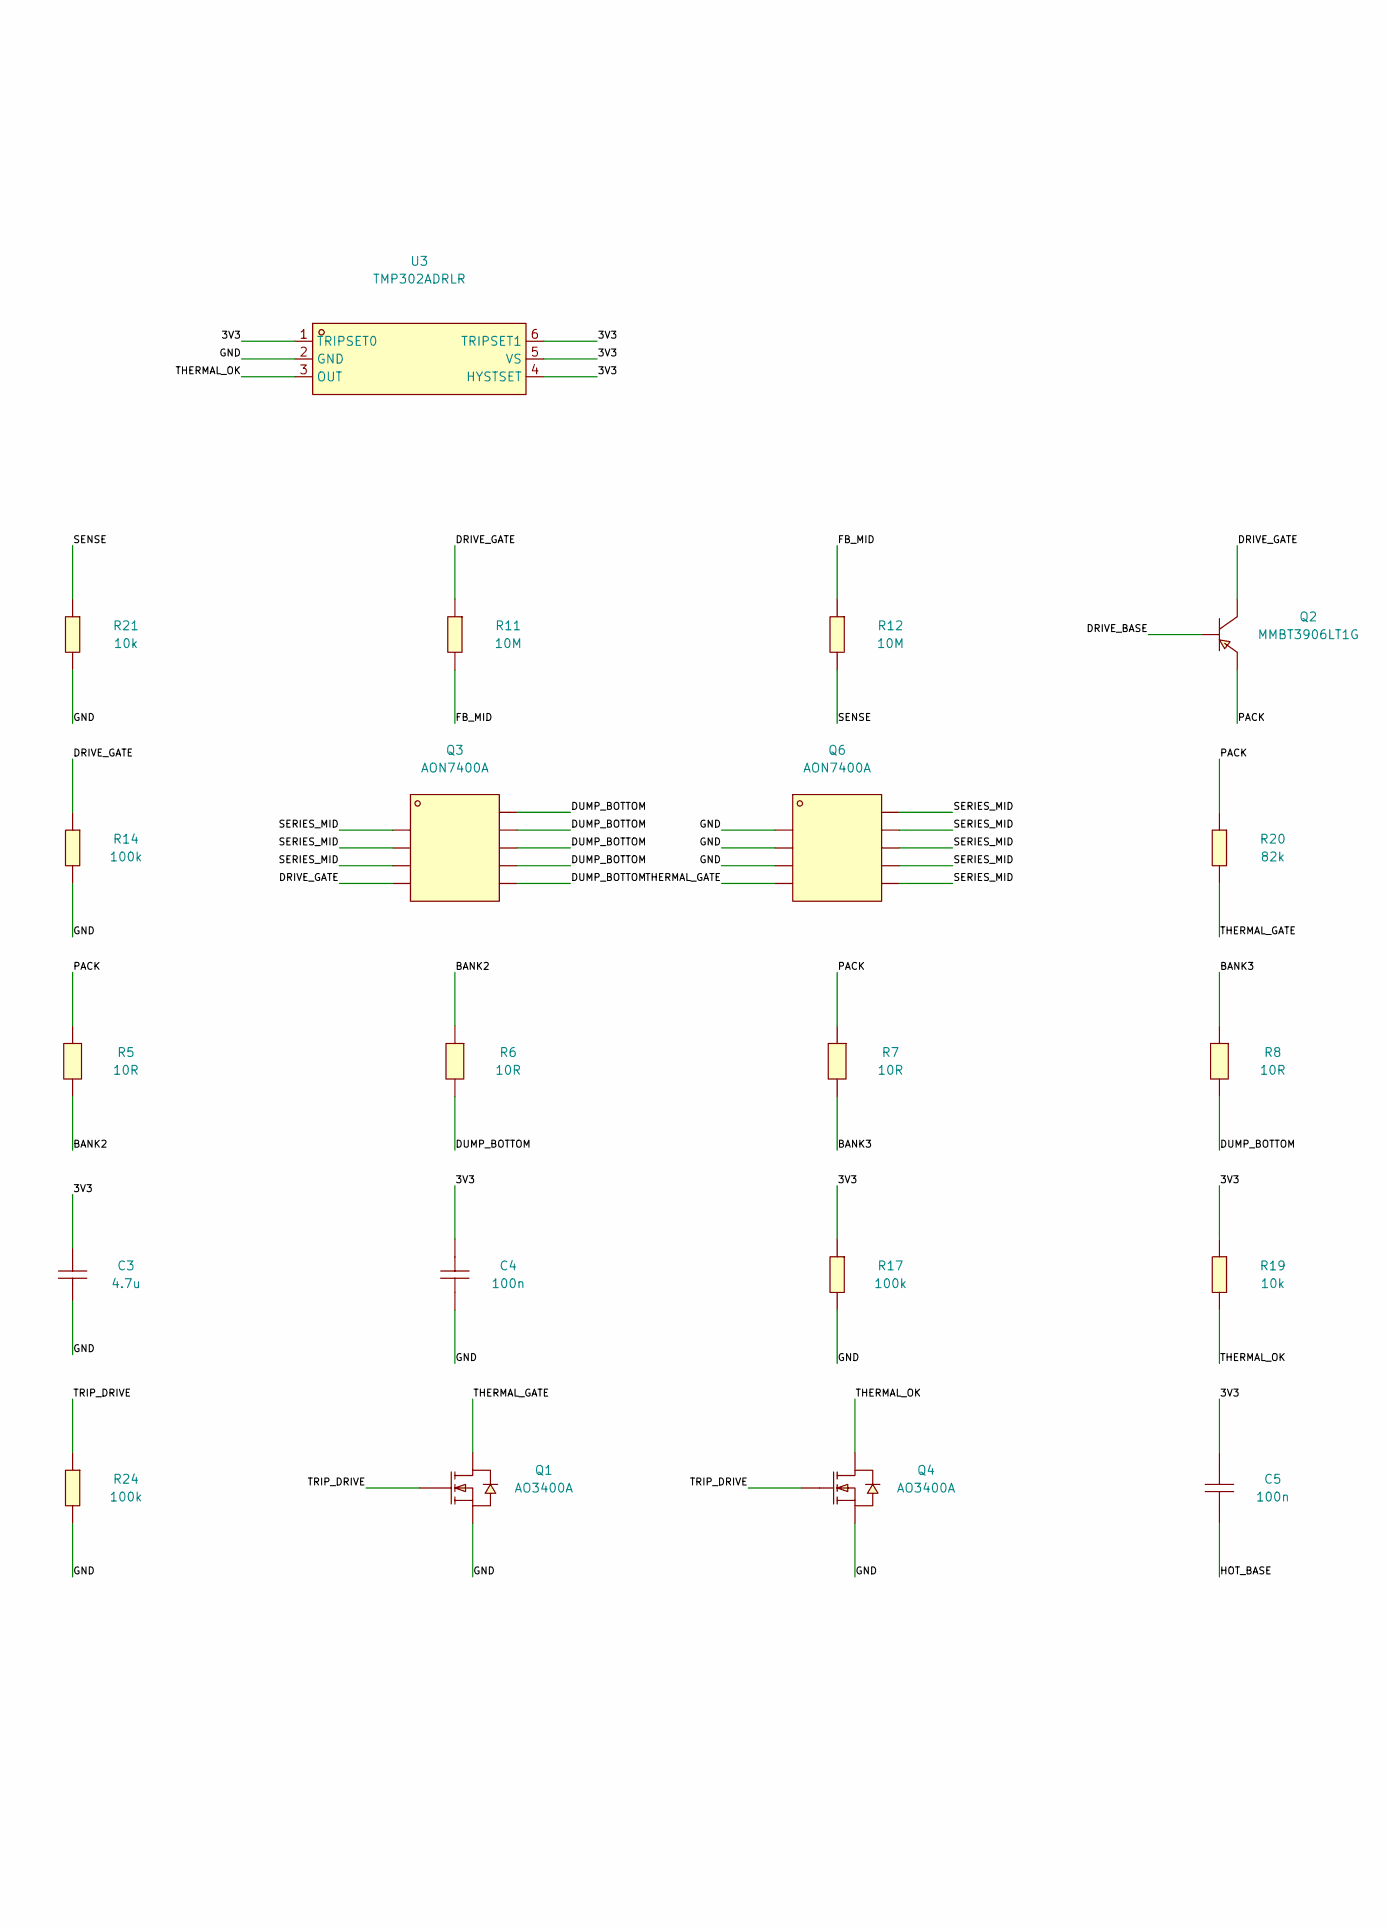
[picture p91: schematic regen-test.kicad_sch, part in row 1, column 2]

Parts:
C1, C2, C4, C5: 100n; C0402; MPN CL05B104KB54PNC; LCSC C307331
C3: 4.7u; C0805; MPN CL21A475KAQNNNE; LCSC C1779
Q1, Q4: AO3400A; SOT-23-3_L2.9-W1.3-P1.90-LS2.4-BR; MPN AO3400A; LCSC C20917
Q2, Q5: MMBT3906LT1G; SOT-23-3_L2.9-W1.3-P1.90-LS2.4-BR; MPN MMBT3906LT1G; LCSC C53444
Q3, Q6: AON7400A; PDFN-8_L3.3-W3.3-P0.65-BL; MPN AON7400A; LCSC C85734
R1, R2, R13, R14, R17, R18, R24: 100k; R0402; MPN 0402WGF1003TCE; LCSC C25741
R3, R4, R5, R6, R7, R8, R9, R10: 10R; R2512; MPN CRM2512-FX-10R0ELF; LCSC C840605
R11, R12: 10M; R0603; MPN 0603WAF1005T5E; LCSC C7250
R15, R16, R19, R21, R23: 10k; R0402; MPN 0402WGF1002TCE; LCSC C25744
R20: 82k; R0402; MPN 0402WGF8202TCE; LCSC C4142
R22: 330k; R0402; MPN 0402WGF3303TCE; LCSC C25778
U1: TLV6710DDCR; TSOT-23-6_L2.9-W1.6-P0.95-LS2.8-BR; MPN TLV6710DDCR; LCSC C2863066
U2: TPS70933DBVR; SOT-23-5_L3.0-W1.7-P0.95-LS2.8-BR; MPN TPS70933DBVR; LCSC C89347
U3: TMP302ADRLR; SOT-5X3-6_W1.6-L1.2-P0.50-LS1.6-BL; MPN TMP302ADRLR; LCSC C2877557

Connections:
3V3: C3.1, C4.1, C5.1, Q5.2 (E), R16.1, R17.1, R19.1, U2.5 (OUT), U3.1 (TRIPSET0), U3.4 (HYSTSET), U3.5 (VS), U3.6 (TRIPSET1)
BANK1: R3.2, R4.1
BANK2: R5.2, R6.1
BANK3: R7.2, R8.1
BANK4: R9.2, R10.1
DETECT_N: R1.1, U1.6 (OUTB)
DRIVE_BASE: Q2.1 (B), R1.2, R2.2
DRIVE_GATE: Q2.3 (C), Q3.4 (G), R11.1, R13.1, R14.1
DUMP_BOTTOM: Q3.5 (D), Q3.6 (D), Q3.7 (D), Q3.8 (D), Q3.9 (D), R4.2, R6.2, R8.2, R10.2
FB_MID: R11.2, R12.1
GND: C1.2, C2.2, C3.2, C4.2, Q1.2 (S), Q4.2 (S), Q6.1 (S), Q6.2 (S), Q6.3 (S), R13.2, R14.2, R17.2, R18.2, R21.2, R24.2, U1.2 (GND), U1.3 (INA), U2.2 (GND), U3.2 (GND)
HOT_BASE: C5.2, Q5.1 (B), R15.2, R16.2
PACK: C1.1, C2.1, Q2.2 (E), R2.1, R3.1, R5.1, R7.1, R9.1, R20.1, R22.1, U1.5 (VDD), U2.1 (IN)
SENSE: R12.2, R21.1, R23.2, U1.4 (INB)
SERIES_MID: Q3.1 (S), Q3.2 (S), Q3.3 (S), Q6.5 (D), Q6.6 (D), Q6.7 (D), Q6.8 (D), Q6.9 (D)
THERMAL_GATE: Q1.3 (D), Q6.4 (G), R18.1, R20.2
THERMAL_OK: Q4.3 (D), R15.1, R19.2, U3.3 (OUT)
TOP_MID: R22.2, R23.1
TRIP_DRIVE: Q1.1 (G), Q4.1 (G), Q5.3 (C), R24.1

Notes on the sheet:
REGENERATIVE CLAMP / THERMAL LATCH STUDY
PACK-fed protection. 8 x 10R resistors: 2 series x 4 parallel = 5R. 65 C trip latches until PACK removal.
Pulse energy, switch delay, thermal coupling and sustained back-drive remain unqualified; simulation is conditional.
38-part unrouted capture. Native pin equivalence is not thermal, transient or fabrication approval.
