0x63616c/smart-blinds/hw/schematics/blind-regulator/regulator-test.kicad_sch

## KiCad design hw/schematics/blind-regulator/regulator-test.kicad_sch (2026-10-20)

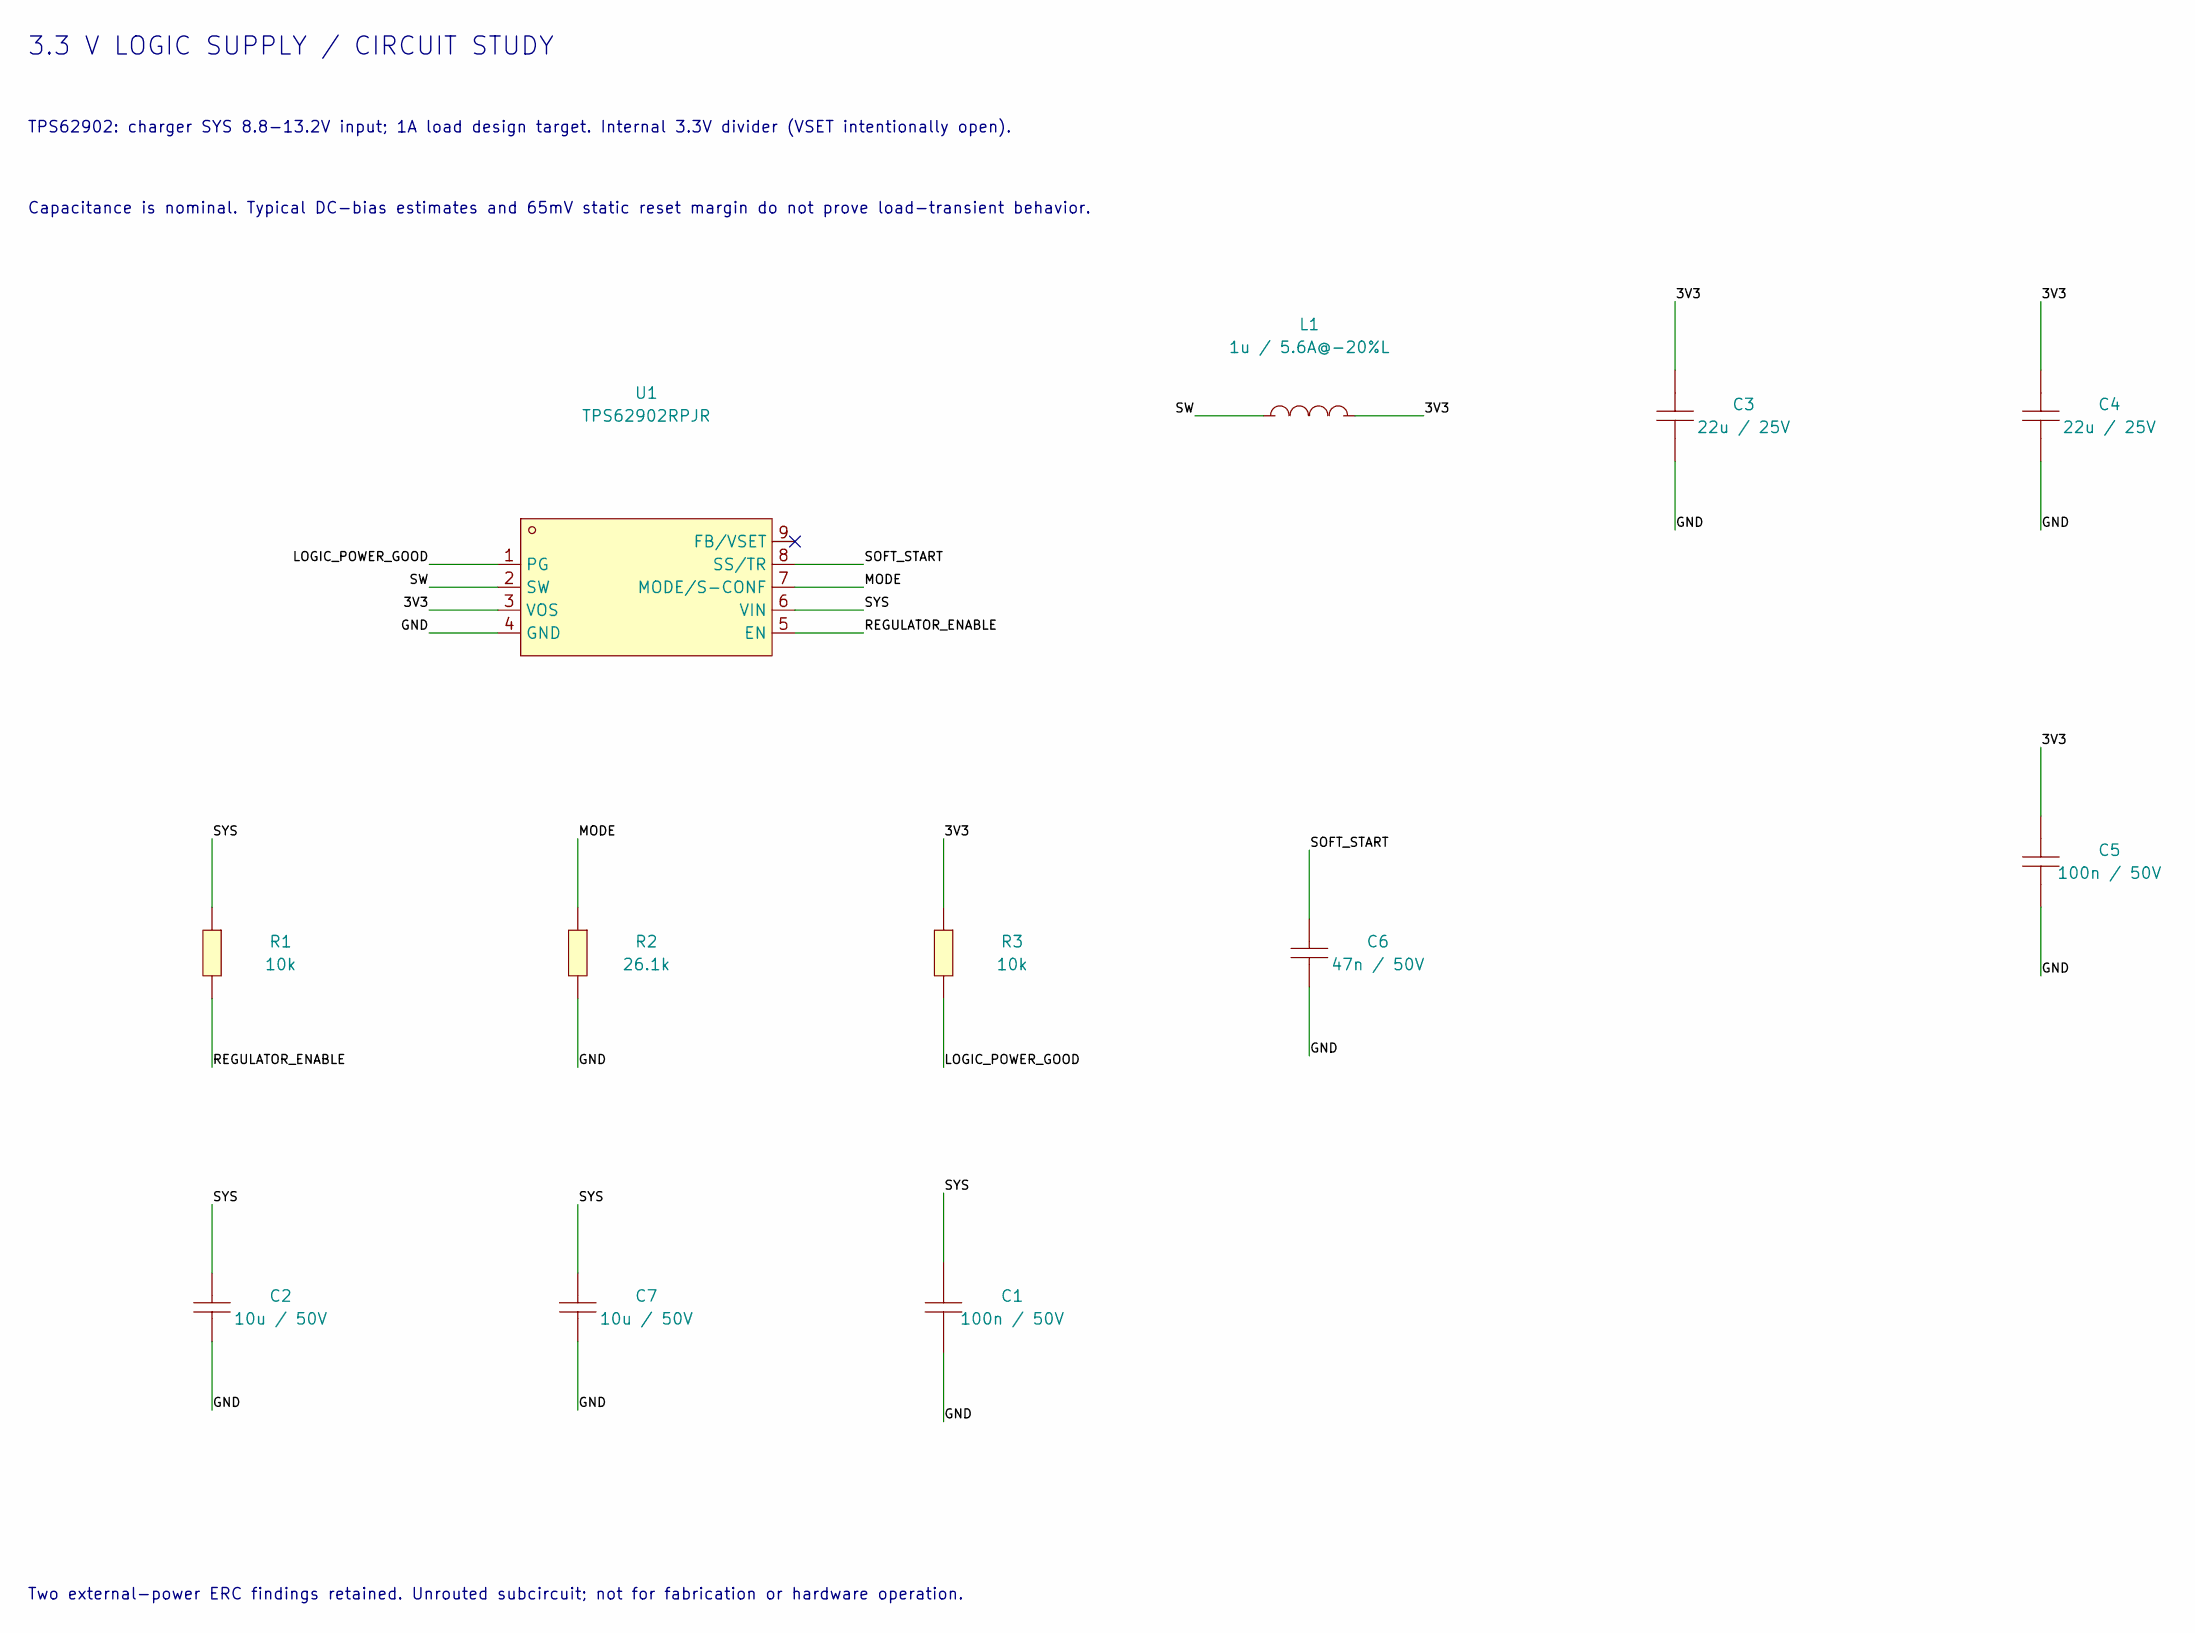
[picture p92: schematic regulator-test.kicad_sch]

Parts:
C1, C5: 100n / 50V; C0402; MPN CL05B104KB54PNC; LCSC C307331
C2, C7: 10u / 50V; C1206; MPN CL31A106KBHNNNE; LCSC C13585
C3, C4: 22u / 25V; C0805; MPN CL21A226MAYNNNE; LCSC C602037
C6: 47n / 50V; C0402; MPN 0402B473K500NT; LCSC C82219
L1: 1u / 5.6A@-20%L; IND-SMD_L4.4-W4.2; MPN MWSA0402S-1R0MT; LCSC C408332
R1, R3: 10k; R0402; MPN 0402WGF1002TCE; LCSC C25744
R2: 26.1k; R0402; MPN 0402WGF2612TCE; LCSC C25875
U1: TPS62902RPJR; VQFN-HR-9_L2.0-W1.5-P0.50-TL; MPN TPS62902RPJR; LCSC C2870154

Connections:
3V3: C3.1, C4.1, C5.1, L1.2, R3.1, U1.3 (VOS)
GND: C1.2, C2.2, C3.2, C4.2, C5.2, C6.2, C7.2, R2.2, U1.4 (GND)
LOGIC_POWER_GOOD: R3.2, U1.1 (PG)
MODE: R2.1, U1.7 (MODE/S-CONF)
REGULATOR_ENABLE: R1.2, U1.5 (EN)
SOFT_START: C6.1, U1.8 (SS/TR)
SW: L1.1, U1.2 (SW)
SYS: C1.1, C2.1, C7.1, R1.1, U1.6 (VIN)

Notes on the sheet:
3.3 V LOGIC SUPPLY / CIRCUIT STUDY
TPS62902: charger SYS 8.8-13.2V input; 1A load design target. Internal 3.3V divider (VSET intentionally open).
Capacitance is nominal. Typical DC-bias estimates and 65mV static reset margin do not prove load-transient behavior.
Two external-power ERC findings retained. Unrouted subcircuit; not for fabrication or hardware operation.
