0x63616c/smart-blinds/hw/schematics/blind-supervisor/supervisor-test.kicad_sch

## KiCad design hw/schematics/blind-supervisor/supervisor-test.kicad_sch (2026-10-20)

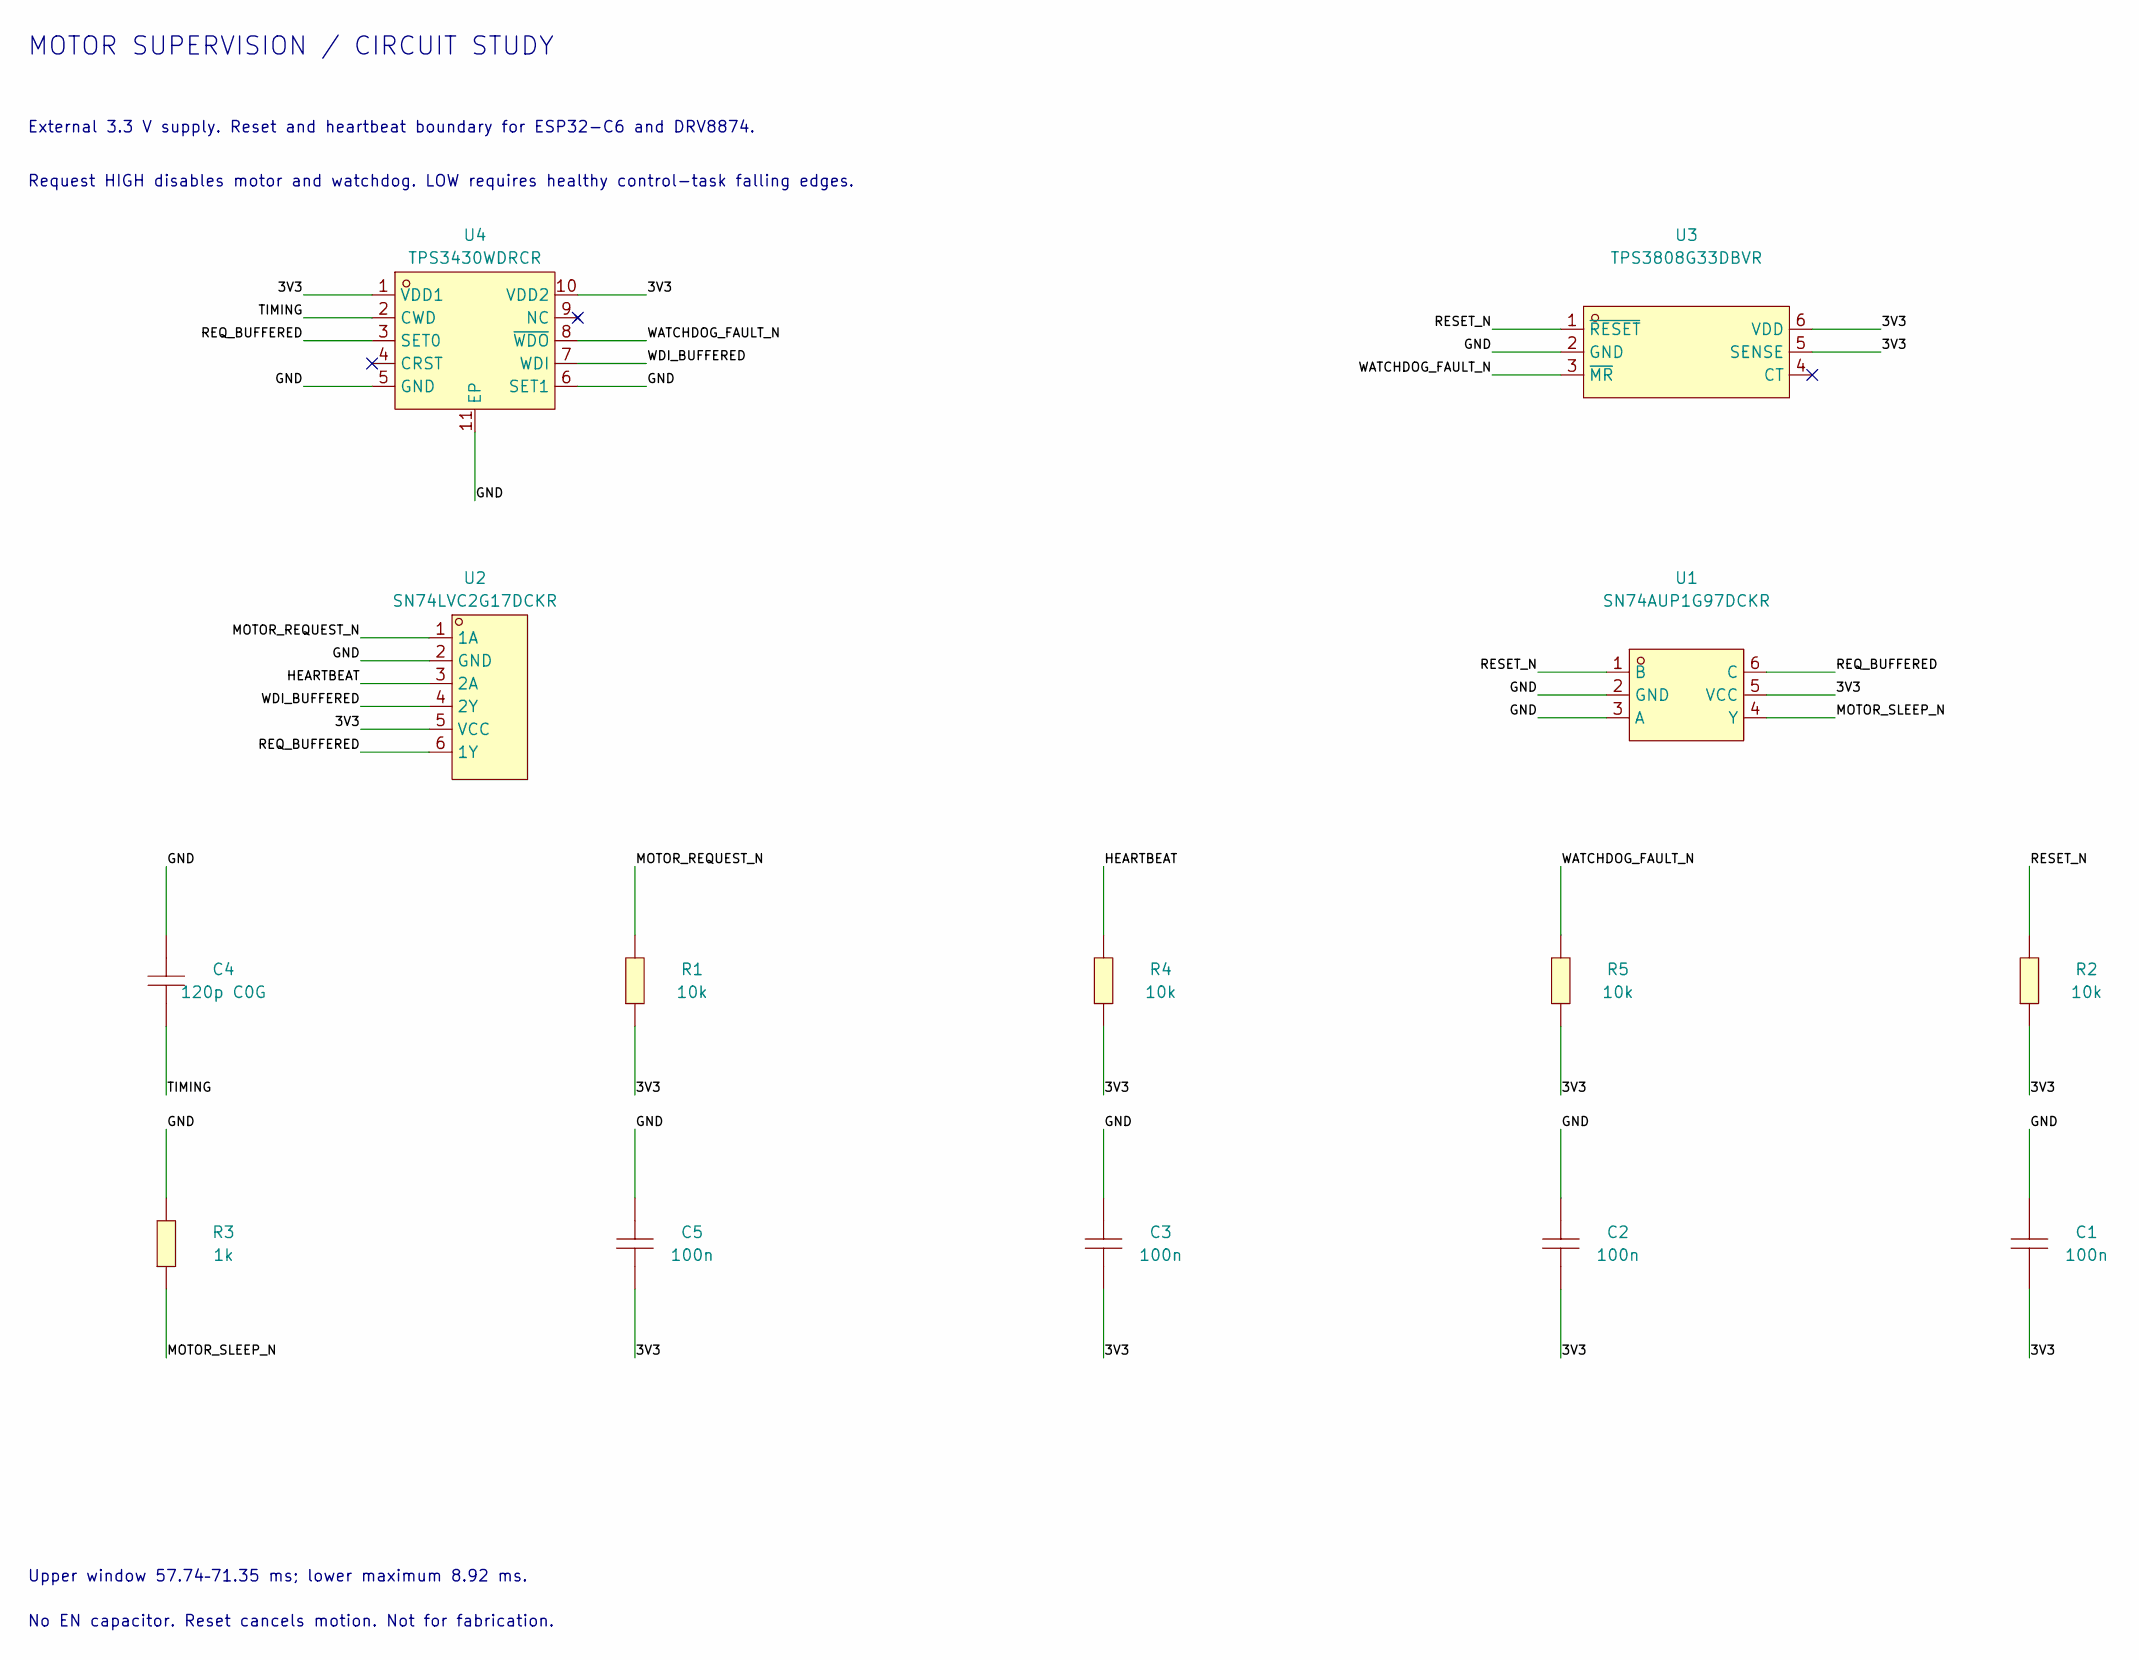
[picture p93: schematic supervisor-test.kicad_sch]

Parts:
C1, C2, C3, C5: 100n; C0402; MPN CL05B104KB54PNC; LCSC C307331
C4: 120p C0G; C0402; MPN CL05C121JB5NNNC; LCSC C307442
R1, R2, R4, R5: 10k; R0402; MPN 0402WGF1002TCE; LCSC C25744
R3: 1k; R0402; MPN 0402WGF1001TCE; LCSC C11702
U1: SN74AUP1G97DCKR; SC-70-6_L2.0-W1.3-P0.65-LS2.1-BR; MPN SN74AUP1G97DCKR; LCSC C2682139
U2: SN74LVC2G17DCKR; SOT-363_L2.0-W1.3-P0.65-LS2.1-BR; MPN SN74LVC2G17DCKR; LCSC C50714
U3: TPS3808G33DBVR; SOT-23-6_L2.9-W1.6-P0.95-LS2.8-BR; MPN TPS3808G33DBVR; LCSC C43698
U4: TPS3430WDRCR; VSON-10_L3.0-W3.0-P0.50-TL-EP; MPN TPS3430WDRCR; LCSC C2870545

Connections:
3V3: C1.1, C2.1, C3.1, C5.1, R1.1, R2.1, R4.1, R5.1, U1.5 (VCC), U2.5 (VCC), U3.5 (SENSE), U3.6 (VDD), U4.1 (VDD1), U4.10 (VDD2)
GND: C1.2, C2.2, C3.2, C4.2, C5.2, R3.2, U1.2 (GND), U1.3 (A), U2.2 (GND), U3.2 (GND), U4.5 (GND), U4.6 (SET1), U4.11 (EP)
HEARTBEAT: R4.2, U2.3 (2A)
MOTOR_REQUEST_N: R1.2, U2.1 (1A)
MOTOR_SLEEP_N: R3.1, U1.4 (Y)
REQ_BUFFERED: U1.6 (C), U2.6 (1Y), U4.3 (SET0)
RESET_N: R2.2, U1.1 (B), U3.1 (~RESET)
TIMING: C4.1, U4.2 (CWD)
WATCHDOG_FAULT_N: R5.2, U3.3 (~MR), U4.8 (~WDO)
WDI_BUFFERED: U2.4 (2Y), U4.7 (WDI)

Notes on the sheet:
MOTOR SUPERVISION / CIRCUIT STUDY
External 3.3 V supply. Reset and heartbeat boundary for ESP32-C6 and DRV8874.
Request HIGH disables motor and watchdog. LOW requires healthy control-task falling edges.
Upper window 57.74–71.35 ms; lower maximum 8.92 ms.
No EN capacitor. Reset cancels motion. Not for fabrication.
