0x63616c/smart-blinds/hw/schematics/blind-usb/usb-test.kicad_sch

## KiCad design hw/schematics/blind-usb/usb-test.kicad_sch (2026-10-21)

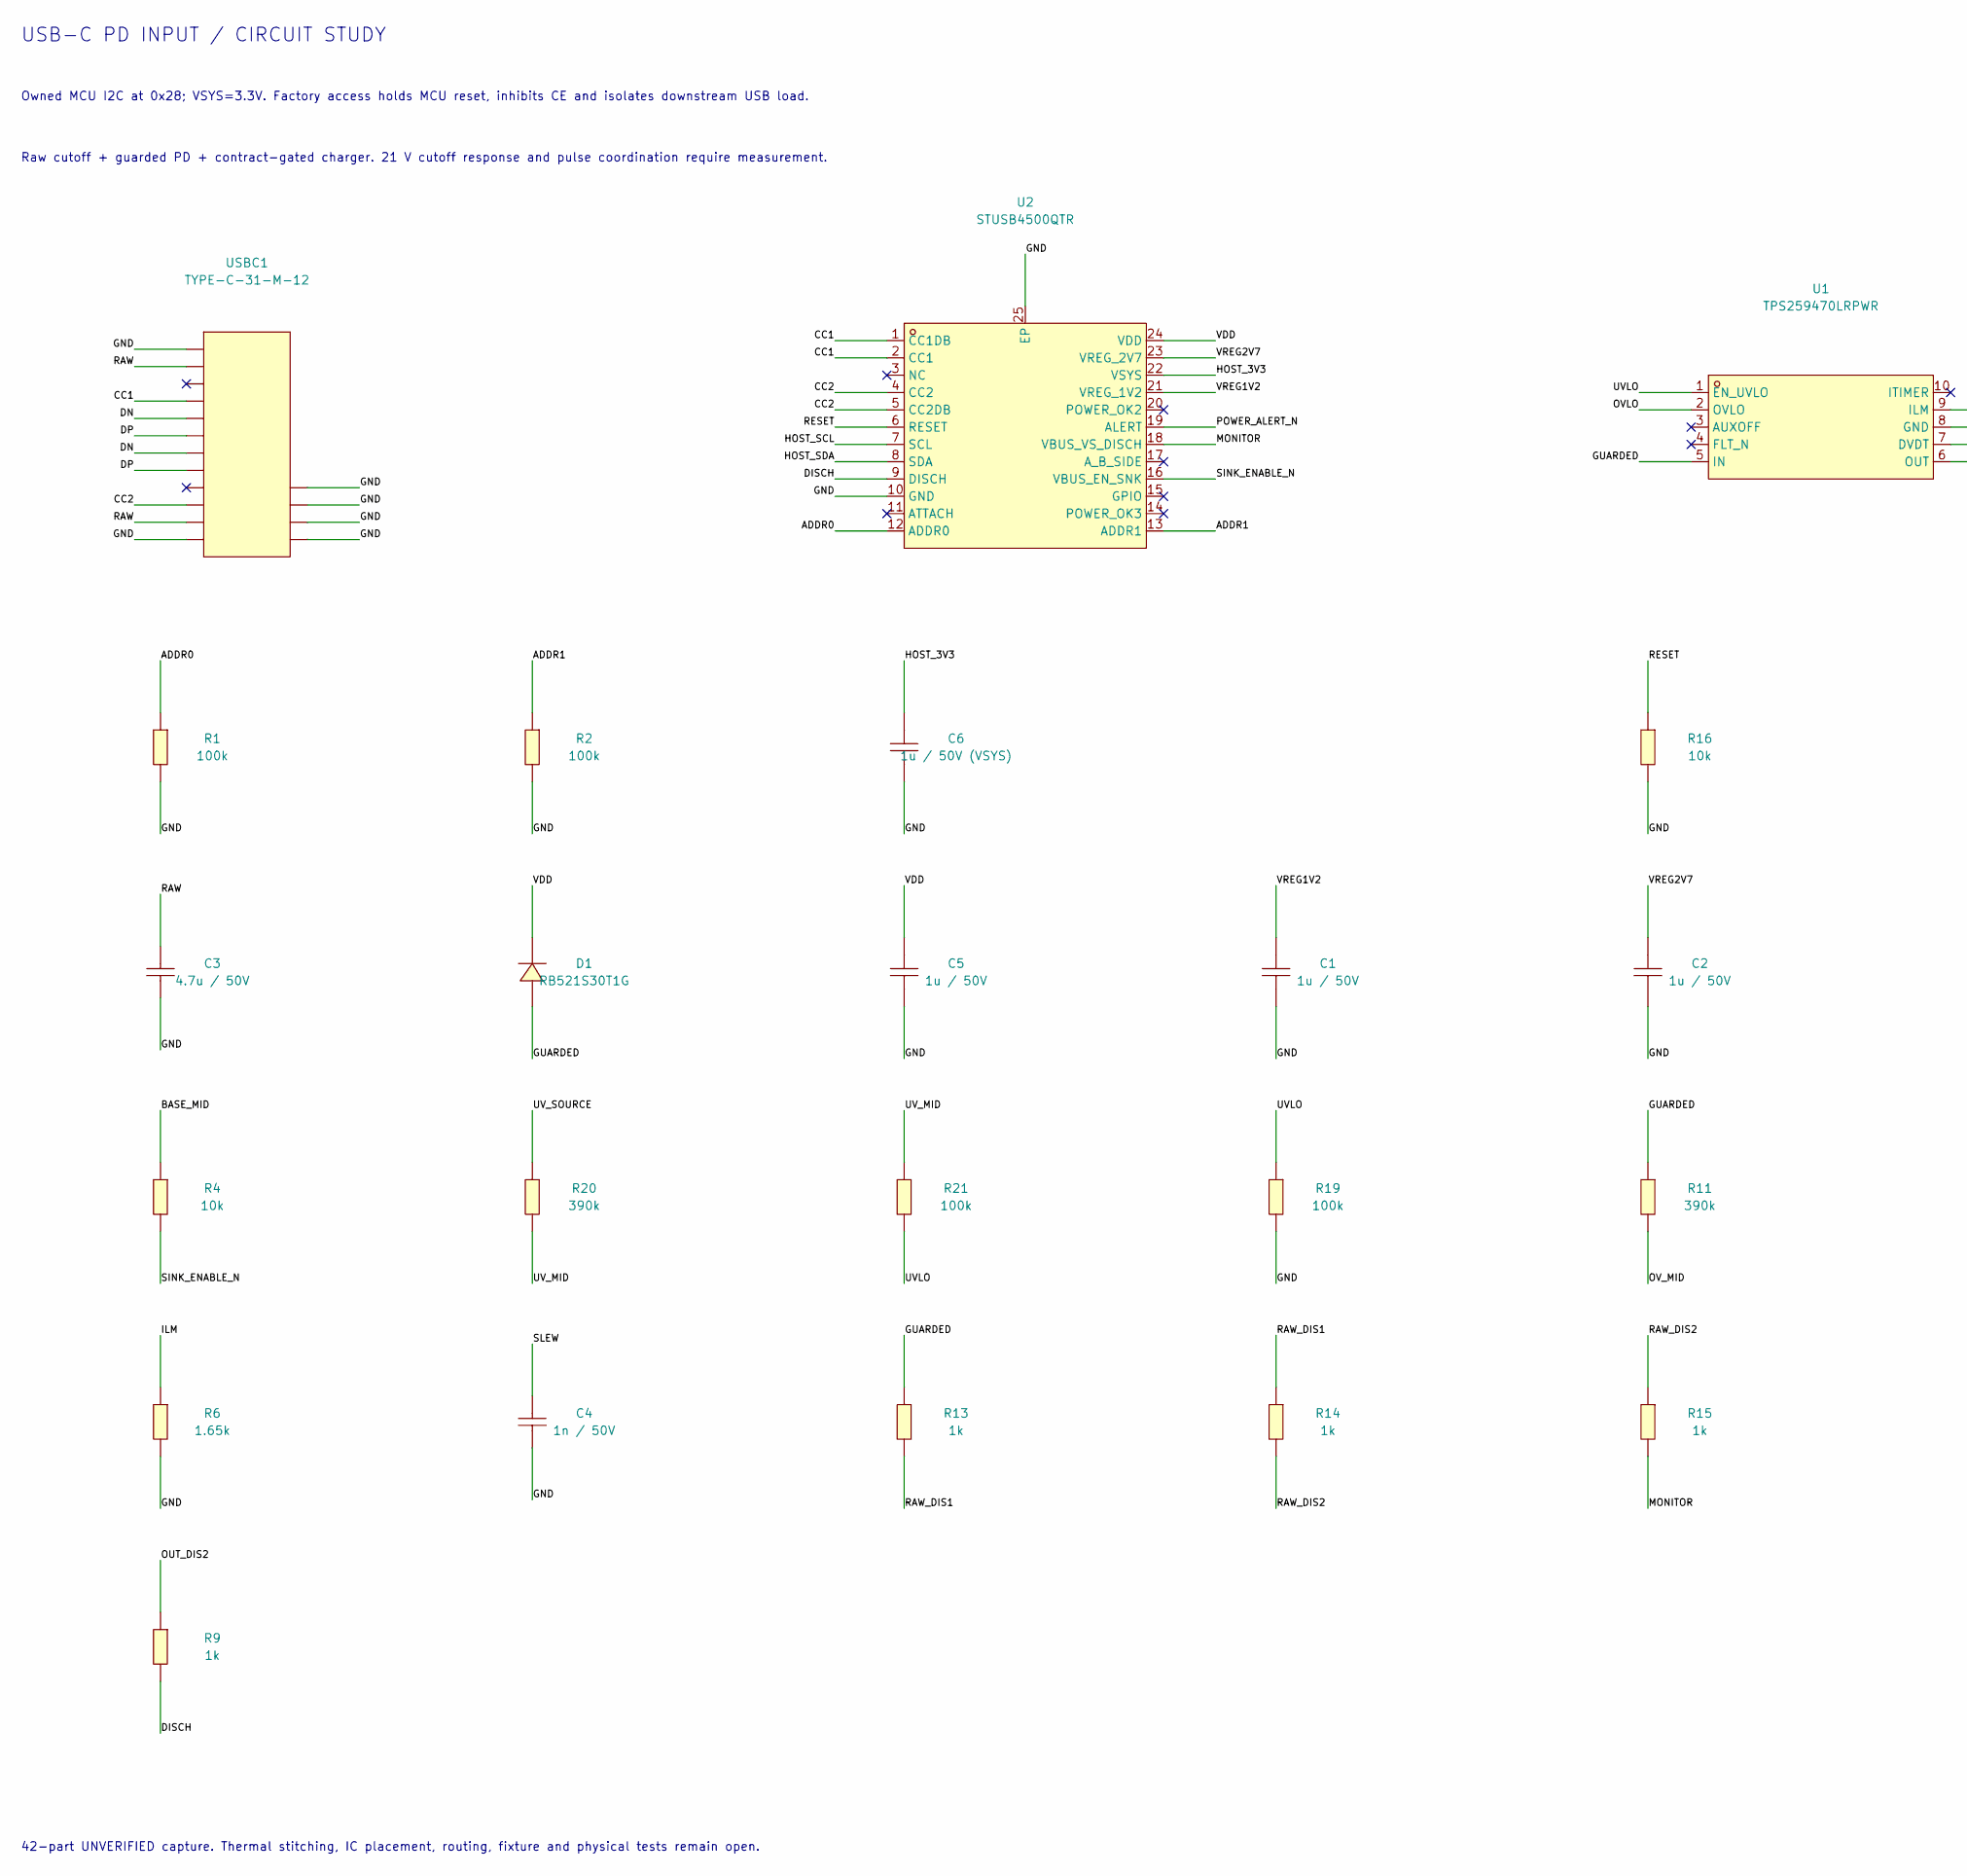
[picture p94: schematic usb-test.kicad_sch, part in row 1, column 1]

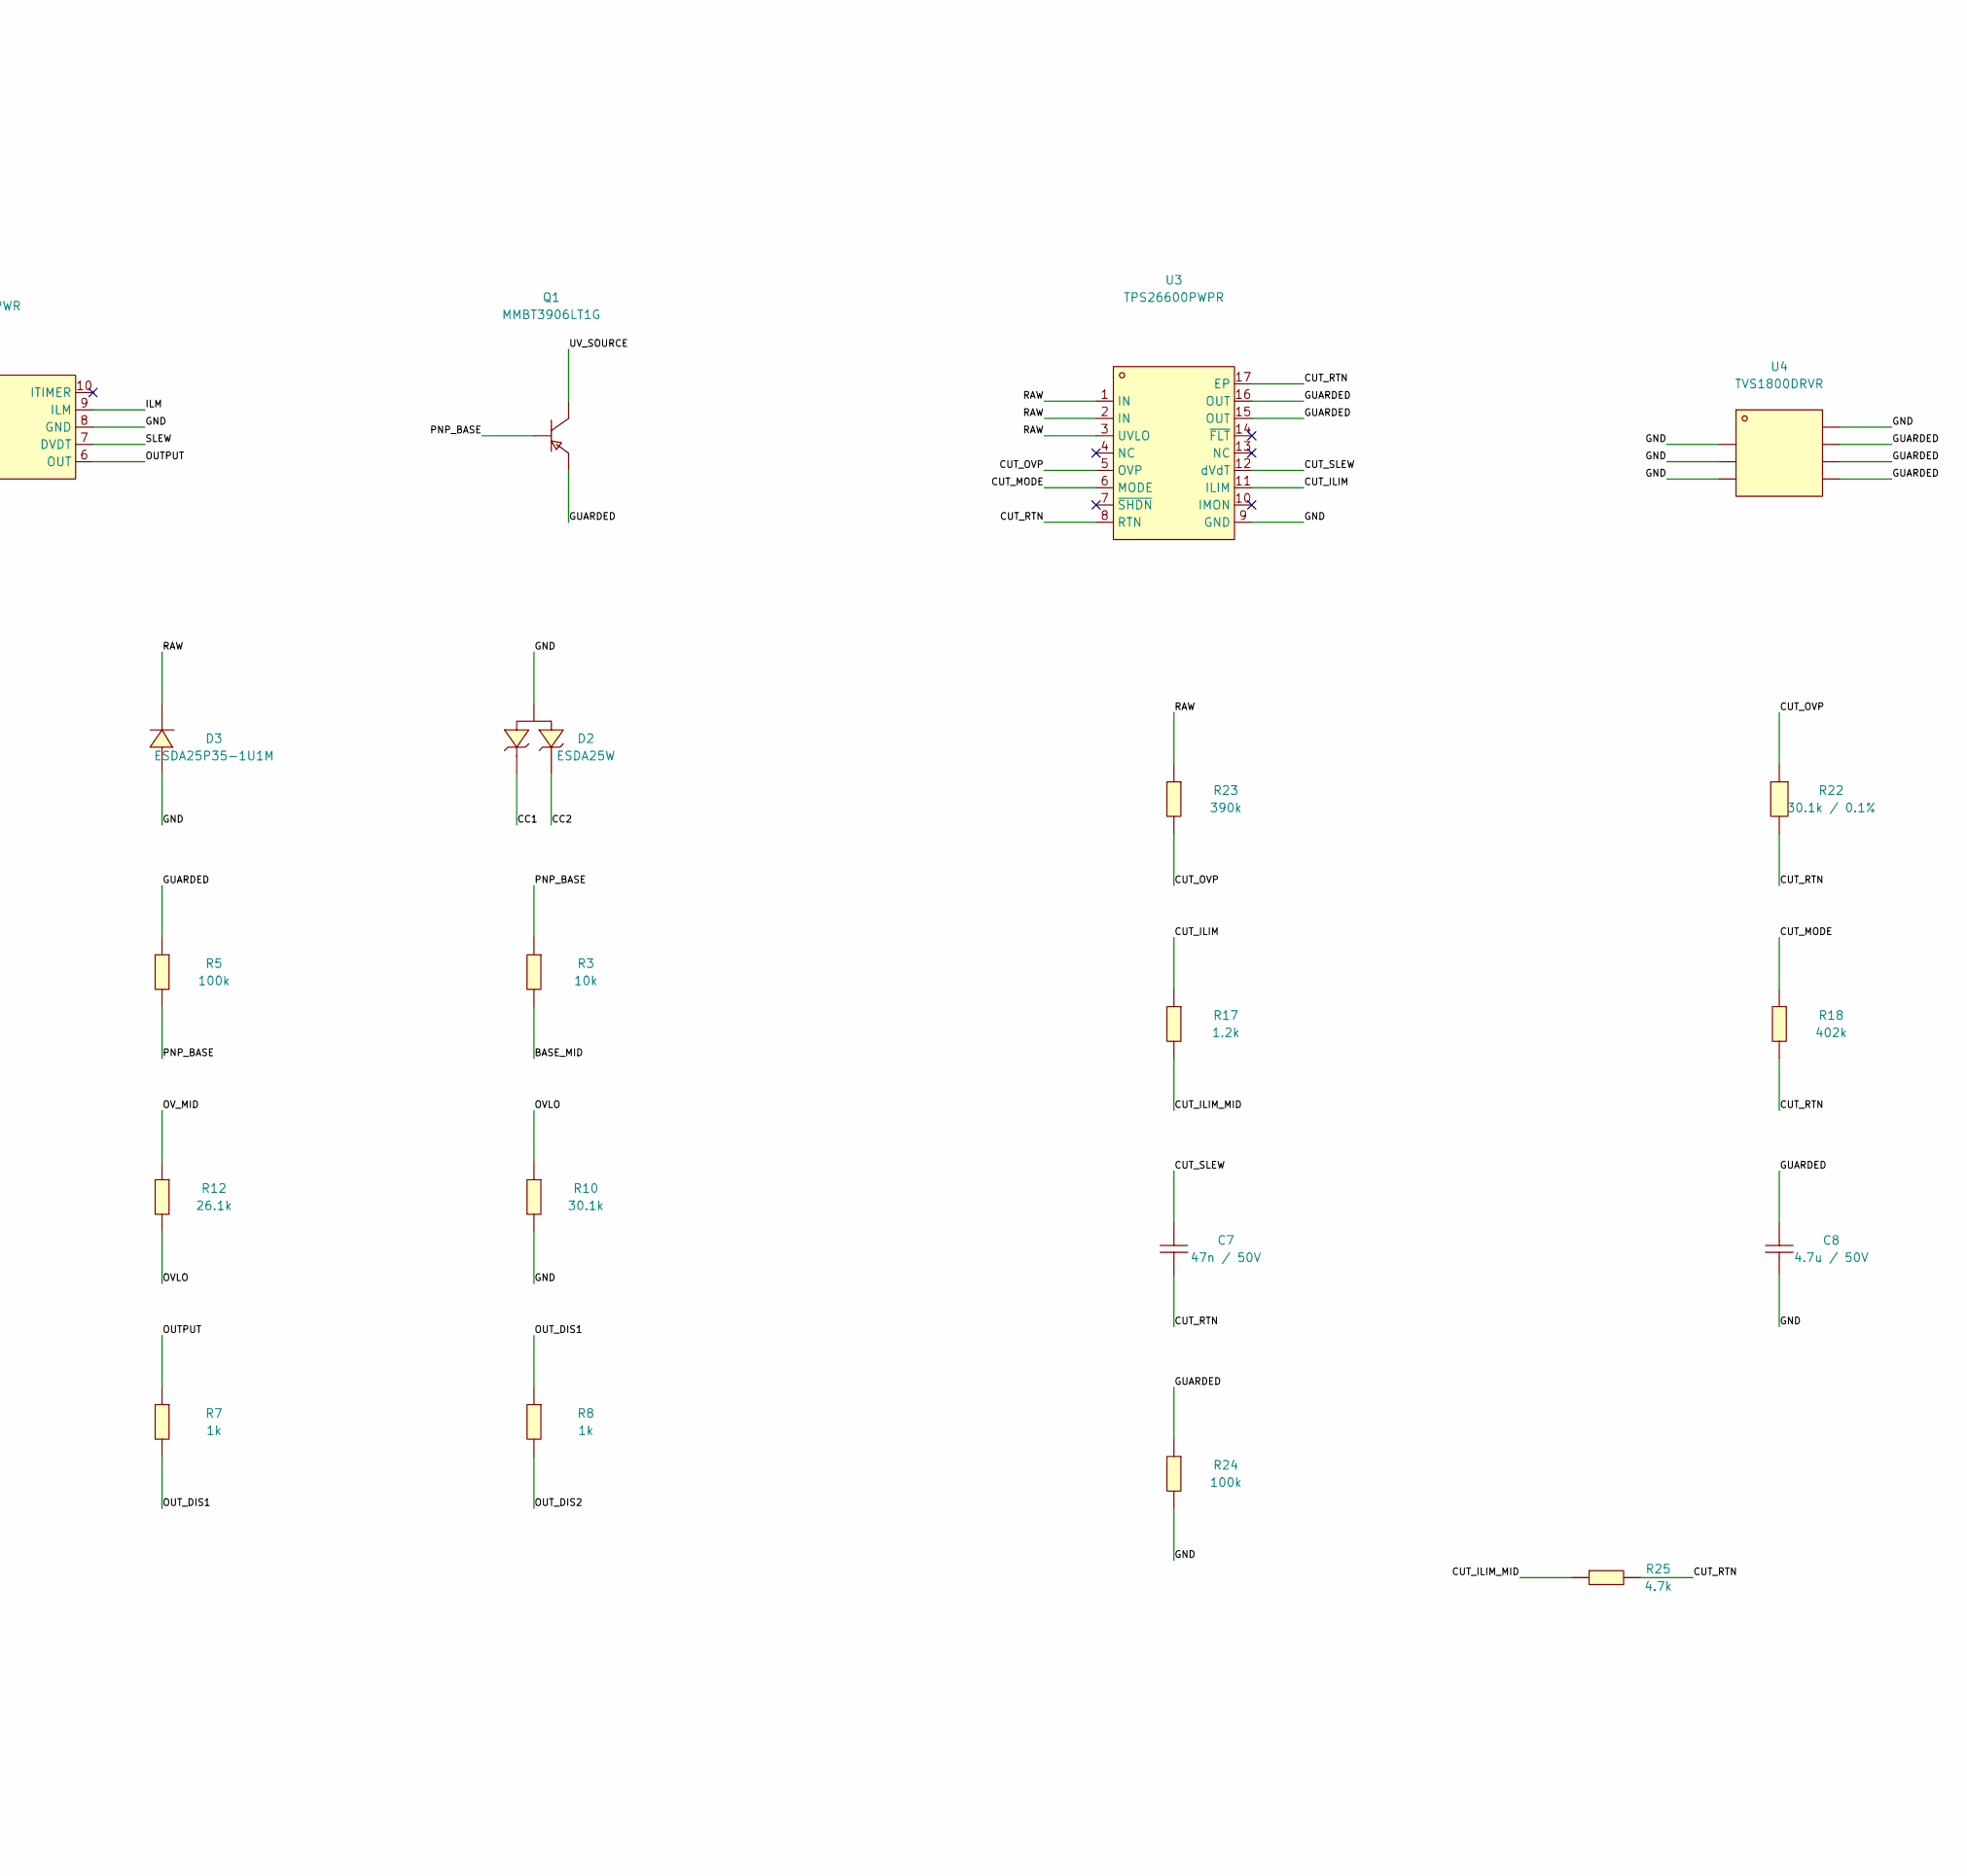
[picture p95: schematic usb-test.kicad_sch, part in row 1, column 2]

Parts:
C1, C2, C5: 1u / 50V; C0603; MPN CL10A105KB8NNNC; LCSC C15849
C3, C8: 4.7u / 50V; C1206; MPN CL31A475KBHNNNE; LCSC C12881
C4: 1n / 50V; C0402; MPN 0402B102K500NT; LCSC C1523
C6: 1u / 50V (VSYS); C0603; MPN CL10A105KB8NNNC; LCSC C15849
C7: 47n / 50V; C0402; MPN 0402B473K500NT; LCSC C82219
D1: RB521S30T1G; SOD-523_L1.2-W0.8-LS1.6-RD; MPN RB521S30T1G; LCSC C145179
D2: ESDA25W; SOT-323-3_L2.1-W1.3-P1.32-LS2.1-BR; MPN ESDA25W; LCSC C2935152
D3: ESDA25P35-1U1M; DFN1610-2_L1.6-W1.0-P1.05-RD; MPN ESDA25P35-1U1M; LCSC C1974707
Q1: MMBT3906LT1G; SOT-23-3_L2.9-W1.3-P1.90-LS2.4-BR; MPN MMBT3906LT1G; LCSC C53444
R1, R2, R5, R19, R21, R24: 100k; R0402; MPN 0402WGF1003TCE; LCSC C25741
R3, R4, R16: 10k; R0402; MPN 0402WGF1002TCE; LCSC C25744
R6: 1.65k; R0402; MPN 0402WGF1651TCE; LCSC C25869
R7, R8, R9, R13, R14, R15: 1k; R0603; MPN 0603WAF1001T5E; LCSC C21190
R10: 30.1k; R0402; MPN 0402WGF3012TCE; LCSC C29402
R11, R20, R23: 390k; R0402; MPN 0402WGF3903TCE; LCSC C25782
R12: 26.1k; R0402; MPN 0402WGF2612TCE; LCSC C25875
R17: 1.2k; R0402; MPN 0402WGF1201TCE; LCSC C25862
R18: 402k; R0402; MPN 0402WGF4023TCE; LCSC C25785
R22: 30.1k / 0.1%; R0402; MPN RT0402BRD0730K1L; LCSC C852714
R25: 4.7k; R0402; MPN 0402WGF4701TCE; LCSC C25900
U1: TPS259470LRPWR; VQFN-10_L2.0-W2.0-P0.45-TL; MPN TPS259470LRPWR; LCSC C3662793
U2: STUSB4500QTR; QFN-24_L4.0-W4.0-P0.50-BL-EP2.8; MPN STUSB4500QTR; LCSC C2678061
U3: TPS26600PWPR; TPS26600_PWP16; MPN TPS26600PWPR; LCSC C544399
U4: TVS1800DRVR; TVS1800_DRV6; MPN TVS1800DRVR; LCSC C2649846
USBC1: TYPE-C-31-M-12; HRO_TYPE_C_31_M_12; MPN TYPE-C-31-M-12; LCSC C165948

Connections:
ADDR0: R1.1, U2.12 (ADDR0)
ADDR1: R2.1, U2.13 (ADDR1)
BASE_MID: R3.2, R4.1
CC1: D2.1 (K1), U2.1 (CC1DB), U2.2 (CC1), USBC1.A5 (CC1)
CC2: D2.2 (K2), U2.4 (CC2), U2.5 (CC2DB), USBC1.B5 (CC2)
CUT_ILIM: R17.1, U3.11 (ILIM)
CUT_ILIM_MID: R17.2, R25.1
CUT_MODE: R18.1, U3.6 (MODE)
CUT_OVP: R22.1, R23.2, U3.5 (OVP)
CUT_RTN: C7.2, R18.2, R22.2, R25.2, U3.8 (RTN), U3.17 (EP)
CUT_SLEW: C7.1, U3.12 (dVdT)
DISCH: R9.2, U2.9 (DISCH)
DN: USBC1.A7 (DN1), USBC1.B7 (DN2)
DP: USBC1.A6 (DP1), USBC1.B6 (DP2)
GND: C1.2, C2.2, C3.2, C4.2, C5.2, C6.2, C8.2, D2.3 (A), D3.2 (A), R1.2, R2.2, R6.2, R10.2, R16.2, R19.2, R24.2, U1.8 (GND), U2.10 (GND), U2.25 (EP), U3.9 (GND), U4.1 (GND), U4.2 (GND), U4.3 (GND), U4.7 (GND), USBC1.1 (EH), USBC1.2 (EH), USBC1.3 (EH), USBC1.4 (EH), USBC1.A1B12 (GND), USBC1.B1A12 (GND)
GUARDED: C8.1, D1.2 (A), Q1.2 (E), R5.1, R11.1, R13.1, R24.1, U1.5 (IN), U3.15 (OUT), U3.16 (OUT), U4.4 (IN), U4.5 (IN), U4.6 (IN)
HOST_3V3: C6.1, U2.22 (VSYS)
HOST_SCL: U2.7 (SCL)
HOST_SDA: U2.8 (SDA)
ILM: R6.1, U1.9 (ILM)
MONITOR: R15.2, U2.18 (VBUS_VS_DISCH)
OUTPUT: R7.1, U1.6 (OUT)
OUT_DIS1: R7.2, R8.1
OUT_DIS2: R8.2, R9.1
OVLO: R10.1, R12.2, U1.2 (OVLO)
OV_MID: R11.2, R12.1
PNP_BASE: Q1.1 (B), R3.1, R5.2
POWER_ALERT_N: U2.19 (ALERT)
RAW: C3.1, D3.1 (K), R23.1, U3.1 (IN), U3.2 (IN), U3.3 (UVLO), USBC1.A4B9 (VBUS), USBC1.B4A9 (VBUS)
RAW_DIS1: R13.2, R14.1
RAW_DIS2: R14.2, R15.1
RESET: R16.1, U2.6 (RESET)
SINK_ENABLE_N: R4.2, U2.16 (VBUS_EN_SNK)
SLEW: C4.1, U1.7 (DVDT)
UVLO: R19.1, R21.2, U1.1 (EN_UVLO)
UV_MID: R20.2, R21.1
UV_SOURCE: Q1.3 (C), R20.1
VDD: C5.1, D1.1 (C), U2.24 (VDD)
VREG1V2: C1.1, U2.21 (VREG_1V2)
VREG2V7: C2.1, U2.23 (VREG_2V7)

Notes on the sheet:
USB-C PD INPUT / CIRCUIT STUDY
Owned MCU I2C at 0x28; VSYS=3.3V. Factory access holds MCU reset, inhibits CE and isolates downstream USB load.
Raw cutoff + guarded PD + contract-gated charger. 21 V cutoff response and pulse coordination require measurement.
42-part UNVERIFIED capture. Thermal stitching, IC placement, routing, fixture and physical tests remain open.
