0x63616c/smart-blinds/(commit log)

2026-10-09 Add pd12v6 board: USB-C PD to 12.6 V supply, scripted layout, review pipeline
2026-10-09 pd12v6 rev A: 4-layer grid layout, Micro-Fit output, routed + hand-route copies
    - Drop the LM358 current-limit block; single Molex Micro-Fit 3.0 2x2 output
    (1 +12.6 V, 2 GND, 3 D+, 4 D-), Sunlord MWSA0603S 10 uH inductor.
    - 4-layer Sig/GND/PWR/Sig, 40 x 32 mm, inset silk frame, labelled pins.
    - layout_pd12v6.py places on a grid; routes_pd12v6.py routes; DRC clean.
    - --place-only writes layouts/pd12v6_manual/ (same placement, no tracks).
    - review.sh renders both boards plus inner layers; docs updated.
2026-10-12 pd12v6: correct USB-C 3D model position, U2 pin-1 dot, 5 A label
    - EasyEDA's TYPE-C-31-M-12 model sits 2.31 mm behind its own footprint
    (pins behind the pads, mouth inside the edge). KiCad's footprint for the
    same part confirms our copper; KiCad has no 3D model for it, so offset
    the EasyEDA model instead. Mouth now overhangs the edge by 0.9 mm.
    - U2 pin-1 dot was by pin 5; moved to pin 1 (bottom-right).
    - Title silk said 4.5 A (old current-limited design); now 5 A.
2026-10-12 Add pd12v6mini: 33x20 mm version of pd12v6 (TPS56637, 0402, ENIG, minimal silk)
    - New board boards/pd12v6mini.ato: TPS56637 synchronous buck (no catch diode
    or compensation), 5.6 uH 5.5x5.3 inductor, SMAJ22A, 1206 input caps,
    0402 passives/LEDs. CH224A kept (CH224Q out of stock).
    - Scripted layout (layout_/routes_pd12v6mini.py) on shared scripts/pcbkit.py;
    4-layer, all vias 0.5/0.3 tented, refs on F.Fab only, DRC clean.
    - pcbkit keeps removed SWIG objects alive (fixes intermittent stale wrappers).
    - review.sh handles every board into build/review/<board>/, adds assembly
    drawing; pd12v6 layout and outputs unchanged.
    - docs/pd12v6/mini.md: changes, design values, look rules, cost compa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
2026-10-12 pd12v6mini rev B: grouped hand layout, every part labelled, consistent routing
    - 35x24.5 mm: INPUT left, BUCK along the top with a 2 mm-pitch control row,
    PD controller centred with mirrored PD/ON status columns, output caps
    mirrored about the Micro-Fit. White inset outline restored, holes inset.
    - Routing redone: one width per job (0.2 sig / 0.3 tap / 0.6 power), straight
    pad exits, uniform 45-degree chamfers, top layer pad-to-pad only (USB data
    on B.Cu, CC2 on In2, power via In2 pours). DRC clean, 0 unconnected.
2026-10-14 Store zone fills the factory will actually get; check DRC on the stored fill
    pcbnew.ZONE_FILLER run from a script ignored the clearance rules, and KiCad 10 grows the
    fills of files labelled KiCad 9 by half their minimum width, so stored fills sat 0.1 mm fat
    with near-zero gaps while DRC with --refill-zones passed.
    - pcbkit.save_filled: fill with kicad-cli, store fills shrunk by minw/2 (unfractured first so
    no seam hair reaches a hole), pad hole clearance 10 um during the fill
    - review.sh: DRC on the file as saved, plus the routing-style check (check_layout.py)
    - pd12v6 relaid with the new fill
2026-10-14 pd12v6mini rev E: 6.8 uH 12.5 A inductor, third input cap, 47.5 x 25 mm
    TI WEBENCH (real TPS56637 model) flagged the 5.6 uH / 8.6 A Isat inductor (overload peak
    ~10 A) and ~8 uF effective input capacitance. Rev E uses PROD PSTMAA666460-6R8MB (C55172548)
    and adds C9 (10 uF 1206, Basic). Re-sim: settling 0.14 ms, 1.6 W lost at 20 V / 5 A.
    - revs B, C, D kept in hw/layouts/pd12v6mini_revX
    - CC2 rerouted clear of the back text; VOUT strip clear of the CN1 label
    - ngspice buck and UVLO decks in hw/sim
    - scripts/fab_export.sh: JLCPCB gerber zip, BOM and CPL from the stored fill
    - docs/pd12v6/mini.md: WEBENCH results, JLCPCB quote so far, DIY parts cost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
2026-10-14 pd12v6mini: JLCPCB assembled quote (in cart, $188.89 for 8) and DIY comparison
2026-10-19 Add original enclosure studies, motion core and electrical cost models
2026-10-19 Record motor evidence and add reproducible C6 build checks
2026-10-19 Bound motion message age and add read-only battery diagnostics
2026-10-19 Compare PCB holder carriers and independently supported drives
2026-10-20 Add native motor schematic checks and Home Assistant simulator integration
2026-10-20 Integrate motor supervision and add charger and Thread evaluation captures
2026-10-20 Add bounded motor-disabled Thread transport evaluation
2026-10-20 Capture charger and logic supply with physical-pin and capacitor checks
2026-10-20 Add compact holder enclosure and reviewed fit-part exports
2026-10-20 Capture protected carrier circuit and native schematic checks
2026-10-20 Capture USB-C input and disabled charger configuration
2026-10-20 Fix charger GCC and ESP-IDF build portability
2026-10-20 Compose main controller and switched encoder supply
2026-10-20 Integrate regenerative clamp, thermal inhibit and priced component capture
2026-10-20 Implement bounded motion executor and disabled C6 board I/O
2026-10-20 Correct USB connector lands and document PD factory policy evidence
2026-10-20 Assess fresh pack and charge-off evidence before motion
2026-10-20 Place compact controller and capture split battery carriers
2026-10-20 Refresh connector evidence after circuit graph metadata change
2026-10-20 Publish complete controller schematic and retained carrier placements
2026-10-20 Wire authenticated motion runtime to bounded C6 control and power workers
2026-10-20 Exclude generated KiCad preferences from preview source snapshots
2026-10-20 Coordinate retained enclosure and PCB clearance repair checkpoint
2026-10-20 docs: show retained enclosure and track checked print volume
2026-10-20 Fix inherited package clearances and repack all three boards
2026-10-20 Clear primary solder tails and route pack current paths
2026-10-20 Add motor-disabled Wi-Fi sleep and DTLS evaluation
2026-10-20 Add reproducible partial main power routing and copper checks
2026-10-20 Add bounded battery observation continuity model
2026-10-20 Add owned read-only C6 battery observation adapter
2026-10-20 Route local USB power and CC paths with isolated return checks
2026-10-20 Connect USB enable, divider and discharge control chains
2026-10-20 Connect charger input and bulk capacitor distribution
2026-10-20 Model paired battery loading and reusable assembly supports
2026-10-20 Publish current design previews across unrelated commits
2026-10-20 Route charger sensing and control networks with physical checks
2026-10-20 Keep all main-board routing vias clear of solder lands
2026-10-20 Connect primary battery routing and correct communication protection
2026-10-20 Publish coherent charger and gauge snapshots with fault retirement
2026-10-20 Refresh parts inventory binding after carrier circuit correction
2026-10-20 Record verified battery and mailbox checks after parts refresh
2026-10-20 Clean carrier silkscreen with matching project footprint libraries
2026-10-20 Integrate battery monitoring across idle and honor startup input limit
2026-10-20 Route regenerative clamp with reproducible physical topology checks
2026-10-20 Route protected USB data and render the specified black board finish
2026-10-20 Reconcile parked charger cable events with bound OFF ownership
2026-10-20 Route local supervision and encoder returns on the protected USB board
2026-10-20 Account for controller wake costs in the battery planning model
2026-10-20 Wire monitored USB power into the circuit and owned sensor runtime
2026-10-20 Update native USB graph expectation for the monitored circuit
2026-10-20 Expose source-stamped battery diagnostics through Home Assistant
2026-10-20 Flag provisional enclosure previews and record component datum findings
2026-10-20 Coordinate sensor OFF transactions across motion idle handoff
2026-10-20 Require gridded layout, outward edge ports and clean PCB outline
2026-10-20 Preserve newer sensor requests across OFF grant waits
2026-10-21 Isolate local KiCad automation and record layout rework requirements
2026-10-21 Record the first failing host motor I/O operation
2026-10-21 Show the cleaner 54 by 80 mm placement study
2026-10-21 Simplify the board markings and record passing motion checks
2026-10-21 Show revised USB routing and button placement
2026-10-21 Show regulator routing and corrected supervisor package
2026-10-21 Make the cleaner controller reproducible from circuit source (#3)
    * Rebuild cleaner controller from circuit source and verify native previews
    * Use compiler-compatible Python without changing native render runtime
